embeddedci-com/benchpod-firmware/ice40/README.md

# bench-pod iCE40 gateware (v2)

See [`PROTOCOL.md`](PROTOCOL.md) for the SPI command set.

Lattice iCE40UltraPlus (**iCE40UP5K-SG48**) gateware for the EmbeddedCI BenchPod
"vbench-pod" board. It is an **SPI slave to the STM32H563** and owns the
timing-critical analog + digital datapath: the 16-bit serial DAC (DAC8551, or the quad DAC8554 on
analog v3r2), the
16-bit serial ADC (MCP33131D-10), the 14-channel logic-analyzer bank, and the
shared APS6404L **PSRAM** that captures stream into and deep DAC replay streams out of.

The STM32 sends high-level commands over SPI ("load this waveform", "capture N
samples at this rate", "arm the logic analyzer"); the gateware runs the
sample-rate clocks, buffers samples, and (for captures) streams them into
PSRAM so the STM32 can read the result back over its own memory-mapped XSPI.

> The legacy **v1** parallel-ADC gateware (for the retired RP2350 boards) was
> removed 2026-07-09. `top_v2.v` is the only top. Since v54 it is built as three images from
> the same source (`src/image_config.vh`). All three report the same gateware version;
> `FPGA_FEATURES` (0x18) says which one is running. The firmware keeps them in W25Q slots and
> swaps them by rewriting the iCE40 config flash (JSON `fpga_image`); SB_WARMBOOT cannot work on
> this board because the config flash shares the PSRAM bus.

## Images

| Image | File | Flag | FPGA_FEATURES | Carries |
|---|---|---|---|---|
| loop | `bench_pod_fpga_vbench_pod_loop.bin` | (none) | bit0 | the in-fabric DAC control loop (`dac_loop`) |
| deep | `..._deep.bin` | `-DUSE_DEEP_REPLAY` | bit1 | deep DAC replay from PSRAM (`dac_psram_reader`, `psram_bus_arbiter`) |
| emulation | `..._emu.bin` | `-DUSE_EMULATION` | bit2 | the emulated sensors: 4 I2C targets (`i2c_emu`), one SPI target (`spi_target`), the sensor FIFO (`emu_fifo`), UART2 TX and RX, the pin map |

Every image also has the ADC capture, the LA capture (change capture included) into PSRAM, the
UART proxy, SWD and its transfer queue, GPIO and the stepper, the SPI master and the shallow DAC
generate (`LOAD_WAVE`/`START_DAC`). Until v53 the I2C target and UART2 were in the loop and deep
images; v54 moved them out (about 650 LC each) and the firmware swaps to the emulation image when
a sensor starts. Image-specific commands are gated on FPGA_FEATURES, never on the version.

## Capture datapath

```
        ┌─ adc_mcp33131 ─┐
STM32 ─ SPI ─► cmd_dispatch ─ engine_block ─┤ ADC producer ───────────────────────┐ (straight to writer FIFO)
   ▲         (opcode FSM)     (shared cores) └ LA  producer ─► spram_ring16 (AW15) ─┤
   │                                                                                ▼
   └──────── XSPI read-back ◄── PSRAM ◄──────── psram_dual_writer (48 MHz DDR drain)
                                two regions (sys_config.vh: LA @ base, ADC @ 4 MB)
```

- **Two producers, one trigger.** `OP_CAPTURE` (0x31) pulses the ADC and LA arms
  on the *same* cycle (shared t0). A count of 0 leaves that producer off, so it also
  covers ADC-only and LA-only captures. Since v40 it is the only capture arm: the older
  `OP_START_CAPTURE` (0x20), `OP_START_MEASURE` (0x30) and `OP_LA_CAPTURE` (0x69) are
  ignored.
- **Sample alignment** (v52). Sample i of both streams is taken on the same clk edge,
  `t0 + (i+1) * divider - 3` (the LA through its 2-flop pad synchroniser). The ADC engine
  free-runs between captures (the loop image reads it), so a capture that includes the ADC
  restarts it at t0: the conversion in flight is dropped and the first one starts on the LA's
  sample-0 edge. Until v51 the ADC's sample 0 was whatever conversion was in flight at t0,
  up to a period early or up to the previous capture's period late (`tb_top_adc_t0`).
- **Capture trigger** (v35). `OP_SET_TRIGGER` (0x33) sets a persistent
  channel/mode (rising/falling/high/low) on the synchronised LA levels. An arm
  then *loads* the producers but holds them until the condition is seen; that
  cycle is t0, so the DAC co-trigger and `SET_DAC_STOP_AFTER` count from the
  trigger, not the arm. `OP_TRIGGER_STATUS` (0x34) reports waiting/fired. The
  captured window is entirely *post*-trigger (no pre-trigger buffer: see the v35
  note in `top_v2.v`). Mode 0 is the pre-v35 untriggered capture, cycle for cycle.
  `OP_GPIO_GET` (0x43) reads the same synchronized 14 levels without arming
  anything.
- **Asymmetric buffering.** The LA producer (12 MS/s burst) packs its samples into
  a deep 16-bit-packed SPRAM ring (`spram_ring16`, AW=15) so the writer can drain
  it independently. The ADC producer (at most 400 kS/s, ~0.8 MB/s) has **no** deep
  ring: it writes straight into `psram_dual_writer`'s 32-byte ADC staging FIFO, and
  the starvation-free bus arbiter keeps that FIFO from overflowing (this dropped a
  whole `spram_ring16`, about 120 LC + an SPRAM block, in the v19 LC-reduction pass).
- **One writer.** `psram_dual_writer` arbitrates the LA ring and the ADC staging
  FIFO and streams both into two contiguous PSRAM regions over a single 48 MHz
  DDR-clocked QPI link, raising `CAP_DONE` when both drain. The default regions
  are single-sourced in `sys_config.vh` (LA at 0, ADC at 4 MB); `OP_SET_CAPTURE_BASES`
  (0x32) moves the ADC base at run time so a capture fits below a resident replay
  waveform.
- **Shared bus.** In the deep image `dac_psram_reader` streams a replay waveform out
  of the top of PSRAM while a capture streams in at the bottom; `psram_bus_arbiter`
  hands the bus to one master per burst and `psram_pads` muxes the pads. The STM32
  takes the whole bus with `bus_own` (every iCE40 pad tristates) to read captures and
  stage waveforms over XSPI.
- **Depths.** Both capture counts are 24-bit: up to 2,097,152 ADC samples in the
  4 MB ADC region, and LA up to the full 8 MB PSRAM when the ADC is off. The firmware
  enforces the region caps; nothing in the gateware bounds a stream to its region.
- **Clocks.** An external 48 MHz `clk48` feeds the PSRAM serializers and the DAC
  engine; the control plane and capture datapath run on `clk` = clk48 / 2 (24 MHz).
  The clk to clk48 hop is a synchronous 1:2 gearbox (`cell_gearbox48`). Both clocks close
  with margin on the pinned seeds; `ice40/release/MANIFEST` records the figures of the
  promoted images. See "Clock-domain crossings" below for what nextpnr does not time.
- **Integrity.** Before every capture the STM32 stamps a no-write sentinel at the
  ADC region base; if it survives the read-back the iCE40 never wrote (a
  datapath/timing fault, not the analog ADC). `STATUS` carries CAP_DONE / CAP_BUSY
  / CAP_OVF (bit 5) and the control-loop trip (bit 6); bit 7 is hardwired 0 so firmware
  can tell an unconfigured FPGA (floated `0xFF`) from a real status byte.

[`../docs/tri-capture-unified-psram.md`](../docs/tri-capture-unified-psram.md) describes a
single-master alternative to the writer + reader + arbiter split; it was shelved in v40 because
it came out bigger.

## DAC

`dac8551_engine` shifts 24-bit frames to the DAC8551 on `clk48` (SCLK 24 MHz). One
sample takes max(divider, 3) + 51 clk48. The gateware floor of 3 meets the DAC8551's frame gap
(t9 >= 100 ns); the DAC8554 on analog v3r2 and later needs 130 ns, so the firmware sends a
divider of at least 4 (146 ns) and the fastest update is 48 MHz / 55, about 873 kS/s. It plays from one of three sources: the 4 KB `LOAD_WAVE` BRAM (up to 2048
samples, `START_DAC`), PSRAM through `dac_psram_reader` (deep image, up to 4,194,304
samples, `START_DAC_PSRAM`), or `dac_loop` (loop image, an in-fabric transfer function
that indexes a curve with the ADC or a fixed/sweep input, `START_DAC_LOOP`; see
[`../docs/dac-control-loop.md`](../docs/dac-control-loop.md)).

The analog v3r2 board has a quad DAC8554 instead (one channel per output) on the same pins and
frame format. `DAC_CTRL` (0x38, v49) sets the frame's top byte: the stream control byte, which
every later start takes (it picks the DAC8554 channel; 0, the power-up value, is the DAC8551's
frame), and one-off static frames to any channel, which take the next sample slot of a running
stream or go out at once when the DAC is idle. `tb_dac8554` and `tb_top_capture` cover both.

## Clock-domain crossings

`clocks.py` constrains `clk48` (48 MHz) and `clk` (24 MHz), but `clk` is clk48 divided by a
fabric flop and an SB_GB, and nextpnr-ice40 does not analyse paths between two clock nets. So
every clk <-> clk48 path is untimed. They fall in two groups:

- **Synchronised crossings**, correct for any delay: `cdc_pulse_payload` (DAC start/stop and
  their arguments, the static DAC frame, the loop parameters, the live ADC sample into the loop,
  the loop telemetry back), the 2-flop level synchronisers (`psram_run_s`, `loop_mode_s`,
  `dac_run_sync`, the reader's `roomok_s` and `run48_s`, the writer's `rst48`), and the async
  inputs (`bus_own`, SPI SCK/CSn/MOSI, the LA pads).
- **Phase-locked transfers**, which rely on clk being clk48 / 2 with a short skew: the PSRAM
  cell gearbox (`cell_gearbox48`, the writer's and the reader's clk-domain cells into clk48),
  the 48 MS/s LA pairs (`la48_sampler`, clk48 into clk) and the clk48 registers the cells and
  pairs feed. These are what the Makefile's `MAX_X48_NS` / `MAX_X24_NS` gates watch: nextpnr
  still reports their max delay, and a placement over 15 ns fails the build with `PNR_STRICT=1`
  (hardware-verified placements sit at 4 to 14 ns).

There is no cheap way to have them timed: an SB_PLL40 output is still a separate clock net to
nextpnr. The structural fix is one 48 MHz domain for everything. That was built and sim-proven
(2026-07, re-measured on v51): it fits (about 88% LC) but closes only 27 to 30 MHz on every
seed. Its long paths span the die at 5 to 9 LUT levels and are mostly routing, so pipelining
just moves the critical path. The gates stay the mitigation.

## STM32 SPI link

`spi_slave` oversamples SCK, CSn and MOSI on `clk`; SCK is not on a global-clock pin and all
eight global buffers are in use, so it cannot clock the slave. Since v52 MOSI passes the same
two flops as SCK, MISO moves right after each detected rise, and between bytes MISO is the reply
register's MSB directly. The link is clean down to a 95 ns SCK half period with no inter-byte
gap (`tb_top_spilink`, an STM32 model with pad delays): the firmware runs SPI1 at /64 (3.9 MHz)
on gateware 52 and later and at /128 (1.95 MHz) before. /32 (7.8 MHz) would need a one-flop SCK
synchroniser or an SCK-clocked slave, which needs a global buffer.

## Logic-analyzer bank, SWD and SPI

The 14 bidirectional LA channels (`LA1`..`LA14`) are a shared resource: the
SWD/SPI engine, the stepper pulse generator, the emulated sensors' pin map (emulation image),
the UART proxy and static GPIO all drive them through a priority mux
(`swd > stepper > emu > uart > static`). `swd_engine.v` takes SWCLK/SWDIO as LA
channel indices (nRESET is the pod's own pin since v37), decodes OpenOCD
`remote_bitbang` batches, and since v45 also runs whole SWD transfers from a queue
(`SWD_QFEED`). Since v44 the same engine is an SPI master on four LA channels.

## Sensor emulation (emulation image)

The gateware is sensor-agnostic: the firmware interprets the sensor definitions and fills
register images, FIFOs and timing tables over SPI ([`PROTOCOL.md`](PROTOCOL.md): `I2C_*`,
`EMU_*`, `SPIT_CONFIG`, `UART2_*`).

- **I2C targets** (`i2c_emu.v`). Four targets, each with its own address, SDA/SCL LA wires (a
  shared bus or separate ones), a 256-byte image and its configuration. One copy of the logic
  serves them in turn: a 5-clk round (4 targets + a slot for the SPI side), so each target samples
  its bus at 4.8 MHz (400 kHz I2C is safe; 1 MHz only with SCL high >= 0.42 us). Each target's
  112-bit context (configuration + bus state) is a word in seven block RAMs; the images are one
  1024x16 memory whose high byte holds per-register attributes: TRIG, CMD (a pointer write starts
  a conversion), BUSY (OR the target's mask while converting), FIFO, CLR (a read drops a data-ready
  level), RO, and a 2-bit index into the target's four conversion times. 8- or 16-bit register
  addressing (a 256-byte window at `page`), while_busy flag / nack / stretch (bounded by the
  conversion time, at most 65.5 ms), mute and bus_stuck faults, data ready (pulse or level, on
  conversion end or by command), and the SCL-silence watchdog (7..8 ms).
- **Write log.** Every DUT data byte stored by a target (I2C or SPI) is logged as {address,
  value} in a 32-entry ring per target, indexed by the target's write counter, so the firmware
  sees every write between two polls (`I2C_READ_LOG`).
- **SPI target** (`spi_target.v`). Modes 0..3, an address byte with configurable read and
  increment bits and address mask, 0..3 dummy bytes, its own image (target 4 of the `I2C_*`
  commands; FIFO and RO attributes), mute. SCK up to about 2 MHz.
- **FIFO** (`emu_fifo.v`). 2047 bytes in the one free SPRAM, pushed by the firmware, popped by
  FIFO registers of any target.
- **UART2**: TX (v48) and, since v54, RX with its own 256-byte FIFO.
- **Pin map** (`EMU_PINMAP`). One 3-bit driver code per LA wire: an I2C line (open drain: pulled
  low while any target wants it), a target's data ready, the SPI target's MISO or UART2 TX. It is
  one la_bank column, under SWD/SPI master and the stepper, over the UART proxy and GPIO.

The emulation image uses all 30 block RAMs and all 4 SPRAMs.

## Modules

| File | Purpose |
|---|---|
| `src/top_v2.v` | Top-level: clocks/reset/pads, the ADC/LA→PSRAM capture datapath, the DAC sources, the trigger |
| `src/spi_slave.v` | Bit-bang SPI slave with CDC for SCK/CSn |
| `src/cmd_dispatch.v` | FSM that decodes SPI opcodes and drives the engines |
| `src/engine_block.v` | Shared instrument cores wired to the version-specific top |
| `src/adc_mcp33131.v` | 16-bit serial SAR ADC (MCP33131D-10) sampler |
| `src/dac8551_engine.v` | 16-bit serial DAC (DAC8551 / DAC8554) waveform sequencer |
| `src/la_psram_capture.v` | Packs the 14-ch LA word (2 bytes per sample) into the LA ring |
| `src/spram_ring16.v` | 16-bit-packed single-port SPRAM burst ring (one per stream) |
| `src/psram_dual_writer.v` | 48 MHz DDR QPI writer → two PSRAM regions |
| `src/dac_psram_reader.v` | QPI streaming reader that feeds the DAC from PSRAM (deep image) |
| `src/psram_bus_arbiter.v` | Burst-granular arbiter between the writer and the reader |
| `src/psram_pads.v` | Shared PSRAM pad mux, `bus_own` tristate, one-clk48 output retime |
| `src/cell_gearbox48.v` | clk → clk48 cell gearbox (receive half) shared by the PSRAM writer and reader |
| `src/cdc_pulse_payload.v` | Pulse + value crossing from clk to clk48 (DAC start/stop and their arguments) |
| `src/dac_loop.v` | In-fabric DAC control loop: input source, affine map, curve lookup, damping, trip (loop image) |
| `src/sample_buf.v` | Dual-clock BRAM (inferred → `SB_RAM40_4K`) for DAC waveforms and the loop curve |
| `src/la_bank.v` | 14 bidirectional LA channels + driver priority mux |
| `src/stepper_engine.v` | Microsecond-precise step-pulse generator |
| `src/swd_engine.v` | OpenOCD `remote_bitbang` SWD decoder, SWD transfer queue, SPI master, reply buffer |
| `src/i2c_emu.v` | Emulation image: 4 I²C targets in one time-multiplexed engine (context and register images in block RAM), write log |
| `src/spi_target.v` | Emulation image: the emulated SPI sensor |
| `src/emu_fifo.v` | Emulation image: the shared 2 KB sensor FIFO in the free SPRAM |
| `src/uart_engine.v` | Soft UART proxy (and UART2 in the emulation image) |
| `src/image_config.vh` | Which of the three images a build is |
| `src/dsp_counter.v` / `src/dsp_counter2.v` | Counters packed into SB_MAC16 DSP blocks to save logic cells |
| `src/lc_counter.v` | Loadable counter in one logic cell per bit |
| `src/cmd_opcodes.vh` | SPI opcode table (generated by `tools/gen_protocol.py`) |
| `src/sys_config.vh` | Logic clock and default PSRAM regions (generated by `tools/gen_protocol.py`) |

## Build

Open-source IceStorm toolchain (`brew install icestorm yosys nextpnr-ice40`):

```
make images          # build the three runtime images: ..._loop.bin, ..._deep.bin, ..._emu.bin (pinned seeds)
make                 # build bench_pod_fpga_vbench_pod.bin (one image, for flash/flash-ram)
make flash           # build + program the config flash via an FTDI programmer (iceprog)
make flash-ram       # build + load straight into FPGA SRAM (volatile)
make sim             # iverilog syntax check
make test            # all self-checking sims + the protocol and release-tool checks
make test PNR_STRICT=1   # what CI runs (also fails on a thin clk48 margin)
```

Pin constraints live in `vbench_pod.pcf`. Use yosys 0.65 (0.66 places worse with
`-abc9`); the toolchain is recorded in `release/MANIFEST`.

### Releases embed promoted images

The images are not embedded in the firmware binary. A firmware build packs
`ice40/bench_pod_fpga_vbench_pod_{loop,deep,emu}.bin` into the blobs that go with it
(`build/blobs/blob-gw0.bin` = loop, `blob-gw1.bin` = deep, `blob-gw2.bin` = emulation, kept in
the pod's W25Q) and
records their gateware version. A release build uses `ice40/release/` instead: images that passed a hardware test, promoted
with `make promote HW_VERIFIED="<which test>"` (which records the source hash, seeds,
toolchain and clk48 margins in `release/MANIFEST`) and installed with
`make release-images`. `make check-release` fails once any file in `src/`,
`vbench_pod.pcf` or `clocks.py` changes, comments included, so every gateware change
needs a hardware test and a new promote before the next firmware release. On a PR or
main the CI only warns; the release workflow fails.

At boot (and after a gateware blob install) the firmware compares the running gateware
version with the one it was built for and, when they differ, rewrites the iCE40 config
flash from the matching W25Q slot, keeping the image kind that was running. A blank or
broken iCE40 gets image 0 (loop). The USB console command `flash-ice40` does the same by
hand.

At the same version it also checks which image is in the config flash: each time the
firmware writes it from a slot, it records that slot's sha256 and length (from the slot
header) in the W25Q sector at `0x0FF000`, and erases that record before any write. When the
running kind's slot holds the blob the firmware expects but the record names another image
(a dev rebuild, or a later build of the emulation image at the same gateware version), the
image is rewritten from the slot. A pod with no record yet (the first boot of a firmware with
this check, or a write that was cut) does one read-compare of the config flash with the slot:
equal, it only records it; different, it rewrites it and records it. So a blank record costs
at most one rewrite, never one per boot.

## Simulation

`sim/` holds self-checking iverilog testbenches for the individual cores
(`make dactest adctest psramwrtest dualwrtest lapsramtest measuretest argtest
steppertest …`) and whole-top benches that drive real SPI transactions through
the SB_IO pads (`make topsmoketest topcapturetest spitest swdqtest` on the loop
image, `make topdeeptest` on the deep image: replay across bus_own, a capture
read back mid-replay, overflow cleared by the next arm; `make i2cemutest topemutest uart2test`
on the emulation image's sensors).
`make check-protocol` verifies the generated files (opcode table, `sys_config.vh`,
the firmware headers and [`PROTOCOL.md`](PROTOCOL.md)) are in sync with
`tools/gen_protocol.py`.
