embeddedci-com/benchpod-firmware/docs/API.md

# bench-pod-firmware TCP/JSON API

The firmware exposes a plain-text JSON API over a TCP socket. Commands are sent as single-line JSON objects and responses are returned as one or more single-line JSON objects. The same commands run over the embeddedci.com cloud link (the command channel and the byte tunnels, see [While a cloud job holds the pod](#while-a-cloud-job-holds-the-pod)), and the same socket also speaks [SCPI](#scpi-reference). The USB console has its own text commands: see [usb-serial-interface.md](usb-serial-interface.md).

---

## Transport

| Property | Value |
|---|---|
| Protocol | TCP |
| Default port | `8080` (plaintext) |
| TLS port | `8443` (TLS 1.2, firmware 3.9.3+), same protocol; see [LAN TLS](#lan_tls--the-lan-api-over-tls) |
| Framing | Newline-delimited (`\n`) — one JSON object per line |
| Encoding | UTF-8 |
| Concurrency | Up to 5 LAN connections at once; the commands that use the capture hardware take turns (a second one gets `"busy"`) |

Connect with any TCP client:

```bash
nc <device-ip> 8080
```

**Over USB.** From firmware 3.9.0 the pod's USB port is also a network adapter (CDC-NCM): a computer on the cable reaches port `8080` at the pod's fixed `10.237.x.y` address with no Ethernet or Wi-Fi, and everything below works the same way. See [USB network adapter](usb-serial-interface.md#usb-network-adapter). The `status` field `usb` gives both ends of that link.

The IP address is printed on the USB console (and the USART2 debug pins) at boot, and is also returned by the `status` command and the console `status` command. The pod also advertises itself over mDNS (on Ethernet and Wi-Fi unless the [LAN policy](#lan_policy--what-the-external-lan-may-do) is `off`; on the USB link always).

**Over TLS.** From firmware 3.9.3 the same API also listens on port `8443` with TLS 1.2. Everything below works the same way on it (JSON, SCPI, the raw modes). The pod's certificate is its own (generated on first boot, or one you install), so clients pin its SHA-256 on first use; `benchpod`, the `embeddedci` SDK and the MCP server do this for you and use `8443` by default when the pod has it. With [HTTPS-only](#lan_tls--the-lan-api-over-tls) on, `8080` answers only on the USB network adapter. Test it by hand with:

```bash
openssl s_client -connect <device-ip>:8443 -quiet
```

**Latency.** Small replies (a JSON ack) go out as soon as they are ready. While a connection is a CMSIS-DAP probe (`dap_start`) the pod turns Nagle's algorithm off (`TCP_NODELAY`) on it, because flashing is a stream of small request and response packets. No client action is required.

**Line length.** A JSON command line is at most 1279 bytes; a longer one gets `"command too long"` and is dropped. (A SCPI line is at most 255 bytes.) Bulk data goes through the commands that switch a connection to raw bytes (`load_bin`, `dap_start`, `uart_proxy_start`) or through base64url chunks (`load`, `ota_data`).

---

## Security model

**Read this before putting a pod on a network you do not control.**

The pod has two command channels, and they have deliberately different trust models.

### The LAN API is unauthenticated

The JSON-over-TCP and SCPI interfaces on port `8080` have **no authentication, no
authorization, and no transport encryption**. Port `8443` (firmware 3.9.3+) is the same API over
TLS: it adds **encryption and integrity** against the network path (a Wi-Fi bridge, a shared
switch), not authentication. Any client that can open a TCP connection to either port has the
full command set, which includes:

- driving the DAC and the analog outputs,
- switching target power on and off (`target_power`),
- driving the SWD probe — i.e. halting, reading, and reflashing an attached target,
- uploading firmware to the pod itself over OTA.

There is no login, no API key, and no allow-list. The USB network adapter (firmware 3.9.0+)
is the same tier as the LAN: port `8080` on it is this API. The LAN policy, though, is for the
external LAN only: the USB adapter stays on and open under every policy (physical presence). The
USB-CDC console is a separate, higher channel and assumes physical access.

**The LAN policy limits this on the external LAN** (Ethernet and Wi-Fi). `lan_policy` (below) is
`open` by default, which is everything above. `locked` keeps the external LAN to reads and
instrument control (tiers T0 and T1 of `src/cmd_tier.c`): persisted settings (Wi-Fi, cloud, DAC
limits, calibration, the policies) and firmware updates then need the cloud or USB. `off` refuses
TCP connections over Ethernet and Wi-Fi and stops the mDNS advertisement there. Only the cloud and the USB console can change it, from the web app's device
settings or `benchpod lan-policy set`.

**HTTPS-only** (`lan_tls` with `https_only`, default off) turns plaintext `8080` off on the
external LAN, so only TLS crosses Ethernet and Wi-Fi; the USB network adapter keeps `8080`. A
plaintext LAN connection may turn it on but never off, and may not replace or regenerate the TLS
certificate: an active man-in-the-middle on `8080` could otherwise swap the certificate before a
client pins it. See [`lan_tls`](#lan_tls--the-lan-api-over-tls).

**Treat the LAN interface as a trusted-network-only interface.** Put the pod on a lab
VLAN or behind a firewall rule that admits only the hosts that need it. This is the
same posture as most bench instruments (a SCPI-over-LAN scope or DMM is also
unauthenticated), but it is a conscious choice, not an oversight — say so in your own
threat model rather than assuming the pod defends itself.

### The cloud channel *is* authenticated and encrypted

Nothing above applies to the EmbeddedCI cloud path. That channel is protected in both
directions:

| Property | How |
|---|---|
| Confidentiality + integrity | TLS (WSS). The pod dials **out**; it never accepts an inbound cloud connection, so it needs no port forwarded. |
| Server authentication | The server certificate chain is verified against **two Let's Encrypt roots embedded in the firmware** (ISRG Root X1 and X2), plus an SNI/CN-SAN hostname check. Verification is enforced, not advisory — a failed verify drops the link. The old unauthenticated bring-up mode was removed, and any stored `verify=0` from older firmware is upgraded on load so it cannot downgrade a link. |
| Device authentication | Ed25519 challenge–response. The pod fetches a server nonce, signs it with its device private key, and presents `device_id` + nonce + signature on the WebSocket upgrade; the server verifies against the public key registered for that device. |
| Key custody | The private key is generated on-device from the hardware TRNG at first boot, stored in its own flash sector, and **never leaves the unit** — the pod only ever signs. |

One caveat worth knowing: the pod has no RTC, so certificate **validity dates are not
checked** (`MBEDTLS_HAVE_TIME_DATE` is off). An otherwise-valid certificate from a
trusted root is accepted after expiry.

### Domain separation between the two channels

`identity_pop` (below) is reachable over the *unauthenticated* LAN API, so anyone on
the LAN can obtain a signature over a nonce of their choosing. That deliberately
cannot be replayed as a cloud login: LAN proofs are signed under the context
`benchpod-pop:v1`, cloud WebSocket authentication under `benchpod-ws-auth:v1`, and the
signed message is `context || 0x00 || nonce`. A signature collected from the LAN is
therefore not a valid cloud-auth signature, and vice versa.

---

## Request Format

Every request is a flat JSON object on a single line, terminated with `\n`.

```
{"cmd":"<command>", ...parameters...}\n
```

The `cmd` field is required. All other fields are command-specific and documented below. Unknown fields are silently ignored.

---

## Response Format

### Success

```json
{"status":"ok","data":<value>}\n
```

`data` is command-specific. It may be `null`, a JSON object, or a JSON array.

### Error

```json
{"status":"error","message":"<description>"}\n
```

### Chunked data (multi-packet responses)

Commands that return sample arrays (`capture`, `stream`, `measure`, `test`, `capture_dual`, `capture_read`, `la_capture`, `sensor_la`) send the data in several packets. The first packet uses `"status":"ok"` and the ones after it `"status":"chunk"`. Every packet has a `"more"` boolean that says whether more packets follow. The packet size follows the connection's send buffer (at most 256 samples), so do not count on a fixed size.

```json
{"status":"ok",    "bits":16, "data":[32768,33012,33270,...], "more":true}\n
{"status":"chunk", "data":[33501,33790,34012,...], "more":true}\n
{"status":"chunk", "data":[34190,34322,34410,...], "more":false}\n
```

ADC samples are 16-bit counts (`"bits":16`); see [ADC sample values](#adc-sample-values). A client must read until it receives a packet with `"more":false` to know the transfer is complete. If the client stops reading for a few seconds the pod ends the transfer and closes the connection.

#### Base64 samples (`"enc":"b64"`)

Add `"enc":"b64"` to `capture`, `stream`, `measure`, `test`, `capture_dual` or `capture_read` and the 16-bit samples come as `"b64"` instead of `"data"`: unpadded base64url (RFC 4648 §5) of the little-endian `uint16` values. That is 8/3 bytes per sample instead of up to 6, and it reads back about 6.7x faster (2M ADC samples: 4.2 s instead of 28 s over the LAN). Everything else in the packet stays the same, and `capture_dual`'s LA region still comes as `la_edges`. `status.caps` contains `"capture_b64"` when the firmware supports it. Without the key the reply is the decimal `"data"` array, so older clients keep working.

```json
{"status":"ok",    "bits":16, "adc_rate_hz":400000, "b64":"AAABAP__...", "more":true}\n
{"status":"chunk", "b64":"NBL_f...", "more":false}\n
```

---

## Commands

Every command the firmware accepts is in this table. **Tier** decides who may run it (see
`src/cmd_tier.c` and `docs/design/policy-commands.md`): T0 reads, T1 instrument control, T2
persisted settings, T3 firmware. A locked LAN keeps T2 and T3 for the cloud and the USB console,
and a cloud tunnel never goes above the tier the server allowed its user (T2 and T3 need an
organization owner or admin). "T0/T2" commands read at T0 and change a setting at T2.
Commands that send several packets or switch the connection to raw bytes need a stream connection
(a LAN socket or a cloud byte tunnel). The single-reply cloud command channel refuses `capture`,
`stream`, `capture_dual`, `capture_read`, `measure`, `test`, `load`, `load_bin`, `replay`,
`sensor_la`, `la_capture`, `dap_start`, `uart_proxy_start` and `speedtest` with
`command not supported over cloud channel`. The USB console does not run JSON commands at all.

| `cmd` | Tier | Purpose | `data` returned | Multi-packet |
|---|---|---|---|---|
| `ping` | T0 | Connectivity check | `"pong"` (string) | no |
| `status` | T0 | Firmware, network, board and capability info | object | no |
| `generate` | T1 | Start a DAC waveform | `null` or object | no |
| `capture` | T0 | ADC snapshot, up to 32768 samples | array of uint16 | yes |
| `stream` | T0 | Same as `capture`, without a trigger | array of uint16 | yes |
| `measure` | T1 | DAC waveform + ADC capture in one command | array of uint16 | yes |
| `capture_dual` | T0 | Deep ADC + LA capture off one trigger | array of uint16, LA as edges | yes |
| `capture_read` | T0 | Resume the read-back of the last `capture_dual` | array of uint16 | yes |
| `la_capture` | T0 | Deep raw capture of all 14 LA channels | LA words as edges | yes |
| `test` | T0 | Synthetic sample pattern (no FPGA) | array of uint16 | yes |
| `load` | T1 | Upload a waveform for replay (base64url chunks) | object | no |
| `load_bin` | T1 | Upload a waveform as raw bytes (RAM or PSRAM) | object | no |
| `replay` | T1 | Play the recorded or uploaded trace out the DAC | object | no |
| `dac_stop` | T1 | Stop any running DAC output (parks it when DAC limits are set) | `null` or object | no |
| `dac_set` | T1 | Hold the DAC at a raw 8-bit level | `null` | no |
| `dac_limits` | T0/T2 | Read, set or clear the DAC output limits for an external output stage | object | no |
| `analog_path` | T1 | Apply a named analog path (flips mux + relays) | object | no |
| `dac_out` | T1 | Route a DAC output path + set a calibrated voltage | object | no |
| `current_out` | T1 | Hold a current on the 4-20 mA output (J9), in µA | object | no |
| `adc_read` | T1 | Route an ADC source + return a calibrated reading (mV) | object | no |
| `adc_range` | T1 | Read or switch the ADC input range (normal ±32.8 V / low ±5.46 V, analog module v3r4+), or run its self-test | object | no |
| `calibrate` | T0/T2 | Run, read or clear this pod's own calibration: the ADC offset (measured on the `current_in` input, J8; applies to every ADC source from 3.9.3) and, from 3.9.3, the DMM-guided DAC lines and ADC gains | object | no |
| `dac_mux` | T1 | Low-level DAC output mux (U55); prefer `dac_out` | object | no |
| `cal_switch` | T1 | Low-level calibration relays (U58); prefer `analog_path` | object | no |
| `dac_control_loop` | T1 | Arm (or disarm) the in-fabric closed-loop DAC | object | no |
| `dac_loop_input` | T1 | Retarget a running control loop's input | object | no |
| `dac_loop_probe` | T0 | One live operating point of the control loop | object | no |
| `fpga_image` | T1 | Switch the running iCE40 image (0 = loop, 1 = deep replay, 2 = sensor emulation) | object | no |
| `psram_ping` | T0 | iCE40 to PSRAM write-path check | object | no |
| `psram_recover` | T1 | Reboot the pod to recover an inoperable PSRAM datapath | object | no |
| `la` | T1 | LA pin control: step pulse trains + pull-ups (LA1-8) | object | no |
| `la_pins` | T0 | Report all 14 LA pins: function, gpio mode/level, pull, live levels | object | no |
| `gpio` | T1 | Configure / release / drive / read LA pins as GPIO | object | no |
| `la_dir` | T1 | Tell the pod which LA pins are DUT outputs, inputs or bidirectional | object | no |
| `la_voltage` | T1 | Select the LA I/O-bank voltage (1.8/3.3 V); required before any LA op | object | no |
| `nrst` | T1 | Drive the dedicated target-reset line (v3 pods) | object | no |
| `usb_cc` | T0 | Read the USB-C CC lines: orientation + source current advertisement (v3 pods) | object | no |
| `target_power` | T1 | Enable/disable a target-power eFuse | object | no |
| `target_status` | T0 | Read target-power eFuse state (enabled/fault/valid) | object | no |
| `power_status` | T0 | One-shot INA238 reading of both supply rails | object | no |
| `power_profile` | T1 | Record a current/voltage profile of one eFuse rail | object | on `stop` |
| `module` | T0/T2 | Digital v3r3: the analog module's state, and its ID and calibration EEPROM | object | no |
| `module_power` | T1 | Digital v3r3: switch the analog module's 5 V and the USB-A bridge port | object | no |
| `dap_start` | T1 | Turn the connection into a CMSIS-DAP probe | `"dap ready"` (string) | no |
| `uart_proxy_start` | T1 | Enter transparent UART bridge mode | `"uart ready"` (string) | no |
| `spi_start` | T1 | Claim four LA pins as an SPI master | object | no |
| `spi_stop` | T1 | End the SPI session | `"spi stopped"` | no |
| `spi_status` | T0 | The SPI session's pins, rate and mode | object | no |
| `spi_xfer` | T1 | Raw full-duplex SPI transfer | object | no |
| `spi_stream` | T1 | Send a staged PSRAM upload in one CS frame | object | no |
| `i2c_start` | T1 | Claim two LA pins as an I2C master | object | no |
| `i2c_stop` | T1 | End the I2C session | `"i2c stopped"` | no |
| `i2c_status` | T0 | The I2C session's pins, rate and pull-ups | object | no |
| `i2c_xfer` | T1 | Write, read, or write then read an I2C device | object | no |
| `i2c_scan` | T1 | List the addresses that answer on the bus | object | no |
| `spi_flash` | T1 | SPI NOR flash operations (id, read, erase, program) | object | no |
| `sensor_define` | T1 | Upload and compile a sensor definition (chunked) | object | no |
| `sensor_start` | T1 | Start an emulated sensor instance (I2C, SPI, UART or analog) | object | no |
| `sensor_set` | T1 | Set an instance's readings | object | no |
| `sensor_stimulus` | T1 | Upload a stimulus (chunked) | object | no |
| `sensor_stimulus_start` | T1 | Play the stimulus | object | no |
| `sensor_stimulus_stop` | T1 | Stop the stimulus | object | no |
| `sensor_fault` | T1 | Inject a fault into an instance | object | no |
| `sensor_fault_clear` | T1 | Clear an instance's faults | object | no |
| `sensor_stop` | T1 | Stop an instance (or all) and forget its definition | object | no |
| `sensor_status` | T0 | Instances, their values, faults and bus counters (paged) | object | no |
| `sensor_regs` | T0 | Read an I2C/SPI instance's register image (base64) | object | no |
| `sensor_la` | T0 | Raw I2C-bus logic capture of an I2C instance | array of uint8 | yes |
| `can_config` | T1 | Bring up classic CAN or CAN FD (FDCAN1 / TCAN1044) | object | no |
| `can_write` | T1 | Send one CAN frame | object | no |
| `can_read` | T0 | Drain up to 8 received CAN frames | object | no |
| `can_status` | T0 | CAN state and error counters | object | no |
| `can_term` | T1 | Switch the 120 Ω CAN termination | object | no |
| `can_respond` | T1 | Add or clear an automatic CAN reply rule | object | no |
| `can_disable` | T1 | Turn CAN off | object | no |
| `identity_public` | T0 | Get the device Ed25519 public key | object | no |
| `identity_pop` | T0 | Sign a nonce (proof of possession) | object | no |
| `identity_wipe` | T0 | Always refused here: only on the USB console | error | no |
| `cloud_status` | T0 | The cloud link's state and stored settings | object | no |
| `cloud_set` | T2 | Store the cloud server and device id, then connect | object | no |
| `cloud_clear` | T2 | Forget the cloud settings and disconnect | `"cleared"` | no |
| `cloud_ca` | T0/T2 | Read or clear the company CA for the cloud link | object | no |
| `cloud_proxy` | T0/T2 | Read, set or clear the HTTP proxy for the cloud link | object | no |
| `wifi_status` | T0 | Wi-Fi state and transport counters | object | no |
| `wifi_scan` | T0 | Start a Wi-Fi scan, or read its networks | object | no |
| `wifi_set` | T2 | Store Wi-Fi credentials and connect | object | no |
| `wifi_clear` | T2 | Forget the Wi-Fi credentials (pod and ESP32-C3) | `"cleared"` | no |
| `eth` | T0/T2 | Wired link control and diagnostics | string or object | no |
| `speedtest` | T1 | Cloud throughput probe over a tunnel | none (raw bytes) | no |
| `sig_policy` | T0/T2 | Read or set which signed updates the pod accepts | object | no |
| `lan_policy` | T0/T2 | Read or set what the LAN API may do | object | no |
| `usb_network` | T0/T2 | Read, or over the USB link set, the USB network adapter setting | object | no |
| `lan_tls` | T0/T2 | The LAN API's TLS certificate (port 8443) and the HTTPS-only setting | object | no |
| `ota_begin` | T3 | Start a firmware or blob update | object | no |
| `ota_data` | T3 | Send one base64url chunk of the image | object | no |
| `ota_end` | T3 | Verify the staged image's SHA-256 (and signature) | object | no |
| `ota_status` | T0 | The update session's state | object | no |
| `ota_abort` | T3 | Drop the staged image | object | no |
| `ota_selftest` | T3 | Test the flash writer on a scratch sector | object | no |
| `ota_commit` | T3 | Write the verified image and reset (or write a blob) | object | no |
| `blob_status` | T0 | What each W25Q blob slot holds | object | no |
| `emi_log` | T0 | EMI test build only: read the run log out of the W25Q | object | no |

Commands not in this table answer `"unknown cmd"`.

### Gates that apply to every command

Before a command runs, the firmware checks these, in this order (`src/cmd_gate.c`). The first one
that applies answers with its message and the command does not run.

| Gate | Applies to | Message |
|---|---|---|
| LAN policy `locked` | a T2 or T3 command on a LAN connection | `locked: <cmd> needs the cloud or USB` (firmware before 3.9.0: `... or the USB console`) |
| A cloud job holds the pod (lease) | anything but a light read on a LAN connection | `busy: a cloud job holds this pod (<holder>, <N> s left)` |
| Cloud tunnel tier | a command above the tier the server allowed the tunnel's user | `forbidden: <cmd> needs an organization owner or admin` |
| Safe mode | everything except network, status, identity, target power, `dac_limits` and CAN, while the iCE40/PSRAM are off | `safe mode: iCE40/PSRAM are off. Unplug and replug the pod` |
| Digital-only board | the analog commands (`generate`, `capture`, `stream`, `measure`, `load`, `load_bin`, `replay`, `dac_limits`, `dac_set`, `dac_mux`, `cal_switch`, `analog_path`, `dac_out`, `current_out`, `adc_read`, `calibrate`, `dac_control_loop`, `dac_loop_probe`, `dac_loop_input`) and a `capture_dual` with ADC samples | `this BenchPod has no analog front end (digital board): no DAC, ADC or analog outputs. Restart the pod after fitting an analog add-on` |
| DAC output limits | commands that would move the DAC outside the limits | see [`dac_limits`](#dac_limits--dac-output-limits-for-an-external-output-stage) |

Light reads are the T0 commands that do not use the capture hardware: everything at T0 except
`capture`, `capture_dual`, `capture_read`, `stream`, `la_capture`, `sensor_regs`, `sensor_la`,
`can_read`, `psram_ping` and `test`. Commands that use the capture hardware (PSRAM, ADC, LA) also
take turns with each other: a second one gets `"busy"` until the first is done.

---

### `ping` — connectivity check

Verify the TCP connection and command path are working. No parameters. No side effects.

#### Request

```json
{"cmd":"ping"}
```

#### Response

```json
{"status":"ok","data":"pong"}
```

Use this as a lightweight keepalive or to confirm the firmware is reachable before issuing signal commands.

---

### `generate` — DAC waveform output

Start continuous waveform generation on the DAC (16-bit DAC8551, clocked by the iCE40). There are two forms:

- **Calibrated, 16-bit** (firmware 3.9.1+, caps `generate16`, `generate_bits` 16): give the waveform in volts on a DAC output (`path`, `amplitude_v`, `offset_v`), or in microamps on the 4-20 mA output (`amplitude_ua`, `offset_ua`). The pod routes the output, turns the values into DAC codes with the same per-path calibration as [`dac_out`](#dac_out--route-an-output-path-and-set-a-calibrated-voltage) and [`current_out`](#current_out--hold-a-current-on-the-4-20-ma-output-j9), and builds the waveform at the DAC's full 16 bits.
- **Levels, 8-bit** (every firmware): `amplitude` and `offset` are 8-bit levels, the waveform is built from them and played in the DAC's high byte: 256 steps over the output's range, and no calibration.

#### Calibrated request (16-bit)

```json
{"cmd":"generate","waveform":"sine","freq":1000,"path":"3v3","amplitude_v":1.48,"offset_v":1.65}
{"cmd":"generate","waveform":"square","freq":10,"amplitude_ua":4000,"offset_ua":12000}
```

| Field | Type | Required | Description |
|---|---|---|---|
| `path` | string | with `amplitude_v` | The DAC output: `"3v3"`, `"5v"` or `"12v"`. The pod switches to it before the waveform starts. |
| `amplitude_v`, `offset_v` | number (V) | together | Peak and centre in volts. A peak up to 5% of the output's range past what it can reach is clamped to that end (so 0 to 3.3 V works on 3v3, whose calibrated range starts a few mV above 0); further out is refused. |
| `amplitude_ua`, `offset_ua` | number (µA) | together | Peak and centre on the 4-20 mA output (J9), which is routed instead. The trough may go down to 4000 µA (played as the live zero, like `current_out`); the top is the output's maximum. |

| `route` | boolean | no | `false` keeps the current analog switching (for example `cal1`, a DAC to ADC loopback, which routing the output would undo); the volts still use `path`'s calibration. Default: route the output. |

`waveform`, `freq`, `duration_ms`, `sample_rate_mhz` and `on_capture` work as in the 8-bit form below. The reply is `{"bits":16}`, with `"cotrig"` added for `on_capture`. One step is about 50 µV on the 3v3 output (the 8-bit form: about 13 mV).

| Condition | Message |
|---|---|
| A peak more than 5% of the range past the output's range | `the peaks <lo> to <hi> mV are outside the 3v3 output's <min> to <max> mV` (µA on the 4-20 mA output) |
| `amplitude_v` without a 3v3/5v/12v `path` | `path must be 3v3\|5v\|12v with amplitude_v` |
| `amplitude_v` without `offset_v` (or `_ua`) | `offset_v is required with amplitude_v` |
| `amplitude` not above 0 | `amplitude_v must be above 0 V` |

#### Level request (8-bit)

```json
{"cmd":"generate","waveform":"<type>","freq":<Hz>,"amplitude":<0-127>,"offset":<0-255>,"duration_ms":<ms>}
```

| Field | Type | Required | Default | Description |
|---|---|---|---|---|
| `waveform` | string | yes | — | Waveform shape: `"sine"`, `"square"`, or `"sawtooth"` |
| `freq` | number (Hz) | no | `1000` | Output frequency in Hz |
| `amplitude` | integer 0–127 | no | `127` | Half-scale amplitude. Peak-to-peak swing = `2 × amplitude` counts out of 255 |
| `offset` | integer 0–255 | no | `128` | DC offset (vertical centre). `128` = mid-scale |
| `duration_ms` | integer (ms) | no | `0` | How long to generate. `0` = run indefinitely until the next command |
| `sample_rate_mhz` | number (MHz) | no | auto | FPGA DAC sample-clock rate. Omit to auto-pick the highest rate that fits one period in the waveform buffer. A **lower** rate reduces high-frequency clock feedthrough on the analog output (cleaner scope trace) at the cost of fewer samples per period. One DAC sample takes divider + 51 cycles of the 48 MHz engine clock (divider ≥ 4), so the maximum is 48 MHz ÷ 55 ≈ 873 kS/s; the firmware snaps to the nearest achievable rate, clamps faster requests to the maximum and logs the actual rate. |
| `on_capture` | boolean | no | `false` | Gateware v27+: wait and start the waveform at the next capture's t0 (the DAC co-trigger). The reply is then `{"cotrig":true}`, or `{"cotrig":false}` when the gateware cannot co-trigger and the waveform started right away. |

**Amplitude and offset arithmetic**

The 8-bit level at each sample point is clamped to `[0, 255]` and then scaled to the 16-bit DAC:

```
sine:     value = offset + amplitude × sin(2π × t/T)
square:   value = offset ± amplitude  (high for first half-period, low for second)
sawtooth: value = offset - amplitude … offset + amplitude  (linear ramp per period)
```

With `amplitude=100, offset=128` the output swings between 28 and 228 (out of 255), centred at mid-scale.

**Frequency resolution**

The firmware precomputes one full period in a sample buffer and the iCE40 loops it. Period length in samples is:

```
period_samples = floor(sample_rate / freq)
```

where `sample_rate = 48 MHz / (divider + 51)`: the DAC8551 engine runs on the 48 MHz `clk48` domain and spends 51 clocks per sample on top of the divider (3 to fetch the sample, 48 to shift the 24-bit SPI frame). The divider is at least 4 (the DAC's minimum gap between frames), so the maximum is about 873 kS/s. Earlier firmware used a divider of 3 (about 889 kS/s), which left the gap 5 ns short of what the quad DAC on analog v3r2 and later boards needs.

The waveform buffer holds 2048 16-bit samples. Lower frequencies need a lower sample rate: leave `sample_rate_mhz` out and the firmware picks one that fits the period.

#### Response

```json
{"status":"ok","data":null}
```

With `on_capture` the reply is `{"status":"ok","data":{"cotrig":true}}`.

#### Examples

```json
{"cmd":"generate","waveform":"sine","freq":100000,"amplitude":100,"offset":128}
```
→ 100 kHz sine, ±100 counts around mid-scale, runs until next command.

```json
{"cmd":"generate","waveform":"square","freq":50000,"amplitude":64,"offset":128,"duration_ms":2000}
```
→ 50 kHz square wave for 2 seconds, then DAC stops.

```json
{"cmd":"generate","waveform":"sawtooth","freq":500000,"amplitude":127,"offset":127}
```
→ 500 kHz sawtooth, full-scale ramp 0 → 254.

```json
{"cmd":"generate","waveform":"sine","freq":100000,"sample_rate_mhz":1}
```
→ 100 kHz sine clocked at 1 MHz (10 samples/period). Coarser waveform but much lower clock feedthrough, useful for a cleaner scope trace on breadboard wiring.

#### Error cases

| Condition | Message |
|---|---|
| Unknown or missing `waveform` | `"unknown waveform"` |
| `freq` ≤ 0 or `amplitude` = 0 | `"generate failed"` |
| DAC limits are set | the [`dac_limits`](#dac_limits--dac-output-limits-for-an-external-output-stage) refusal |

---

### `capture` — ADC snapshot

Capture a fixed number of ADC samples (16-bit MCP33131, through the iCE40 into PSRAM) and return them. The reply arrives once the capture is done; meanwhile other connections keep working, but a second capture waits its turn (`"busy"`). A capture also fills the RAM replay buffer, so `replay` can play it straight back.

#### Request

```json
{"cmd":"capture","samples":<count>,"sample_rate_mhz":<MHz>}
```

| Field | Type | Required | Default | Max |
|---|---|---|---|---|
| `samples` | integer | no | `256` | `32768` |
| `sample_rate_mhz` | number (MHz) | no | max (~0.4) | — |
| `trigger`, `trigger_timeout_ms` | object, integer | no | none | see [Capture triggers](#capture-triggers) |
| `enc` | string | no | decimal | `"b64"`, see [Base64 samples](#base64-samples-encb64) |

For more than 32768 samples use `capture_dual` with `la_samples` 0 (millions of samples, read back from PSRAM).

`sample_rate_mhz` sets the ADC sample clock. Omit it for the maximum ~400 kSPS rate; a **lower** rate stretches the capture window so a slow waveform fits in the 32768-sample buffer. For example, 32768 samples at ~400 kSPS spans ~82 ms, and `0.08` (80 kS/s) spans ~410 ms — enough to see a motor current waveform or other low-frequency signal. The v2 MCP33131 ADC runs in the 24 MHz domain and its divider is floored at 60, so the maximum rate is 24 MHz ÷ 60 ≈ 400 kSPS; the firmware snaps to the nearest achievable divider and logs the actual rate.

#### Response

Chunked JSON array (see [Chunked data](#chunked-data-multi-packet-responses)):

```json
{"status":"ok",    "bits":16, "data":[32768,33012,...], "more":true}\n
{"status":"chunk", "data":[33270,33501,...], "more":false}\n
```

Each sample is an unsigned 16-bit ADC count (see [ADC sample values](#adc-sample-values)).

#### Examples

```json
{"cmd":"capture","samples":1024}
```

```json
{"cmd":"capture"}
```
→ 256 samples (default).

#### Error cases

| Condition | Message |
|---|---|
| `samples` = 0 or > 32768 | `"samples out of range (use capture_dual for deep captures)"` |
| Another capture or upload is running | `"busy"` |
| The capture did not arm | `"capture failed"` |
| The PSRAM read-back failed | `"capture read-back failed"` |

#### Loopback test

To verify the signal path, start a waveform then capture:

```json
{"cmd":"generate","waveform":"sine","freq":1000,"amplitude":100,"offset":128}
{"cmd":"capture","samples":4096}
```

The captured array should show a sinusoidal pattern at the expected period.

---

### `stream` — ADC capture (alias of `capture`)

On this firmware `stream` is the same one-shot PSRAM capture as `capture`, without the trigger option: the capture runs in the gateware and the samples are read back once it is done. It is kept for older clients.

#### Request

```json
{"cmd":"stream","samples":<count>,"sample_rate_mhz":<MHz>}
```

| Field | Type | Required | Default | Max |
|---|---|---|---|---|
| `samples` | integer | no | `256` | `32768` |
| `sample_rate_mhz` | number (MHz) | no | max (~0.4) | — |
| `enc` | string | no | decimal | `"b64"` |

`sample_rate_mhz` has the same meaning as in `capture`.

#### Response

Same chunked format as `capture`:

```json
{"status":"ok",    "bits":16, "data":[...], "more":true}\n
{"status":"chunk", "data":[...], "more":false}\n
```

#### Example

```json
{"cmd":"stream","samples":4096}
```

#### Error cases

| Condition | Message |
|---|---|
| `samples` = 0 or > 32768 | `"samples out of range (use capture_dual for deep captures)"` |
| Another capture or upload is running | `"busy"` |
| The capture did not arm | `"capture failed"` |

---

### `measure` — simultaneous DAC generate + ADC capture (loopback)

Generates a waveform on the DAC and captures ADC samples in one command. The iCE40 starts both together and plays exactly one waveform period across the capture window (the period is `samples` long), so the capture is phase-locked to the stimulus. Designed for loopback / round-trip measurements where the DAC output is wired (directly or through a DUT) to the ADC input.

When the capture finishes the firmware stops the DAC before it returns the data.

#### Request

```json
{"cmd":"measure","waveform":"<type>","freq":<Hz>,"amplitude":<0-127>,"offset":<0-255>,"samples":<count>,"sample_rate_mhz":<MHz>}
```

| Field | Type | Required | Default | Description |
|---|---|---|---|---|
| `waveform` | string | yes | — | `"sine"`, `"square"`, or `"sawtooth"` |
| `freq` | number (Hz) | no | `1000` | DAC output frequency |
| `amplitude` | integer 0–127 | no | `127` | DAC half-scale amplitude |
| `offset` | integer 0–255 | no | `128` | DAC DC offset |
| `samples` | integer | no | `256` | Number of ADC samples to capture, and the waveform period (max `2048`) |
| `sample_rate_mhz` | number (MHz) | no | auto | Sample-clock rate. Omit it and the rate is `freq × samples`, so one period spans the capture. |
| `enc` | string | no | decimal | `"b64"` |

#### Response

Same chunked format as `capture`. The first packet uses `"status":"ok"` and any subsequent packets use `"status":"chunk"`; the last packet has `"more":false`.

```json
{"status":"ok",    "bits":16, "data":[33012,37950,42800,...], "more":true}\n
{"status":"chunk", "data":[50511,52633,53518,...], "more":false}\n
```

#### Examples

```json
{"cmd":"measure","waveform":"sine","freq":100000,"amplitude":100,"offset":128,"samples":512}
```
→ Output a 100 kHz sine and return 512 ADC samples taken during the same window.

```json
{"cmd":"measure","waveform":"square","freq":50000,"samples":1024}
```
→ Output a 50 kHz square wave (defaults: amplitude 127, offset 128) and capture 1024 samples.

```json
{"cmd":"measure","waveform":"sine"}
```
→ Minimal form: 1 kHz sine, 256 samples (all defaults).

#### Error cases

| Condition | Message |
|---|---|
| `waveform` field missing | `"missing waveform"` |
| Unknown waveform | `"unknown waveform (use sine, square or sawtooth)"` |
| `samples` = 0 or > 2048 | `"samples out of range"` |
| Invalid params (for example `freq` ≤ 0) | `"measure start failed"` |
| Another capture or upload is running | `"busy"` |
| The capture did not complete | `"capture failed"` |
| DAC limits are set | the [`dac_limits`](#dac_limits--dac-output-limits-for-an-external-output-stage) refusal |

#### `measure` vs `generate` + `capture`

| | `generate` + `capture` (separate) | `measure` (combined) |
|---|---|---|
| DAC start time | First | Synchronised with ADC |
| ADC start time | Second (after `generate` response round-trip) | Synchronised with DAC |
| Skew between DAC and ADC start | Tens of ms (TCP round-trip), or none with `generate` `on_capture` | None (one gateware command) |
| DAC keeps running after | Yes (until next `generate` or duration expires) | No (stopped automatically after capture) |
| Use case | Independent generation and capture, long-running signals | Loopback / round-trip measurements, paired waveform/capture |

---

### `capture_dual` — simultaneous ADC + LA capture (one trigger)

Arm the ADC and the raw 14-channel logic analyzer off a **single** trigger and stream both regions back. The ADC samples come first, then the LA region. Either count may be `0` to capture just the other, so this one verb also serves deep ADC-only and LA-only captures. Both regions live in the 8 MB PSRAM and are read back in chunks, so each is bounded by the PSRAM, not by a RAM buffer. This is the unified capture (gateware opcode `OP_CAPTURE` = `0x31`).

The capture stays in PSRAM after the reply: if the read-back stalls, resume it with [`capture_read`](#capture_read--resume-a-capture-read-back) instead of capturing again.

#### Request

```json
{"cmd":"capture_dual","adc_samples":<N>,"adc_rate_mhz":<R>,"la_samples":<M>,"la_rate_mhz":<S>}
```

| Field | Type | Required | Default | Notes |
|---|---|---|---|---|
| `adc_samples` | integer | no | `0` | ADC 16-bit samples. |
| `adc_rate_mhz` | number (MHz) | no | max | ADC sample clock (24 MHz domain, divider ≥ 60 → max ~0.4 MHz). |
| `la_samples` | integer | no | `0` | Raw LA words, 2 bytes each (bit `n-1` = LA`n`). |
| `la_rate_mhz` | number (MHz) | no | max | LA sample clock. |
| `stop_dac_after_us` | integer | no | `0` | Gateware v21+: stop a running DAC output this many µs after t0, so the window shows it switch off. `0` leaves it running. |
| `trigger`, `trigger_timeout_ms` | object, integer | no | none | see [Capture triggers](#capture-triggers) |
| `enc` | string | no | decimal | `"b64"` for the ADC region |

`adc_samples` and `la_samples` must not both be `0`. On gateware v22 and newer the firmware packs
the LA region, the ADC region and any resident deep-replay waveform into the 8 MB and refuses up
front when they do not fit or when the combined sample rate would overrun the PSRAM bus (see
[tri-capture-unified-psram.md](tri-capture-unified-psram.md)).

The raw LA (12 MS/s and below) follows the same rules as [`la_capture`](#la_capture--deep-raw-logic-analyzer-capture):
without `la_rate_mhz` it runs at the fastest rate that fits (3 MS/s at 1 000 000 samples), and an
explicit rate that does not fit is refused with both ways out. On gateware before v53, with ADC
samples in the same capture the raw LA runs at most 8 MS/s (the PSRAM writer starved the ADC at
12 MS/s, at any depth and ADC rate): a higher raw rate is refused there. Gateware v53 and later run
the full 12 MS/s with the ADC. Above 12 MS/s the LA records changes instead. `la_rate_hz`
in the reply is the rate it ran at. Each stream takes at most 2 097 152 samples (4 MB); `la_capture` takes up to 4 194 304 LA
samples. (Before firmware 3.10.0 a deep `capture_dual` ran at the requested or the full 12 MS/s
and overflowed.)

#### Response

Chunked reply: the ADC region as unsigned 16-bit counts in `data`, then the LA region as **edges**. The **first** packet also carries the **achieved** rates so the client can build an aligned time-base (the gateware floors the ADC to a divider ≥ 60, so the actual rate can differ from the request):

```json
{"status":"ok","bits":16,"adc_rate_hz":399361,"la_rate_hz":6000000,"data":[...],"more":true}
{"status":"chunk","data":[...],"more":true}
{"status":"chunk","la":true,"la_edges":[[0,5],[812,7],[1630,5]],"la_upto":2048,"more":true}
{"status":"chunk","la":true,"la_edges":[[4100,1]],"la_upto":4096,"more":false}
```

Digital lines are mostly static, so the LA region is sent run-length coded: each `[index, word]`
pair in `la_edges` is an LA sample index and the 16-bit word that starts there, and the word holds
until the next pair. `la_upto` is the LA index the packets so far cover. An LA-only capture's first
packet carries `"la":true,"la_edges"` directly.

| Field | Meaning |
|---|---|
| `adc_rate_hz` | Achieved ADC sample rate in Hz (`24 MHz ÷ divider`); omitted when `adc_samples` = 0. |
| `la_rate_hz` | Achieved LA sample rate in Hz; omitted when `la_samples` = 0. |

#### Error cases

| Condition | Message |
|---|---|
| `adc_samples` and `la_samples` both 0 | `"adc_samples and la_samples are both 0"` |
| An explicit LA rate that does not fit (above 8 MS/s with the ADC on gateware before v53, or too deep for the rate) | `"LA at <r> MS/s does not fit ..."`, naming the most samples at that rate and the fastest rate for that depth |
| More than 2 097 152 samples in a stream | `"capture_dual takes at most 2097152 LA and 2097152 ADC samples (la_capture: up to <n> LA)"` |
| LA + ADC + a resident deep-replay waveform exceed the PSRAM (gateware v22+) | `"capture too deep: LA+ADC+DAC exceed 8 MB PSRAM"` |
| The combined rate overruns the PSRAM bus (gateware v22+) | `"combined sample rate exceeds PSRAM bus bandwidth"` |
| The PSRAM could not keep up during the capture (STATUS overflow bit) | `"capture overflowed: the PSRAM could not keep up with LA <n> kS/s + ADC <n> kS/s. Lower la_rate_mhz or adc_rate_mhz, or capture fewer samples"` |
| A count exceeds its fixed region (gateware before v22) | `"samples out of range (per-stream PSRAM region limit)"` |
| Another capture or upload is running | `"busy"` |
| ADC samples on the digital-only board | the [digital-board refusal](#gates-that-apply-to-every-command) |
| Capture did not arm | `"capture failed"` |

---

### `capture_read` — resume a capture read-back

The samples of the last `capture_dual` (or `la_capture`) stay in PSRAM after the reply. If the
read-back stalls (a slow cloud link), `capture_read` streams the rest from a sample index instead
of capturing again. The reply has the same chunked format as `capture_dual`, starting at `offset`
(ADC indices first, then LA indices continuing after them).

```json
{"cmd":"capture_read","offset":131072}
```

| Field | Type | Required | Default | Description |
|---|---|---|---|---|
| `offset` | integer | no | `0` | Global sample index to resume from (`0` .. `adc_samples + la_samples`). |
| `enc` | string | no | decimal | `"b64"` |

An `offset` equal to the total sends one empty final packet (`{"status":"ok","data":[],"more":false}`).

| Condition | Message |
|---|---|
| No `capture_dual` / `la_capture` since boot, or a newer capture started | `"no capture to resume (run capture_dual first)"` |
| Something wrote over the capture's PSRAM regions since (an OTA staging, a `load_bin` with `"psram"`, a gateware reload, a SCPI or console capture) | `"capture data was overwritten by <what>; run the capture again"` |
| `offset` past the end | `"offset out of range"` |
| Another capture or upload is running | `"busy"` |

---

### Capture triggers

**Gateware v35 or newer.** A capture can be armed and then *wait in the fabric* for a
condition on one LA pin. The producers are loaded on the arm but do not sample until the
condition is seen; that cycle becomes **t0**, so the DAC co-trigger (`generate` with
`on_capture`) and `stop_dac_after_us` count from the trigger, not from the arm.

Accepted by `capture`, `capture_dual` and `la_capture`:

```json
{"cmd":"la_capture","samples":65536,"trigger":{"la":9,"edge":"rising"},"trigger_timeout_ms":5000}
```

| Field | Type | Required | Default | Description |
|---|---|---|---|---|
| `trigger.la` | integer | yes | — | LA channel 1..14 to watch. **Any** pin, whatever its function — triggers observe, they do not claim. |
| `trigger.edge` | string | no | `"rising"` | `rising`, `falling`, `high` or `low`. |
| `trigger.pre_samples` | integer | no | `0` | `la_capture` only, gateware v50+: also return up to this many samples from before the trigger (see [`la_capture`](#la_capture--deep-raw-logic-analyzer-capture)). |
| `trigger_timeout_ms` | integer | no | `10000` | 1..600000. How long to wait before giving up. |

Omitting `trigger` (or passing `null`) captures immediately, exactly as before.

#### Reply

The final chunk of the capture reply carries the outcome:

```json
{"status":"chunk","data":[…],"trigger":{"la":9,"edge":"rising","fired":true},"more":false}
```

The firmware turns the trigger **off** in the fabric after every capture, so a following
untriggered capture is unaffected.

#### Timeout

If the condition never arrives the capture is aborted and the command errors with a
machine-parseable prefix (the edge word matches the request):

```
trigger timeout: no rising edge on LA9 within 10000 ms
```

A co-triggered DAC start staged for that capture is cancelled with it — the abort is an
untriggered t0 and would otherwise fire the waveform.

#### Error cases

| Condition | Message |
|---|---|
| the running gateware is older than v35 | `"capture triggers need gateware v35 or newer (this pod runs vNN)"` |
| `trigger` is not an object | `"trigger must be an object like {\"la\":1,\"edge\":\"rising\"}"` |
| `trigger.la` outside 1..14 | `"trigger la must be 1..14"` |
| `trigger.edge` not recognised | `"trigger edge must be rising, falling, high or low"` |
| `trigger_timeout_ms` outside 1..600000 | `"trigger_timeout_ms must be 1..600000"` |
| the condition never arrived | `"trigger timeout: no <edge> edge on LA<n> within <N> ms"` |

`status.caps` contains `"capture_trigger"` (and `"gpio_read"`) when the running gateware
supports this; the cloud capabilities frame carries the same two flags as booleans.

---

### Capabilities frame — ADC calibration fields

When the pod connects to the cloud it advertises a `capabilities` frame. Alongside `adc_bits` / `adc_fullscale_mv` / `adc_channels` it ships the affine ADC front-end calibration as **integers** (newlib-nano's `printf` has no `%f`), which the server uses to scale raw capture counts to the true probe voltage instead of the naive count ÷ full-scale:

| Field | Meaning |
|---|---|
| `adc_cal_a_uv` | Affine intercept *a* in microvolts (`V = a + b·count`). From firmware 3.9.3 it includes this pod's own offset when the pod is calibrated, and from 3.9.4 the `ext` gain when one was measured with a DMM (see [`calibrate`](#calibrate--calibrate-the-adc-offset-on-the-current_in-input-j8)), and the frame is sent again after a `calibrate`, so the server picks the new fit up without a reconnect. |
| `adc_cal_b_nv` | Affine slope *b* in nanovolts per count. |
| `adc_cal_unwrap` | `true`: the front end is bipolar, so a 16-bit count `< 32768` is unwrapped (`count += 65536`) before scaling. |
| `adc_low_range` | `true` when the board has the ADC [low range](#adc_range--the-adc-input-range-analog-module-v3r4) (analog module v3r4 and later, firmware 3.9.5+). Analog boards only. |
| `adc_range` | `"normal"` or `"low"`: the range the pod is in, the one `adc_cal_a_uv` / `adc_cal_b_nv` are for (firmware 3.9.5+). The frame is sent again on every range change, so the server scales a capture with the range it was taken in. |
| `adc_range_fs_mv` | That range's input full scale in mV (±): about 32800 normal, 5460 low (firmware 3.9.5+). |

From firmware 3.9.3 the same three fields are also in the [`status`](#status) reply on an analog
board (from 3.9.5 with `adc_range` and `adc_range_fs_mv`) (on the LAN and through cloud tunnels, not on the cloud command channel), so a LAN client
scales captures like the server does.

The frame also says which interface carries the cloud link, read from the local address of its
TCP connection (so it is the interface in use, not only the preferred one):

| Field | Meaning |
|---|---|
| `uplink` | `"eth"`, `"wifi"`, `"usb"` (through `benchpod usb-bridge`, firmware 3.9.0+), `"wifi-bridge"` (the Ethernet port goes into a connected [Wi-Fi bridge](#wifi_set--wifi_clear) box), or `"unknown"`. Older firmware leaves the field out. The server stores it with each connection-history entry. |
| `uplink_rssi_dbm` | With `"wifi-bridge"` only: the bridge's Wi-Fi signal (dBm) when the link came up. |

---

### `la_capture` — deep raw logic-analyzer capture

Capture all 14 LA channels into PSRAM and stream them back. The reply uses the LA edge format of
[`capture_dual`](#capture_dual--simultaneous-adc--la-capture-one-trigger) (`"la":true`,
`la_edges`, `la_upto`); each word holds LA1 in bit 0 up to LA14 in bit 13. Needs `la_voltage`.

```json
{"cmd":"la_capture","samples":65536,"sample_rate_mhz":2}
```

| Field | Type | Required | Default | Description |
|---|---|---|---|---|
| `samples` | integer | no | `256` | LA samples. The limit is the PSRAM left above a resident deep-replay waveform (up to the whole 8 MB, 2 bytes per sample). |
| `sample_rate_mhz` | number (MHz) | no | max (12) | LA sample clock, up to 48 on gateware v50 and later. The pod runs the closest rate at or below it that it can reach (see below); above 12 MS/s, the nearest of 48, 24 and 16. |
| `stop_dac_after_us` | integer | no | `0` | Gateware v21+: stop a running DAC output this many µs after t0. |
| `trigger`, `trigger_timeout_ms` | object, integer | no | none | see [Capture triggers](#capture-triggers) |

The first reply packet carries `la_rate_hz`, the **achieved** sample rate in Hz. Use it, not the
requested rate, as the time base:

```json
{"status":"ok","bits":16,"la_rate_hz":2181818,"la":true,"la_edges":[[0,256],[11,0]],"la_upto":256,"more":true}
```

The achieved rate can be lower than the request for two reasons:

- The sample period is a whole number of 24 MHz clocks, so the rate is 24 MHz ÷ *n* (*n* ≥ 2,
  so at most 12 MS/s), rounded down from the request: 2.304 MHz runs at 24/11 = 2.18 MHz.
  Request a rate of that form (12, 8, 6, 4.8, 4, 3, 2.4, 2, … MHz) to get it exactly.
- Without `sample_rate_mhz` a capture larger than the 96 KB burst buffer (about 49 000 samples)
  runs at the fastest rate that fits it, so no sample is dropped: 4.8 MS/s at 100 000 samples,
  3.4 MS/s at 300 000 and 3 MS/s from about 1 000 000. An explicit rate that does not fit the
  depth is refused (firmware 3.10.0 and later; it used to be slowed down), and the message names
  both ways out: `"LA at 12.0 MS/s does not fit 1000000 samples: at most 65536 samples at 12.0
  MS/s, or at most 3.0 MS/s for 1000000 samples (or leave the rate out for the fastest that
  fits)"`.

Older firmware omitted `la_rate_hz` from this reply, so hosts labeled the trace with the
requested rate.

#### Above 12 MS/s (gateware v50 and later)

A request above 12 MS/s runs at 48, 24 or 16 MS/s, the one nearest the request (`la_rate_hz`
says which). The pod records only the moments a channel changes, at 48 MS/s, and sends them as
the same `la_edges` reply, so nothing changes for the host. The capabilities report the top rate
as `la_max_rate_hz` (48000000; 12000000 on older gateware, which runs such a request at 12 MS/s).

Its limit is how often the signals change, not the number of samples: about 6 million changes per
second, all channels together, plus a buffer of about 32 000 changes for bursts. UART, I2C, CAN
and SPI with gaps between transfers stay well below it. A signal that changes faster for longer
than the buffer lasts, such as continuous SPI at 10 MHz or more for over about 1.5 ms, ends the
capture early: the reply then holds the samples up to that point, and its first packet carries
`"truncated":"busy"` (or `"memory"` when the changes filled the free capture memory). Capture at
12 MS/s or lower for such signals. `capture_dual` takes the same rates for its LA part
(`la_rate_mhz` above 12); there, a capture that stops early fails with `"capture failed"`.

#### Pre-trigger (gateware v50 and later)

With `trigger.pre_samples`, the reply also holds up to that many samples from before the trigger,
at any rate up to 48 MS/s (the pod records the changes from the arm, so this always uses the same
method as above):

```json
{"cmd":"la_capture","samples":10000,"sample_rate_mhz":24,"trigger":{"la":3,"edge":"falling","pre_samples":2000}}
```

The first reply packet carries `"pre_samples":N`, the samples actually returned before the
trigger: fewer than asked when the capture was armed only shortly before the trigger, or when the
signals changed often before it (the pod keeps about the last 16 000 changes before the trigger).
The trigger is at sample index N; `samples` more follow it.

#### Send and capture

`send` runs one transaction right after the capture is armed, in the same command, so a trigger on
the bus line catches it (this also works over the cloud, which runs one command at a time):

```json
{"cmd":"la_capture","samples":4096,"sample_rate_mhz":12,"trigger":{"la":1,"edge":"falling"},
 "send":{"bus":"i2c","addr":72,"write":"Dw","read":2}}
```

| `send` | Needs | Result in the last reply packet |
|---|---|---|
| `{"bus":"i2c","addr":A,"write":"<b64url>","read":N}` | an [`i2c_start`](#i2c_start--claim-two-pins-as-an-i2c-master) session; write and read up to 32 bytes | `"send":{"bus":"i2c","ack":true,"rx":"ARc"}` as `i2c_xfer` reports it (`nack_at` on a NACK) |
| `{"bus":"spi","tx":"<b64url>"}` | an [`spi_start`](#spi_start--claim-four-pins-for-spi) session, CS not held; 1..32 bytes in one CS frame | `"send":{"bus":"spi","rx":"..."}` |
| `{"bus":"gpio","la":N,"level":0\|1}` | LA N already a gpio `output` or `open_drain` | `"send":{"bus":"gpio","la":5,"level":0}` |

Trigger on the line the transaction starts with: SDA falling (I2C START), CS falling (SPI), or the
gpio pin's edge. A transfer that fails reports `"send":{"bus":"i2c","error":"SCL held low"}`, and the
capture still returns. A `send` that does not validate (no session, bad fields) is refused before
anything is armed.

| Condition | Message |
|---|---|
| LA voltage not set | `"la voltage not set; set it with la_voltage (mv 1800 or 3300) first"` |
| `samples` = 0 or too deep | `"samples out of range: 1 to <max>"`, with `" (a DAC waveform in the PSRAM holds the rest; dac_stop frees it)"` when a resident deep-DAC waveform is what limits it |
| Another capture or upload is running | `"busy"` |
| The capture did not arm | `"la capture failed"` |
| A pre-trigger capture changed faster than the pod can store | `"la capture failed: the signals changed faster than the pod can store at 48.0 MS/s (about 6 million changes per second, all channels together); capture at 12 MS/s or lower"` |
| `trigger.pre_samples` on gateware older than v50 | `"trigger pre_samples needs gateware v50 or newer (this pod runs v49)"` |

---

### `load` — upload a waveform for replay

Upload a host-supplied sample buffer into the device's shared waveform buffer so it can later be played out the DAC with `replay`. This is how you replay a **previously saved** trace: capture a run, save the returned array on the host, and when you want to play it back, upload it with `load` then `replay`.

Samples are 16-bit little-endian (2 bytes each). A RAM trace plays at most 2048 samples (4096 bytes, the DAC's BRAM); for longer traces use [`load_bin`](#load_bin--raw-binary-waveform-upload) with `"psram":true`. The trace is uploaded in chunks: each chunk's `data` is the raw sample bytes encoded as **base64url** (RFC 4648 §5, no padding), at most 239 characters (about 179 bytes) per chunk. Send the first chunk with `offset:0` (this claims the shared buffer), then successive chunks at increasing byte offsets; 150 bytes per chunk is a safe size.

The buffer is held (gated, like `capture`) from the first `offset:0` chunk until a `replay` ships it to the FPGA, the connection closes, or two minutes pass without a chunk or `replay`.

#### Request

```json
{"cmd":"load","offset":<byte offset>,"data":"<base64url>"}
```

| Field | Type | Required | Default | Description |
|---|---|---|---|---|
| `offset` | integer | no | `0` | Byte offset into the buffer. `0` starts a fresh upload and claims the buffer. |
| `data` | string (base64url) | yes | — | Raw sample bytes for this chunk. |

#### Response

```json
{"status":"ok","data":{"offset":0,"len":150,"total":150}}
```

`len` is the number of bytes decoded from this chunk; `total` is the trace length so far in 16-bit samples (the value to pass as `replay`'s `samples`, or just omit it to replay everything).

#### Error cases

| Condition | Message |
|---|---|
| `data` field missing | `"missing data"` |
| Chunk at `offset > 0` sent without a preceding `offset:0` on this connection | `"load not started"` |
| Another connection holds the buffer | `"busy"` |
| `offset` past 4096 bytes | `"offset out of range"` |
| The chunk would take the trace past 4096 bytes (2048 samples, what a RAM `replay` plays) | `"load: the trace would be longer than 4096 bytes (2048 samples, the DAC's RAM replay limit); use load_bin with \"psram\":true for longer traces"` |
| Malformed base64url | `"invalid data"` |

---

### `load_bin` — raw binary waveform upload

Arms a raw upload: after the reply the connection's next `total` bytes are the waveform (16-bit
little-endian samples), with no JSON or base64 around them. Then the connection returns to JSON and
`replay` plays the upload. Needs a stream connection (LAN socket or cloud byte tunnel).

```json
{"cmd":"load_bin","total":8192}
{"cmd":"load_bin","total":4000000,"psram":true}
```

| Field | Type | Required | Default | Description |
|---|---|---|---|---|
| `total` | integer | yes | — | Bytes that follow. RAM: at most 4096 (2048 samples). PSRAM: at most 8 MB. |
| `psram` | boolean | no | `false` | Stage into PSRAM for a deep replay (needs the deep-replay gateware image, `status.caps` `"dac_deep_replay"`). |

Replies: `{"status":"ok","data":{"ready":8192}}` right away, then `{"status":"ok","data":{"total":4096}}`
(in samples) once the bytes are in. An upload that gets no bytes for 30 s is dropped.

| Condition | Message |
|---|---|
| Sent on the cloud command channel | `"load_bin needs a stream connection"` |
| `total` missing | `"missing total"` |
| `total` 0 or too large | `"total out of range"` |
| Another capture or upload is running | `"busy"` |

---

### `replay` — play a recorded trace out the DAC

Play the trace back out the DAC. The trace is whichever was most recently put there: the last `capture`, `stream` or `measure` (so you can capture a signal and immediately play it back), a host-uploaded trace from `load` or `load_bin` (so you can replay a previously saved run), or a deep PSRAM upload from `load_bin` with `"psram":true`. The waveform loops continuously until `dac_stop` (or the next `generate`/`measure`/`replay`).

#### Request

```json
{"cmd":"replay","samples":<count>,"sample_rate_mhz":<MHz>}
```

| Field | Type | Required | Default | Description |
|---|---|---|---|---|
| `samples` | integer | no | full recorded length | Number of samples to play, ≤ the recorded length. |
| `sample_rate_mhz` | number (MHz) | no | max | DAC sample rate. Set this to the **same** rate the trace was captured at so the playback time base matches the recording. The firmware plays the nearest achievable rate (one sample takes divider + 51 cycles of the 48 MHz DAC clock from RAM, divider + 52 from PSRAM, divider ≥ 4). The maximum, also the default, is about 873 kS/s from RAM and 857 kS/s for a deep (PSRAM) replay; a faster request is clamped to it. The reply's `sample_rate_hz` is the rate it plays at. |
| `on_capture` | boolean | no | `false` | Gateware v27+: start at the next capture's t0 (the DAC co-trigger). |

#### Response

```json
{"status":"ok","data":{"samples":2048,"cotrig":false,"sample_rate_hz":80000}}
```

`cotrig` is `true` when the start waits for the next capture. `sample_rate_hz` is the sample rate the DAC plays at (S/s, rounded): the request snapped to the nearest achievable rate, or clamped to the maximum. Older firmware leaves it out and played a replay slower than requested (it left the 51-cycle frame overhead out of the rate: 80 kS/s played at 73.7 kS/s, 400 kS/s at 281 kS/s).

#### Error cases

| Condition | Message |
|---|---|
| Nothing has been captured or uploaded yet | `"nothing to replay"` |
| `samples` = 0 or greater than the recorded length | `"samples out of range"` |
| Another connection holds the buffer | `"busy"` |
| FPGA load/start error, or a RAM trace longer than 2048 samples | `"replay failed"` |
| DAC limits are set | the [`dac_limits`](#dac_limits--dac-output-limits-for-an-external-output-stage) refusal |

#### Record → save → replay workflow

```json
{"cmd":"capture","samples":4096,"sample_rate_mhz":0.08}   // record a run; host saves the returned array
{"cmd":"replay","sample_rate_mhz":0.08}                   // play that same run straight back out the DAC
```

To replay a run saved earlier (e.g. a "normal" trace after a "fault" trace overwrote the live buffer), upload it first:

```json
{"cmd":"load","offset":0,"data":"<base64url chunk 0>"}
{"cmd":"load","offset":150,"data":"<base64url chunk 1>"}
...
{"cmd":"replay","sample_rate_mhz":0.08}
```

Note that the DAC outputs the recorded samples as a **voltage** waveform — replaying a current trace reproduces its shape (e.g. for a scope or downstream stage), not the original current.

---

### `dac_stop` — stop DAC output

Halt any running DAC output: a looped `replay`, a continuous `generate` (`duration_ms` 0), or a held constant. No parameters.

#### Request

```json
{"cmd":"dac_stop"}
```

#### Response

```json
{"status":"ok","data":null}
```

With DAC limits set (below), `dac_stop` also holds the DAC at the low-output end of the limits
with the path routed, and replies `{"parked_mv":3600}`.

---

### `dac_set` — hold a raw DAC level

Holds the DAC at a fixed 8-bit level (scaled to the 16-bit DAC), with no routing and no
calibration. For a calibrated voltage use [`dac_out`](#analog-paths--analog_path--dac_out--adc_read).

```json
{"cmd":"dac_set","value":128,"divider":240}
```

| Field | Type | Required | Default | Description |
|---|---|---|---|---|
| `value` | integer 0..255 | yes | — | The level. |
| `divider` | integer | no | `2` | DAC engine clock = 48 MHz ÷ divider. |

Reply `null`. Errors: `"missing value"`, `"value out of range"`, `"dac set failed"`, and the
`dac_limits` refusal when limits are set.

---

### `dac_limits` — DAC output limits for an external output stage

For a bench with a power module between a DAC output and the DUT, such as a solar simulator.
Some of those modules are **inverted**: 0 V on the DAC is their FULL output. The limits are
stored in flash, survive reboots, and are checked on every command that can move the DAC,
whichever way it arrives (LAN, cloud, USB console). The embeddedci.com server sets them from the
device wiring (output stage) when the pod connects and when the wiring changes.

#### Request

```json
{"cmd":"dac_limits"}
{"cmd":"dac_limits","path":"5v","inverted":true,"min_mv":1850,"max_mv":3600}
{"cmd":"dac_limits","enabled":false}
```

| Field | Type | Description |
|---|---|---|
| `path` | string | DAC output the module is on: `3v3`, `5v` or `12v`. Without it the request only reads. |
| `inverted` | bool | `true` = 0 V on the DAC is the module's full output. |
| `min_mv`, `max_mv` | integer | The DAC voltages the module may be given, in mV. |
| `enabled` | bool | `false` clears the limits. |

Setting does not move the DAC; the next `dac_stop`, and every boot, parks it at the
low-output end (`max_mv` when inverted, `min_mv` otherwise).

#### Response

```json
{"status":"ok","data":{"enabled":true,"path":"5v","inverted":true,"min_mv":1850,"max_mv":3600,"park_mv":3600}}
```

#### What is refused while limits are set

| Command | Refused when |
|---|---|
| `dac_out` | `volts` on the limited path is outside `min_mv`..`max_mv` |
| `dac_control_loop` | `vmin`/`vmax` (16-bit codes) fall outside the limits; `in_trip` on an inverted stage (it trips to `vmin`, the highest output there) |
| `analog_path`, `dac_out`, `adc_read` | inverted stage only: the route disconnects the limited path (`off`, another DAC path, `cal2`, `cal1` unless the path is `5v`), which leaves the module input near 0 V |
| `generate`, `dac_set`, `load`, `load_bin`, `replay`, `measure`, `dac_mux`, `cal_switch` | always: they write raw DAC codes the limits can't be checked against |
| `current_out` | always, when it has `ua`: the 4-20 mA output shares the DAC, so setting a current moves the limited path. Without `ua` it only reads the range and is allowed |

Firmware before 3.9.0 applied the same rules to the USB console's analog commands and had
`dac-limits` there; from 3.9.0 the console has no analog commands.

Between reset and the moment boot parks the DAC (after the iCE40 is up), the DAC reads 0 V.
Hold the module off with its own enable pin for that window.

---

### Analog paths — `analog_path` / `dac_out` / `adc_read`

The v2 analog front end has a DAC that can drive one of several output SMAs and an
ADC that can read one of several sources, selected by an I²C mux (U55) and four
relays (U58). Rather than flipping those by hand, address the front end by
**named path**. Each name maps to one fully-specified switch state, defined once
in firmware (`analog_path_set`), so the host never has to know the mux/relay
encoding and can't wire a path two different ways.

| Path | Meaning | ADC sees |
|---|---|---|
| `off` | Everything parked | — |
| `dac_3v3` (`3v3`) | DAC → 3.3 V output SMA | — |
| `dac_5v` (`5v`) | DAC → 5 V output SMA | — |
| `dac_12v` (`12v`) | DAC → ±12 V **bipolar** differential output SMA | — |
| `adc_ext` (`ext`, `sma`) | ADC ← front-panel input SMA | ~1 MΩ high-Z, ÷12 (low range: 1.82 MΩ, ÷2) |
| `cal1` | Internal 5 V DAC → ADC loopback | 5 V path |
| `cal2` | Internal ±12 V differential DAC → ADC loopback | ±12 V path |
| `current_in` | ADC ← 4-20 mA measurement terminal (249 Ω to ground) | J8 |
| `current_out` | DAC → 4-20 mA output terminal (J9) only: the DAC voltage outputs are switched off, the ADC relays stay as they are | unchanged |

The DAC output paths also open all ADC relays (the ADC returns to the external
SMA), so driving `dac_12v` and reading the ADC is a self-contained loopback of
the front end.

#### `analog_path` — apply a path (routing only)

```json
{"cmd":"analog_path","path":"cal1"}
→ {"status":"ok","data":{"path":"cal1","u55":3,"u58":9,"range":"normal"}}

{"cmd":"analog_path","path":"ext","range":"low"}      // analog module v3r4+
→ {"status":"ok","data":{"path":"adc_ext","u55":0,"u58":32,"range":"low"}}
```

`range` (firmware 3.9.5+, optional) also sets the [ADC input range](#adc_range--the-adc-input-range-analog-module-v3r4)
after routing; without it the range stays as it is. `off` and `cal2` put the range back to
`normal`. The reply's `range` is the range in use.

#### `dac_out` — route an output path **and** set a calibrated voltage

`volts` is optional (omit to only route). The firmware converts volts to the DAC8551's full
16-bit code using the baked-in per-path calibration, so one step is about 50 µV on `3v3`,
76 µV on `5v` and 0.37 mV on `12v`.

```json
{"cmd":"dac_out","path":"5v","volts":2.5}
→ {"status":"ok","data":{"path":"dac_5v","mv":2500,"uv":2499985,"code":128,"code16":32723}}
```

| Field | Meaning |
|---|---|
| `mv`, `uv` | The voltage the chosen code gives, in millivolts and in microvolts |
| `code16` | The 16-bit DAC code now held |
| `code` | The nearest 8-bit code (`code16` / 256, rounded), what older firmware reported; `-1` when only routing |

When only routing, the reply is `{"path":…,"mv":0,"code":-1}` with no `uv` or `code16`.
Waveforms (`generate`, `load`, `replay`) still use 8-bit codes.

#### `current_out` — hold a current on the 4-20 mA output (J9)

J9 is an XTR116 two-wire transmitter. It is **loop powered**: an external floating supply drives the
loop and the pod only sets how much current flows. The request and the reply are in microamps.

```json
{"cmd":"current_out","ua":12000}
→ {"status":"ok","data":{"ua":12000,"code":32576,"min_ua":4016,"max_ua":20078}}

{"cmd":"current_out"}                 // the range only, nothing moves
→ {"status":"ok","data":{"min_ua":4016,"max_ua":20078}}
```

| Field | Meaning |
|---|---|
| `ua` | Request: the current to hold. Reply: the current the nearest DAC code gives |
| `code` | The 16-bit DAC code now held (0.245 µA per code) |
| `min_ua`, `max_ua` | What the output can do: the current at code 0 and at code 65535 |

The output has a fixed 4 mA live zero, so it cannot go below `min_ua` or above `max_ua`. There is no 0 mA and no 21 mA level. A request from 4000 µA up to `min_ua`
gives `min_ua`, so "4 mA" works. Anything else outside the range is refused, not clamped:

```json
{"cmd":"current_out","ua":2000}
→ {"status":"error","message":"current_out: 2000 uA is out of range. The output can do 4016 to
   20078 uA: it cannot go below the 4 mA live zero or above the top of the DAC"}
```

Nominally the current is `100 × (4.096 V / 102 kΩ + Vdac / 25.5 kΩ)` with
`Vdac = code / 65536 × 4.096 V`: 4016 to 20078 µA, the numbers in the examples here. A real
board is off by tens of µA, so the pod converts with a fit for its board revision, like the DAC
and ADC fits:

| Revision | `min_ua` | `max_ua` | From |
|---|---|---|---|
| v2 | 4016 | 20078 | the nominal values (not measured) |
| rev3 | 4055 | 20094 | one rev3 pod against a 6½-digit DMM: a line through 25 currents from 4.1 to 20 mA (within 1 µA), and 4.055 mA at the bottom, where the DAC cannot go lower |

Always take the range from the reply (or the capabilities frame), never from this table. The
fit is per revision, not per pod: the output has no per-pod calibration.

**The DAC is shared.** The transmitter follows the DAC on every analog path, and the 3.3 V, 5 V
and ±12 V outputs use the same DAC:

- `current_out` with `ua` switches the DAC voltage outputs off first (path `current_out`), so
  they do not follow the current. The ADC relays are not touched: a `current_in` or `ext`
  reading keeps working.
- A voltage output (`dac_out`, `generate`, `replay`, the control loop) also moves the loop
  current: about `4.02 mA + 0.0627 mA × code` for the 8-bit `code` that `dac_out` returns.
  Path `off` does not park the loop: DAC code 0 is `min_ua`.
- `dac_stop` stops a waveform but leaves the DAC where it was. Send `{"cmd":"current_out","ua":4000}`
  to go back to 4 mA.
- To play a waveform as a current, set a current first (that switches the voltage outputs off),
  then use `generate` or `load_bin` + `replay` with codes computed from `min_ua` / `max_ua`:
  `ua = min_ua + code16 × (max_ua − min_ua) / 65535`. `generate` takes 8-bit levels; a level is
  the high byte of the 16-bit code.
- While [DAC limits](#dac_limits--dac-output-limits-for-an-external-output-stage) are set,
  `current_out` with `ua` is refused.

**Wiring.** The transmitter does not source current. An external supply powers the loop:

```
supply +  →  J9 pin 1 (plus)
J9 pin 2 (minus)  →  receiver  →  supply −
```

The supply needs at least 8 V plus 20 mA times the receiver resistance (13 V for 249 Ω), and
at most 30 V. Pin 1 has a series diode, so a reversed supply gives no current and no damage.

**The loop supply must float.** J9 pin 2 is not ground: it sits up to 0.5 V below pod ground,
across the transmitter's internal sense resistor. That resistor is how the current is
regulated, so nothing else in the loop may connect to pod ground.

- Use a supply whose output is isolated from pod ground and from earth. The pod's own 5 V and
  0-20 V outputs cannot power the loop.
- Do not connect supply minus, or the low side of the receiver, to pod ground.
- J9 cannot be wired to the pod's own measurement terminal J8, because J8 is 249 Ω to pod ground.
- A target whose loop input is referenced to a ground it shares with the pod (through SWD or
  UART wiring) cannot be driven either. Use an isolated loop input on the target.
- If the loop does touch pod ground, the current bypasses the sense resistor, is no longer
  regulated, and sits near the transmitter's 32 mA limit regardless of the DAC.

To measure the loop current with the pod, put a resistor between J9 pin 2 and supply minus and
connect the ADC input SMA center to supply minus, with the SMA shell left open. `adc_read ext`
then reads a negative voltage, `-(R + 25 Ω) × I`. `hwe2e/benchpod_current_loop_hw_test.go` in
embeddedci-server does this.

The pod cannot see the loop: with no supply or an open loop, `current_out` still replies ok.

`status.caps` contains `"current_out"` when the firmware supports it. The cloud capabilities
frame has `"current_out":true` and the range as `current_out_min_ua` / `current_out_max_ua`.

#### `adc_read` — route a source **and** return a calibrated reading

`source` is `ext` (default) / `cal1` / `cal2` / `current_in`. The firmware routes the
source, waits ~20 ms for the relays to settle, averages a short 16-sample burst,
applies that source's ADC calibration, and returns millivolts plus the raw 16-bit
count and the burst's peak-to-peak spread in counts (`span`). The front-SMA input
is high-impedance (~1 MΩ); its ÷12 divider is in the shared analog front end and
already baked into the calibration, so `mv` is the true voltage at the input SMA
with no further scaling.

The shared front end is **inverting**, which puts 0 V at count ≈ 65538 — just past
the 16-bit top. A near-zero or negative input therefore wraps to a small count and
is **unwrapped** (`count += 65536`) before the fit is applied. That unwrap belongs
to the front end, so it happens for **every** source, and the burst is averaged on
the 16-bit circle *before* the unwrap — every source's quiet operating point sits
within a few counts of the wrap, so averaging raw counts first turns a burst that
straddles it into a plausible-looking reading wrong by tens of volts.

If the burst is wider than ~1024 counts the input is still **moving** (a DAC left
driving the node by a preceding `measure`/`generate`, say) and has no single
voltage, so `adc_read` returns an **error** naming the span rather than averaging
it. Stop the DAC (`dac_stop`) or let the node settle and read again.

`range` (firmware 3.9.5+, optional): `normal` or `low` switches the
[ADC input range](#adc_range--the-adc-input-range-analog-module-v3r4) before the reading
(`low` needs analog module v3r4+ and is refused for `cal2`). Without it the reading is taken in the
range the pod is in. From 3.9.5 the reply also says which:

| Field | Meaning |
|---|---|
| `range` | `normal` or `low`: the range the reading was taken in, and scaled with |
| `fullscale_mv` | That range's input full scale (±), from this pod's fit: about 32800 normal, 5460 low |
| `overrange` | `true` when a sample of the burst sat on one of the ADC's rails (code 0x7FFF or 0x8000): the input is past `fullscale_mv` and `mv` is only a bound. Use the normal range |

```json
{"cmd":"adc_read","source":"ext"}
→ {"status":"ok","data":{"source":"adc_ext","mv":11980,"count":63037,"span":4,"range":"normal",
   "fullscale_mv":32856,"overrange":false}}

{"cmd":"adc_read","source":"ext","range":"low"}       // ~167 uV per count instead of ~1 mV
→ {"status":"ok","data":{"source":"adc_ext","mv":1203,"count":58322,"span":9,"range":"low",
   "fullscale_mv":5462,"overrange":false}}

{"cmd":"adc_read","source":"cal1"}   // DAC still playing a waveform into the loopback
→ {"status":"error","message":"adc_read: input not settled on cal1 (51811 counts pk-pk
   over the 16-sample burst, limit 1024). Stop the DAC (dac_stop) or let the node settle"}
```

`current_in` is the 4-20 mA measurement terminal (J8). Its reply has two more fields:

- `ua`: the loop current in µA. The pod reads the voltage across a 249 Ω resistor, so
  `ua = mv × 1000 / 249`. 4 mA is 996 mV and 20 mA is 4980 mV.
- `offset_mv`: this pod's calibration offset, which is already taken out of `mv` and `ua`
  (see [`calibrate`](#calibrate--calibrate-the-adc-offset-on-the-current_in-input-j8)). It is 0 on a pod that was
  never calibrated.

`count` is always raw.

```json
{"cmd":"adc_read","source":"current_in"}
→ {"status":"ok","data":{"source":"current_in","mv":3985,"count":61562,"span":6,"range":"normal",
   "fullscale_mv":32856,"overrange":false,"offset_mv":10,"ua":16004}}
```

Firmware up to 3.3.0 used a different name for this source. That name is no longer accepted.

#### `adc_range` — the ADC input range (analog module v3r4)

Analog module v3r4 adds a relay (K5) that swaps the bottom leg of the ADC input divider:

| Range | Divider | Full scale | Resolution | Input impedance |
|---|---|---|---|---|
| `normal` (default) | 910k / 82.5k, about ÷12 | ±32.8 V | ~1 mV per count | ~1 MΩ |
| `low` | 910k / 910k, ÷2 | ±5.46 V | ~167 µV per count | 1.82 MΩ |

The ADC has a gap of about 3 counts at its zero crossing: a signal crossing 0 V jumps by that much, and one resting at 0 V can flip across it, which looks like extra noise. Readings away from 0 V are not affected, and calibration does not remove it.

The low range gives about 6x the resolution on signals up to ±5 V. **Use 1x leads**: its
1.82 MΩ input does not match a 10x scope probe, which expects 1 MΩ.

The divider is in front of every ADC source, so the range applies to `ext`, `cal1` and
`current_in` (4-20 mA is 0.996 to 4.98 V, inside the low range). `cal2` (±12 V) has no low range.
The range stays until it is changed, `analog_path` `off` or `cal2` is routed, or the pod restarts;
each of those puts it back to `normal`. Older boards (and modules before v3r4, whose EEPROM says a
revision below 3.4) have no K5: the range is always `normal` there and `low` is refused. The pod
reads the module revision at boot, so restart it after programming a module's EEPROM.

```json
{"cmd":"adc_range"}
→ {"status":"ok","data":{"range":"normal","supported":true,"fullscale_mv":32856,
   "normal_fullscale_mv":32856,"low_fullscale_mv":5462,"adc_cal_a_uv":65708158,"adc_cal_b_nv":-1002644}}

{"cmd":"adc_range","range":"low"}
→ {"status":"ok","data":{"range":"low","supported":true,"fullscale_mv":5462,
   "normal_fullscale_mv":32856,"low_fullscale_mv":5462,"adc_cal_a_uv":10923784,"adc_cal_b_nv":-166687}}

{"cmd":"adc_range","range":"low"}          // a board without K5
→ {"status":"error","message":"range: the low range needs analog module v3r4 or later"}
```

| Field | Meaning |
|---|---|
| `range` | The range in use |
| `supported` | The board has the low range |
| `fullscale_mv` | The full scale (±) of the range in use, from this pod's `ext` fit |
| `normal_fullscale_mv`, `low_fullscale_mv` | Both ranges' full scale (`low_fullscale_mv` only when supported) |
| `adc_cal_a_uv`, `adc_cal_b_nv` | The `ext` fit of the range in use, as in the [capabilities frame](#capabilities-frame--adc-calibration-fields): scale captures with it from now on |

Switching waits 10 ms for the relay (1.4 ms operate, 1.3 ms release) and the divider to settle
before it replies, so a capture sent next sees the new range. Captures are raw counts: the
capabilities frame and `status` carry the fit of the range in use (`adc_cal_a_uv`,
`adc_cal_b_nv`, `adc_range`), and the frame is sent again on every change. A sample on an ADC rail
(code 0x7FFF or 0x8000) is past the range's full scale. Set the range before starting the control
loop: its input map uses the fit of the range in use when it starts.

**Calibration.** The low range is the normal fit times the divider ratio
(82.5k/992.5k ÷ 0.5 ≈ 0.1662), offset included: the offset arises after the divider, so the
`calibrate` zero (J8 open) serves both ranges. The resistors' tolerance (1 %) leaves the
uncalibrated low range within a few percent. `{"cmd":"calibrate","adc":"cal1","range":"low"}`
measures this pod's low-range gain through the `cal1` loopback (the 5 V output at 1 V and 4 V, inside
the ±5.46 V range) and stores it; one gain serves every source, since K5 changes the same divider
for all of them. It needs what `adc` `cal1` needs (the offset and the 5 V output's DMM line), and
refuses a gain more than 5 % off. See [`calibrate`](#calibrate--calibrate-the-adc-offset-on-the-current_in-input-j8).

**Self-test.** `{"cmd":"adc_range","test":true}` drives the 5 V output into the `cal1` loopback at
1 V and 3.5 V (under 4 V, inside the low range) and reads each point in both ranges, each with its
own fit. A point passes when both readings agree with the set point and each other within 5 % +
30 mV: an uncalibrated low range passes, a relay that does not switch (6x off) does not. Takes
about 0.5 s, leaves the outputs off and the range `normal`, and is refused while
[DAC output limits](#dac_limits--dac-output-limits-for-an-external-output-stage) are set.

```json
{"cmd":"adc_range","test":true}
→ {"status":"ok","data":{"points":[{"set_mv":1000,"normal_mv":1001,"low_mv":999,"ok":true},
   {"set_mv":3500,"normal_mv":3502,"low_mv":3497,"ok":true}],"pass":true,"range":"normal"}}
```

`status.caps` contains `"adc_low_range"` on a board with the low range, and `status` (LAN and
tunnels) has `adc_range` and `adc_range_fs_mv`. `cal_switch` reports K5 as `low_range`.

#### `calibrate` — calibrate the ADC offset on the `current_in` input (J8)

`current_in` is the 4-20 mA terminal J8: pin 1 goes through a 249 Ω resistor to pod ground and
pin 2 is ground. The pod reads the voltage across that resistor, so 4 mA is 996 mV and
20 mA is 4980 mV.

Every ADC source is scaled with a fit, `volts = a + b × count`. The fits are built into
the firmware and are the same on every pod. Each pod still has its own offset, from part
tolerances in the ADC front end: measured from +13 mV to -50 mV at the input on pods of one
batch. `calibrate` measures that offset on `current_in` and stores it on the pod.

All four ADC sources (`ext`, `current_in`, `cal1`, `cal2`) share the same front end after the
input relays, so the offset is the same for all of them. From firmware 3.9.3 the pod takes it
out of every source's fit: `adc_read`, captures (through `adc_cal_a_uv` in `status` and the
capabilities frame) and the control loop's input map. Older firmware applies it to
`current_in` only.

Disconnect J8 first. With nothing connected the terminal is at 0 V, so the pod needs no
reference.

| Request | What it does |
|---|---|
| `{"cmd":"calibrate","source":"current_in"}` | Calibrate `current_in` with J8 disconnected, store the result, return it |
| `{"cmd":"calibrate"}` | Return the stored calibration |
| `{"cmd":"calibrate","clear":true}` | Remove it and go back to the built-in fits (from 3.9.4 also the DMM parts below) |
| `{"cmd":"calibrate","clear":"offset"}` | Remove one part only: `offset`, `dac` or `adc` (firmware 3.9.4+; from 3.9.5 `adc` also clears the low-range gain) |
| `{"cmd":"calibrate","adc":"cal1","range":"low"}` | The [low range](#adc_range--the-adc-input-range-analog-module-v3r4)'s gain through the `cal1` loopback (analog module v3r4+, firmware 3.9.5+) |

```json
{"cmd":"calibrate","source":"current_in"}
→ {"status":"ok","data":{"source":"current_in","calibrated":true,"offset_mv":4,"offset_uv":4356,
   "a_uv":65828041,"b_nv":-1004471,"count":65535,"span":6,"samples":512}}

{"cmd":"calibrate"}
→ {"status":"ok","data":{"source":"current_in","calibrated":true,"offset_mv":4,"offset_uv":4356,
   "a_uv":65828041,"b_nv":-1004471}}

{"cmd":"calibrate","clear":true}
→ {"status":"ok","data":{"source":"current_in","calibrated":false,"offset_mv":0,"offset_uv":0,
   "a_uv":65832397,"b_nv":-1004471}}
```

| Field | Meaning |
|---|---|
| `calibrated` | `true` when this pod has its own calibration stored |
| `offset_mv` | The offset in mV, rounded. `adc_read` reports the same value |
| `offset_uv` | The offset in µV, as stored |
| `a_uv`, `b_nv` | The fit the pod now uses for `current_in`: `a` in µV and `b` in nV per count, the same units as `adc_cal_a_uv` / `adc_cal_b_nv` in the [capabilities frame](#capabilities-frame--adc-calibration-fields). Unwrap the count first, as for every source |
| `count`, `span` | Raw mean count and peak-to-peak spread of the measurement (calibrate only) |
| `samples` | Samples averaged (calibrate only) |
| `dac`, `adc_gain_ppm`, `dmm` | The DMM-guided parts (firmware 3.9.4+), see [below](#dmm-guided-calibration-firmware-394) |
| `adc_comp` | The recorded frequency response of the ADC input (firmware 3.9.5+), `hf_dc_e4` and `c_top_ff`, or `null`. See [below](#adc-frequency-response-record-firmware-395) |
| `stored` | Where the calibration in use is kept (firmware 3.10.1+): `"module"` (also in the analog module's EEPROM, digital v3r3, see [`module`](#module--the-analog-module-and-its-eeprom)), `"pod"` (only the pod's flash) or `"none"` |

The measurement averages 32 bursts of 16 samples, the same burst `adc_read` takes. It
takes about 0.3 s and leaves the `current_in` path routed.

A reading outside ±150 mV is refused, because it means something is driving J8 (older
firmware: ±50 mV). The old calibration stays in place.

```json
{"cmd":"calibrate","source":"current_in"}   // a 4 mA loop is still connected
→ {"status":"error","message":"calibrate: current_in reads 996 mV, it must be within +/-150 mV of zero.
   Something is driving J8. Disconnect it and try again"}
```

The calibration is stored in flash. It survives a reboot and a firmware update. Only the
offset is calibrated: the gain uses the built-in fits (within 0.3 % on measured pods), because
calibrating it needs a reference voltage (see the DMM-guided calibration below). On `cal1` and
`cal2` the DAC output stages add a few mV of their own on top. `status.caps` contains `"calibrate"`
when the firmware supports it, and the cloud capabilities frame has `"calibrate":true`.

##### DMM-guided calibration (firmware 3.9.4)

With a bench DMM the pod can also take out what is left after the offset: its own DAC offset and
gain per output path, and then the ADC gain per source. Every step is optional and saved on its
own; a path or source without one keeps the built-in fit. `status.caps` contains `"cal_dmm"` and
the capabilities frame has `"cal_dmm":true` when the firmware takes these forms.

| Request | What it does |
|---|---|
| `{"cmd":"calibrate","dac":"5v","code1":13069,"uv1":995900,"code2":52374,"uv2":3992900}` | Store this pod's line for a DAC output path (`3v3`, `5v`, `12v`) from two points: the 16-bit code the pod drove and what the DMM read on that output's SMA, in µV |
| `{"cmd":"calibrate","adc":"cal1"}` | Measure and store an ADC source's gain (`cal1`, `cal2`, `ext`) through a loopback |

**DAC lines.** Drive each set point with [`dac_out`](#dac_out--route-an-output-path-and-set-a-calibrated-voltage)
and keep the `code16` of its reply, read the DMM, then send both points. Use points well inside
the range and away from the output floor near 0 V: 0.5 and 3.0 V on `3v3`, 1.0 and 4.0 V on `5v`,
-5 and +5 V on `12v`. Disconnect the DUT from the output first. From then on every DAC user
converts with this pod's line: `dac_out`, the calibrated `generate`, the DAC output limits. The
4-20 mA output keeps its own fit, and commands that take raw codes are not converted.

The pod refuses (and keeps the old line) when the codes are less than 16384 apart, when a reading
is more than 100 mV + 2 % from what the built-in line gives at that code (the DMM is on another
output or not on DC volts), or when the two readings give a gain more than 2 % off the built-in one.

```json
{"cmd":"calibrate","dac":"5v","code1":13069,"uv1":995900,"code2":52374,"uv2":12000}
→ {"status":"error","message":"calibrate: the DMM reads 12 mV where the 5v output gives about 4000 mV
   at code 52374. Is the DMM on the 5v SMA, set to DC volts? Nothing was stored"}
```

**ADC gains.** Once an output path has its DMM line it is a known source. The pod drives two set
points through a loopback and compares what the ADC reads (offset removed) with what the output
now puts out: `cal1` through the 5 V output (1 and 4 V), `cal2` through the ±12 V output (-5 and
+5 V), and `ext`, the front SMA, through an SMA cable from the ±12 V output to the ADC input (-5
and +5 V). `current_in` is scaled like `cal1` and follows its gain. A source then reads
`volts = g × (a + b × count - offset)`: 0 V stays 0 V, and the gain does not depend on the
offset, so either can be redone alone. The measurement takes about 0.7 s and switches the outputs
off afterwards. It needs the ADC offset calibrated and the driving path's DMM line, and refuses a
gain more than 2 % off (for `ext`: is the cable connected?). The capabilities frame is sent again
after an `ext` gain, so captures scale with it.

Both forms are refused while [DAC output limits](#dac_limits--dac-output-limits-for-an-external-output-stage)
are set: clear them, calibrate, set them again. The J8 offset does not move the DAC and stays allowed.

```json
{"cmd":"calibrate","adc":"cal1"}
→ {"status":"ok","data":{"source":"current_in","calibrated":true,"offset_mv":-50,"offset_uv":-50210,
   "a_uv":65758368,"b_nv":-1002716,
   "dac":{"3v3":null,"5v":{"a_uv":-609,"b_pv":76249841,"offset_uv":-3127,"gain_ppm":-996},"12v":null},
   "adc_gain_ppm":{"cal1":1850,"cal2":null,"ext":null},"dmm":true,
   "measured":{"v1_uv":995900,"v2_uv":3992900,"r1_uv":994100,"r2_uv":3985500,"residual_uv":1200}}}
```

| Field | Meaning |
|---|---|
| `dac.<path>` | This pod's line, `volts = a + b × code16` with `a_uv` in µV and `b_pv` in pV per 16-bit code; against the built-in line its `offset_uv` (at 0 V on `12v`, at code 0 on the others) and `gain_ppm`. `null`: the built-in line |
| `adc_gain_ppm.<source>` | The gain correction in ppm. `null`: the built-in gain |
| `range` | On a board with the [low range](#adc_range--the-adc-input-range-analog-module-v3r4) (firmware 3.9.5+): the range `a_uv` / `b_nv` are for, the range in use |
| `adc_low_gain_ppm` | The [low range](#adc_range--the-adc-input-range-analog-module-v3r4)'s gain correction in ppm, against the divider's nominal ratio; `null`: not measured. Only on a board with the low range (firmware 3.9.5+) |
| `dmm` | `true` when any DMM part is stored |
| `zero_count_mc` | The raw zero the offset is derived from: the mean count `current_in` read with J8 open, unwrapped, in thousandths of a count (firmware 3.9.4+, only when calibrated) |
| `measured` | After an `adc` run: what the output put out (`v1_uv`, `v2_uv`), what the ADC read before the gain (`r1_uv`, `r2_uv`) and the mean offset left after it (`residual_uv`) |

##### ADC frequency response record (firmware 3.9.5+)

```json
{"cmd":"calibrate","comp_hf_dc_e4":9678,"comp_c_top_ff":9360}
```

Records what a frequency sweep through the `cal1` loopback measured on this pod: the high-frequency
gain of the ADC input divider against its DC gain, times 10000 (`comp_hf_dc_e4`, 5000 to 15000), and
the fitted capacitance of the divider's top leg in femtofarads (`comp_c_top_ff`, 1000 to 65000).
Both go together. It is a record only: **no reading is scaled with it**, and DC accuracy does not
depend on it. Out of range is refused. `{"cmd":"calibrate","clear":"adc"}` and `"clear":true` remove it.

**What the pod stores** (firmware 3.9.4+): raw measurements, never a fit. The mean count with J8
open (the zero), the two codes and DMM readings per DAC output, and the two counts and input
voltages per ADC source. Every fit is derived from them at boot, with the general fits built into
that firmware: the offset is the general `cal1` fit at the zero count, a DAC line goes through its
two points, and a gain is the slope of its two points over the general fit's slope. So a general
fit measured again in a later firmware never changes what a stored value means, and J8 open keeps
reading 0 V.

A pod updated from firmware 3.4.0 to 3.9.3 keeps its offset: that firmware stored it in µV on the
general fit of its day, which the pod converts to the zero count once, exactly. Every save also
writes a copy in the old format (the offset in µV) that older firmware reads, so going back to
firmware 3.4.0 to 3.9.3 keeps the offset (the DMM parts are not used there). What the older
firmware then calibrates or clears is what a later update finds.

#### Loopback / self-cal examples

```json
// Self-cal the 5 V path (no external wiring): drive 2.5 V, read it back.
{"cmd":"dac_out","path":"5v","volts":2.5}
{"cmd":"adc_read","source":"cal1"}          // → ~2500 mV

// Measure an external signal on the ADC input SMA (high-Z ÷12 front end):
{"cmd":"adc_read","source":"ext"}
```

The low-level `dac_mux` (U55 mux: `ctrl1_sel` 0=3V3/1=5V/2=12V/3=12V_ADC,
`ctrl2_sel` 0=12V_VMID/1=ADC_VMID/2=GND) and `cal_switch` (U58 relays: `cal1`,
`cal2`, `current_in`, `cal_path`; `cal1`+`cal2` are mutually exclusive) commands
remain available for diagnostics, but prefer the named paths above.

---

### `test` — synthetic diagnostic pattern

Builds a known 16-bit pattern in the STM32 (the FPGA, ADC and analog front end are not touched) and returns it in the same chunked format as `capture`. Useful for verifying TCP, JSON, chunking and base64 decoding on their own.

#### Request

```json
{"cmd":"test","pattern":"<sine|counter|ramp|const>","value":<0-65535>,"samples":<count>}
```

| Field | Type | Required | Default | Description |
|---|---|---|---|---|
| `pattern` | string | no | `sine` (or `const` if `value` is given) | `"sine"`, `"counter"`, `"ramp"`, or `"const"` |
| `value` | integer 0-65535 | no | `65535` (used only for `const`) | Constant sample value |
| `samples` | integer | no | `256` | 1 to `4096` |
| `enc` | string | no | decimal | `"b64"` |

#### Patterns

| `pattern` | Output | Visual character |
|---|---|---|
| `sine` | One full sine period across `samples`, centred at 32768, amplitude 25000 | Smooth curve, easy to spot in a plot |
| `counter` | `0,1,2,…` (the sample index) | Each sample is unique, so dropped or reordered samples are easy to spot |
| `ramp` | Linear `0 → 65535` across all samples | Monotonic linear ramp |
| `const` | Every sample = `value` | Constant: verifies chunking and value flow |

#### Response

Same chunked format as `capture`: the first packet uses `"status":"ok"` (with `"bits":16`), the ones after it `"status":"chunk"`, and the last has `"more":false`.

#### Examples

```json
{"cmd":"test"}
```
→ 256-sample sine wave (default).

```json
{"cmd":"test","pattern":"counter","samples":1024}
```
→ 1024 samples `0,1,2,…,1023`.

```json
{"cmd":"test","value":65535}
```
→ 256 samples of `65535`.

#### Error cases

| Condition | Message |
|---|---|
| `samples` = 0 or > 4096 | `"samples out of range"` |
| Unknown `pattern` | `"unknown pattern (use sine\|counter\|ramp\|const)"` |
| Another capture or upload is running | `"busy"` |

---

### `status` — firmware and connection info

Returns the firmware version, network and cloud state, board and gateware details, health
counters and the capability list. No parameters.

#### Request

```json
{"cmd":"status"}
```

#### Response (abridged)

```json
{"status":"ok","data":{"device":"benchpod","version":"3.7.0","board":"stm32h563","net":"ready",
 "ip":"192.168.1.220","rssi_dbm":null,"wifi":"connected","cloud":"connected",
 "usb":{"net":"on","setting":"on","link":true,"ip":"10.237.8.85","host_ip":"10.237.8.86","source":"default","source_ma":500},
 "adc_bits":16,"adc_fullscale_mv":4096,"adc_channels":1,"la_vccio_mv":3300,
 "adc_cal_a_uv":65758736,"adc_cal_b_nv":-1002644,"adc_cal_unwrap":true,
 "board_rev":"v3","board_rev_mv":1650,"nrst_pin":true,"flash_kb":2048,
 "ota_sig":true,"sig_policy":"audit","sig_keys":3,"lan_policy":"open",
 "lease":{"held":false,"holder":"","left_s":0},"gateware":47,"gateware_embedded":47,
 "psram":"ok","psram_ok":true,"reset":"power-on","last_crash":"","analog":true,
 "safe_mode":false,"safe_reason":"","caps":["signal","gpio","power","swd","..."]}}
```

#### Response fields

| Field | Type | Description |
|---|---|---|
| `device` | string | Always `"benchpod"`. |
| `version` | string | Firmware version. |
| `board` | string | Board name this firmware was built for. |
| `net` | string | `"ready"` when the Ethernet or Wi-Fi interface has an address, else `"disconnected"`. |
| `ip` | string | The pod's IP (Ethernet preferred over Wi-Fi), or `"0.0.0.0"`. |
| `rssi_dbm` | number or `null` | The Wi-Fi bridge's signal (dBm) while `wifi` is `"bridge connected"`, else `null`; the built-in Wi-Fi's signal is in the console's `wifi-show`. |
| `wifi` | string | Wi-Fi (ESP32-C3) state: `disabled`, `starting`, `waiting-slave`, `flashing-c3`, `connecting`, `connected` or `backoff`; `absent` on digital v3r3, which has no ESP32-C3 (firmware 3.9.5+). With a [Wi-Fi bridge](#wifi_set--wifi_clear) on the Ethernet port and no built-in Wi-Fi configured (`disabled` or `absent`), it reports the bridge instead: `"bridge "` and its state (`bridge connected`, `bridge joining`, `bridge unconfigured`, `bridge wait-pod`, `bridge auth-failed`, `bridge no-ap`). |
| `cloud` | string | Cloud link state: `disabled`, `waiting-wifi`, `connecting`, `connected` or `backoff`. |
| `c3_restarts` | number | Boards with the built-in Wi-Fi (ESP32-C3) only: how many times the pod restarted the C3 since power-on (firmware 3.10.1+). The count survives software and watchdog resets and OTA updates; a power-on or the reset pin sets it to 0. The causes are in [`wifi_status`](#wifi_status). |
| `usb` | object | The [USB network adapter](usb-serial-interface.md#usb-network-adapter) (firmware 3.9.0+): `net` is `"on"`, or `"off"` with `off_reason` `"setting"` (the [`usb_network`](#usb_network--the-usb-network-adapter-on-or-off) setting is off; the pod then enumerates as its console only) or `"wifi"` (Wi-Fi credentials are stored); `setting` is the stored `usb_network` setting; `link` is `true` when a computer has the adapter up; `ip` is the pod's address on it and `host_ip` the one its DHCP server gives the computer. Not counted in `net` or `ip`. `source` and `source_ma` are what the USB-C port powering the pod advertises (as [`usb_cc`](#usb_cc--usb-c-cc-line-state) `advertised`, `null` on a v2 pod): `"default"` (500 mA, a typical computer port) can be too little for the pod plus a DUT on the internal 5 V rail, so clients warn about it. |
| `rx_dropped`, `tx_dropped` | integer | Console bytes dropped because a ring was full. |
| `adc_bits`, `adc_fullscale_mv`, `adc_channels` | integer | ADC format. |
| `la_vccio_mv` | integer | LA bank voltage, `0` while unset. |
| `adc_cal_a_uv`, `adc_cal_b_nv`, `adc_cal_unwrap` | integer, integer, bool | The front-SMA ADC fit captures are scaled with, this pod's calibrated offset included (analog board, firmware 3.9.3+). Same fields as the [capabilities frame](#capabilities-frame--adc-calibration-fields). Left out of a `status` sent through the cloud command channel, which caps a reply's size; cloud clients read the fit from the capabilities. |
| `board_rev` | string | PCB revision, detected at boot from the `PA3` strap: `"v2"`, `"v3"`, or `"unknown"`. Gates the LA-bank 1.8 V setting, the dedicated NRST pin, and USB-C CC monitoring. Digital v3r3 carries the v3 strap and reports `"v3"`; the `module` field tells it apart. |
| `board_rev_mv` | integer | Raw revision-strap voltage in millivolts (`-1` if not measured). Diagnostic only. |
| `nrst_pin` | boolean | `true` when the pod has the dedicated target-reset pin (v3+). When `false`, `nrst` and CMSIS-DAP `SWJ_PINS` reset requests are no-ops. |
| `flash_kb` | integer | The MCU's internal flash: `2048` or `1024`. Updaters check it before sending an image. |
| `ota_sig`, `sig_policy_cmd`, `lan_policy_cmd`, `tunnel_max_tier`, `lease_state`, `cloud_ca`, `cloud_proxy` | boolean | Always `true`: this firmware has signed updates, the policy commands, per-tunnel tiers, the lease state, and the company CA and proxy commands. Clients use them to tell older firmware apart. |
| `sig_policy`, `sig_keys` | string, integer | The [signature policy](#sig_policy--which-firmware-and-blob-updates-the-pod-accepts) and how many release keys the firmware trusts. |
| `lan_policy` | string | The [LAN policy](#lan_policy--what-the-external-lan-may-do), for the external LAN (Ethernet and Wi-Fi); the USB network adapter stays on under every value. |
| `lan_tls` | object | The [LAN API over TLS](#lan_tls--the-lan-api-over-tls) (firmware 3.9.3+): `port` (8443), `https_only`, and `sha256` of the certificate in use (`""` when there is none). |
| `lease` | object | Whether a cloud job holds the pod: `held`, `holder`, `left_s`. |
| `lwip_mem_max`, `lwip_mem_size`, `pbuf_pool_max`, `pbuf_pool_size`, `malloc_failures` | integer | Network-stack and heap health counters. |
| `gateware`, `gateware_embedded` | integer | The gateware running in the iCE40 and the one this firmware embeds (`0` = unknown). They differ after a firmware update until the boot-time gateware update has run. `gateware` `0` with `psram_ok` `false` on a new board means a blank iCE40 config flash: from firmware 3.9.2 the pod loads image 0 from its `gw0` blob at boot or as soon as that blob is installed. |
| `loop_tripped` | boolean | The control loop's over-range trip is latched. |
| `uart_rx_overflow` | boolean | The UART proxy's receive FIFO overflowed. |
| `psram`, `psram_ok` | string, boolean | The boot PSRAM self-test: `"ok"`, `"inoperable (...)"` or `"not run"`. When `psram_ok` is `false`, run [`psram_recover`](#psram_recover--reboot-to-recover-the-psram). |
| `heap_free`, `heap_min`, `stack_min`, `stacks` | integer, object | Heap and per-task stack headroom in bytes. |
| `reset`, `last_crash` | string | Why the pod last reset, and the last crash report (`""` when none). |
| `analog` | boolean | `false` on the digital-only board (no DAC or ADC). `true` on digital v3r3 when the analog module was found at boot. |
| `module` | object | Digital v3r3 only (firmware 3.9.5+; left out on every other board): the [analog module](#analog-module-digital-v3r3) in short form, `present`, `analog`, `power`, `bridge_power` and `eeprom`. Not on the cloud command channel, which caps a reply's size; send [`module`](#module--the-analog-module-and-its-eeprom) there. |
| `safe_mode`, `safe_reason` | boolean, string | Safe mode after repeated crashes at boot, and what it turned off. See [Gates](#gates-that-apply-to-every-command). |
| `caps` | array of string | The capability list, below. |

#### `caps` values

| Value | Meaning |
|---|---|
| `usb_net` | The pod has the [USB network adapter](usb-serial-interface.md#usb-network-adapter) (firmware 3.9.0+); `status.usb` says whether it is on. |
| `usb_net_setting` | The pod has the [`usb_network`](#usb_network--the-usb-network-adapter-on-or-off) setting: the adapter can be turned off on the device. |
| `lan_tls` | The API also listens on TCP `8443` with TLS, and the pod has the [`lan_tls`](#lan_tls--the-lan-api-over-tls) command (firmware 3.9.3+). |
| `wifi_scan` | The pod has the [`wifi_scan`](#wifi_scan--the-networks-the-pods-wi-fi-sees) command and the console `wifi-scan` with its built-in Wi-Fi (firmware 3.9.4+). The capabilities frame carries `"wifi_scan":true` too. Not listed on digital v3r3, which has no ESP32-C3 (firmware 3.9.5+); its frame carries `"wifi_scan":false`. |
| `signal` | The scope's old name, kept for older clients on the analog board only (firmware 3.9.2+; earlier firmware listed it on every board). Read `analog` or `scope` instead. |
| `gpio`, `power`, `swd`, `uart`, `la`, `analyzer`, `command`, `tunnel`, `ota`, `la_pins`, `power_profile`, `capture_b64`, `can`, `sensors`, `sensor_la_trigger` | Always present on this firmware: GPIO, target power, the CMSIS-DAP probe (`dap_start`), the UART bridge, the logic analyzer, the command channel and tunnels, OTA, per-pin functions (`la_pins`, `gpio`), [`power_profile`](#power_profile--record-a-rail-current-profile), [base64 samples](#base64-samples-encb64), CAN, [emulated sensors](#emulated-sensors) from definitions (format 1; `i2c_sensor`, `sensor_types` and `gps` are gone from firmware 3.10.3, see [Removed in firmware 3.10.3](#removed-in-firmware-3103)) and a [`sensor_la`](#sensor_la--raw-i2c-bus-capture) that waits for the bus's START (`trigger`, `timeout_ms`). |
| `pod_current` | The pod's own current monitor (INA at 0x41) is fitted. |
| `adc_low_range` | The ADC has the [low range](#adc_range--the-adc-input-range-analog-module-v3r4) (analog module v3r4 and later, firmware 3.9.5+). |
| `analog`, `scope`, `dac_limits`, `calibrate`, `current_out` | The analog front end is fitted. |
| `cal_dmm` | `calibrate` takes the DMM-guided forms (`dac`, `adc`, a partial `clear`): firmware 3.9.4+, analog board only. |
| `dac`, `dac_dc`, `dac_replay` | The board's DAC features (analog board only). |
| `generate16` | [`generate`](#generate--dac-waveform-output) takes volts or microamps and plays them at 16 bits (firmware 3.9.1+, analog board only). The frame's `generate_bits` is then 16, else 8. |
| `dac_deep_replay`, `dac_control_loop`, `dac_cotrig`, `dac_loop_sources`, `dac_loop_input_map` | Features of the **running** gateware image (analog board only): deep PSRAM replay, the closed-loop DAC, the co-trigger, loop input sources and the loop input map. |
| `gpio_read`, `capture_trigger` | The running gateware reads pin levels back and supports [capture triggers](#capture-triggers) (v35+). |
| `spi_master`, `spi_stream` | The running gateware has the SPI master (see [SPI master](#spi-master-flash-an-spi-device)). |
| `nrst_pin`, `usb_cc` | v3 board features. |

The gateware-dependent values can appear and disappear across an [`fpga_image`](#fpga_image--switch-the-running-gateware-image) swap.

---

### Logic Analyzer (LA) GPIO channels

Every LA command (`la`, `gpio`, `la_capture`, `dap_start`, `uart_proxy_start`, `sensor_start`, `spi_start`, capture triggers) addresses the FPGA's **Logic Analyzer bank** by a **1-based LA channel index** (`LA1`..`LA14`). LA channel `N` is J1 pin `N` (see below).

These pins live on the **iCE40 FPGA**. The stepper pulse generator, the SWD engine, the UART, the I2C target and the SPI master run inside the gateware; the STM32 only sends high-level commands over SPI.

| LA channel | iCE40 SG48 pin | | LA channel | iCE40 SG48 pin |
|---|---|---|---|---|
| `1` | 42 | | `8`  | 32 |
| `2` | 43 | | `9`  | 31 |
| `3` | 37 | | `10` | 28 |
| `4` | 38 | | `11` | 26 |
| `5` | 36 | | `12` | 27 |
| `6` | 35 | | `13` | 25 |
| `7` | 34 | | `14` | 23 |

(See `ice40/vbench_pod.pcf`. The channel→pin map is fixed per gateware build.)

---

### DUT pin header — J1 pinout

Everything the pod exposes to the device under test lands on the 2×11 header
**J1**. LA channel `N` is simply **J1 pin N**, so the channel numbers used by
`la`, `la_capture` and `dap_start` are the header's own numbering.

| Pin | Signal | Pin | Signal |
|---|---|---|---|
| 1 | `LA1` | 12 | `LA12` |
| 2 | `LA2` | 13 | `LA13` |
| 3 | `LA3` | 14 | `LA14` |
| 4 | `LA4` | 15 | `GND` |
| 5 | `LA5` | 16 | `GND` |
| 6 | `LA6` | 17 | `+3V3` |
| 7 | `LA7` | 18 | `+1V8` |
| 8 | `LA8` | 19 | `CAN+` |
| 9 | `LA9` | 20 | `CAN−` |
| 10 | `LA10` | 21 | `LA_VCCIO` **(v3)** — the LA bank rail, at whatever `la_voltage` selected |
| 11 | `LA11` | 22 | `NRST` **(v3)** — target reset, open-drain, pulled up to `LA_VCCIO` |

Every LA line has a 330 Ω series resistor and an ESD clamp between the header and
the FPGA. Pins **21 and 22 are new in v3**: earlier boards had no reset pin (the
reset line had to borrow an LA channel) and did not bring the bank rail out.

- **Reset (pin 22):** see [`nrst`](#nrst--drive-the-targets-reset-line). Used
  automatically by `dap_start` for connect-under-reset — nothing to configure.
- **`LA_VCCIO` (pin 21):** the same rail that feeds the LA bank buffers, so a DUT
  can be referenced to it. Select it with
  [`la_voltage`](#la_voltage--select-the-la-io-bank-voltage) *before* connecting a
  DUT — on a v3 pod it comes up at 3.3 V.

---

### `la` — logic-analyzer pin control

A single command for the LA bank. The action is inferred from the fields present:
**step** (when `steps` is given), **pull-up set** (when `pullup` is given), **pull-up
query** (a bare `la`), or **pull-up bitmask** (no `la`). It replaces the former
`gpio_set` / `gpio_step` / `pullup` / `pullup_status` commands. There is no active-drive
action — a pull-up, or its absence (which leaves the board's pull-down), sets a line's
idle level instead.

#### Step a pulse train

Starts a **non-blocking** train of `steps` pulses on an LA channel: each pulse is high for `delay_us` microseconds then low for `delay_us` (one full step period is `2 × delay_us`). The FPGA runs the train autonomously; the command returns immediately. Poll completion via SCPI `DIGital:STEP:BUSY?`.

```json
{"cmd":"la","la":<1-14>,"steps":<n>,"delay_us":<us>,"dir_la":<1-14>,"direction":<0|1>}
```

| Field | Type | Required | Default | Description |
|---|---|---|---|---|
| `la` | integer | yes | — | LA channel to pulse (1..14). |
| `steps` | integer | yes | — | Number of pulses. Range 1..65535. **Its presence selects the step action.** |
| `delay_us` | integer | yes | — | Microseconds per half-phase. Range 4..65535. |
| `dir_la` | integer | no | — | Optional direction channel driven (high/low) **before** stepping. |
| `direction` | integer | no | 0 | Level for `dir_la`: `1` = high, `0` = low. |

Response:

```json
{"status":"ok","data":{"la":1,"steps":200,"delay_us":500,"status":"started"}}
```

#### Switch (or query) an LA pin pull-up

Connects/disconnects a pull-up resistor on an LA pin. Each pin's pull-up is gated by an
SN74LVC2G66 analog switch driven from a PCA9555 IO-expander line: **on** drives the ctrl
line high (switch closed, resistor in circuit); **off** sets it high-Z (a PCB pull-down
holds the switch open). Only **LA1–8** carry a bias network; the resistor and its
direction are fixed per pin:

| LA pin | Network | | LA pin | Network |
|---|---|---|---|---|
| 1 | 4.7k pull-**up** | | 5 | 10k pull-**up** |
| 2 | 4.7k pull-**up** | | 6 | 10k pull-**up** |
| 3 | 2.2k pull-**up** | | 7 | 10k pull-**down** |
| 4 | 2.2k pull-**up** | | 8 | 10k pull-**down** |

**LA7 and LA8 pull DOWN, not up.** They are driven by the same `pullup` field and the
same analog switch as LA1-LA6 — only the resistor's other end differs — so a client
that assumes every biased channel pulls up will drive an open-drain bus the wrong way.
The `pull` field in the response says which way each one goes. LA9-LA14 have no
network at all.

All of them default to **off (high-Z)** at boot.

> **Only usable at a 3.3 V LA bank.** The resistors are referenced to **+3V3**, not to
> the LA bank rail, so the firmware refuses to engage one while the bank is at 1.8 V
> (see [`la_voltage`](#la_voltage--select-the-la-io-bank-voltage)). Switching the bank
> down to 1.8 V also releases any pull-up that is currently on. Turning one *off* is
> always allowed.

```json
{"cmd": "la", "la": 3, "pullup": "on"}
```

- `la` (required for a per-pin op): LA pin `1`–`8`.
- `pullup` (optional): `"on"`/`"off"` (or `1`/`0`). **Omit `pullup`** — a bare
  `{"cmd":"la","la":N}` — to **query** the current state without changing it.

Response:

```json
{"status": "ok", "data": {"la": 3, "pullup": 1, "ohms": "2.2k", "pull": "up", "pullups_available": 1}}
```

`pullup` is `1` when the resistor is connected, `0` when high-Z. `pull` is `"up"` for
LA1-LA6 and `"down"` for LA7/LA8, and does not change with state. `pullups_available`
is `1` only while the LA bank is at 3.3 V — when it is `0`, every enable request on
this pod is refused until the bank is switched back.

#### Read all pull-ups as a bitmask

Send `la` with no channel:

```json
{"cmd": "la"}
```

Response:

```json
{"status": "ok", "data": {"la_pullup_mask": 5, "pullups_available": 1}}
```

`la_pullup_mask` bit `(la-1)` is set when LA`<la>`'s pull-up is on (here `0b00000101` =
LA1 and LA3 enabled). `pullups_available` reports whether a pull-up can be engaged at
the current bank voltage (`1` = bank at 3.3 V).

#### Error cases

| Condition | Message |
|---|---|
| step request without `la` / `delay_us` | `"missing la"` / `"missing delay_us"` |
| `steps` / `delay_us` not a plain non-negative integer | `"invalid steps"` / `"invalid delay_us"` |
| `steps` outside 1..65535 (the gateware step counter is 16-bit) | `"steps must be 1..65535 (the step counter is 16-bit): split a longer move into several trains"` |
| `delay_us` outside 4..65535 | `"delay_us must be 4..65535 (microseconds per half-phase: a step takes 2 x delay_us)"` |
| a step train is already running | `"busy"` |
| step `la` invalid or out of range | `"invalid args"` |
| `dir_la` invalid, or equal to `la` | `"invalid dir_la"` / `"dir_la must be a different pin than la"` |
| the step or direction pin belongs to another function | `"pin conflict: LA<n> is in use by <function>; <how to release>"` |
| pull-up `la` outside 1–8 (incl. LA9–12) | `"no pull-up on this la"` |
| pull-up enable with the LA bank at 1.8 V | `"pull-ups are 3V3-referenced; not available with the LA bank at 1.8 V"` |
| pull-**down** enable on a pin whose function needs the line high | `"pull conflict: LA7 is used by …"` (see [pin ownership](#la-pin-ownership-functions-and-conflicts)) |
| I2C write to the PCA9555 failed | `"pca9555 write failed"` |

The step train also participates in **pin ownership**: a free step / `dir_la` pin is claimed
for the duration of the train (function `step` / `step_dir`) and released when the gateware
reports the train finished. A pin already configured as a **gpio output** is pulsed in place
without changing its ownership, and its commanded level returns afterwards.

---

### LA pin ownership: functions and conflicts

Every one of LA1..LA14 has exactly **one function** at a time. Before this existed the
gateware's pin bank resolved overlaps *silently* by priority (SWD > stepper > I2C > UART >
static level), so a UART proxy and an emulated I2C sensor could be told to share a channel
and the loser simply did not work. The firmware now keeps a table and refuses the collision.

| Function | Set by | Released by |
|---|---|---|
| `none` | default — "LA mode": high-Z, observed by captures | — |
| `gpio` | [`gpio`](#gpio--use-la-pins-as-gpio) with mode `input` / `output` / `open_drain` | `gpio` mode `off` |
| `uart_rx`, `uart_tx` | [`uart_proxy_start`](#uart_proxy_start--transparent-uart-bridge) | the proxy ending (`+++`, send failure, connection close, tunnel reset) |
| `swd_clk`, `swd_dio` | `dap_start` (see [dap-over-tunnel.md](dap-over-tunnel.md)) | SWD disarm, connection close, tunnel reset |
| `i2c_sda`, `i2c_scl` | [`sensor_start`](#sensor_start--start-an-instance) of an I2C sensor (shared by the I2C sensors on the same pair) | `sensor_stop` of the last instance on it, a reconfiguration away from the emulation image |
| `sensor_tx`, `sensor_rx`, `sensor_drdy`, `sensor_sck`, `sensor_mosi`, `sensor_miso`, `sensor_cs` | `sensor_start` of a UART sensor, a data-ready pin, the SPI sensor | `sensor_stop`, a reconfiguration away from the emulation image |
| `step`, `step_dir` | the [`la` step train](#step-a-pulse-train) on a free pin | the train finishing (the firmware polls the gateware) |
| `spi_sck`, `spi_mosi`, `spi_miso`, `spi_cs` | [`spi_start`](#spi_start--claim-four-pins-for-spi) | `spi_stop`, gateware reconfiguration |
| `i2cm_sda`, `i2cm_scl` | [`i2c_start`](#i2c_start--claim-two-pins-as-an-i2c-master) | `i2c_stop`, gateware reconfiguration |

**Captures never own pins.** `la_capture`, `capture_dual`, `sensor_la` and capture triggers
observe all 14 channels whatever their function.

Claims **persist across client disconnects** for `gpio` and the emulated sensor — they are pod
state, like the LA voltage — and are cleared by a pod reboot. A gateware reconfiguration (an
image swap or `flash-ice40`) resets every engine in the fabric: the firmware re-applies the
`gpio` pins' output state and releases the UART / SWD / I2C / step functions so the table and
the wire agree again.

#### Conflict errors

Claiming a pin another function owns fails with a machine-parseable prefix:

```
pin conflict: LA<n> is in use by <function>; <how to release>
```

An emulated sensor's pin names its instance: `pin conflict: LA<n> is in use by
sensor:<instance> (<function>); stop the sensor emulation first
({"cmd":"sensor_stop","instance":"<instance>"})`. In `la_pins` such a pin carries
`"owner":"sensor:<instance>"`; on an I2C line several sensors share, the first one and how many
others: `"sensor:env+1"`.

| Owner | `<how to release>` |
|---|---|
| `gpio` | `release it with {"cmd":"gpio","la":<n>,"mode":"off"}` |
| `uart_rx` / `uart_tx` | `stop the uart proxy first` |
| `swd_clk` / `swd_dio` | `end the SWD session first` |
| `i2c_sda` / `i2c_scl` / `sensor_*` | `stop the sensor emulation first ({"cmd":"sensor_stop","instance":"<instance>"})` |
| `step` / `step_dir` | `wait for the step train to finish` |
| `spi_*` | `stop the SPI session first ({"cmd":"spi_stop"})` |
| `i2cm_*` | `stop the I2C session first ({"cmd":"i2c_stop"})` |

When a request names several pins, the **first** conflict is reported and **nothing changes**.

Setting a level on a pin that is not a gpio output:

```
LA<n> is not a gpio output (function <function>[, gpio <mode>]); configure it with {"cmd":"gpio","la":<n>,"mode":"output"}
```

#### Pull compatibility

The fixed bias resistors (LA1/LA2 4.7k up, LA3/LA4 2.2k up, LA5/LA6 10k up, **LA7/LA8 10k
down**, LA9–LA14 none) are checked in **both** directions — when claiming a function on a pin
whose pull is engaged, and when engaging a pull on a pin that already has a function.

| Function | Pull-up engaged | Pull-down engaged (LA7/LA8) |
|---|---|---|
| `none`, gpio `input`, gpio `output`, `swd_clk`, `step`, `step_dir`, `spi_*` | ok | ok |
| gpio `open_drain` | ok | **conflict** — a released line would read low |
| `uart_rx`, `uart_tx` | ok | **conflict** — the line idles high |
| `i2c_sda`, `i2c_scl` | ok | **conflict** — an open-drain bus needs pull-ups |
| `swd_dio` | ok | **conflict** — SWDIO is pulled up when released |

```
pull conflict: LA7 has its 10k pull-down engaged, which uart_rx can't work with (the line idles high); disable it with {"cmd":"la","la":7,"pullup":"off"} or use another channel
pull conflict: LA7 is used by i2c_sda, which can't work with the 10k pull-down (an open-drain bus needs pull-ups)
```

The first form comes from a claim (`uart_proxy_start`, `dap_start`, `sensor_start`, `gpio`),
the second from `{"cmd":"la","la":7,"pullup":"on"}` on a pin that is already in use.

---

### `la_pins` — report every LA pin

Reports the function, gpio mode/level and pull state of all 14 channels, plus the live pin
levels when the gateware can read them back.

```json
{"cmd":"la_pins"}
```

Response:

```json
{"status":"ok","data":{"pins":[
  {"la":1,"function":"none","gpio":null,"level":null,"pull":{"dir":"up","ohms":"4.7k","on":false}},
  {"la":2,"function":"gpio","gpio":"output","level":1,"pull":{"dir":"up","ohms":"4.7k","on":false}},
  {"la":9,"function":"uart_rx","gpio":null,"level":null,"pull":null}
],"levels":1234}}
```

| Field | Meaning |
|---|---|
| `function` | one of `none`, `gpio`, `uart_rx`, `uart_tx`, `swd_clk`, `swd_dio`, `i2c_sda`, `i2c_scl`, `step`, `step_dir`, `spi_sck`, `spi_mosi`, `spi_miso`, `spi_cs`, the `sensor_*` functions, `i2cm_sda`, `i2cm_scl` |
| `gpio` | `null`, or the gpio mode (`input` / `output` / `open_drain`) |
| `level` | the **commanded** level of a gpio `output` / `open_drain` pin, else `null` |
| `pull` | `null` on LA9–LA14; otherwise the fixed resistor and whether it is engaged |
| `dir` | only when set with [`la_dir`](#la_dir--which-way-each-pins-dut-signal-goes): `dut_input`, `dut_output` or `bidir` |
| `warn` | only when non-zero, bits: 1 = a pull is on under a push-pull output (it only costs current; use `open_drain` or switch the pull off), 2 = the pod's target power is off while the pin is driven high or pulled up (this powers an unpowered DUT through its I/O pins; ignore it when the DUT has its own supply) |
| `levels` | live pin levels, bit `la-1`, read back from the gateware; `null` when the running image is older than **v35** |

The reply always lists all 14 entries and is about 1.3 kB (at most 1.6 kB with `dir` and `warn`). It fits the cloud command channel, but
it is the largest single-reply command the pod has.

`la_pins` does **not** require the LA voltage: it reports state and reads nothing that would
drive a DUT line.

---

### `la_dir` — which way each pin's DUT signal goes

```json
{"cmd":"la_dir","la":[9,10],"dir":"dut_output"}
```

`la` is a pin, a list of pins or `"all"`; `dir` is `dut_input`, `dut_output`, `bidir` or `unknown`
(the default after a reboot). Hosts send it from the wiring profile. On a pin wired to a DUT
output the pod refuses every push-pull driver (a gpio `output`, UART TX, SPI SCK / MOSI / CS, SWD,
the step train, an emulated sensor's TX / MISO / data-ready), because two push-pull outputs would
drive against each other: `direction conflict: LA9 is wired to a DUT output and gpio output would
drive against it; use gpio open_drain, or fix the wiring if LA9 is not a DUT output`. Open drain
(`open_drain`, I2C) and inputs are allowed. A pin that is driven can't be marked `dut_output`
until it is released. `{"cmd":"la_dir"}` lists every pin. The reply is the `la_pins` entries of
the pins it changed.

### `gpio` — use LA pins as GPIO

Four shapes, distinguished by which fields are present. All of them require the LA voltage to
have been set (see [`la_voltage`](#la_voltage--select-the-la-io-bank-voltage)).

**Modes:** `input` (high-Z, level readable), `output` (push-pull, drives `level`),
`open_drain` (`level` 0 drives low, `level` 1 releases the line to high-Z), `off` (release the
pin back to `none`).

#### 1. Configure (claim) or release

```json
{"cmd":"gpio","la":5,"mode":"output","level":1}
{"cmd":"gpio","la":[5,6,7],"mode":"input"}
{"cmd":"gpio","la":5,"mode":"off"}
{"cmd":"gpio","la":"all","mode":"off"}
```

| Field | Type | Required | Default | Description |
|---|---|---|---|---|
| `la` | integer, array of integers, or `"all"` | yes | — | Channel(s) 1..14. `"all"` is allowed **only** with `"mode":"off"`. |
| `mode` | string | yes (here) | — | `input`, `output`, `open_drain` or `off`. |
| `level` | `0` or `1` | no | `0` for `output`, `1` (released) for `open_drain` | Not accepted with `input`. |

Switching between gpio modes on a pin that is already `gpio` is allowed. `"la":"all"` with
`"mode":"off"` releases **every** gpio pin and leaves other functions untouched (no error).
The whole request is validated first: on any error **nothing changes**.

#### 2. Set the level of pins that are already gpio outputs

```json
{"cmd":"gpio","la":[5,6],"level":0}
```

#### 3. Read the live levels

```json
{"cmd":"gpio"}
```

```json
{"status":"ok","data":{"levels":1234,"pins":[ …12 entries… ]}}
```

`levels` bit `la-1` is the live level of LA`<la>`, sampled in the fabric through a two-flop
synchroniser. This needs gateware **v35** or newer; older images answer:

```
reading pin levels needs gateware v35 or newer (this pod runs v34)
```

#### Response (1 and 2)

The affected pins, in the same entry shape `la_pins` uses:

```json
{"status":"ok","data":{"pins":[{"la":5,"function":"gpio","gpio":"output","level":1,"pull":{"dir":"up","ohms":"10k","on":false}}]}}
```

#### Error cases

| Condition | Message |
|---|---|
| the LA voltage has not been set | `"la voltage not set; set it with la_voltage (mv 1800 or 3300) first"` |
| neither `mode` nor `level` given, with a `la` | `"gpio needs a mode or a level"` |
| `mode` not recognised | `"mode must be input, output, open_drain or off"` |
| `level` not 0/1 | `"level must be 0 or 1"` |
| `la` not a number, list or `"all"` | `"la must be a pin number, a list of pin numbers, or \"all\""` |
| `la` out of range | `"la must be 1..14 (or \"all\" with \"mode\":\"off\")"` |
| `"la":"all"` with anything but `"mode":"off"` | `"\"la\":\"all\" is only allowed with \"mode\":\"off\""` |
| `level` with `"mode":"input"` | `"level applies to output and open_drain pins, not input"` |
| the pin belongs to another function | `"pin conflict: …"` (see [above](#la-pin-ownership)) |
| a pull-down would fight the mode | `"pull conflict: …"` (see [above](#la-pin-ownership)) |
| level set on a pin that is not a gpio output | `"LA<n> is not a gpio output (…)"` |
| `{"cmd":"gpio"}` read on gateware < v35 | `"reading pin levels needs gateware v35 or newer (this pod runs vNN)"` |

#### SCPI

`DIGital:OUTPut <la>,<0|1>` goes through the same table: the pin becomes a **gpio output** at
that level, shows up in `la_pins`, and is released with `{"cmd":"gpio","la":<n>,"mode":"off"}`.
It requires the LA voltage, and raises a settings-conflict error if another function owns the
pin. `DIGital:STEP` follows the step-train rules above.

---

### `la_voltage` — select the LA I/O-bank voltage

The LA bank I/O voltage (iCE40 `VCCIO_0` — the supply for **all** of LA1..LA14) is
switched between **3.3 V** and **1.8 V** by an on-board TPS2116 power-mux (U8),
driven by `PG3` (select) with status on `PG4`. At boot the selection is **unset**
and the firmware **refuses every LA-bank operation** (`la`, `la_capture`,
`dap_start`, `uart_proxy_start`, `sensor_start`) until the host picks a voltage —
so the DUT's logic level is always an explicit choice.

```json
{"cmd": "la_voltage", "mv": 3300}
{"status": "ok", "data": {"mv": 3300, "st": 1, "readback_mv": 3300}}
```

- `mv` (optional): `1800` or `3300`. **Omit `mv`** to query the current state
  without changing it.
- `st`: the raw TPS2116 status pin (`PG4`) level (0/1).
- `readback_mv`: `st` decoded to a rail voltage — `3300` or `1800` — i.e. what the
  mux says it is *actually* passing, independent of what was requested. `0` on a
  v2 pod, where `st` is ambiguous (see below).

A bare `{"cmd": "la_voltage"}` reports `{"mv": 0, …}` before any voltage is
set. `status` also carries the current selection as `la_vccio_mv` (0 = unset).

> **1.8 V requires a v3 pod.** On v2 boards the TPS2116's `MODE` pin is tied to
> GND, which puts the part in a mode with no manual 1.8 V selection at all: with
> the select line low it passes the *higher* of its two inputs (always 3.3 V), and
> with the select line high it **shuts down** and leaves the bank rail
> unpowered. Firmware before this release called that shutdown state "1.8 V" — it
> never was one. v3 ties `MODE` to +3V3, which enables the real manual selection,
> and the pod now reports its revision in `status.board_rev`. On a v2 pod
> `{"mv": 1800}` returns an error instead of silently cutting the DUT's I/O rail;
> `3300` works on both. The boot default is also different: on v3 the mux comes up
> at **3.3 V**, on v2 it comes up **unpowered**.

> **v2.0.0 hardware limitation — now enforced in firmware.** The LA1–8 pull-ups (and
> the board pull-downs that hold their switches open) are referenced to **3V3**, not to
> the bank rail, so at 1.8 V a closed pull-up drives the DUT line ~1.5 V above its own
> rail. The firmware therefore **refuses to enable a pull-up while the bank is at
> 1.8 V**, and `la_voltage` with `mv: 1800` **releases any pull-up that is on** before
> switching the rail. `uart_proxy_start`'s automatic RX hold is skipped for the same
> reason at 1.8 V (a floating DUT TX may decode as `0x00` until the DUT drives it).
> Switch the bank to 3.3 V if you need a pull-up. (Hardware fix pending in v2.0.1.)

#### Error cases

| Condition | Message |
|---|---|
| `mv` not 1800 or 3300 | `"la voltage must be 1800 or 3300 (mv)"` |
| `mv: 1800` on a v2 pod | `"1.8 V needs a v3 pod; this board is v2 (its TPS2116 has no 1.8 V setting)"` |
| any LA op before a voltage is set | `"la voltage not set; set it with la_voltage (mv 1800 or 3300) first"` |
| a **change** while any LA pin has a function | `"la voltage can't change while pins are in use: LA3 (uart_rx), LA4 (uart_tx); stop them first"` |

> **Not while pins are in use.** Switching the bank glitches every LA line and strands the
> 3V3-referenced pulls, so a change is refused while any pin is owned by a function other than
> `none` (see [pin ownership](#la-pin-ownership)); the message names each pin and its function.
> Re-setting the voltage that is already selected is always allowed. The console `la_voltage`
> command applies the same rule.

---

### `nrst` — drive the target's reset line

**v3 pods only.** rev3 gave the pod a dedicated reset output: `/NRST_CONTROL` on
**pin-header J1 pin 22**, driven from the MCU through a 330 Ω series resistor and
pulled up on the board by 10 kΩ to `LA_VCCIO` — i.e. to whatever the LA bank is
switched to (1.8 V or 3.3 V), so it matches the DUT's own logic level.

Before rev3 there was no such pin: nRESET had to borrow a logic-analyzer channel,
which cost a channel and had to be named on every `dap_start`. **That is gone** —
`dap_start` no longer takes an `nreset` field, and clients no longer choose a
channel. Wire the DUT's reset to J1 pin 22 and it works everywhere.

`nreset` survives one level up, in the tooling, as a **yes/no** — `benchpod flash
--nreset`, the SDK's `flash(..., nreset=True)`, the flash dialog's checkbox — where
it now means "the target's reset is wired to that pin", and turns on
connect-under-reset. The pod itself is never told: it drives the pin whenever
CMSIS-DAP asks.

The pin is driven **open-drain**: asserted it pulls the DUT's reset net low
(~105 mV), released it is genuinely high-impedance and the board's pull-up (or the
DUT's own reset circuit) sets the level. It never drives high, so a 1.8 V DUT is
never pushed above its own rail.

```json
{"cmd": "nrst", "assert": 1}      // hold the target in reset
{"cmd": "nrst", "assert": 0}      // release
{"cmd": "nrst", "pulse_ms": 50}   // assert, wait 50 ms, release
{"cmd": "nrst"}                   // query
{"status": "ok", "data": {"supported": true, "asserted": false}}
```

| Field | Type | Required | Description |
|---|---|---|---|
| `assert` | integer | no | `1` holds reset asserted (low), `0` releases it. |
| `pulse_ms` | integer | no | Assert, hold for this many milliseconds, then release. Clamped to 1–1000. Takes precedence over `assert`. |

**You do not need this to flash.** `dap_start`'s CMSIS-DAP `SWJ_PINS` command
drives the same pin, so an OpenOCD/pyOCD *connect-under-reset* works with no extra
call. `nrst` is for test steps that reset the DUT outside a debug session — e.g.
power-on-reset behaviour, or recovering a target that wedged itself.

#### Error cases

| Condition | Message |
|---|---|
| pod is a v2 board | `"nrst pin needs a v3 pod"` |
| `pulse_ms` ≤ 0 | `"pulse_ms must be > 0"` |

---

### `usb_cc` — USB-C CC-line state

**v3 pods only.** The pod is a USB-C sink with the usual 5.1 kΩ Rd on each CC
line; rev3 added an ADC tap on both. An attached source pulls one of them up
through its Rp, so the voltage is the source's **current advertisement** and the
line that is live gives the **cable orientation**.

```json
{"cmd": "usb_cc"}
{"status": "ok", "data": {
  "supported": true, "cc1_mv": 1682, "cc2_mv": 3,
  "orientation": "cc1", "advertised": "3.0A", "advertised_ma": 3000
}}
```

| Field | Description |
|---|---|
| `supported` | `false` on a v2 pod (no CC taps). |
| `cc1_mv` / `cc2_mv` | Measured CC pin voltages in millivolts. |
| `orientation` | `"cc1"`, `"cc2"`, or `"none"` — which line the source is pulling up. |
| `advertised` | `"none"`, `"default"`, `"1.5A"` or `"3.0A"`. |
| `advertised_ma` | The same as a number: `0`, `500`, `1500` or `3000`. |

Bands are the USB Type-C sink-side vRd thresholds: below 200 mV nothing is
advertised, 200–660 mV is default USB power, 660–1230 mV is 1.5 A at 5 V, and
above 1230 mV is 3.0 A at 5 V.

> A legacy USB-A-to-C cable or a plain 5 V supply presents **no Rp at all**: both
> CC lines read ~0 mV and this reports `"none"` even though VBUS is live. That is
> correct — there is no advertisement to read. Treat `"none"` as "unknown, assume
> the minimum", not as "not powered".

This is **report-only**: nothing in the firmware gates on it. It is there so a
host can decide whether the upstream supply can carry what it is about to switch
on — the internal 5 V eFuse (`target_power` eFuse 1) feeds both the screw
terminal and, on v3, the new USB-A output socket.

#### Budget accounting

USB-C VBUS is the **only** source of the pod's `+5V` rail (through input eFuse
U57), and that rail feeds both the pod's own electronics *and* eFuse 1 — the
internal DUT rail that `power_status` measures. So the advertised budget has to
cover the internal rail's draw, and

```
headroom  ≤  advertised_ma − power_status.internal.current_ua/1000
```

is an **upper bound**, not a promise: the pod's own consumption comes out of the
same budget and is not measured (there is no shunt on the pod's supply, on any
board revision). The **external** rail (eFuse 2) is fed from screw terminal J4, a
separate supply, so it does not count against the USB-C budget at all.

The web UI renders exactly this on its Power tab (`UsbBudgetPanel`).

#### Error cases

| Condition | Message |
|---|---|
| pod is a v2 board | `"usb cc monitoring needs a v3 pod"` |
| ADC conversion failed on a v3 pod | `"usb cc read failed"` |

---

### `target_power` — enable/disable a target-power eFuse

Switches one of the two target-power eFuses on or off. This is how a host powers
the DUT before flashing/debugging it (the CLI's `flash --target-power`, for
example, enables an eFuse, lets the target boot, then connects over SWD).

| eFuse | Rail |
|---|---|
| `1` | internal 5 V |
| `2` | external 5 V..20 V |

State is **not** persisted: after a reset both eFuses return to off.

#### Request

```json
{"cmd":"target_power","efuse":<1|2>,"state":<0|1>,"delay_ms":<ms>}
```

| Field | Type | Required | Default | Description |
|---|---|---|---|---|
| `efuse` | integer | yes | — | Which eFuse to switch: `1` (internal 5 V) or `2` (external). |
| `state` | integer | yes | — | `1` (non-zero) enables the eFuse; `0` disables it. |
| `delay_ms` | integer | no | `0` | Apply the change after this many milliseconds. `0` = immediately. The command **acks right away** and the eFuse switches later from the pod's poll loop — so the connection is free to do something else meanwhile (e.g. enter `uart_proxy_start` to capture the target's boot output as it powers up). A new `target_power` for the same eFuse replaces a still-pending delayed change. |

#### Response

```json
{"status":"ok","data":{"efuse":1,"enabled":1,"delay_ms":0}}
```

| Field | Type | Description |
|---|---|---|
| `efuse` | integer | The eFuse that was switched (echoes the request). |
| `enabled` | integer | The **requested** state: `1` for on, `0` for off. With `delay_ms` > 0 this is the state the eFuse will reach once the delay elapses. |
| `delay_ms` | integer | The delay applied (echoes the request; `0` when immediate). |

#### Error cases

| Condition | Message |
|---|---|
| `efuse` field missing | `"missing efuse"` |
| `state` field missing | `"missing state"` |
| `efuse` not 1 or 2 | `"invalid efuse"` |

> **Scheduled power-on + UART capture.** `uart_proxy_start` turns the connection
> into a raw byte stream, so that connection cannot send a power-on *while*
> capturing. Schedule it instead (or send it from a second connection):
> `target_power` with `delay_ms` → `uart_proxy_start` → the eFuse switches mid-
> capture and you catch the boot banner.

> Read the eFuses' fault/valid status with `target_status`. (Firmware before 3.9.0 also had
> `power` and `pstat` on the USB console; a computer on the USB cable now uses these JSON
> commands over the [USB network adapter](usb-serial-interface.md#usb-network-adapter).)

---

### `target_status` — read target-power eFuse state

Reports the live enable/fault/valid state of both eFuses. On the STM32H563 pod both
eFuses' `V` (power-good) and `FLT` (fault) lines are wired to the TCA9554 power expander
at I2C `0x22`, so `status_supported` is always `true`.

#### Request

```json
{"cmd":"target_status"}
```

No parameters.

#### Response

```json
{"status":"ok","data":{"efuse1":{"enabled":1,"fault":0,"valid":1,"flt_pin":0,"reverse_blocks":0},"efuse2":{"enabled":0,"fault":0,"valid":0,"flt_pin":0,"reverse_blocks":0},"status_supported":true}}
```

| Field | Type | Description |
|---|---|---|
| `efuseN.enabled` | integer | `1` if the eFuse EN output is currently driven on. |
| `efuseN.fault` | integer | `1` while the eFuse has a confirmed fault: `FLT` held for 30 ms and not reverse-current blocking (below). Firmware before 3.10.1: the `FLT` pin as read. |
| `efuseN.flt_pin` | integer | `1` if the `FLT` pin is asserted right now (firmware 3.10.1+). |
| `efuseN.reverse_blocks` | integer | How many times since boot a held `FLT` was reverse-current blocking, not a fault (firmware 3.10.1+). |
| `efuseN.valid` | integer | `1` once the eFuse's input supply is valid and its inrush is done (the TPS259470A's `AUXOFF` pin). It is not output power good: no output fault takes it low. |
| `status_supported` | boolean | `true` — `V`/`FLT` are wired through the power expander. |

The TPS259470A pulls `FLT` low for real faults and also while it blocks reverse current: when
its output is more than 29 mV above its input it turns off its blocking FET, and turns it back on
only once the input is 104 mV above the output. With a light load, a dip of the pod's 5 V (a Wi-Fi
bridge on the USB-A port transmitting, for example) can hold `FLT` low for tens of ms while the
output stays up. So a held `FLT` (firmware 3.10.1+) is a fault only when the output's current
monitor shows the output collapsed (below 1 V) or carrying current (over 250 mA, the limits are
about 2 A and 3 A); otherwise it counts in `reverse_blocks`.

`FLT` is also sampled every 10 ms in the background, so a trip is reported asynchronously
(and over the cloud as an `efuse.event` frame) without polling this command. The eFuses
auto-retry after ~110 ms, and `FLT` stays asserted through the retry, so the sampling
interval never misses a trip.

---

### `power_status` — one-shot rail measurement

Reads both on-board INA238 current monitors (`0x40` = internal 5 V rail, `0x44` = external
rail) and reports each rail's bus voltage and current. Boards with the pod's own current monitor
(`0x41`, capability `pod_current`) add `pod`: what the pod itself draws from its 5 V input. This is the cheap "what is the DUT
drawing right now" call; for a waveform over time use
[`power_profile`](#power_profile--record-a-rail-current-profile).

#### Request

```json
{"cmd":"power_status"}
```

No parameters. (Treated as a high-frequency poll: it is not traced on the console.)

#### Response

```json
{"status":"ok","data":{"internal":{"ok":true,"bus_mv":5008,"current_ua":142300},
                       "external":{"ok":false,"bus_mv":0,"current_ua":0},
                       "pod":{"ok":true,"bus_mv":5012,"current_ua":231000,"total_ua":373300}}}
```

| Field | Type | Description |
|---|---|---|
| `<rail>.ok` | boolean | `false` when that INA238 did not answer (an unpopulated / unpowered rail). |
| `<rail>.bus_mv` | integer | Bus (DUT-side) voltage in mV. |
| `<rail>.current_ua` | integer | Current in µA, computed from the measured shunt voltage and the known shunt resistance — signed, so a back-feeding DUT reads negative. |
| `pod` | object | Only on boards with the pod's own monitor (`0x41`): `ok`, `bus_mv` and `current_ua` of the pod's own 5 V draw (the DUT's internal rail bypasses that shunt), and `total_ua` = pod + internal rail, which is what the USB-C input delivers (compare it with `status.usb.source_ma`). `total_ua` is left out when either read failed. The console `ina` line `pod(0x41)` (development builds) shows the same reading. |

Both reads are taken under the hardware lock that serialises this I2C bus against the console
`ina` command, the eFuse expander and the profile sampler.

---

### `power_profile` — record a rail current profile

Samples one eFuse rail's INA238 continuously and returns the statistics (and optionally the
waveform) of the window. This is what turns "the board browns out sometimes" into a number:
inrush at power-on, sleep-current floors, the energy of one duty cycle.

#### Rail limits (rev3 hardware)

| | eFuse 1 — internal | eFuse 2 — external |
|---|---|---|
| Source | 5 V from USB-C | J4 terminal, 5–20 V |
| INA238 | `0x40`, 50 mΩ shunt | `0x44`, 30 mΩ shunt |
| Current LSB | 100 µA | 167 µA |
| Full scale | ±3.28 A | ±5.46 A |
| eFuse current limit (TPS259470A) | ≈ 2.0 A | ≈ 3.0 A |
| Over-voltage lockout | 5.7 V | ≈ 21.8 V |

The eFuses auto-retry after ~110 ms and blank faults for ~2.8 ms, so **a fast trip (< 1 ms)
will not appear in a ~1 kHz profile** — `stats.fault` is the reliable indicator that one
happened. `VBUS` is measured on the **DUT side** of the eFuse. (The ADC `current_in` input is a
249 Ω 4–20 mA terminal, *not* the DUT supply — do not use it for this.)

#### Start

```json
{"cmd":"power_profile","action":"start","efuse":1,"rate_hz":1000,"max_duration_ms":60000,"keep_samples":2048}
```

| Field | Type | Required | Default | Description |
|---|---|---|---|---|
| `efuse` | `1` or `2` | no | `1` | Which rail to sample. |
| `rate_hz` | integer | no | `500` | 100..500, whole numbers only. Accurate to ~200 Hz; above that the sampler (one register read per worker pass) beats against the pass interval and flattens near 365 Hz. `stats.rate_hz` reports what was delivered, `stats.adc_rate_hz` what the sensor was configured for. |
| `max_duration_ms` | integer | no | `60000` | 1..600000. The sampler stops by itself at the limit and marks the result `truncated`. |
| `keep_samples` | integer | no | `0` | 0..4096 samples to keep for the reply. `0` = statistics only. |

```json
{"status":"ok","data":{"started":true,"efuse":1,"rate_hz":907}}
```

The INA238 is put into continuous shunt+bus mode with a conversion time × averaging that makes
one conversion period ≈ the sample period (gap-free). The hw worker reads **one** register per
pass — a shunt value every period, a bus voltage every ~10 ms, the last bus value held in
between — so the worker is never blocked. `ADC_CONFIG` is restored when the profile ends.

Statistics run over **every** raw sample. The samples kept for the reply are **bin-averaged**
down to `keep_samples`: when the store fills, neighbouring entries are averaged in pairs and
the bin size doubles, so every entry averages the same number of raw samples.

A `target_power` with `delay_ms` may fire while a profile is running — that is how you capture
inrush: start the profile, then schedule the eFuse on.

#### Stop and read the result

```json
{"cmd":"power_profile","action":"stop"}
```

Stops the sampler (if running) and returns the result using the same chunked framing as
`la_capture` — `"more":true` on every packet but the last:

```json
{"status":"ok","t_us":[0,1102,2204],"current_ua":[830,142300,141900],"bus_mv":[5008,4990,4992],"more":true}
{"status":"chunk","t_us":[…],"current_ua":[…],"bus_mv":[…],
 "stats":{"efuse":1,"rate_hz":364,"adc_rate_hz":907,"n":3640,"duration_ms":10000,
          "avg_ua":141200,"min_ua":830,"peak_ua":612400,
          "avg_mv":4995,"min_mv":4870,"max_mv":5012,
          "energy_uj":7052000,"charge_uc":1412000,
          "fault":false,"truncated":false},"more":false}
```

| Field | Meaning |
|---|---|
| `t_us` | Start of each bin, µs since the profile started. |
| `current_ua` / `bus_mv` | Bin-averaged current (µA, signed) and bus voltage (mV). |
| `stats.rate_hz` | Samples per second actually **delivered** (`n` over `duration_ms`, measured). |
| `stats.adc_rate_hz` | Conversion rate the INA238 was configured for — the ceiling `rate_hz` works towards, not what arrived. |
| `stats.n` | Raw samples taken (not the number returned). |
| `stats.energy_uj` / `charge_uc` | ∫I·V·dt in µJ and ∫I·dt in µC over every raw sample. |
| `stats.fault` | An eFuse fault was seen at any point in the window. |
| `stats.truncated` | The sampler stopped itself at `max_duration_ms`. |

The result is kept until it is read or the next `start`. Errors: `"no power profile to stop"`
when none ran.

#### Status

```json
{"cmd":"power_profile","action":"status"}
{"status":"ok","data":{"running":true,"efuse":1,"elapsed_ms":4213,"n":3821}}
```

#### One-shot

Omit `action` and give `duration_ms`: the pod starts, waits (without blocking the worker) and
then sends the same reply `stop` would. Needs a streaming connection.

```json
{"cmd":"power_profile","efuse":1,"duration_ms":2000,"rate_hz":500,"keep_samples":1024}
```

#### Error cases

| Condition | Message |
|---|---|
| a profile is already running | `"power profile already running on efuse 1"` |
| `efuse` not 1 or 2 | `"efuse must be 1 or 2"` |
| `rate_hz` out of range | `"rate_hz must be 100..500"` |
| `max_duration_ms` / `duration_ms` out of range | `"max_duration_ms must be 1..600000"` / `"duration_ms must be 1..600000"` |
| `keep_samples` > 4096 | `"keep_samples must be 0..4096"` |
| the rail's INA238 does not answer | `"power profile: the INA238 for efuse 1 (I2C 0x40) is not responding"` |
| not enough heap for `keep_samples` | `"not enough memory to keep N samples (M bytes); ask for fewer keep_samples"` |
| `action` not recognised | `"action must be start, stop or status"` |
| no `action` and no `duration_ms` | `"power_profile needs an action (start, stop, status) or duration_ms for a one-shot"` |
| `stop` with nothing to return | `"no power profile to stop"` |
| kept samples requested over the cloud **command** channel | `"the power profile kept N samples; read them over a stream connection (LAN or tunnel), or start with keep_samples 0"` |
| a one-shot over the cloud command channel | `"a one-shot power_profile waits for its result, which needs a stream connection; over the cloud command channel use action start, then stop"` |

The chunked result needs a streaming connection (LAN, or a cloud **tunnel**); the single-reply
cloud command channel can still `start`, `status` and `stop` a `keep_samples: 0` profile.

`status.caps` contains `"power_profile"`.

---

### `uart_proxy_start` — transparent UART bridge

Bridges a DUT UART through two LA channels, turning the connection into a serial-over-TCP pipe (the network equivalent of the console's `uart-proxy`). The iCE40 gateware runs a soft **8N1 UART** on the chosen channels; the RP2350 forwards bytes both ways over SPI.

Like `dap_start`, this is **connection-scoped** and changes how the connection's bytes are interpreted:

1. Send `uart_proxy_start` as a normal JSON command. The pod arms the UART and replies `{"status":"ok","data":"uart ready"}` **while still in JSON mode**.
2. **Immediately after the ack the same TCP connection becomes a transparent byte stream:** everything you send is transmitted to the DUT, and everything the DUT sends is delivered back to you (asynchronously — no polling).

#### Request

```json
{"cmd":"uart_proxy_start","rx":<1-14>,"tx":<1-14>,"baud":115200}
```

| Field | Type | Required | Default | Description |
|---|---|---|---|---|
| `rx` | integer | yes | — | LA channel the FPGA samples (wire the DUT's TX here). |
| `tx` | integer | yes | — | LA channel the FPGA drives (wire the DUT's RX here); distinct from `rx`. |
| `baud` | integer | no | 115200 | Line rate; the firmware computes the FPGA bit-period divisor. 8N1, ≤115200 solid, higher best-effort. |

#### Response

```json
{"status":"ok","data":"uart ready"}
```

After this line, the byte stream is raw UART (no more JSON until the connection returns to JSON mode, below).

#### Leaving the mode

There is no single "escape key" for a network client, so the proxy ends on either:

- **Closing the socket** (primary, recommended) — the pod auto-disarms the UART and releases the TX channel to high-Z.
- A **guard-timed `+++` escape** (Hayes convention): ≥1 s idle, then `+++`, then ≥1 s idle with no other bytes → the connection returns to JSON mode on the same socket. (The `+++` is also passed through to the DUT.)

There is **no inactivity timeout** — an idle serial console stays open.

#### Error cases

| Condition | `message` |
|---|---|
| `rx`/`tx` field missing | `"missing rx"` / `"missing tx"` |
| an LA channel is outside 1..14 or the two are equal | `"invalid uart args"` |
| a UART proxy is already active (console or another connection) | `"uart busy"` |
| `rx` or `tx` belongs to another function | `"pin conflict: …"` (see [pin ownership](#la-pin-ownership)) |
| `rx`/`tx` on LA7 or LA8 with its 10k pull-**down** engaged | `"pull conflict: …"` — the UART idles high |
| the iCE40 does not answer after arming | `"uart proxy failed: FPGA not responding (check gateware)"` |

`rx` and `tx` are **claimed** for the session (functions `uart_rx` / `uart_tx`) and released
when the proxy ends, so nothing else can be armed onto them meanwhile.

> **RX pull hold.** The proxy holds the RX line high for the session so a DUT's floating TX
> pin does not decode as a flood of `0x00` before its firmware brings the UART up. This only
> happens on **LA1–LA6**, whose resistors pull **up**: LA7/LA8 pull *down* (engaging theirs
> would guarantee the very flood it prevents) and LA9–LA14 have no resistor. It is also
> skipped at a 1.8 V bank, where the 3V3-referenced pulls are unavailable. The previous state
> is restored when the proxy ends, and a failure to restore it is logged on the console.

---

## SPI master (flash an SPI device)

Gateware v45+ (`status` caps `spi_master`; `spi_stream` with it on firmware that has the command).  The iCE40 engine that runs SWD has a second job:
an SPI master on any four LA pins, used to read and program SPI NOR flash (W25Q, MX25, GD25,
IS25 and other 25-series parts) or to talk to any other SPI device.  One engine, so an SPI
session and an SWD session (`dap_start`) exclude each other.

Hold the DUT in reset while you flash its SPI flash (`{"cmd":"nrst","assert":true}`) so its own
controller does not drive the same wires, and release it afterwards.

Every command and reply fits one cloud frame, so all of this also works over the cloud
command channel.

### `spi_start` — claim four pins for SPI

```json
{"cmd":"spi_start","sck":3,"mosi":4,"miso":5,"cs":6,"hz":1000000,"mode":0}
```

| Field | Meaning |
|---|---|
| `sck`, `mosi`, `miso`, `cs` | LA pins 1..14, all different |
| `hz` | SCK rate, default 1000000.  The pod picks the nearest rate at or below it from 24 MHz / (2 * n), n = 2..63: 6 MHz down to 190 kHz |
| `mode` | 0 (default), 1, 2 or 3 (CPOL = mode / 2, CPHA = mode % 2).  Modes 1 and 2 need gateware v55 (firmware with I2C master support) |

Reply: `{"sck":3,"mosi":4,"miso":5,"cs":6,"hz":1000000,"mode":0}` with the rate actually used.
CS is driven high (released) until a transfer.  Needs the LA voltage set first.

Errors: `SPI master needs gateware v45+`, `SPI modes 1 and 2 need gateware v55+: update the pod's firmware`,
`spi busy: send spi_stop first`,
`swd or spi busy: end the SWD session first`, and the usual `pin conflict:` / `pull conflict:`.

### `spi_stop` / `spi_status`

`{"cmd":"spi_stop"}` releases the four pins (they go back to high-Z).
`{"cmd":"spi_status"}` returns `{"active":false}` or the session's pins, rate, mode and whether
CS is held.

### `spi_xfer` — raw full-duplex transfer

```json
{"cmd":"spi_xfer","tx":"nwAAAA","cs":"release"}
```

`tx` is 1..768 bytes, base64url.  The reply carries the bytes clocked in at the same positions:
`{"rx":"_-9AFw","cs":"released"}`.  CS is asserted before the first byte; `"cs":"hold"` keeps
it asserted for the next `spi_xfer`, so one transaction can span several commands.

### `spi_stream` — send a staged upload in one CS frame

For data too big for `spi_xfer`, such as an FPGA bitstream into its slave-SPI configuration port.
Stage the bytes in PSRAM first with `load_bin` and `"psram":true` (a stream connection), then:

```json
{"cmd":"spi_stream","len":262144,"head":"egAAAA","cs":"release"}
```

| Field | Meaning |
|---|---|
| `len` | bytes of the staged upload to send (0 .. its size; 0 sends only `head`) |
| `head` | optional, up to 64 bytes (base64url) sent first in the same frame, e.g. a command opcode |
| `cs` | `release` (default) or `hold` after the last byte |

CS is asserted once and stays asserted for the whole stream; between 512-byte chunks SCK pauses
(about 3 ms per chunk, so about 1.5 s for 256 KB at 6 MHz).  A held CS from an earlier
`spi_xfer` is released first, so the stream is a frame of its own.  The pod holds the PSRAM bus
and the heavy-operation gate while it runs: send it on the connection that did the upload, or
after that connection closed.  Reply: `{"sent":262144,"ms":1450,"cs":"released"}`.

Errors: `nothing staged: load_bin with "psram":true first`, `len is more than the staged upload`,
`busy` (a capture or another connection owns the gate), `spi_stream: SPI transfer failed after N
bytes`.

Example, an ECP5 (Lattice sysCONFIG slave SPI, write-only), with PROGRAMN and DONE on two more
LA pins as `gpio`: pulse PROGRAMN low, wait 50 ms, `spi_xfer` `xgAAAA` (ISC_ENABLE 0xC6 + 3 zero
bytes), `spi_stream` with `head` `egAAAA` (LSC_BITSTREAM_BURST 0x7A + 3 zero bytes) and `len` the
bitstream size, `spi_xfer` `JgAAAA` (ISC_DISABLE 0x26), then read DONE.

### `spi_flash` — SPI NOR flash operations

Standard 25-series commands with 3-byte addresses (the first 16 MB).

| Request | Reply |
|---|---|
| `{"cmd":"spi_flash","op":"id"}` | `{"id":"ef4017","present":true,"size":8388608,"status":0}` |
| `{"cmd":"spi_flash","op":"read","addr":0,"len":1024}` | `{"addr":0,"len":1024,"data":"<b64url>"}` (len 1..1024) |
| `{"cmd":"spi_flash","op":"erase","addr":0,"len":65536}` | `{"addr":0,"len":65536,"ms":152}` |
| `{"cmd":"spi_flash","op":"write","addr":0,"data":"<b64url>"}` | `{"addr":0,"len":768,"verified":true,"ms":9}` |
| `{"cmd":"spi_flash","op":"chip_erase"}` | `{"ms":21500}` |

- `present` is false when the ID reads all 00 or all FF: nothing is answering on those pins.
- `erase` erases every 4 KB sector the range touches (64 KB block erases where a whole block
  is covered), up to 1 MB per command.  The reply gives the range actually erased.
- `write` programs 1..768 bytes on an already-erased range and reads them back
  (`"verify":false` skips the read-back).  Page boundaries are handled.
- `chip_erase` can take minutes on a large part and can outlast the cloud reply timeout; over
  the cloud prefer `erase` in 1 MB steps.

Errors: `write enable did not stick: no flash answering, or it is write-protected`,
`flash stayed busy (WIP never cleared)`, `verify failed at 0x...: not erased, write-protected,
or a bad wire`, `no SPI session: send spi_start first`.  The pod does not clear block-protect
bits; a part that ships protected needs its status register written with `spi_xfer`.

A whole image: `spi_start`, `nrst` assert, `op:"id"`, `erase` the image's range in 1 MB steps,
`write` it in 768-byte chunks, `nrst` release, `spi_stop`.

## I2C master

The pod is an I2C master on any two LA pins (firmware with gateware v55 and later): read and write
registers of a chip on the DUT's board, or scan the bus. The pins are open drain, so the bus needs
pull-ups. SWD, SPI and I2C sessions exclude each other: they share one engine in the FPGA. Every
command and reply fits one cloud frame.

### `i2c_start` — claim two pins as an I2C master

```json
{"cmd":"i2c_start","sda":1,"scl":2,"hz":400000,"pullups":"pod"}
```

| Field | Meaning |
|---|---|
| `sda`, `scl` | LA pins 1..14, different |
| `hz` | 10000..1000000, default 100000. 100 kHz runs at 100 kHz, 400 kHz at about 364 kHz, 1 MHz at about 923 kHz: each speed keeps SCL low as long as its I2C mode needs. The pod counts SCL high only once SCL reads high, which lets a target stretch the clock, so the SCL rise time adds to each period: the bus never runs faster than the reply's `hz`, and somewhat slower with slow edges (with the pod's 4.7 kOhm pull-ups on a short cable, 400 kHz measured about 333 kHz and 1 MHz about 774 kHz). Stronger pull-ups bring it closer |
| `pullups` | `pod` (default): both pins must be LA1..LA6 with the pod's pull-up switched on (`{"cmd":"la","la":1,"pullup":"on"}`); they go to 3.3 V, so the LA bank must be at 3.3 V. `external`: the board has its own pull-ups |

The pod never switches a pull-up by itself; the error says which command does.
Reply: `{"sda":1,"scl":2,"hz":363636,"pullups":"pod"}` with the rate actually used.

Errors: `the I2C master needs gateware v55+: update the pod's firmware`, `I2C needs pull-ups: switch
on LA1's with {"cmd":"la","la":1,"pullup":"on"}, or pass "pullups":"external"`, `LA7 has no pod
pull-up (only LA1..LA6 do)...`, `i2c busy: send i2c_stop first`, `swd, spi or i2c busy: end that
session first`, and the usual `pin conflict:` / `pull conflict:`.

### `i2c_stop` / `i2c_status`

`{"cmd":"i2c_stop"}` releases both pins. `{"cmd":"i2c_status"}` returns `{"active":false}` or the
session's pins, rate and pull-ups.

### `i2c_xfer` — write, read, or write then read

```json
{"cmd":"i2c_xfer","addr":72,"write":"Dw","read":2}
```

| Field | Meaning |
|---|---|
| `addr` | the 7-bit address, 0..127 |
| `write` | 0..128 bytes, base64url, sent after the address |
| `read` | 0..248 bytes to read; after a write, a repeated START comes first. The last byte is NACKed |

With neither, the pod sends the address alone (a probe). Reply:
`{"addr":72,"ack":true,"rx":"ARc"}`. When a byte is not acknowledged, `ack` is false and `nack_at`
says which: 0 the address, 1..N the Nth written byte, N+1 the address of the read. `rx` is empty
when the device did not answer the read.

Errors: `no I2C session: send i2c_start first`, `SCL held low: a target stretched the clock for
over 200 ms, or the bus is stuck; the pod released the bus`, `arbitration lost: another master
drove SDA low; the pod released the bus`.

### `i2c_scan` — which addresses answer

`{"cmd":"i2c_scan"}` probes 0x08..0x77 (`from` and `to` change the range) and returns
`{"from":8,"to":119,"found":[72,118]}`.

## Emulated sensors

The pod can **play sensors** for the DUT: I2C, SPI and UART sensors on LA channels, and analog
sensors on the analog outputs. What a sensor does is not built into the firmware: the host sends a
**sensor definition** (the format is documented in the public sensor library,
`embeddedci-com/benchpod-sensors`, `docs/format.md`), the pod compiles it and plays it. The pod
never stores definitions; they are gone after `sensor_stop`, a reboot or a firmware update.

A definition is JSON (clients convert YAML). **Key order matters**: `constants`, `functions`,
`fragments` and `let` refer to earlier entries, and the pod reads them in the order they appear
in the text. A converter must keep the source order of every object.

Up to **4 I2C sensors** (on one bus or on several), **1 SPI sensor**, **1 UART sensor** and **2
analog sensors** (one on the DAC voltage output, one on the 4-20 mA output) run at the same time.
Each one is an **instance** with a name the host picks: 1 to 16 characters of `a-z`, `0-9` and
`_` (usually the definition's `name`; the limit keeps `la_pins` and `sensor_status` inside the
cloud reply cap). At most 8 instances are defined at once.

Capability in `status` `caps`: `"sensors"`. `status` and the cloud capabilities frame also carry
`"sensors_format":1` (the definition format version the pod takes) and `"sensors_digital"` (the
emulation image is installed or running, so I2C, SPI and UART sensors work); the cloud frame also
has `"sensors":true`. These commands replace the single-sensor `sensor_*`, `sensor_types` and `gps_*` commands
of firmware 3.10.1 and earlier (see [Removed in firmware 3.10.3](#removed-in-firmware-3103)).

Typical flow:

1. `sensor_define` (one or more chunks) for each instance.
2. `sensor_start` with its pins (`la_voltage` first, and pull-ups on I2C lines).
3. `sensor_set` to change readings, `sensor_stimulus` + `sensor_stimulus_start` to play values over
   time, `sensor_fault` to inject a fault.
4. `sensor_stop`.

### The emulation image

I2C, SPI and UART sensors need the **emulation** gateware image (image 2, gateware v54 and
later, W25Q slot `gw2`). The first `sensor_start` of such a sensor loads it when another image is
running (about 2 seconds; the reply says `"image_loaded":true`). Loading it is refused while a
DAC waveform plays (`generate`, `replay` or the control loop): `"loading the emulation image stops
the DAC waveform that is playing: dac_stop it first"`. Without the image installed:
`"the emulation image is not installed (W25Q slot gw2 is empty): install the gateware blobs"`.

While the emulation image runs, the closed DAC loop (`dac_control_loop`, `dac_loop_input`,
`dac_loop_probe`) and deep DAC replay (`load_bin` with `psram`, a deep `replay`) are not
available; they fail with an error that names the way back:
`"control loop is not in the emulation image, which the emulated sensors use:
{"cmd":"sensor_stop","all":true} then {"cmd":"fpga_image","image":"loop"}"`. Captures, the UART
proxy, SWD, GPIO, the SPI master, `generate` and shallow `replay` work in every image. The pod does
not swap back by itself: after `sensor_stop` the emulation image stays loaded until
[`fpga_image`](#fpga_image--switch-the-running-gateware-image) switches it, and `fpga_image` to
another image is refused while I2C, SPI or UART sensors run. Analog sensors work in every image
and never load one.

After any reconfiguration (an image reload, `flash-ice40`, the boot-time gateware update) the
running instances are armed again with their values and the register bytes the DUT wrote; when the
emulation image is no longer running, the I2C, SPI and UART instances stop and release their pins.

### `sensor_define` — upload and compile a definition

The JSON is sent base64 encoded (standard or URL alphabet, padding optional) in chunks: `offset` 0
first, then each next chunk at the offset where the previous one ended. The chunk that reaches
`total` compiles it. The cloud command channel takes a command of at most 1280 bytes, counting the
whole command text (`{"cmd":"sensor_define",...}` with every field); `data_b64` itself takes at
most 1240 characters. A chunk of 768 raw bytes (1024 base64 characters) always fits, with room for
the other fields, in a command of at most 1152 bytes, which is what the SDK sends.

```json
{"cmd":"sensor_define","instance":"env","offset":0,"total":3225,"data_b64":"eyJmb3JtYXQi..."}
```

| Field | Type | Required | Description |
|---|---|---|---|
| `instance` | string | yes | Instance name. Defining a running instance stops it first. |
| `offset` | integer | yes | Byte offset of this chunk in the JSON (before base64). |
| `total` | integer | yes | Size of the whole JSON, 1..32768. |
| `data_b64` | string | yes | This chunk, base64. |
| `dry_run` | bool | no | Compile and report, keep nothing (validation). Send it on the last chunk. |

One upload (a definition or a stimulus) is in flight at a time: a chunk at offset 0 starts a new
one and drops the old. An upload idle for 60 s is dropped.

Replies: `{"status":"ok","data":{"instance":"env","received":768}}` for a chunk, and for the last:

```json
{"instance":"env","kind":"i2c","name":"bme280","label":"Bosch BME280...","program_bytes":1648,
 "i2c":{"address":"0x76","alt_addresses":["0x77"]},
 "params":[{"key":"temperature_c","unit":"C","min":-100,"max":150,"default":25}]}
```

SPI definitions report `"spi":{"mode":3}`, UART `"uart":{"baud":9600,"format":"8N1"}`, analog
`"analog":{"output":"voltage","min":0,"max":3.3}`. `params` lists every param unless the reply
would not fit the cloud cap (16 params with long keys); it then ends early and the reply carries
`"params_cut":true` (`sensor_status` lists every value).

Errors:

| Condition | `message` |
|---|---|
| bad instance name | `"instance must be 1..16 characters of a-z, 0-9 and _"` |
| a chunk out of order | `"chunk at offset N, expected M (start again at offset 0)"` |
| `total` out of range | `"total must be 1..32768 bytes"` |
| not base64 / too long | `"data_b64 is not base64"`, `"data_b64 too long: at most 1240 characters per chunk"` |
| the definition does not compile | `"invalid definition: registers[4].s16be: unknown name 'ax' at 17"` (format.md section 10) |
| the heap is short | `"out of memory: compiling needs N bytes, M free"` |
| 8 instances defined | `"8 instances are defined already: sensor_stop one first"` |

Memory: the upload, the compiler's scratch (about 28 KB) and the program live on the heap only
while they are needed; a running instance holds its program (up to 8 KB, typically 1.5 to 3 KB),
about 4.5 KB of state, a 256-byte register image (I2C/SPI) or 2.5 KB of UART buffers.

### `sensor_start` — start an instance

```json
{"cmd":"sensor_start","instance":"env","address":"0x77","pins":{"sda":2,"scl":1,"drdy":7},
 "values":{"humidity_pct":40}}
```

| Field | Type | Required | Description |
|---|---|---|---|
| `instance` | string | yes | A defined instance. |
| `pins` | object | yes | I2C `sda`, `scl`, optional `drdy`; SPI `sclk`, `mosi`, `miso`, `cs`; UART `tx` (pod to DUT) and optional `rx` (DUT to pod); analog `output`: `"dac"` or `"current"`. Values are LA channels: `3` or `"LA3"`. The pod does not know wiring names: clients resolve them (the SDK and MCP take wiring names and send channels). |
| `address` | string | no | I2C: the definition's `address` or one of its `alt_addresses` (`"0x77"` or `119`). |
| `baud` | integer | no | UART: overrides the definition's baud rate (300..3000000). |
| `values` | object | no | Initial param values (otherwise the defaults), checked like `sensor_set`. |

Reply:

```json
{"instance":"env","slot":"i2c0","image":"emulation","image_loaded":true,"address":"0x77",
 "unavailable":["dac_control_loop","deep_replay"]}
```

`slot` is the gateware block the instance uses: `i2c0`..`i2c3`, `spi0`, `uart0`, `analog0` (the DAC
voltage output) or `analog1` (the 4-20 mA output). UART replies add `"baud"`. `unavailable` is
there while the emulation image runs.

Pins are claimed as LA functions with the instance as owner (`la_pins` shows
`"function":"i2c_sda","owner":"sensor:env"`, see
[LA pin ownership](#la-pin-ownership-functions-and-conflicts)). Several I2C instances may share
`sda`/`scl` when they use the same pair and different addresses. A pin conflict is refused as for
every LA owner.

What the gateware supports, and the limits that follow:

- **I2C**: 8- or 16-bit register addresses (`i2c.page` is the 256-aligned window), 16-bit word
  registers (`i2c.register_bytes: 2`: up to 128 registers, pointer bit 7 ignored, so `p` and
  `p + 0x80` are one register), 16-bit commands in any high byte (`register_address_bits: 16`
  without `page`: the pod lays out every answer, and the bytes a set command writes
  (`write_bytes`), plus one byte per high command byte, in the 256-byte image; a command the
  definition does not list reads whatever its high byte's layout points at), the conversion
  handshake (`trigger`, `busy`, `while_busy` flag, nack or stretch), commanded sensors, the FIFO
  register, `writable: false` bytes (the DUT's writes are counted but not stored), data ready on
  `drdy`. A target has 4 conversion times of at most 65535 us: a longer `time_us` / `busy_us` is
  cut to 65.535 ms, and a definition with more than 4 distinct times uses the longest set one for
  the rest. The pointer always auto-increments and wraps at the end of the window.
- **SPI**: modes 0..3, read and increment bits, address mask, 0..3 dummy bytes, the FIFO register
  and `writable: false`. The SPI target has no conversion handshake and no data-ready pin
  (`"drdy"` is refused: `"the emulated SPI target has no data-ready pin"`); SCK up to about 2 MHz.
- **UART**: 8N1 only (`"the emulated UART is 8N1 only (the definition asks for 7E1)"`); messages
  go out at their times, requests are matched byte by byte and answered after `delay_ms`.
- **FIFO**: one instance with a `fifo` runs at a time (the gateware has one 2047-byte FIFO); frames
  are pushed at `rate_hz` while `enabled`, up to `depth` frames. When it is full new frames are
  dropped (`overflow: drop_oldest` behaves like `drop_newest`: the gateware cannot drop the oldest
  frame). `fifo_level` in a register reads the frames waiting.
- **Data ready**: `on: conversion` asserts in the gateware at the end of each conversion;
  `on: sample` with each FIFO frame and each stimulus step; `on: rate` at `rate_hz`. While the
  definition's `enabled` condition is false the pin keeps its inactive level and never asserts (a
  held level is released). All targets share one pulse width: the last started instance's
  `pulse_us` (1..255).
- **Analog**: one instance per output. The DAC instance picks the smallest output path that covers
  its `range.max` (3v3, 5v, 12v); the current instance drives the 4-20 mA output. `excitation: adc`
  is refused for now (`"excitation: adc is not supported by the pod yet"`). An analog start is
  refused while a DAC waveform plays, and while an analog sensor plays an output, the commands that
  drive it (`generate`, `replay`, `load`, `load_bin`, `measure`, `dac_set`, `dac_out`,
  `dac_control_loop`, and `current_out`) are refused with `"the dac output is played by
  sensor:ntc; stop it first ({"cmd":"sensor_stop","instance":"ntc"})"`. On a board where the
  4-20 mA output shares the DAC (no quad DAC), both outputs count as the DAC. `dac_stop` stops the
  analog instances on the DAC too (they stay defined).

Errors include `"unknown sensor instance 'env'"`, `"env is running: sensor_stop it first"`,
`"an I2C sensor needs pins sda and scl"`, `"address 0x76 is not one of this sensor's addresses"`,
`"address 0x76 is used by sensor:env on this bus"`, `"all 4 I2C sensor slots are in use:
sensor_stop one first"`, `"the sensor FIFO is used by sensor:imu (one FIFO sensor at a time)"`,
`"la voltage not set; set it with la_voltage (mv 1800 or 3300) first"` and the pin conflicts.

### `sensor_set` — change readings

```json
{"cmd":"sensor_set","instance":"env","values":{"temperature_c":31.5,"humidity_pct":60}}
```

Every value is checked before any is applied: a value outside the param's range is refused with
its range (`"humidity_pct must be 0..100 %"`), an unknown key with `"env has no param 'x'"`.
Reply: `{"instance":"env","values":{"temperature_c":31.5,"humidity_pct":60}}` (the values as sent).
The DUT sees the new reading on its next read (I2C/SPI) or next message (UART); an analog output
moves on the next poll.

### `sensor_stimulus` — upload a stimulus

Same chunking as `sensor_define`, without `instance` (a stimulus may drive several instances; its
signals use `instance.param`, or `param` when only one instance runs). One stimulus is loaded at a
time; a new one replaces it. The last chunk's reply:
`{"program_bytes":412,"signals":["env.temperature_c"],"faults":2,"duration_s":95,"repeat":false}`.

```json
{"cmd":"sensor_stimulus","offset":0,"total":812,"data_b64":"..."}
{"cmd":"sensor_stimulus_start"}
{"cmd":"sensor_stimulus_start","at_s":30}
{"cmd":"sensor_stimulus_stop"}
```

`sensor_stimulus_start` checks that every signal and fault names a running instance and one of its
params (`"signal env.temp: env has no such param"`), then starts at t = 0 or `at_s`. Values are
applied `rate_hz` times a second (default 50, at most 100), clamped to the param ranges. It ends
after its last segment (signals hold their last value) unless it has `repeat: true`. Replies:
`{"running":true}` and `{"running":false}`; stopping switches its faults off. Stopping or
redefining an instance a running stimulus drives stops the stimulus.

### `sensor_fault` — inject a fault now

```json
{"cmd":"sensor_fault","instance":"env","type":"no_response","duration_s":2}
{"cmd":"sensor_fault","instance":"env","type":"corrupt","at":"0xFA","mask":"0x01"}
{"cmd":"sensor_fault_clear","instance":"env"}
```

Types and fields as in the format's faults section: `type`, `duration_s`, `param`, `value`, `at`,
`mask`, `rate_hz`; `at` and `mask` take integers or hex strings. Without `duration_s` a fault lasts
until `sensor_fault_clear`; `bus_stuck` needs a `duration_s` of at most 1 s. At most 4 faults are
on per instance. Reply: `{"instance":"env","fault":"no_response"}`; `sensor_fault_clear` replies
`{"instance":"env","faults":[]}` and also clears the faults a stimulus switched on.

| Type | What the pod does |
|---|---|
| `no_response` | I2C: the address is not acknowledged; SPI: MISO stays released; UART: no messages and no answers |
| `bus_stuck` | I2C: SDA held low (the gateware), released after `duration_s` |
| `stuck`, `offset`, `gain`, `corrupt`, `open`, `short` | in the engine: the next image, message or output carries it |
| `garbage` | UART: random bytes at `rate_hz` (default 100) instead of the messages |
| `drop` | UART: each message dropped with probability `value` |
| `baud_error` | UART: UART2 runs `value` percent off the baud rate |

A fault that does not apply to the kind is refused: `"fault bus_stuck does not apply to a uart
sensor"`.

### `sensor_stop`

`{"cmd":"sensor_stop","instance":"env"}` or `{"cmd":"sensor_stop","all":true}`. Releases the pins
and forgets the definition. Reply: `{"stopped":["env"]}` (every name for `all`). The emulation
image stays loaded.

### `sensor_status`

```json
{"image":"emulation","stimulus":{"loaded":true,"running":true,"t_s":12.4},
 "instances":[{"instance":"env","kind":"i2c","name":"bme280","slot":"i2c0","running":true,
   "address":"0x76","pins":{"sda":2,"scl":1},
   "values":{"temperature_c":25,"pressure_pa":101325,"humidity_pct":40},
   "faults":[{"type":"no_response","left_s":1.25}],
   "bus":{"writes":14,"transfers":null,"log_lost":0,"last_write":{"at":"0xF4","value":"0x27"}}}]}
```

`{"cmd":"sensor_status","instance":"env"}` reports one instance. Every reply fits the cloud reply
cap (1792 bytes): when the next instance would not fit, the list ends there and the reply carries
`"next":N`; ask again with `"first":N` for the rest. Six typical instances fit one reply; six with
16 long-named params each take two or three.

Per instance: `slot` as in `sensor_start` (empty when not running); `pins`; `values` (the params
as set); `faults`, a list of objects with `type`, the fields it was given (`param`, `value`, `at`,
`mask`, `rate_hz`), `"stimulus":true` when a stimulus switched it on, and `left_s` (null: until
cleared). I2C/SPI `bus`: `writes` (the DUT's data bytes), `transfers` (always `null`: the v54
gateware counts written bytes, not transfers), `log_lost` (writes that happened while more than 32
were pending, so the rules saw them only as "something was written"), `last_write`, `drdy` (asserts
the firmware sent), `fifo_frames` and `fifo_drops`. UART `bus`: `sent_bytes`, `received_bytes`,
`messages`, `answers`, `overruns` (a message or answer due while the last one was still going out:
the baud rate is too low for the rate and the messages), `dropped` (the `drop` fault), `late`
(epochs skipped because the pod was busy when they fell due, for example during a long capture:
the pod sends the newest one, as a busy receiver would). Analog instances report `output` (the value last driven, V or mA).

### `sensor_regs` — read an I2C/SPI image

`{"cmd":"sensor_regs","instance":"env","start":"0xF7","len":8}` returns the bytes the DUT reads now
(its own writes included) in **one reply** (not the chunked uint8 array of firmware 3.10 and
earlier: at most 256 bytes fit, and a single reply works over the cloud command channel):
`{"instance":"env","start":"0xF7","len":8,"data_b64":"gAAAgAAAgAA="}` (standard base64). `start`
0..255, `len` 1..256 (default the whole image).

### `sensor_la` — raw I2C bus capture

`{"cmd":"sensor_la","instance":"env","samples":1024,"sample_rate_mhz":0.5}` captures the two bus
pins of a running **I2C** instance. By default it **waits for the DUT's next transaction**: the
capture starts on the first SDA fall (on an idle bus that is a START) and keeps 1/8 of the samples
from before it, so the START itself is in the window. A DUT that reads its sensor every 200 ms is
then always caught, where a capture at once mostly missed it.

| Field | Type | Required | Default | Description |
|---|---|---|---|---|
| `instance` | string | yes | | A running I2C instance. |
| `samples` | integer | no | 256 | Packed bytes to return, 1..4096 (4 samples per byte). |
| `sample_rate_mhz` | number | no | the highest rate | Sample rate. |
| `trigger` | string | no | `"start"` | `"start"`: wait for the bus's next START, as above. `"none"`: capture at once (the behavior of firmware 3.10.3 and earlier). |
| `timeout_ms` | integer | no | 2000 | How long `"start"` waits, 1..600000. |

While it waits the emulation keeps running (the DUT's reads and writes are answered as usual) and
the pod answers other commands; the ones that need the capture engine or its buffer (other captures, `sensor_regs`, `load`) answer `busy`. When nothing happens on
the bus in time the reply is the error
`"trigger timeout: no falling edge on LA2 (SDA of env) within 2000 ms; the DUT did not use the I2C bus"`
(the `trigger timeout:` form of the other captures).

The data comes back chunked like the other sample arrays (a stream connection: not over the cloud
command channel), one byte per four samples, oldest first in the high bits: bit7 SCL(s0), bit6
SDA(s0), bit5 SCL(s1) ... bit0 SDA(s3), the format of the earlier single-sensor `sensor_la`. The
first chunk carries `"la_rate_hz"` (the rate the capture ran at) and, with `"start"`, the last chunk
carries `"trigger":{"la":2,"edge":"falling","fired":true}`. When the START came sooner after the
request than the pre-trigger part covers, the samples before the capture began repeat the level
the bus had then. `status` `caps` lists `"sensor_la_trigger"` on firmware that takes `trigger` and
`timeout_ms`; older firmware ignores both fields and captures at once.

SPI and UART instances are refused
(`"sensor_la captures I2C sensors only; use la_capture for the pins of acc"`): capture their pins
with [`la_capture`](#la_capture--deep-raw-logic-analyzer-capture).

### Removed in firmware 3.10.3

User-defined sensors replaced the built-in single-sensor commands. Firmware 3.10.1 and earlier still
have them (their documentation is `docs/API.md` at the `v3.10.1` tag).

| Removed | Replaced by |
|---|---|
| `sensor_start` with `type`, `addr`, `sda`, `scl` (one built-in model: `bmp280`, `bme280`, `sht4x`, `mpu6050`) | [`sensor_define`](#sensor_define--upload-and-compile-a-definition) with the model's definition from the sensor library, then [`sensor_start`](#sensor_start--start-an-instance) with `instance`, `address` and `pins` |
| `sensor_set` without `instance` | `sensor_set` with `instance` |
| `sensor_stop` without `instance` | `sensor_stop` with `instance` |
| `sensor_status` (the one sensor and its bus counters) | `sensor_status` (every instance) |
| `sensor_regs` without `instance` (a chunked uint8 array) | `sensor_regs` with `instance` (one reply, `data_b64`) |
| `sensor_la` without `instance` | `sensor_la` with `instance` |
| `sensor_types` | the sensor library (`embeddedci-com/benchpod-sensors`): each definition lists its values and ranges |
| `gps_start`, `gps_set`, `gps_stop`, `gps_status` | the library's `gps_nmea` definition with `sensor_define`, `sensor_start` (a UART instance), `sensor_set` (the fix), `sensor_stop` and `sensor_status` |
| capability `i2c_sensor` | `sensors` |
| capability `sensor_types` | `sensors` (and `sensors_format`) |
| capability `gps` | `sensors` with `sensors_digital` (UART sensors need the emulation image) |

## Device Identity (Ed25519)

Each unit owns a stable **Ed25519 keypair** that serves as its device identity. The private key is generated on the device the first time it boots (seeded from the STM32 hardware TRNG) and persisted to a dedicated flash sector. It survives firmware updates and `wifi_clear`/`cloud_clear`. The device only ever **signs**; the private key never leaves the unit.

The firmware never replaces the key on its own. The one way to erase it and make a new one is the USB console's `identity-wipe <short id>` (physical presence; `benchpod identity wipe --connection usb`), after which the pod must be registered again. Over the LAN and the cloud, `{"cmd":"identity_wipe"}` is always refused with `identity_wipe: only on the pod's USB console (physical presence): benchpod identity wipe --connection usb`.

Two operations are exposed: fetch the **public key** (the identifier), and produce a **proof of possession** — a signature over a caller-supplied nonce that proves the unit holds the private key matching that public key.

### Encoding of binary fields

All binary values — the public key, the nonce you send, and the signature returned — are **base64url without padding** (RFC 4648 §5; alphabet `A–Z a–z 0–9 - _`, no `=`).

| Field | Raw size | base64url length |
|---|---|---|
| Public key | 32 bytes | 43 chars |
| Signature | 64 bytes | 86 chars |
| Nonce (input) | 1–128 bytes | up to ~171 chars |

Language notes:

- **Go:** encode/decode with `base64.RawURLEncoding`. Verify a proof of possession with stock `crypto/ed25519` — no extra dependencies — but verify over the domain-separated message, not the bare nonce: `ed25519.Verify(pub, append([]byte("benchpod-pop:v1\x00"), nonce...), sig)`. See [Standard, interoperable Ed25519](#standard-interoperable-ed25519).
- **Python:** `base64.urlsafe_b64encode(...).rstrip(b"=")` to send; to decode a returned value, re-pad to a multiple of 4 with `=` before `base64.urlsafe_b64decode(...)`.

### Standard, interoperable Ed25519

The signature is **RFC 8032 Ed25519 (SHA-512)** — the same scheme Go's `crypto/ed25519` and standard JWT/JOSE `EdDSA` verifiers expect. It is **not** an encrypted blob: Ed25519 cannot encrypt. The "proof of possession" is a detached signature that you verify against the public key. No nonce state is kept on the device — every `identity_pop` is independent, so the caller is responsible for nonce freshness/uniqueness.

**The signed message is domain-separated — verify over the prefixed message, not the bare nonce.** The device signs

```
"benchpod-pop:v1" || 0x00 || <decoded nonce bytes>
```

That is, the ASCII context string, a single NUL byte, then your nonce. The NUL separator keeps the encoding unambiguous. Cloud WebSocket authentication uses the same construction with the context `benchpod-ws-auth:v1`, which is what stops a LAN-obtained proof from being replayed as a cloud login (see [Security model](#security-model)). A verifier that passes the bare nonce to `ed25519.Verify` will always fail.

### `identity_public` — fetch the device public key

No parameters.

#### Request

```json
{"cmd":"identity_public"}
```

#### Response

```json
{"status":"ok","data":{"public":"ue5UfSsOAhQYZ332ELokjOI8-uyjcbrd1ic3Nmypvzk"}}
```

| Field | Type | Description |
|---|---|---|
| `public` | string | The device Ed25519 public key, base64url (43 chars, decodes to 32 bytes) |

The same key is also printed on the UART debug console at boot (`[id] device public key (ed25519): …`).

### `identity_pop` — proof of possession

Sign a caller-supplied nonce with the device private key and return the signature.

#### Request

```json
{"cmd":"identity_pop","nonce":"<base64url-nonce>"}
```

| Field | Type | Required | Description |
|---|---|---|---|
| `nonce` | string | yes | Random challenge, base64url-encoded. Decoded length must be 1–128 bytes. |

#### Response

```json
{"status":"ok","data":{"signature":"hZ8…(86 chars)…Qq"}}
```

| Field | Type | Description |
|---|---|---|
| `signature` | string | Ed25519 signature over `"benchpod-pop:v1" \|\| 0x00 \|\| <decoded nonce>`, base64url (86 chars, decodes to 64 bytes) |

#### Verifying (Go)

```go
pub, _ := base64.RawURLEncoding.DecodeString(publicField)    // 32 bytes
sig, _ := base64.RawURLEncoding.DecodeString(signatureField) // 64 bytes

// The device signs the DOMAIN-SEPARATED message, not the bare nonce:
//     "benchpod-pop:v1" || 0x00 || nonce
msg := append([]byte("benchpod-pop:v1\x00"), nonceBytes...)  // nonceBytes = the raw nonce you sent
ok := ed25519.Verify(pub, msg, sig)
```

#### Error cases

| Condition | Message |
|---|---|
| `nonce` field missing | `"missing nonce"` |
| `nonce` not valid base64url, or decodes to 0 or > 128 bytes | `"invalid nonce"` |
| Identity not initialised (should not occur after boot) | `"identity not available"` |

### SCPI equivalents

The same socket also speaks SCPI (a connection is routed to SCPI when its first byte is not `{`). The identity operations are available as:

| SCPI | Equivalent JSON | Result |
|---|---|---|
| `SYSTem:IDENtity:PUBlic?` | `identity_public` | base64url public key (unquoted token) |
| `SYSTem:IDENtity:POP? "<base64url-nonce>"` | `identity_pop` | base64url signature (unquoted token) |

```
SYSTem:IDENtity:PUBlic?
ue5UfSsOAhQYZ332ELokjOI8-uyjcbrd1ic3Nmypvzk

SYSTem:IDENtity:POP? "Q2hhbGxlbmdlMTIz"
hZ8…(86 chars)…Qq
```

A bad or out-of-range nonce pushes SCPI error `-224 "Illegal parameter value"` (retrievable via `SYSTem:ERRor?`).

`SYSTem:IDENtity:POP?` returns the same domain-separated signature as the JSON `identity_pop` — verify it over `"benchpod-pop:v1" || 0x00 || <nonce>`.

### SCPI capture, replay & trace upload

The capture / replay / waveform-upload features have SCPI equivalents that reuse the standard `SOURce`/`SENSe`/`OUTPut`/`TRACe` subsystems. Bulk samples are returned as ASCII CSV (not a JSON array).

| SCPI | Equivalent JSON | Notes |
|---|---|---|
| `SENSe:SRATe <MHz>` / `?` | `capture` `sample_rate_mhz` | ADC capture clock; `0` = max ~400 kSPS (24 MHz ÷ divider, divider ≥ 60). Lower stretches the window (e.g. `0.08` → 80 kS/s → 32768 samples ≈ 410 ms). |
| `SENSe:SWEep:POINts <n>` / `?` | `capture` `samples` | Default acquisition length for `READ?`. |
| `READ? [<n>]` | `capture` | Capture `n` (or the `POINts` default) samples at `SENSe:SRATe` and return CSV. Also loads the replay buffer (its first 2048 samples, the DAC BRAM size). |
| `TRACe[:DATA] <offset>,"<base64url>"` | `load` | Upload one chunk of a replay waveform: 16-bit little-endian samples (2 bytes each, as the JSON `load`), at most 4096 bytes. `offset` is in bytes. Send `offset` 0 first, then successive offsets (≤150 bytes/chunk to fit the 256-byte line). |
| `TRACe:POINts?` | — | Number of 16-bit samples currently loaded for replay. |
| `SOURce:FUNCtion USER` + `OUTPut ON` | `replay` | Play the captured/uploaded buffer out the DAC (loops). Playback rate = `SOURce:SRATe`. |
| `OUTPut OFF` | `dac_stop` | Stop the DAC (a looped replay or any waveform). |

`SOURce:FUNCtion` now accepts `USER` alongside `SINusoid`/`SQUare`/`RAMP`. `OUTPut ON` with `USER` selected and an empty buffer pushes `-200 "Execution error"`.

The replay buffer is the pod's one RAM sample buffer, shared with the JSON commands. A JSON `capture`, `stream`, `test`, `load` or `load_bin` (to RAM) fills it, after which the SCPI trace is gone: `OUTPut ON` with `USER` pushes `-200` and `TRACe:POINts?` answers `0` until the next `READ?`, `MEASure?` or `TRACe:DATA`. The reverse holds too: after a SCPI capture or upload, a JSON `replay` of a RAM upload answers `nothing to replay`. `TRACe:DATA` takes the same capture lock as `READ?`, so it pushes `-200` while a capture or upload is running.

SCPI gets the same safe-mode and digital-board refusals as the JSON commands. In safe mode (the iCE40/PSRAM are off) `OUTPut`, `READ?`, `MEASure?`, `DIAGnostic:CAPture?`, `TRACe:DATA` and `DIGital:*` push `-240 "Hardware error"`; on the digital-only board `OUTPut ON`, `READ?`, `MEASure?`, `TRACe:DATA` and a `DIAGnostic:CAPture?` with ADC samples push `-241 "Hardware missing"`. `SYSTem:ERRor?` carries the same text as the JSON refusal. The `SOURce`/`SENSe` settings, `DIAGnostic:PATTern?`, identity, network and target power keep working. `OUTPut OFF` is refused in safe mode too (it maps to `dac_stop`), but works on the digital-only board.

```
# Record a slow trace, then replay it straight back out the DAC
SENSe:SRATe 0.08
SENSe:SWEep:POINts 4096
READ?                       → 142,139,141,...      (also fills the replay buffer)
SOURce:SRATe 0.08
SOURce:FUNCtion USER
OUTPut ON                   # DAC now loops the recorded trace
OUTPut OFF                  # stop

# Replay a previously saved trace (upload first, in base64url chunks)
TRACe:DATA 0,"<base64url chunk 0>"
TRACe:DATA 150,"<base64url chunk 1>"
TRACe:POINts?               → 150      (300 bytes = 150 samples)
SOURce:FUNCtion USER
OUTPut ON
```

---

## Closed-loop DAC, gateware images and PSRAM

The closed-loop DAC is described in full in [dac-control-loop.md](dac-control-loop.md); the
commands are summarized here. They need the analog front end and the loop gateware image
(`status.caps` `"dac_control_loop"`).

### `dac_control_loop` — arm the closed-loop DAC

The iCE40 reads the ADC every tick, looks the reading up in a 2048-point curve and moves the DAC
toward it. `dac_stop` disarms the loop.

```json
{"cmd":"dac_control_loop","k":32767,"vmin":0,"vmax":65535,"tick_div":64,"curve":"<b64url>","source":"adc"}
```

| Field | Type | Default | Description |
|---|---|---|---|
| `curve` | string (base64url) | the curve already loaded | 16-bit little-endian points; the firmware stretches a short curve to the 2048-entry table |
| `k` | integer | `8192` | Loop gain, Q15 (clamped to 32767) |
| `vmin`, `vmax` | integer 0..65535 | `0`, `65535` | Output clamp in DAC codes; `vmin > vmax` is refused |
| `tick_div` | integer | `64` | Loop tick divider (clamped to at least 8) |
| `source` | string | `"adc"` | Gateware v29+: `"adc"` (closed loop), `"fixed"` (hold `input`) or `"sweep"` (add `step` every tick) |
| `input`, `step` | integer | `0` | The fixed input and the sweep step for the open-loop sources |
| `in_mv_per_unit`, `in_mv_at_zero`, `in_min`, `in_max`, `in_trip` | number | none | Gateware v30+ input map in engineering units; `in_trip` parks the output at `vmin` past that level |

The reply echoes the effective values: `{"armed":true,"k":..,"vmin":..,"vmax":..,"tick_div":..,"curve_pts":..,"source":"adc","input":0,"step":0}`, plus `in_zero`, `in_gain`, `idx_max` and `trip_idx` when an input map is set.

Errors: `"control loop needs gateware v23+"`, `"loop input sources need gateware v29+"`,
`"loop input map needs gateware v30+"`, `"unknown loop input source (use adc, fixed or sweep)"`,
`"curve base64 decode failed"`, `"curve needs at least one 16-bit point"`, the parameter checks
(inverted window, zero-step sweep), `"sweep cannot be combined with an input map on this
gateware: ..."`, `"control loop not in the running gateware image (switch with
{"cmd":"fpga_image","image":0})"` and `"control loop arm failed"`.

### `dac_loop_input` — retarget a running loop

Changes the loop's input source or value without re-arming or re-uploading the curve (gateware v29+).
Fields left out keep their value.

```json
{"cmd":"dac_loop_input","input":32768}
{"cmd":"dac_loop_input","source":"sweep","step":16}
```

Reply: `{"source":"fixed","input":32768,"step":0,"v":<DAC code at the moment of the write>}`. Poll
`dac_loop_probe` for the settled value. Errors: `"loop input sources need gateware v29+"`,
`"unknown loop input source (use adc, fixed or sweep)"`, the parameter checks, the image refusal
and `"loop input update failed"`.

### `dac_loop_probe` — one live operating point

```json
{"cmd":"dac_loop_probe"}
```

Reply: `{"i":<raw ADC count>,"in":<what the loop indexed with>,"source":"adc","v":<DAC code>,"tripped":false}`.
Plot against `in`, not `i`: in a fixed or sweep run the ADC is not in the path. `tripped` is the
latched over-range trip (the output then sits at `vmin` until the loop is disarmed). On the
deep-replay image it answers `"closed-loop DAC not in the running gateware image (switch with
{"cmd":"fpga_image","image":0})"`.

### `fpga_image` — switch the running gateware image

The iCE40 has three images: `0` or `"loop"` (the closed-loop DAC), `1` or `"deep"` (deep DAC
replay from PSRAM) and, from gateware v54, `2` or `"emulation"` (the
[emulated sensors](#emulated-sensors): I2C and SPI targets, the sensor FIFO, UART2). Each lives in
its own W25Q slot (`gw0`, `gw1`, `gw2`). The switch reflashes the iCE40's configuration from the
slot and reconfigures it, which takes 2 to 3 seconds. The pod then announces its new capabilities
to the cloud, and puts an external output stage back on its park level when DAC limits are set.
`sensor_start` loads the emulation image by itself; nothing switches back by itself.

```json
{"cmd":"fpga_image","image":"emulation"}
{"cmd":"fpga_image"}
```

Reply: `{"image":2,"name":"emulation","version":54,"features":4}`; without `image` it reports the
running one. `features` are the FPGA_FEATURES bits: 1 control loop, 2 deep replay, 4 emulation.

Errors: `"image must be 0 (loop), 1 (deep) or 2 (emulation)"`, `"the emulation image needs
gateware v54 or later"`, `"image 2 is not installed on the pod (W25Q slot gw2 is empty): install the
gateware blobs"`, `"image switch refused: the emulated sensors env, imu need the emulation image;
stop them first ({"cmd":"sensor_stop","all":true})"`, `"image switch: reflash failed (CDONE never
rose)"`, `"image switch: iCE40->PSRAM write inoperable after retries (run psram_recover: the pod
restarts and reloads the iCE40)"`, `"image switch failed"` and `"busy"`.

### `psram_ping` — check the iCE40 to PSRAM write path

The iCE40 writes a known ramp through the real capture datapath into PSRAM and the STM32 reads it
back. A failure points at the iCE40 to PSRAM write path, not at the analog ADC.

```json
{"cmd":"psram_ping","count":16}
```

`count` is 4..256 (default 16). Reply: `{"pass":true,"count":16,"first_bad":-1}`.

### `psram_recover` — reboot to recover the PSRAM

When `status.psram_ok` is `false`, this acks with `{"recover":"rebooting"}` and reboots the pod
about 0.4 s later; the boot self-test reloads the iCE40 from its config flash and brings the
datapath back without a power cycle. The config flash is rewritten only when the image in it no
longer matches a gateware slot, so reboots do not wear it.

**The iCE40 recovers by itself.** When the pod is idle the firmware pings the iCE40 every 30 s.
One that answered since boot and stops answering (an ESD hit can hang or unconfigure it) is reloaded
from its config flash (no write) after 10 s, at most 6 times an hour; the DAC outputs are parked as
at boot. It never resets the STM32 for this, since that would also power-cycle the DUT. The device
log says what it did. Over the cloud the reply may not arrive before the reboot: treat "no reply, the pod
reconnects" as success and check `status.psram_ok` again.

---

## CAN

Classic CAN and CAN FD on FDCAN1 with the TCAN1044 transceiver, on J1 pins 19 (`CAN+`) and 20
(`CAN−`). Every CAN command is a single reply, so all of them work over the cloud command channel,
and they keep working in safe mode. Frame IDs and data bytes accept decimal or `0x` hex.

**CAN FD** (firmware 3.10.2 and later, capability `can_fd`): give `can_config` a `data_bitrate`.
Frames then carry up to 64 data bytes, and with a `data_bitrate` above `bitrate` their data phase
runs at the faster rate (bit-rate switching). Without `data_bitrate` the bus is classic CAN, as
before.

### `can_config` — bring CAN up

```json
{"cmd":"can_config","bitrate":500000,"mode":"normal","term":true}
```

| Field | Type | Default | Description |
|---|---|---|---|
| `bitrate` | integer | `500000` | Bit rate in bit/s (the arbitration rate on CAN FD); one that has no exact bit timing is refused |
| `data_bitrate` | integer | none | Turns CAN FD on: the data-phase bit rate in bit/s, from `bitrate` up to 8000000. Above `bitrate` frames switch to it after arbitration; equal to `bitrate` gives FD frames without switching. Rates with exact timing work, for example 1, 2, 4, 5 and 8 Mbit/s; 3 or 6 Mbit/s are refused |
| `mode` | string | `"normal"` | `normal`, `listen` (receive only), `internal` (internal loopback) or `external` (loopback through the transceiver); the loopback modes let a single pod test itself |
| `term` | boolean | `false` | Switch the 120 Ω termination on |

```json
{"cmd":"can_config","bitrate":500000,"data_bitrate":2000000,"mode":"normal","term":true}
```

Reply: `{"bitrate":500000,"data_bitrate":0,"fd":false,"mode":"normal","term":true}` (`data_bitrate`
is 0 on classic CAN). Errors: `"mode must be normal|internal|external|listen"`, `"unsupported
bitrate (no exact bit timing)"`, `"unsupported data_bitrate (no exact bit timing at 80 MHz; 1, 2,
4, 5 and 8 Mbit/s work)"`, `"data_bitrate must be from bitrate up to 8000000"`, `"can init
failed"`.

The pod sets the bit timing itself: a sample point of about 87.5 % on classic CAN; on CAN FD 80 %
in the arbitration phase and 80 % (up to 2 Mbit/s) or 75 % (above) in the data phase, with
transmitter delay compensation on, as CiA 601-3 recommends. A CAN FD peer should use the same
sample points.

### `can_write` — send one frame

```json
{"cmd":"can_write","id":291,"ext":false,"rtr":false,"data":[1,2,3]}
```

`id` is required; `ext` selects a 29-bit ID, `rtr` a remote frame, and `data` holds up to 8 bytes
on classic CAN, up to 64 on CAN FD. On a CAN FD bus a frame is an FD frame with bit-rate switching;
`"fd":false` sends a classic frame instead (to talk to a classic node on the same bus), `"brs":false`
keeps an FD frame's data phase at `bitrate`. CAN FD payloads are 0 to 8, 12, 16, 20, 24, 32, 48 or
64 bytes: another length is padded with zeros up to the next one. A remote frame (`rtr`) is always
classic, as CAN FD has none.

Reply: `{"id":291,"ext":false,"dlc":3,"fd":false,"brs":false}`, where `dlc` is the number of data
bytes sent (after padding). Errors: `"missing id"`, `"can not enabled"`, `"bus off"`, `"tx failed
(fifo full?)"`, `"data is longer than 64 bytes"`, `"more than 8 data bytes needs CAN FD (can_config
with data_bitrate)"`, `"more than 8 data bytes needs an FD frame"`, `"rtr needs a classic frame (CAN
FD has no remote frames)"`.

### `can_read` — drain received frames

```json
{"cmd":"can_read","max":8}
```

`max` is 1..8 (default 8). Reply: `{"frames":[{"id":291,"ext":false,"rtr":false,"fd":false,"brs":false,"dlc":3,"data":[1,2,3],"ts":12345}],"overflow":0,"pending":0}`.
`fd` and `brs` say whether the frame was a CAN FD frame and switched bit rate, `dlc` is the number
of data bytes. `overflow` counts frames dropped because the receive queue was full, `pending` the
frames still queued. A reply holds at most about five 64-byte FD frames (to fit a cloud reply), so
read again while `pending` is above 0. The queue holds about 50 classic frames or 13 64-byte FD
frames.

### `can_status` — state and counters

Reply: `{"enabled":true,"mode":"normal","bitrate":500000,"data_bitrate":0,"fd":false,"term":true,"tec":0,"rec":0,"bus_off":false,"error_passive":false,"rx_pending":0,"rx_overflow":0,"responder_rules":0,"responder_hits":0,"bus_off_recoveries":0}`.

### `can_term` — termination

`{"cmd":"can_term","on":true}` switches the 120 Ω termination, even while CAN is off. Reply
`{"term":true}`. Error: `"missing on"`.

### `can_respond` — automatic replies

Adds a rule so the pod answers a matching frame on its own (an ECU simulation), or clears all rules.
Up to 8 rules.

```json
{"cmd":"can_respond","match_id":2015,"ext":false,"reply_id":2024,"reply_ext":false,"reply_data":[2,80,3]}
{"cmd":"can_respond","clear":true}
```

`reply_rtr` sends a remote frame. `reply_data` holds up to 64 bytes; on a CAN FD bus the reply is an
FD frame with bit-rate switching unless `"reply_fd":false` (classic) or `"reply_brs":false`, as for
[`can_write`](#can_write--send-one-frame). An FD reply is only sent while the bus runs CAN FD.
Reply: `{"rule":0,"rules":1}`, or `{"rules":0}` after a clear. Errors: `"missing match_id"`,
`"missing reply_id"`, `"responder table full"`, `"invalid reply frame"`, and the `can_write` data
errors.

### `can_disable` — turn CAN off

Reply `{"enabled":false}`.

---

## Analog module (digital v3r3)

From digital v3r3 the BenchPod is two boards: the digital core board and an analog module that
plugs into it over a 24-pin FFC. The module carries the DAC (a DAC8554, as on analog v3r2), the
ADC, the analog switching expander (U58) and a 24C32 EEPROM for its ID and calibration. Its I2C
devices sit on their own bus (the STM32's I2C2). Firmware 3.9.5 and later:

- recognises digital v3r3 at boot by its module-link pins (the revision strap is the v3 one),
- finds the module when it is plugged in (`MOD_PRESENT#` low) and U58 answers on the module bus.
  `status.analog` is then `true` and every analog command works as on analog v3r2, with the
  v3r2 calibration set until the module's own is used. Without a module, digital v3r3 behaves as
  the digital-only board. Detection runs at boot: restart the pod after plugging the module in,
- reads the module EEPROM at boot,
- reports the module and the two rails it switches in `status.module` and `module`.

The one-piece analog boards (analog v3r1, v3r2) and the earlier digital boards are not affected.

### `module`: the analog module and its EEPROM

```json
{"cmd":"module"}
```

```json
{"status":"ok","data":{"present":true,"analog":true,"power":true,"bridge_power":true,
 "eeprom":"ok","type":"analog","rev":"1.0","serial":"AM-000123","layout":1,"cal_len":0,"cal_ok":false}}
```

| Field | Type | Meaning |
|---|---|---|
| `present` | boolean | A module is plugged in now (`MOD_PRESENT#`, read live). |
| `analog` | boolean | The module was found at boot and is the pod's analog front end. |
| `power`, `bridge_power` | boolean | The module's 5 V rail and the USB-A bridge port rail are on. See [`module_power`](#module_power--module-and-bridge-port-power). |
| `eeprom` | string | The EEPROM header: `"ok"`, `"blank"` (never written), `"bad magic"`, `"bad crc"`, `"bad length"`, or `"none"` (no EEPROM answered, or no module at boot). |
| `type`, `rev`, `serial` | string | With `eeprom` `"ok"`: the module type (`"analog"`), its hardware revision and serial number. |
| `layout` | integer | The header's layout version (1). |
| `cal_len`, `cal_ok` | integer, boolean | The stored calibration blob's length in bytes (0 = none), and whether its CRC matched when it was last read. |

`status.module` has the first five fields only.

The EEPROM forms need a module plugged in with its power on. Reads are T0, writes T2 (they persist
settings on the module):

| Request | Does |
|---|---|
| `{"cmd":"module","eeprom":"read","addr":256,"len":32}` | Raw read, 1 to 128 bytes. Reply `{"addr":256,"len":32,"data":"<hex>"}`. |
| `{"cmd":"module","eeprom":"write","addr":256,"data":"<hex>"}` | Raw write of 1 to 64 bytes into the calibration area, `0x100` to `0xfff`. Reply `{"addr":256,"len":N}`. |
| `{"cmd":"module","eeprom":"id","type":"analog","rev":"1.0","serial":"AM-000123"}` | Write the ID fields (`type` defaults to `"analog"`, `serial` up to 16 characters) and keep the calibration fields. Replies with the module object. |
| `{"cmd":"module","eeprom":"cal_commit","len":300}` | Record the first `len` bytes of the calibration area as the calibration blob: their length and CRC go into the header (0 clears it). Replies with the module object. |

Errors: `module: this BenchPod has no module link (digital v3r3 only)` on any other board, and
`module: no module plugged in, or module power is off` for the EEPROM forms.

EEPROM layout, version 1 (little endian):

| Address | Bytes | Content |
|---|---|---|
| `0x000` | 4 | Magic `"BPMD"` |
| `0x004` | 1 | Layout version (1) |
| `0x005` | 1 | Header length (32). A later layout may grow it; the header CRC is always its last two bytes. |
| `0x006` | 1 | Module type (1 = analog) |
| `0x007` | 2 | Hardware revision, major and minor |
| `0x009` | 1 | Reserved (0) |
| `0x00a` | 16 | Serial number, NUL padded |
| `0x01a` | 2 | Calibration length in bytes |
| `0x01c` | 2 | Calibration CRC-16/CCITT-FALSE |
| `0x01e` | 2 | Header CRC-16/CCITT-FALSE over bytes `0x000` to `0x01d` |
| `0x020` | 224 | Reserved |
| `0x100` | up to 3840 | Calibration blob: the module's ADC/DAC calibration (below). Its length and CRC are in the header. |

The calibration blob (firmware 3.10.1+), little endian:

| Offset | Bytes | Content |
|---|---|---|
| 0 | 4 | Magic `"ACAL"` |
| 4 | 2 | Record version (2) |
| 6 | 2 | Record length in bytes (116 for version 2) |
| 8 | 116 | The calibration record, the same bytes the pod keeps in its own flash |

The calibration belongs to the analog front end, so on digital v3r3 it lives on the module:

- every [`calibrate`](#calibrate--calibrate-the-adc-offset-on-the-current_in-input-j8) save (the J8 zero, the DMM-guided DAC
  lines and ADC gains, the frequency-response record, a clear) writes the pod's flash and then the
  module's blob. The header's calibration fields are dropped first, so a write cut short leaves no
  old blob that still checks out. When the module write fails the pod keeps the new calibration and
  `calibrate` answers `calibrate: saved on the pod, but not in the analog module's EEPROM (is the module
  plugged in and powered?)`;
- at boot the module's record is loaded when its blob is valid, so a module moved to another digital
  board brings its calibration along. A module with no blob yet (calibrated with older firmware, or
  never) gets the pod's record copied to it; an unreadable blob or one of another record version is
  left alone and the pod's record is used.

`calibrate` reports where the calibration in use is kept in `stored`.

### `module_power`: module and bridge port power

Digital v3r3 switches two 5 V rails: the analog module's (about 1.45 A limit) and the always-on
USB-A bridge port (about 1 A limit). Both are on from power-up.

```json
{"cmd":"module_power","module":false}
{"cmd":"module_power","bridge":true}
{"cmd":"module_power"}
```

Reply `{"module":true,"bridge":true}`, the state after the change. Turning the module off stops
the DAC and the +-14 V supply first. Turning it back on sets up U58 again (relays off), parks the
DAC outputs and switches the +-14 V supply on, as at boot; if U58 does not answer, the reply is
`module_power: module power is on, but U58 does not answer`. While the module is off, the analog
commands fail. Refused on other boards with `module_power: this BenchPod has no module link
(digital v3r3 only)`.

---

## Network and cloud

The cloud and Wi-Fi settings are T2: on a locked LAN they need the cloud or the USB console. They
work in safe mode, so a pod can always be put back on the network.

### `cloud_status`

Reply: `{"state":"connected","last_error":"","configured":true,"host":"www.embeddedci.com","port":443,"tls":true,"verify":true,"device_id":"<uuid>"}`.
`state` is `disabled`, `waiting-wifi`, `connecting`, `connected` or `backoff`. `waiting-wifi` waits
for an Ethernet or Wi-Fi address, or for the USB network link with a proxy set (the link has no
router, so the cloud rides `benchpod usb-bridge` on the computer).

### `cloud_set` — store the cloud settings

`benchpod register` sends this once; the pod then connects on its own at every boot.

```json
{"cmd":"cloud_set","host":"www.embeddedci.com","port":443,"tls":true,"device_id":"<uuid>","enabled":true}
```

| Field | Type | Default | Description |
|---|---|---|---|
| `host` | string | required | Server host name |
| `device_id` | string | required | The id embeddedci.com gave the pod |
| `port` | integer | `443` with TLS, else `80` | |
| `tls` | boolean | `false` | Release firmware refuses `false` |
| `enabled` | boolean | `true` | |

TLS always verifies the server certificate and host name; a `verify` field is ignored. The pod
reconnects after the reply. Reply: the stored settings. Errors: `"missing host"`, `"host too long"`,
`"missing device_id"`, `"device_id too long"`, `"cloud_set: release firmware needs "tls":true
(plain ws is for development builds)"`, `"config save failed"`.

### `cloud_clear`

Forgets the cloud settings and disconnects. Reply `"cleared"`.

### `wifi_status`

Reply: `{"state":"connected","configured":true,"connected":true,"ssid":"lab","xacts":..,"pump_calls":..,"batch":[..],"settle_hit":..,"settle_miss":..,"xact_err":..,"c3_lost_noresp":0,"c3_lost_reboot":0,"c3_restarts":{"total":0,"no_response":0,"rebooted":0,"no_boot":0,"setup":0,"assoc":0,"flash":0,"boots":1},"c3_nvs":"none"}`.
`state` is the same as `status.wifi`; the counters describe the link to the ESP32-C3 and how
often it was lost (`c3_lost_*`: since this boot).

`c3_restarts` (firmware 3.10.1+) counts every time the pod restarted the C3 from reset since
power-on, by cause. The counts survive software and watchdog resets and OTA updates; a power-on
or the reset pin sets them to 0, and `boots` counts the boots they cover (1: this boot only).

| Cause | The pod restarted the C3 because |
|---|---|
| `no_response` | it stopped answering while the link was up (3 RSSI requests in a row) |
| `rebooted` | it announced a new boot in the middle of the session (it reset by itself) |
| `no_boot` | it never announced a boot after its reset was released |
| `setup` | a setup step (init, storage, mode, config, start, connect, MAC) failed or timed out |
| `assoc` | the access point did not take the association (wrong password, out of range) |
| `flash` | its automatic flash from the `esp` slot failed or could not be queued |

After the first restart the object adds `last` (the reason, at most 39 characters),
`last_cause`, `last_uptime_s` (the uptime of the boot that did it) and `last_this_boot`. The pod
also sends `c3_restarts` and `c3_restart_last` (the last cause) in the capabilities it sends
embeddedci.com on every connect. `c3_nvs` is the outcome of the last `wifi_clear` since boot on the ESP32-C3's
side (see below): `none` (no `wifi_clear` yet), `pending`, `erased` or `failed`.

### `wifi_scan` — the networks the pod's Wi-Fi sees

For a Wi-Fi picker: the networks in range, to choose the SSID for `wifi_set`. The pod scans with
its own Wi-Fi, or with a Wi-Fi bridge when one is plugged in, and answers in
the same format either way. Pods that list `wifi_scan` in `caps` have it (firmware 3.9.4+).

A scan takes a few seconds, and the pod keeps answering other commands meanwhile, so it is two
steps: start it, then read it with the `id` the first reply gave.

```json
{"cmd":"wifi_scan"}
{"cmd":"wifi_scan","id":3}
```

The first form starts a scan (or joins the one already running) and answers at once:

```json
{"state":"scanning","id":3,"via":"built-in"}
```

The second form answers `"scanning"` again until the scan is over, then:

```json
{"state":"done","id":3,"via":"built-in",
 "networks":[{"ssid":"lab","rssi":-48,"channel":6,"auth":"wpa2/wpa3"},
             {"ssid":"guest","rssi":-71,"channel":11,"auth":"open"}],
 "truncated":false}
```

Read it every half second or so; a scan is normally done within 5 seconds. `networks` is strongest
first, one entry per network (the strongest access point of a network that has several), at most
20; a hidden network has an empty `ssid`. `rssi` is in dBm. `auth` is `open`, `wep`, `wpa`, `wpa2`,
`wpa/wpa2`, `wpa2-ent`, `wpa3`, `wpa2/wpa3`, `wapi`, `owe` or `other`. The list is cut to fit one
cloud reply; `truncated` is `true` when weaker networks were left out for that. With a Wi-Fi bridge,
the first form waits for the bridge and answers `"done"` (`"via":"wifi-bridge"`, `"id":0`) at once.

How the pod scans depends on its Wi-Fi state:

- **Joined:** the Wi-Fi radio scans alongside the connection; the pod stays joined, and traffic
  over Wi-Fi (the cloud link among it) pauses for moments while the radio visits other channels.
- **Not configured, or a failed join:** the radio is switched on for the scan alone and off again
  afterwards. USB networking is not affected.
- **Joining:** the scan waits for the join to finish (up to 30 seconds).

Errors: `"wifi_scan: <why>"`, for example `"wifi_scan: Wi-Fi is still connecting; try the scan
again in a moment"`, `"wifi_scan: the ESP32-C3 is being flashed or erased; try again when that is
done"`, or `"wifi_scan: no scan with that id; start one with {"cmd":"wifi_scan"}"` (an `id` the pod
never gave out, for example after a reboot). On digital v3r3, which has no ESP32-C3, the read form
fails at once with `"wifi_scan: no Wi-Fi module: this BenchPod has no built-in Wi-Fi"` (firmware
3.9.5+). With a bridge: `"Wi-Fi bridge: <why>"`. The same scan
is `wifi-scan` on the [USB console](usb-serial-interface.md).

### `wifi_set` / `wifi_clear`

```json
{"cmd":"wifi_set","ssid":"lab","password":"secret"}
{"cmd":"wifi_clear"}
```

Wired Ethernet stays the primary link; Wi-Fi is the fallback: with both up, `status.ip` is the
Ethernet address and outgoing traffic uses Ethernet. Wi-Fi and the [USB network
adapter](usb-serial-interface.md#usb-network-adapter) are one or the other: `wifi_set` turns USB
networking off (the reply may still go out over it), and `wifi_clear` turns it back on. An empty or
missing `password` is an open network. `wifi_set` replies `{"ssid":"lab"}` and reconnects after the reply; `wifi_clear`
replies `"cleared"` and drops Wi-Fi after the reply. Errors: `"missing ssid"`, `"ssid too long"`,
`"password too long"`, `"config save failed"`.

**Digital v3r3 has no ESP32-C3** (firmware 3.9.5+). `wifi_set` answers `"no Wi-Fi module: this
BenchPod has no built-in Wi-Fi"` and saves nothing, `wifi_clear` clears the pod's copy only
(`c3_nvs` stays `none`), USB networking stays on, `status.wifi` is `absent`, and the pod never
drives the C3's pins or tries to flash it. Credentials stored on an older board are ignored. The same operations are `wifi-set` / `wifi-clear` on
the [USB console](usb-serial-interface.md).

**Where the credentials are kept.** In one place: the STM32's config store (two flash sectors,
A/B). The ESP32-C3 is put in RAM storage mode (`esp_wifi_set_storage(WIFI_STORAGE_RAM)`) before it
is given the Wi-Fi mode or the credentials, and it is given them again on every bring-up, so it
holds them only while it is powered and out of reset. If the C3 does not confirm RAM storage, the
pod does not send it the credentials and retries.

**What `wifi_clear` does.** Pod firmware up to 3.7.0 ran the C3 in the ESP-IDF default flash
storage mode, which wrote the SSID and password to the C3's own NVS partition as well. NVS only
marks a replaced or deleted entry as erased, so nothing short of erasing the sectors removes old
values. `wifi_clear` therefore wipes both copies:

1. At once, before the reply: the STM32's copy. A tombstone record is written, then the other slot
   and the legacy sector are erased, so a power loss part-way cannot bring an old config back.
2. After the reply has gone out and Wi-Fi is down (the reply may ride the Wi-Fi link): the C3's
   NVS partition (16 KB at `0x9000`, read from the partition table of the C3 image in the W25Q) is
   erased through the C3's ROM loader and read back blank (MD5 of the region computed by the C3).
   This takes about 3 seconds, and like `flash-esp32` it stops a running DAC waveform (the W25Q
   shares the PSRAM bus). The C3's application is untouched; it recreates an empty NVS on its
   next start. The C3 then stays in reset and Wi-Fi stays off until the next `wifi_set`.

`wifi_status` reports step 2 as `c3_nvs`: `pending`, then `erased`, or `failed` if the C3 did not
answer its ROM loader, the erase did not verify, the W25Q holds no C3 image, the pod is in safe
mode, or a capture, upload or update held the shared bus for a minute. After `failed`, send
`wifi_clear` again or run `flash-esp32` on the USB console (it rewrites the C3's whole image, NVS
region included). `wifi_clear` does not touch the device identity key, the cloud configuration
(`cloud_clear`) or calibration data.

**With a Wi-Fi bridge.** BenchPod v4 has no radio; a bridge box on the
Ethernet port carries Wi-Fi ([wifi-bridge/docs/PROTOCOL.md](../wifi-bridge/docs/PROTOCOL.md)).
Built-in Wi-Fi wins: while it is configured, the pod takes no address through a bridge, the
commands here and `wifi_scan` go to the built-in Wi-Fi, and `wifi_status` adds
`"bridge_ignored":true`. This holds even when the built-in Wi-Fi cannot join. Send `wifi_clear`
to use the bridge. Pairing and bridge updates carry on either way. Without built-in Wi-Fi configured, while a bridge says HELLO
on the Ethernet port, `wifi_set` stores the credentials on the bridge (reply
`{"ssid":"lab","via":"wifi-bridge"}`, the pod's own flash, USB networking and the ESP32-C3 are left
alone), `wifi_clear` clears them there (reply `"cleared"`), and `wifi_status` describes the bridge:

```json
{"state":"connected","configured":true,"connected":true,"ssid":"lab","via":"wifi-bridge",
 "bridge":{"mac":"24:0a:c4:00:00:03","fw":"0.1.0","hw":"A","paired":true,"problem":null,"update":"idle",
           "rssi_dbm":-58,"channel":6,"reason":0,"uptime_s":125,"status_age_ms":3200,
           "counters":{"eth_rx":812,"wifi_tx":790,"wifi_tx_err":0,"wifi_rx":1204,"eth_tx":1150,
                       "eth_tx_err":0,"dropped":76}}}
```

`state` is then the bridge's: `unconfigured`, `wait-pod`, `joining`, `connected`, `auth-failed` or
`no-ap`. The pod pairs with the bridge on first contact; `paired:false` with a `problem` such as
"the bridge is paired with another pod: press PAIR on the bridge" means the user has to press PAIR
on the bridge. Errors from the bridge come back as `"Wi-Fi bridge: <code>: <detail>"`.
`bridge.update` says what the pod's automatic bridge firmware update is doing (`"idle"`,
`"updating 0.1.0 to 0.2.0: 45%"`, `"updated to 0.2.0"`, `"update to 0.2.0 failed: ..."`); the
image comes from W25Q blob slot `bridge` (OTA target `bridge`, listed by `blob_status` in
development builds).

> **After updating from 3.7.0 or older:** the update alone does not erase what the older firmware
> stored on the C3. It stays in the C3's NVS (unused) until the first `wifi_clear` or
> `flash-esp32`. To keep Wi-Fi and still remove it: `wifi_clear`, then `wifi_set` again.

### `eth` — wired link control and diagnostics

| Request | Tier | Reply |
|---|---|---|
| `{"cmd":"eth","action":"stats"}` | T0 | `{"phy_ok":true,"link":true,"aneg_done":true,"phy_mode":"100FD","mac_mode":"100FD","rx_good":..,"rx_crc":..,"tx_good":..,...}` |
| `{"cmd":"eth","action":"refclk"}` | T0 | `{"hz":50000012,"ppm":0,"on_hsi":false}`: the PHY's 50 MHz RMII clock against the MCU crystal; drops the link for about 200 ms |
| `{"cmd":"eth","action":"stop"}`, `"start"`, `"restart"` (the default) | T2 | the action name; `start` and `restart` reset the PHY and get a new DHCP lease |
| `{"cmd":"eth","action":"speed","mbit":100,"duplex":"full"}` | T2 | `{"speed":100,"duplex":"full"}`; `mbit` `0` returns to autonegotiation, `duplex` defaults to half |
| `{"cmd":"eth","action":"loopback","mbit":100,"n":200}` | T2 | `{"mbit":100,"sent":200,"received":200,"intact":200,"corrupt":0,"crc":0,"align":0,"tx_fail":0}`: a PHY loopback test, `n` 1..1000 |

Errors: `"eth action must be stop|start|restart|stats|speed|refclk|loopback"`, `"eth speed needs
mbit (0 = autoneg, 10 or 100)"`, `"eth speed mbit must be 0 (autoneg), 10 or 100"`, `"eth loopback
mbit must be 10 or 100"`, `"eth loopback: timed out"`.

### `speedtest` — cloud throughput probe

Used by the server's speed test over a byte tunnel (`POST /api/benchpod/devices/{id}/speedtest`).

```json
{"cmd":"speedtest","dir":"up","bytes":1048576}
```

`bytes` defaults to 1 MiB and is capped at 64 MiB. `up` (the default): the pod sends `bytes`
synthetic bytes, then `{"speedtest":"done","bytes":N}`. `down`: the pod counts and discards the
next `bytes` bytes, acking every 8 KB with `{"speedtest":"ack","bytes":N}` and finishing with
`{"speedtest":"done","bytes":N}`.

---

## Firmware and blob updates (OTA)

An update is staged in PSRAM, checked (SHA-256, signature, fit) and only then written. The
firmware itself goes to the MCU flash; the blob targets go to slots in the W25Q flash: `gw0` and
`gw1` (the two iCE40 images), `esp` (the ESP32-C3 Wi-Fi image) and `ca` (a company CA, see
[`cloud_ca`](#cloud_ca--cloud_proxy-company-ca-and-http-proxy-for-the-cloud-link)). Over the
cloud the server sends the image as WS `ota.*` frames; over the LAN the image goes in base64url
`ota_data` chunks, also over the USB network adapter (the USB console's `upload-*` commands are gone
from firmware 3.9.0; see [usb-serial-interface.md](usb-serial-interface.md)). Most clients use `benchpod firmware install`
or the web app instead of these commands.

One transport holds an update session at a time. Every `ota_*` reply carries the session:

```json
{"status":"ok","data":{"state":"receiving","target":"firmware","received":65536,"size":563696,
 "frames_seen":0,"sig":"ok","sig_key":"<key id>","owner":"lan:1","error":""}}
```

`state` is `idle`, `receiving`, `verified`, `error` or `installed`. `sig` is the signature check of
the last begin: `none`, `ok`, `format`, `unknown-key`, `signature`, `target` or `image`. `owner` is
`cloud`, `usb`, `lan:N` or `""`.

| Command | Fields | What it does |
|---|---|---|
| `ota_begin` | `size`, `sha256` (64 hex), optional `target` (`gw0`, `gw1`, `esp`, `bridge`, `ca`, `tls`; none = firmware), `version`, `sig` (base64url signed manifest) | Starts a session. The signature is checked here against the [signature policy](#sig_policy--which-firmware-and-blob-updates-the-pod-accepts) (the `ca` and `tls` targets are configuration and are not signed; `bridge`, the Wi-Fi bridge's firmware, always needs a good signature because the bridge checks it again). |
| `ota_data` | `offset`, `data` (base64url) | Writes one chunk at a byte offset. |
| `ota_end` | none | Checks the SHA-256 (and, for the firmware, that the image fits this MCU's flash and can enforce the policy); `state` becomes `verified` or `error`. |
| `ota_status` | none | The session, from any transport (T0). |
| `ota_abort` | none | Drops the staged image. |
| `ota_selftest` | none | Tests the flash writer on a scratch sector (never the firmware); replies `{"selftest":"pass"}`. |
| `ota_commit` | none | Firmware: replies `{"committing":true}`, writes the image and resets. A blob: writes the slot and replies with the session. |

Refusals:

| Condition | Message |
|---|---|
| `size` or `sha256` missing | `"missing size/sha256"` |
| Unknown `target` | `"unknown target"` |
| `ca` from Ethernet or Wi-Fi (the USB network adapter may) | `"cloud_ca: change it from the cloud or over USB"` |
| Another transport holds the session | `"busy: <target> update from <holder> is in progress"` (see [Error Reference](#error-reference)) |
| A capture or upload is running | `"busy: a capture or upload is running"` |
| Safe mode turned the PSRAM off | `"safe mode: iCE40/PSRAM are off. Unplug and replug the pod"` (the gate) |
| Size, hash or chunk problems | `"bad size"`, `"bad sha256"`, `"chunk out of range"`, `"incomplete image"`, `"sha256 mismatch"`, `"invalid data"`, `"missing data"` |
| The policy refuses the signature | `"signature: <result>"` |
| The image could not enforce `required` | `"image cannot enforce signatures (policy required)"` |
| `ota_commit` before a successful `ota_end` | `"no verified image staged"` |
| `ota_selftest` while the hardware is busy | `"busy"`, or `"ota selftest failed (see console log)"` |

### `blob_status` — what the W25Q slots hold

Reads the cached slot headers (no bus access).

```json
{"status":"ok","data":{"blobs":[
  {"name":"gw0","state":"ok","present":true,"size":135100,"version":47,"sha256":"<hex>"},
  {"name":"gw1","state":"ok","present":true,"size":135100,"version":47,"sha256":"<hex>"},
  {"name":"esp","state":"outdated","present":true,"size":1048576,"version":3,"sha256":"<hex>"}]}}
```

It lists the release slots: `gw0`, `gw1`, `esp` and `bridge` (the Wi-Fi bridge's firmware, which the pod keeps ready and relays when a bridge is plugged in and runs an older version); the company CA is read with `cloud_ca`.

`state` compares the slot with what this firmware was built with: `ok` (exactly that blob),
`outdated` or `missing` (an installer should send it), or `unknown` (this build expects nothing in
particular).

### `emi_log` — the EMI test build's run log

Only in the EMI test build (`make EMI_TEST=1`, never released); other builds answer `"unknown cmd"`.
That build keeps every run (one power-on) in the W25Q's free range `0x192000`-`0x200000` (440 KB,
7,040 records of 64 bytes; no blob slot uses it, so a slot added there later would erase it): a
`START` record at boot (firmware version, reset cause, core clock, DAC mode, gateware version), an
`EVENT` on every change (the status LED's state, the Ethernet link lost or back, the activity
started or stopped, a recovery step with its result, an ESP32-C3 restart with its cause) and a `CHECK` with the counters (captures, errors, frames sent and dropped, link
losses, the longest DAC gap a log write caused, 0 normally). A `CHECK` is written when a value that
shows trouble changed (errors, dropped frames, link losses, the LED, the link, the DAC gap, lost
records), at most every 10 s, and once a minute when nothing changed. A quiet hour takes about 60
records, an hour with trouble all the time at most 360. 16 sectors (1,024 records) are kept erased
ahead of the write position, erased at boot before the loop starts, so a lab day never erases flash
while it runs (unless it has trouble for more than about 2.8 hours in all); the ring keeps about
6,000 records of history, about 100 quiet hours.

```json
{"cmd":"emi_log"}
{"cmd":"emi_log","offset":0,"count":16}
{"cmd":"emi_log","after":345,"count":16}
```

Without `count` it answers the log's state and the loop's (`emi_test`, the full object; `status`
carries a short one); with `count` (at most `max_count`: 16, or 12 over the cloud, so the reply fits
a connection's 2 KB send buffer) it returns that many raw 64-byte slots from slot `offset` on,
base64url without padding, in slot order, instead of `emi_test`. With `after` (a sequence number)
in place of `offset`, the read starts at the first record newer than it, and `count` is cut to the
records there are (0 when there are none): a viewer that keeps a copy asks for `after` its newest
`seq` until `count` is 0. An `after` older than the oldest record starts at the oldest. `offset` in
the reply says where the read started; `uptime_ms` is the pod's uptime, to turn a record's
`uptime_ms` in this run into a time of day. Without `count` the reply also carries `last_error` (the
loop's last failure, empty when none) and `fw`:

```json
{"status":"ok","data":{"base":1646592,"record":64,"slots":7040,"valid":345,"run":12,
  "next_seq":346,"write_slot":345,"oldest_slot":512,"queued":0,"lost":0,"written":18,"erases":4,
  "write_errors":0,"session_us_last":273,"session_us_max":2969,"glitch_us_last":0,"glitch_us_max":0,
  "dac_stops":0,"max_count":16,"uptime_ms":4821930,"offset":0,"count":16,
  "data":"RUwBAg..."}}
```

`run` is this boot's run number; `queued` records wait in RAM for the next write, `lost` found no
room there. A slot is empty (all `0xFF`) or a record: `u16 magic 0x4C45` ("EL"), `u8 type` (1
START, 2 EVENT, 3 CHECK, 4 SUM), `u8 led` (1 starting, 2 green, 3 red, 4 blue, 5 blue recovering), `u32 seq` (grows across
runs: sort by it), `u32 run`, `u32 uptime_ms`, 44 bytes of payload, and a CRC-32 (zlib's) of the
first 60 bytes; the payloads are in `stm32h563/src/emi_log.c`. `stm32h563/tools/emi/emi_log_dump.py`
reads the whole log and prints it with a summary per run.

The W25Q shares its bus with the PSRAM: a read with `count` while the EMI loop runs waits for no
capture to be in flight (else `"busy: an EMI capture is using the bus, retry in a moment"`; the loop
then holds its next capture back for 1.5 s, so a retry finds the bus free). Log writes and reads do
not interrupt the outputs: the sine plays from the gateware's BRAM table and the 0-5 V DC and
4-20 mA outputs are held by the quad DAC, none of which use the bus, so the DAC keeps running
through a W25Q session. Only a deep DAC replay (from PSRAM) would be stopped and started again;
the EMI loop never plays one. A session delays the loop's next capture instead: `session_us_last`
and `session_us_max` are its time (measured on an analog v3r2 pod: 0.3 to 0.4 ms for one record,
about 3 ms for a batch of 14, about 60 ms when a sector erase comes with it (the W25Q's worst case
is 400 ms), which happens only once the 1,024 records erased at boot are used up). `glitch_us_last` and `glitch_us_max` are the
time the DAC was found stopped after a session (0 normally) and `dac_stops` how many sessions did.
The whole log (7,040 slots) downloads in about 10 s over the LAN while the loop runs.

**The LED's verdict.** The color is the verdict for a test lab: green passes every test; blue
passes criterion B (blue, fast blink: a function fails now and the pod is getting itself running
again; blue, 1 s blink: it runs again after a failure or restart); red, fast blink, fails: a
function has been failing for 60 s without a break, or the recovery below ran out of steps. Red is
not latched: a pod that comes back after a long burst test turns blue, so the lab reads the LED
60 s after each test. An eFuse trip or an iCE40 that dropped out go through this too (no red at
once), and `emi_test` and the `emi` line name the state (`led`: `green`, `blue (recovering)`,
`blue`, `red`).

**Recovery.** While the loop runs, the EMI build gets itself running again when it stays stuck
(`stm32h563/src/recovery.h`): captures that keep failing for 10 s (or one that has not finished
after 10 s) reload the iCE40 from its config flash (no write), a second time 10 s later, and when
that does not help, the STM32 resets (10 s after the last reload, 30 s after the failure began);
after that reset the loop starts 2 s into the boot instead of 10 s, so the pod runs again well
inside a minute. An Ethernet link that stays down for 20 s, or stays up while frames keep failing
to go out, gets a PHY reset and a new DHCP request, at most once a minute. An eFuse that trips is
a failure (blue recovering, then blue) and its supply is turned off and on again 2 s later, at most 6 times an
hour (`eFuse 1 tripped: power retry`); past that the output stays off and counts as failing (`eFuse 1 tripped: off (retry limit)`), so the LED turns red 60 s later, until `emi stop` or a power cycle. A trip is FLT held for 30 ms (3 samples 10 ms apart), so a glitch on the FLT line does not count. The EMI build never goes to safe mode after crashed boots. Limits: 6 iCE40 reloads an hour, 2 STM32 resets until the pod ran
10 minutes without a failure or was powered off and on (the count survives the resets), 10 PHY
resets an hour; past them the LED is red while the failure lasts. Each step is an `EVENT` (kind 6, `recovery`) whose text
says what it did and how it went, e.g. `iCE40 reload ok v51` or `STM32 reset (1 of 2)`; the next
run's `START` then has the reset cause `recovery reset`.

On a board with the built-in Wi-Fi (ESP32-C3, v3 boards) a C3 restart while the activity runs is a
failure too (blue recovering for 5 s, then blue): the pod restarts the C3 when it stops answering, reboots by
itself or fails a setup step (see [`wifi_status`](#wifi_status)), so an ESD hit that resets it
shows. Each one is an `EVENT` (kind 7, `ESP32-C3 restart`) whose text has the cause, e.g.
`C3 restart: rebooted`, and `emi_test` counts them (`c3_restarts`).

Things the pod counts that the LED does not show are `EVENT`s too (kind 8, `health`), checked once
a second and logged at most once per item every 10 s (eFuse reverse blocking: every 60 s) with the
count since the last one: an I2C bus clear, a capture read-back from the PSRAM that needed a retry
or failed, a CAN bus-off recovery, eFuse reverse-current blocking (`eFuse1 rev block +31`, see
`target_status`), the iCE40 losing its configuration (CDONE low) and the LA supply switching source
(the TPS2116's status pin). They do not change the LED.

The cloud link is not under test (a lab network may have no internet), so it never changes the
LED, and a drop that reconnects is only counted. A cloud link that is set up but stays down for
2 minutes is a `health` event (`cloud down 2 min: idle timeout (no pong)`), and so is its return
(`cloud back after 7 min`): the shared lab view stops updating meanwhile.

Every 10 minutes while the loop runs, also when nothing went wrong, a `SUM` record (type 4) keeps
the totals, so after a failure the log shows which one started climbing first: cloud drops and
the seconds the cloud was down this run, ESP32-C3 restarts, I2C bus clears, CAN bus-off
recoveries, PSRAM read-back retries and failures, iCE40 configuration losses this run, eFuse
reverse blocks per eFuse, Ethernet frames received with a CRC or alignment error and frames
missed for want of a receive buffer, and the Wi-Fi bridge's failed Wi-Fi transmits (its own
count). Layout after the common header: `u16` cloud drops, C3 restarts, I2C clears, CAN bus-off,
PSRAM fails, iCE40 losses at bytes 16-27, then `u32` PSRAM retries, eFuse 1 and 2 reverse blocks,
Ethernet CRC, Ethernet missed, bridge transmit errors and cloud-down seconds at bytes 28-55,
then `u16` Wi-Fi bridge restarts and silences this run at bytes 56-59.

With a Wi-Fi bridge on the Ethernet port (the lab's configuration 2: the bridge's EMC test build
puts the pod's frames on the air), the bridge is part of the equipment under test: once the pod
has seen one this run, its failures are the pod's, as `health` events and on the LED (blue
recovering, red after 60 s): a restart (`bridge restart: brownout`, the reason from the bridge's
next STATUS), no HELLO for 10 s (`bridge silent 10 s`, then `bridge back after 14 s`), and its radio
reporting that it is not transmitting (`bridge radio not transmitting`, then `bridge radio back`).
The console's `bridge` shows the bridge's reset reason, the reboots the pod saw and the EMC radio. A restart because the access
point refused the association is left out: that is the network, not the pod. The digital v3r3
and the v4 boards have no C3. A hang of the STM32 itself is the watchdog's
(about 30 s). The console's `emi fault` makes such failures on purpose to test it.

**The lab page.** The EMI build also answers HTTP on port 80 of every interface it has an address
on: `http://<the pod's address>/` is a page for a test lab that shows the loop's state live (the
LED's meaning, the counters, the last error) and keeps a copy of the run log in the browser. It
fetches the newest 500 records the first time (all of them with "Load full history"), then only
what is new every 5 s, also after the network or the pod was down, and stamps records of the
running boot with the laptop's clock; "Download CSV" and "Download all (JSON)" save the copy, the
JSON with a status sample every 5 s. The page is built in from `stm32h563/tools/emi/lab_page.html`
and uses nothing from the internet. Besides `GET /` there are only two read-only paths, the two
calls the page makes: `GET /api/status` (`{"cmd":"emi_log"}`) and `GET /api/log?after=<seq>`
(`{"cmd":"emi_log","after":<seq>,"count":16}`); each answers that command's reply line as JSON.
Anything else is refused (404, or 405 for a method other than GET). HTTP/1.0, one request per
connection; a request takes one of the pod's 5 LAN connection slots while it runs.

---

## SCPI reference

Port `8080` also speaks SCPI (IEEE 488.2, on libscpi): a connection whose first byte is not `{`
is a SCPI connection for its whole life. Lines end with `\n`, are at most 255 bytes, and several
commands can share a line with `;`. Queries answer one line; bulk samples come as comma-separated
ASCII. Errors go to the error queue (16 deep): read them with `SYSTem:ERRor?`. The instrument
state (`SOURce`, `SENSe`, the trace) is shared by every SCPI connection. Upper-case letters are
the short form; `[...]` is optional; `#` is a number in the header (`OUTPut:POWer1`).

**VISA.** The pod is a raw socket instrument. Its VISA resource string is
`TCPIP::<address>::8080::SOCKET`: the LAN address, the pod's USB network address over USB
(`TCPIP::10.237.x.y::8080::SOCKET`, from `status.usb.ip`), or its mDNS host name
(`TCPIP::benchpod-a1b2c3.local::8080::SOCKET`). Set the termination character to `\n` for reads and
writes. From firmware 3.9.0 the pod also advertises `_scpi-raw._tcp` over mDNS on each interface,
so VISA and LXI discovery tools list it. SCPI follows the same rules as the JSON API there: the
external LAN policy applies on Ethernet and Wi-Fi, not on the USB link.

### IEEE 488.2 common commands

| Command | Description |
|---|---|
| `*IDN?` | `EmbeddedCI,BenchPod,0,<firmware version>`, for example `EmbeddedCI,BenchPod,0,3.7.0` (the same version as JSON `status`) |
| `*RST` | Stop the DAC and restore the `SOURce`/`SENSe` defaults (sine, 1 kHz, amplitude 127, offset 128, 256 points, maximum rates) and empty the trace |
| `*CLS`, `*ESE`, `*ESE?`, `*ESR?`, `*OPC`, `*OPC?`, `*SRE`, `*SRE?`, `*STB?`, `*TST?`, `*WAI` | Standard status and synchronization commands (libscpi core) |

### System

| Command | Description |
|---|---|
| `SYSTem:ERRor[:NEXT]?` | Next error: `<code>,"<text>"`, or `0,"No error"` |
| `SYSTem:ERRor:COUNt?` | Errors in the queue |
| `SYSTem:VERSion?` | SCPI version |
| `SYSTem:PING?` | `PONG` |
| `SYSTem:WIFI:STATe?` | `READY` when an interface has an address, else `DISCONNECTED` |
| `SYSTem:WIFI:RSSI?` | Always pushes `-200` on this firmware (no RSSI) |
| `SYSTem:COMMunicate:LAN:IPADdress?` | The pod's IP |
| `SYSTem:IDENtity:PUBlic?`, `SYSTem:IDENtity:POP? "<nonce>"` | Device identity, see [SCPI equivalents](#scpi-equivalents) |

### Signal generator (DAC)

| Command | Parameter | Description |
|---|---|---|
| `[SOURce]:FUNCtion[:SHAPe] <shape>` / `?` | `SINusoid`, `SQUare`, `RAMP` or `USER` | Waveform; `USER` replays the trace |
| `[SOURce]:FREQuency <Hz>` / `?` | > 0, unit suffixes allowed; `MIN` 1, `MAX` 1e6, `DEF` 1000 | Frequency |
| `[SOURce]:VOLTage[:AMPLitude] <0-255>` / `?` | 8-bit half-scale amplitude | As `generate` `amplitude` |
| `[SOURce]:VOLTage:OFFSet <0-255>` / `?` | 8-bit offset | As `generate` `offset` |
| `[SOURce]:SRATe <MHz>` / `?` | ≥ 0; `0` = auto | DAC sample clock, also the `USER` replay rate |
| `[SOURce]:DURation <ms>` / `?` | ≥ 0; `0` = until stopped | Output duration |
| `OUTPut[:STATe] <ON\|OFF>` / `?` | | `ON` starts the selected waveform (as `generate`, or `replay` for `USER`); `OFF` stops the DAC |

### Acquisition (ADC and LA)

| Command | Parameter | Description |
|---|---|---|
| `SENSe:SWEep:POINts <n>` / `?` | 1..4096 | Default `READ?` and `MEASure?` length |
| `SENSe:SRATe <MHz>` / `?` | ≥ 0; `0` = maximum (about 0.4) | ADC sample clock for `READ?` |
| `READ? [<n>]` | 1..4096 | Capture `n` ADC samples and return them as CSV; also fills the trace (first 2048 samples) |
| `MEASure?` | | Play one period of the `SOURce` waveform across a `POINts`-long capture (as `measure`) and return the ADC samples; also fills the trace |
| `DIAGnostic:CAPture? [<adc_n>][,<la_n>]` | each 0..128, not both 0; default 16,16 | One-trigger ADC + LA capture (ADC 100 kS/s, LA 1 MS/s): `adc_n` ADC counts, then `la_n` LA words, as CSV. Each LA word holds LA1..LA14 in its low 14 bits (bit 0 = LA1). |
| `DIAGnostic:PATTern? <pattern>[,<value>[,<n>]]` | `SINusoid`, `COUNter`, `RAMP` or `CONStant`; value 0..255 (for `CONStant`, default 255); n 1..4096 (default 256) | An 8-bit synthetic pattern as CSV (no hardware) |
| `TRACe[:DATA] <offset>,"<base64url>"` | byte offset 0..4096 | Upload one chunk of a replay trace (16-bit little-endian samples, at most 4096 bytes in total) |
| `TRACe:POINts?` | | Samples in the trace (bytes ÷ 2) |

### Digital (LA pins)

| Command | Parameter | Description |
|---|---|---|
| `DIGital:OUTPut <la>,<0\|1>` | LA 1..14 | Make the pin a gpio output at that level (the JSON `gpio` table applies) |
| `DIGital:STEP <la>,<steps>,<delay_us>[,<dir_la>[,<dir>]]` | as the JSON [`la` step train](#step-a-pulse-train) | Start a step pulse train (non-blocking) |
| `DIGital:STEP:BUSY?` | | `1` while a step train runs, else `0` |

### Target power

| Command | Description |
|---|---|
| `OUTPut:POWer<n>[:STATe] <ON\|OFF>` / `?` | eFuse `n` (1 = internal 5 V, 2 = external) on or off |
| `OUTPut:POWer<n>:FAULt?` | `1` when the eFuse reports a fault |
| `OUTPut:POWer<n>:VALid?` | `1` when the eFuse's input is valid |

### SCPI errors

| Code | When |
|---|---|
| `-200 Execution error` | The hardware is busy (a JSON capture or upload holds it), a capture or waveform failed, `OUTPut ON` with `USER` and an empty trace, `SYSTem:WIFI:RSSI?`, or a setter while a cloud job holds the pod (queries still answer) |
| `-221 Settings conflict` | DAC limits are set (`OUTPut ON`, `MEASure?`), or an LA pin belongs to another function (`DIGital:*`) |
| `-222 Data out of range` | A parameter outside the ranges above, or an eFuse other than 1 or 2 |
| `-224 Illegal parameter value` | Bad base64url (`TRACe:DATA`, `SYSTem:IDENtity:POP?`) or a bad `FREQuency` keyword |
| `-240 Hardware error` | Safe mode: the iCE40/PSRAM are off this boot, so `OUTPut`, `READ?`, `MEASure?`, `DIAG:CAP?`, `TRACe:DATA` and `DIGital:*` are refused (the error text is the JSON refusal) |
| `-241 Hardware missing` | The digital-only board has no analog front end: the analog commands are refused (`DIAG:CAP?` for the LA alone still works) |
| `-300 Device specific error` | `DIGital:STEP` while a step train is running |
| `-310 System error` | The device identity is not available |
| Other libscpi codes | Malformed input, for example `-113 Undefined header` |

---

## Signal Parameters Reference

### Waveform types

| `waveform` | Description |
|---|---|
| `"sine"` | Sinusoidal. Smooth output, good for frequency response testing |
| `"square"` | 50% duty-cycle square wave. Useful for rise/fall time and bandwidth tests |
| `"sawtooth"` | Linear ramp from `offset - amplitude` to `offset + amplitude` per period |

### Amplitude / offset guide

| Goal | `amplitude` | `offset` |
|---|---|---|
| Full-scale, centred | `127` | `128` |
| Half-scale, centred | `64` | `128` |
| Low-side only (0–127) | `64` | `63` |
| High-side only (128–255) | `64` | `192` |
| Minimum swing | `1` | any |

### ADC sample values

ADC samples are raw 16-bit counts (0–65535) from the MCP33131 ADC, with no calibration or
scaling applied. The front end in front of the ADC input SMA is bipolar and divides by about 12,
so the count is not a simple fraction of a reference. To convert, use the affine fit the pod
announces (`adc_cal_a_uv`, `adc_cal_b_nv`, `adc_cal_unwrap`, see
[Capabilities frame](#capabilities-frame--adc-calibration-fields)):

```
if adc_cal_unwrap and count < 32768: count += 65536
V = (adc_cal_a_uv + adc_cal_b_nv / 1000 × count) / 1e6
```

For a single calibrated reading of any source, use [`adc_read`](#adc_read--route-a-source-and-return-a-calibrated-reading).

---

## Error Reference

All errors follow the format:

```json
{"status":"error","message":"<description>"}\n
```

| Message | Cause |
|---|---|
| `"missing cmd"` | Request JSON has no `"cmd"` field |
| `"unknown cmd"` | `cmd` value not recognised |
| `"command too long"` | A JSON line longer than 1279 bytes |
| `"busy"` | A command that uses the capture hardware while another one runs |
| `"command not supported over cloud channel"` | A streaming command on the single-reply cloud command channel (see [Commands](#commands)) |
| `"locked: <cmd> needs the cloud or USB"`, `"busy: a cloud job holds this pod (...)"`, `"forbidden: <cmd> needs an organization owner or admin"`, `"safe mode: ..."`, `"this BenchPod has no analog front end (digital board): ..."` | The [gates](#gates-that-apply-to-every-command) |
| `"la voltage not set; set it with la_voltage (mv 1800 or 3300) first"` | An LA command before `la_voltage` |
| `"unknown waveform"` | `generate` `waveform` value not `sine`, `square`, or `sawtooth` |
| `"generate failed"` | Invalid `freq` (≤ 0) or `amplitude` (= 0) |
| `"samples out of range"` | `samples` outside the command's range (see each command); firmware 3.10.0 and later add the range, `"samples out of range: 1 to <max>"` |
| `"samples out of range (use capture_dual for deep captures)"` | `capture` / `stream` with more than 32768 samples |
| `"capture failed"` | The capture did not arm or did not complete |
| `"missing waveform"` | `measure` request without `waveform` field |
| `"unknown waveform (use sine, square or sawtooth)"` | `measure` with another waveform |
| `"measure start failed"` | `measure` invoked with invalid params |
| `"missing la"` | `la` step request without `la` field |
| `"missing state"` | `target_power` request without `state` field |
| `"missing efuse"` | `target_power` request without `efuse` field |
| `"invalid efuse"` | `target_power` `efuse` is not 1 or 2 |
| `"invalid swd la channel"` | `dap_start` channel outside 1..14 or both channels equal |
| `"missing rx"` / `"missing tx"` | `uart_proxy_start` request without `rx`/`tx` field |
| `"invalid uart args"` | `uart_proxy_start` channel outside 1..14 or `rx`==`tx` |
| `"uart busy"` | a UART proxy is already active (console or another connection) |
| `"unknown sensor instance '<name>'"` | a `sensor_*` command naming an instance that is not defined |
| `"invalid definition: <path>: <message>"` | `sensor_define` whose definition does not compile (see [Emulated sensors](#emulated-sensors)) |
| `"chunk at offset N, expected M (start again at offset 0)"` | `sensor_define` / `sensor_stimulus` chunk out of order |
| `"<key> must be <min>..<max> <unit>"` | `sensor_set` / `sensor_start` value out of range |
| `"start/len out of range (0..255)"` | `sensor_regs` `len` = 0 or `start`+`len` > 256 |
| `"missing nonce"` | `identity_pop` request without `nonce` field |
| `"invalid nonce"` | `identity_pop` nonce is not valid base64url, or decodes to 0 or > 128 bytes |
| `"identity not available"` | Device identity not initialised (should not occur after boot) |
| `"capture data was overwritten by <what>; run the capture again"` | `capture_read` after an OTA staging, a `load_bin` with `"psram"`, a gateware reload or another (SCPI/console) capture wrote over the capture's PSRAM regions |
| `"busy: <target> update from <holder> is in progress"` | an `ota_*` command (or `upload-*` on the USB console of firmware before 3.9.0) while another transport (`the cloud`, `the USB console`, `LAN connection N`) holds the update session. Within the LAN, a second connection is refused while the one holding the session is open; once it closes, the next LAN connection takes the session over and continues (one connection per command works). A session with no progress for 30 s may be replaced or aborted from any transport. `ota_status` and the other ota replies carry `"owner"`: `"cloud"`, `"usb"`, `"lan:N"` (the current LAN connection) or `""` |
| `"safe mode: the PSRAM is off this boot, so an update cannot be staged; ..."` | an update begin (cloud `ota.begin`, LAN or USB network `ota_begin`) in a safe mode that turned the iCE40/PSRAM off |
| `"busy: a capture, upload or update is using the PSRAM bus; try again when it ends"` | `cloud_ca` clear and `cloud_proxy` set/clear (and the console `cloud-ca-clear`, `cloud-proxy-set`, `cloud-proxy-clear` and their short names, `flash-esp32` and PSRAM diagnostics) while the shared PSRAM/W25Q bus is in use |
| `"cloud_ca: change it from the cloud or over USB"`, `"cloud_proxy: ..."`, `"sig_policy: change it from the cloud or the USB console"`, `"lan_policy: ..."` | Changing the company CA, the proxy or a policy from a LAN connection (see [Pod policies](#pod-policies)) |
| `"identity_wipe: only on the pod's USB console (physical presence): benchpod identity wipe --connection usb"` | `identity_wipe` from anywhere but the USB console |

Over SCPI the same refusals arrive in the error queue (`SYSTem:ERRor?`): safe mode as `-240 Hardware error` and the digital-only board as `-241 Hardware missing`, each with the JSON refusal text attached; a busy capture lock, or a trace that a JSON command replaced, as `-200 Execution error`; and the DAC limits as `-221 Settings conflict` with the limits' reason.

Three families carry a **machine-parseable prefix** — clients (the Python SDK among them) match
on the prefix and show the rest to the user:

| Prefix | Raised by | Details |
|---|---|---|
| `pin conflict: ` | any command claiming an LA pin (`gpio`, `uart_proxy_start`, `dap_start`, `sensor_start`, the `la` step train, SCPI `DIGital:*`) | [pin ownership](#la-pin-ownership) |
| `pull conflict: ` | the same claims, and `{"cmd":"la",…,"pullup":"on"}` | [pull compatibility](#la-pin-ownership) |
| `trigger timeout: ` | `capture`, `capture_dual`, `la_capture` with a `trigger` | [capture triggers](#capture-triggers) |

---

## Session Example

```
$ nc 192.168.1.220 8080

{"cmd":"ping"}
{"status":"ok","data":"pong"}

{"cmd":"la_voltage","mv":3300}
{"status":"ok","data":{"mv":3300,"st":1,"readback_mv":3297}}

{"cmd":"target_power","efuse":1,"state":1}
{"status":"ok","data":{"efuse":1,"enabled":1,"delay_ms":0}}

{"cmd":"generate","waveform":"sine","freq":1000,"amplitude":100,"offset":128}
{"status":"ok","data":null}

{"cmd":"capture","samples":512}
{"status":"ok","bits":16,"data":[32768,33170,33571,...],"more":true}
{"status":"chunk","data":[...],"more":false}

{"cmd":"dac_stop"}
{"status":"ok","data":null}

{"cmd":"la","la":1,"pullup":"on"}
{"status":"ok","data":{"la":1,"pullup":1,"ohms":"4.7k","pull":"up","pullups_available":1}}

{"cmd":"la","la":1,"steps":200,"delay_us":500}
{"status":"ok","data":{"la":1,"steps":200,"delay_us":500,"status":"started"}}

{"cmd":"identity_public"}
{"status":"ok","data":{"public":"ue5UfSsOAhQYZ332ELokjOI8-uyjcbrd1ic3Nmypvzk"}}

{"cmd":"cloud_set","host":"www.embeddedci.com","device_id":"<uuid>","tls":true}
{"status":"error","message":"locked: cloud_set needs the cloud or USB"}
```

The last reply is what a pod with the LAN policy `locked` answers; on an `open` LAN it stores the
settings.

---

## Pod policies

See `docs/design/policy-commands.md` for the full rules.

### `sig_policy` — which firmware and blob updates the pod accepts

```json
{"cmd":"sig_policy"}
{"cmd":"sig_policy","set":"required"}
```

```json
{"status":"ok","data":{"policy":"audit","enforces":true,"keys":3}}
```

`audit` (default) accepts every update and reports its signature check; `permissive` refuses a
bad signature; `required` refuses anything not signed by a key the firmware trusts. Over the
cloud the policy can only get stricter (`sig_policy: only the USB console can loosen the policy
(now required)`); the LAN cannot change it; the USB console (`sig-policy <value>`) can set any
value.

### `lan_policy` — what the external LAN may do

```json
{"cmd":"lan_policy"}
{"cmd":"lan_policy","set":"locked"}
```

```json
{"status":"ok","data":{"policy":"locked"}}
```

The policy covers the **external LAN**: Ethernet and Wi-Fi. `open` (default), `locked` (a T2/T3
command there gets `locked: <verb> needs the cloud or USB`) or `off` (connections to
8080 over Ethernet or Wi-Fi are refused and open ones closed, no mDNS there). The [USB network
adapter](usb-serial-interface.md#usb-network-adapter) stays on and open under every policy: it
means physical presence. It is still LAN tier, so what the LAN never may (`identity_wipe`,
loosening `sig_policy`, changing `lan_policy`) stays off it too; the one exception is the company CA
and the cloud proxy, which it may change (see `cloud_ca` / `cloud_proxy`). The wire
values and the field name are unchanged. Set from the cloud or the USB console (`lan-policy
<value>`), never from the LAN or the USB network.

### `usb_network` — the USB network adapter on or off

```json
{"cmd":"usb_network"}
{"cmd":"usb_network","set":"off"}
```

```json
{"status":"ok","data":{"setting":"off"}}
```

Whether the pod's USB port is also a [USB network
adapter](usb-serial-interface.md#usb-network-adapter) (default `on`). With `off` the pod
re-enumerates as its USB console only: the computer sees no network adapter at all. The setting is
stored, separate from `lan_policy` (which covers Ethernet and Wi-Fi), and survives a reboot and a
firmware update. Only the device changes it: the USB console (`usb-network on|off`, the way back
on) or a connection over the USB link itself (which can turn it off). Ethernet, Wi-Fi and the cloud
get `usb_network: change it on the device (the USB console, or over the USB link)`; reading works
everywhere. The reply comes first; the pod re-enumerates about 0.4 s later. Stored Wi-Fi
credentials also turn the adapter off (status `usb.off_reason`).

### `lan_tls` — the LAN API over TLS

Firmware 3.9.3+. See `docs/design/lan-tls.md`.

```json
{"cmd":"lan_tls"}
{"cmd":"lan_tls","https_only":true}
{"cmd":"lan_tls","regenerate":true}
```

```json
{"status":"ok","data":{"port":8443,"https_only":false,"sessions":1,"origin":"generated",
 "key":"EC P-256","subject":"CN=benchpod-baea06","san":["benchpod-baea06","benchpod-baea06.local"],
 "not_after":"9999-12-31","sha256":"3f1c...e9"}}
```

The pod also serves this API on TCP `8443` with TLS 1.2 (ECDHE, AES-GCM or ChaCha20-Poly1305). A
full handshake takes the pod about 0.46 s with its EC key (about 1.1 s with an RSA 2048 one); it
resumes sessions (session tickets and a 4-entry session cache, one hour), which takes about 20 ms, so
clients that open a connection per command should keep the session. On
the first boot of firmware with LAN TLS it generates an ECDSA P-256 key and a self-signed
certificate for `benchpod-xxxxxx` and `benchpod-xxxxxx.local` (its mDNS name), valid to 9999 (the
pod has no clock), and keeps both in its internal config flash. `sha256` is the SHA-256 of the
certificate (DER), the value clients pin. `origin` is `generated` or `user`. `sessions` is the
number of TLS connections open now: at most 3 at once (each needs about 22 KB of RAM), a fourth is
refused at connect, and so is one the pod has no room for; plaintext connections do not count.
Firmware 3.9.3 to 3.9.6 allowed 2, so a UART session, a capture and one more command over TLS
could not run together there. When there is no certificate the reply has
`error` instead of the certificate fields.

| Field | Effect |
|---|---|
| `https_only` | `true`: plaintext connections to `8080` over Ethernet and Wi-Fi are refused and open ones closed, so only `8443` answers there. `8080` keeps answering on the [USB network adapter](usb-serial-interface.md#usb-network-adapter). Default `false`. Stored; survives reboots and updates. |
| `regenerate` | `true`: a new key and self-signed certificate. New connections get it; open ones keep the old one. Clients that pinned the old one must trust the new one (`benchpod lan-tls trust`). |

**Your own certificate.** Upload a PEM bundle, the certificate (optionally followed by its chain)
and its unencrypted private key (EC P-256/P-384 or RSA 2048-4096), with the upload path as target
`tls`: `ota_begin` with `"target":"tls"` and the bundle's `size` and `sha256`, `ota_data` chunks,
`ota_end` (the pod checks that both parse and that the key matches the certificate) and
`ota_commit` (stored and used for new connections; the reply's `state` is `installed`). At most
7.6 KB. `benchpod lan-tls set-cert --cert pod.pem --key pod.key` does all of it.

**Who may change it.** Reading works from anywhere, and so does turning `https_only` on. Turning
it off, `regenerate` and the upload need the USB console, the USB network adapter, the cloud, or a
LAN connection over TLS. A plaintext LAN connection gets
`lan_tls: change it over TLS (port 8443), over USB or from the cloud`. Reading is T0; the changes
are T2 (so `locked` keeps them off the external LAN). mDNS: the `_benchpod._tcp` TXT record carries
`tls=8443` and `https_only=0|1`.

**Raw sockets and VISA.** `8443` speaks the same SCPI as `8080`, wrapped in TLS. VISA's raw socket
resource (`TCPIP::<host>::8080::SOCKET`) has no TLS, so with HTTPS-only on, run a local TLS
wrapper and point VISA at it, for example with the pod's certificate from
`benchpod lan-tls show --pem > pod.pem`:

```bash
socat TCP-LISTEN:5025,reuseaddr,fork OPENSSL:benchpod-baea06.local:8443,cafile=pod.pem
```

then use `TCPIP::127.0.0.1::5025::SOCKET`.

### `cloud_ca` / `cloud_proxy`: company CA and HTTP proxy for the cloud link

See `docs/design/cloud-hardening.md` section 3.

```json
{"cmd":"cloud_ca"}
{"cmd":"cloud_ca","clear":true}
{"cmd":"cloud_proxy"}
{"cmd":"cloud_proxy","set":"proxy.corp:3128","user":"u","password":"p"}
{"cmd":"cloud_proxy","clear":true}
```

`cloud_ca` replies `{"present":true,"certs":[{"subject":"...","sha256":"<hex>"}]}`. A company CA is
installed with the upload path as target `ca` (`ota_begin` with `"target":"ca"` from the cloud, WS
`ota.begin`, `ota_begin` over the USB network adapter, or the USB console's `upload-begin ca` on
firmware before 3.9.0; `benchpod cloud ca set corp.pem` picks the way); it
must parse as X.509 and is trusted in addition to the built-in roots.
`cloud_proxy` replies `{"host":"...","port":3128,"auth":true}` or `{}`; the password is never shown.
The pod sends `CONNECT <server>:443` with the server's host name and, when set, Basic proxy auth.
Setting or clearing either reconnects the cloud. Reading is T0; setting and clearing are T2.

**Never from the external LAN.** Installing or clearing the CA and setting or clearing the proxy are
refused on an Ethernet or Wi-Fi TCP connection whatever the LAN policy (even `open`), with
`cloud_ca: change it from the cloud or over USB` or
`cloud_proxy: change it from the cloud or over USB`. Reading both (`{"cmd":"cloud_ca"}`,
`{"cmd":"cloud_proxy"}`) still works on the LAN. The reason: a LAN attacker who could install their
own CA and point the pod at their own proxy could terminate the pod's TLS with a certificate for the
real server name and relay the host-bound (v2) login, which defeats it.

**Allowed over the USB network adapter** (firmware 3.9.0+). A connection on the USB link is
physical presence, like the USB console (anything on that computer can open the console anyway),
so it may install or clear the CA and set or clear the proxy. This is how `benchpod cloud ca` and
`cloud proxy` (and `usb-bridge`) change them over USB. Everything else on the USB link stays LAN
tier.

### While a cloud job holds the pod

When a cloud consumer (a CI run, the web app, the SDK) holds the pod's lease, LAN connections get
only light reads (`status`, `ping`, the `*_status` reads, policy reads); everything else gets
`busy: a cloud job holds this pod (<holder>, <N> s left)`, and SCPI setters get -200. The pod ends
the lease itself at the announced expiry or when the cloud link drops. `status` shows
`"lease":{"held":...,"holder":"...","left_s":...}`.

---

## Implementation Notes

- **JSON parser limitations:** The firmware uses a minimal flat-JSON parser. Nested objects are not supported, except the `trigger` object of the captures; arrays only where a command documents one (`data` of `can_write`, `reply_data` of `can_respond`). Fields must be at the top level of the JSON object, and unknown fields are ignored.
- **No authentication:** Any TCP client that can reach port 8080 (or 8443, its TLS form) has the full command set (target power, SWD access to an attached target, and pod OTA) unless the LAN policy is `locked` or `off`. Restrict access at the firewall/VLAN level. The cloud channel is unaffected (TLS + Ed25519 device auth). See [Security model](#security-model).
- **Concurrent commands:** Up to 5 LAN connections are served at once. Commands run one at a time on one worker task, and the commands that use the capture hardware take turns: a second one gets `"busy"` until the first one's reply is complete.
- **DAC runs until stopped:** A `generate` with `duration_ms` 0 runs the DAC until `dac_stop`, the next `generate`, `measure` or `replay`, or `OUTPut OFF` over SCPI.
- **Separate DAC and ADC sample-clock domains:** the DAC8551 engine runs on the 48 MHz `clk48` domain (SPI-limited) while the MCP33131 ADC runs in the 24 MHz domain with its divider floored at 60 (max ~400 kSPS). Each is selected per command via `sample_rate_mhz`; the firmware snaps to the nearest achievable divider and logs the actual rate.
