embeddedci-com/benchpod-firmware/stm32h563/src/main.c

/*
 * main.c — bench-pod STM32H563 firmware, Phase 1 boot skeleton.
 *
 * Brings up the clock tree (HSI -> PLL1 -> 250 MHz), the USART2 console, and
 * FreeRTOS, then runs a banner task.  Later phases add the iCE40 signal engine,
 * I2C devices, USB-CDC console, LwIP Ethernet server and XSPI PSRAM.
 *
 * Clock: 25 MHz HSE crystal (PH0/PH1) -> PLL1 -> 250 MHz SYSCLK.  USB (48 MHz
 * via HSI48+CRS) and RMII (50 MHz from the PHY) are brought up in later phases.
 */
#include "stm32h5xx_hal.h"
#include "FreeRTOS.h"
#include "task.h"
#include "board_pins.h"
#include "pico_compat.h"
#include "signal_engine.h"
#include "i2c_bus.h"
#include "ina238.h"
#include "board_variant.h"
#include "module_link.h"
#include "tca9554.h"
#include "target_power.h"
#include "mcu_adc.h"
#include "board_rev.h"
#include "cal_data.h"
#include "usb_cc.h"
#include "nrst_ctrl.h"
#include "can_bus.h"
#include "console_io.h"
#include "console.h"
#include "usb_device.h"
#include "net_server.h"
#include "device_identity.h"
#include "psram.h"
#include "dfu_boot.h"
#include "fault.h"
#include "esp_wifi_ctrl.h"
#include "efuse_flt.h"
#include "watchdog.h"
#include "boot_guard.h"
#include "cloud_client.h"
#include "hw_worker.h"
#include "ice40_flash.h"
#include "version.h"
#include "dac_limits.h"
#include "dac_quad.h"
#include "pod_policy.h"
#include "cloud_extras.h"
#include "adc_cal.h"
#include "blob_store.h"
#include "bp_log.h"

#include <stdbool.h>
#include <stdio.h>
#include <string.h>

UART_HandleTypeDef huart2;

/* Set when the crystal did not start and the clock runs from the internal HSI instead. */
static bool s_clock_on_hsi;

static void SystemClock_Config(void);
static void icache_init(void);
static void MX_USART2_UART_Init(void);
void Error_Handler(void);

/* (printf retarget _write lives in console_io.c and fans out to USART2 + USB.) */

/* --- console task: line editor + periodic module polls ------------------- */
static void console_task(void *arg)
{
    (void)arg;
    console_init();
    for (;;) {
        watchdog_heartbeat(WD_TASK_CONSOLE, "console");
        /* Line editing only — complete lines are executed on the hw worker task,
           which also runs signal_engine_poll() / target_power_poll(). */
        console_poll();
        vTaskDelay(pdMS_TO_TICKS(2));
    }
}

/* --- net task: LwIP (NO_SYS=1) bring-up + poll loop ---------------------- */
static void net_task(void *arg)
{
    (void)arg;
    const bool skip = boot_guard_skip_net();
    if (skip) {
        log_printf("[boot] safe mode: networking off\r\n");
    } else {
        /* Stage first: anything below that crashes or hangs counts as the network's. */
        boot_guard_stage(BOOT_STAGE_NET_INIT);
        boot_guard_sub_start(BOOT_SUB_NET);
        boot_guard_test_loop_point(BOOT_SUB_NET);   /* no-op unless `test-bootloop` armed it */
        net_init();
        boot_guard_sub_done(BOOT_SUB_NET);
    }
    bool healthy = false;
    for (;;) {
        watchdog_heartbeat(WD_TASK_NET, "net");
        watchdog_test_hang_point(WD_TASK_NET);   /* no-op unless `test-hang net` armed it */
        if (!skip) net_poll();
        watchdog_service();   /* refresh IWDG only if ALL tasks are alive */
        /* Fifteen seconds up with every task cycling: this boot is good, so a later reset does
           not count toward safe mode. */
        if (!healthy && boot_hw_ready() && HAL_GetTick() > 15000u) {
            boot_guard_healthy();
            healthy = true;
        }
        vTaskDelay(pdMS_TO_TICKS(1));
    }
}

int main(void)
{
    /* Must run before any clock/peripheral setup: if a prior `dfu` command armed
       the reboot flag, this jumps to the ROM USB DFU bootloader and never
       returns.  See dfu_boot.c. */
    dfu_boot_check();

    HAL_Init();
    SystemClock_Config();
    icache_init();
    /* Latch the reset cause + any surviving crash record before anything can
       overwrite the .noinit slot, and clear the RCC flags. */
    fault_boot_init();
    MX_USART2_UART_Init();
    pico_compat_init();
    console_io_init();

    log_printf("\r\n\r\n");
    log_printf("========================================\r\n");
    log_printf(" bench-pod-firmware v%s\r\n", FIRMWARE_VERSION);
    log_printf(" STM32H563ZIT6  |  console: USB-CDC + USART2 PD5/PD6 @ %lu\r\n",
           (unsigned long)CONSOLE_UART_BAUD);
    log_printf(" sysclk=%lu Hz  FreeRTOS=%s\r\n",
           (unsigned long)HAL_RCC_GetSysClockFreq(), tskKERNEL_VERSION_NUMBER);
    log_printf(" reset: %s   last crash: %s\r\n",
           fault_last_reset_str(), fault_last_crash_str());
    log_printf("========================================\r\n");
    if (s_clock_on_hsi)
        log_printf("[boot] WARNING: the 25 MHz crystal did not start; running from the internal HSI\r\n");

    /* Count this boot (safe mode after repeated failures) and arm the watchdog: from here a
       hang resets the chip instead of leaving it dark.  A power-on or the reset button starts
       the failed-boot count over. */
    {
        const char *why = fault_last_reset_str();
        const bool fresh = strcmp(why, "power-on") == 0 || strcmp(why, "pin") == 0;
        boot_guard_begin(fresh);
        esp_wifi_ctrl_restarts_boot(fresh);   /* C3 restart counts: kept through soft resets */
    }
    boot_guard_stage(BOOT_STAGE_EARLY_HW);

    /* Bring up the hardware subsystems.  Only what must happen at once runs here: the power
       bus and the target rails (a stray DUT rail is dangerous).  The iCE40, PSRAM and their
       self-test run later on the hw worker task (boot_deferred_hw_init), AFTER USB and the
       scheduler are up, so nothing they do can keep the USB console from appearing. */

    /* Identify the PCB revision FIRST: it decides the TPS2116 LA-bank mux
       polarity (inverted between v2 and v3), whether the dedicated NRST pin
       exists, and whether the USB-C CC taps exist.  Everything below that
       touches those must already know the answer.  Cheap — one GPIO test and a
       few ADC conversions on the MCU's own ADC1. */
    (void)mcu_adc_init();   /* MCU ADC1: revision strap + USB-C CC sense */
    board_rev_init();       /* latches v2/v3 from the PA3 strap             */
    cal_data_select(board_rev_get());   /* DAC/ADC fits for this revision (cal_data.h) */
    nrst_ctrl_init();       /* PF4 open-drain, released (no-op on v2)       */
    usb_cc_init();          /* CC1/CC2 analog pins   (no-op on v2)          */
    /* Bring the I2C bus + expander outputs up FIRST, before the slower SPI/XSPI
       init, so every TCA9554 output is driven to its safe (OFF) state as early as
       possible.  Both expanders power up with pins high-Z and output latch 0xFF,
       so until firmware drives them a DUT rail (eFuse EN) or a cal relay
       (U58→U53→K1..K4) can float active.  target_power_init() goes FIRST — a
       stray DUT power rail is the worst of the two — then the analog relays.
       (The complete fix for the pre-firmware window is a hardware pulldown on
       each EN / U53 IN net.) */
    i2c_bus_init();         /* I2C1 power/IO bus  */
    target_power_init();    /* eFuse EN driven OFF ASAP (glitch-sensitive) */
    efuse_flt_init();       /* FLT: a real fault, or reverse-current blocking */
    (void)ina_pod_present(); /* pod current monitor fitted? (cached for status/caps) */
    module_link_init();     /* digital v3r3: the analog module's link, I2C2 and its EEPROM */
    board_variant_init();   /* analog board, analog module or digital-only (board_variant.h) */
    /* Analog v3r2 and the analog module: a DAC8554 channel per output instead of the U55 muxes
       (dac_quad.h).  The module runs on the v3r2 calibration set until it carries its own. */
    dac_quad_set_present(dac_quad_for_board(board_rev_get(), board_has_analog(),
                                            board_analog_is_module()));
    if (board_analog_is_module()) cal_data_select(BOARD_REV_V3R2);
    if (board_has_analog())
        analog_switch_init(); /* U55 DAC mux + U58 cal switching, all off */
    dac_limits_load();      /* DAC output limits: enforced from the first command (dac_limits.h) */
    if (board_analog_is_module())
        adc_cal_hw_use_module();   /* the calibration also lives in the module's EEPROM */
    adc_cal_load();         /* per-pod ADC calibration, on top of cal_data.h (adc_cal.h) */
    pod_policy_load();      /* signature + LAN policy, before OTA or the LAN listener (pod_policy.h) */
    can_bus_init();         /* FDCAN1 term GPIO safe (core stays down until can_config) */
    boot_guard_stage(BOOT_STAGE_IDENTITY);
    device_identity_init(); /* Ed25519 identity (internal flash + RNG) */
    boot_guard_stage(BOOT_STAGE_USB);
    MX_USB_DEVICE_Init();   /* USB-CDC virtual COM port */

    /* The net task runs the lwIP poll loop AND the mbedTLS handshake for the
       outbound WSS cloud client; TLS (ASN.1/bignum) is stack-heavy, so give it
       a generous 16 KB stack.  The console task gets 4 KB: every USB-console command puts a
       1.6 KB cmd_work_t on its stack (hw_worker.c submit_u), and with 3 KB it was measured down
       to 1296 B free (status "stacks", 2026-10-04). */
    if (xTaskCreate(console_task, "console", 1024, NULL,
                    tskIDLE_PRIORITY + 1, NULL) != pdPASS ||
        xTaskCreate(net_task, "net", 4096, NULL,
                    tskIDLE_PRIORITY + 2, NULL) != pdPASS) {
        log_printf("[fatal] task create failed\r\n");
        fault_sw_panic(FAULT_SW_TASKCREATE, "main");
    }

    /* The hw worker owns all instrument hardware + command execution; the console
       and net tasks feed it work and drain its replies.  Create it after the
       subsystems it drives are initialised. */
    hw_worker_init();

    /* Arm the IWDG last, just before handing control to the scheduler: if the
       scheduler never starts (out of heap) the watchdog still resets the pod.
       The net task refreshes it once both tasks are cycling. */
    watchdog_init();
    boot_guard_stage(BOOT_STAGE_SCHEDULER);

    vTaskStartScheduler();

    /* Only reached if the scheduler could not start (out of heap). */
    Error_Handler();
    return 0;
}

/* --- deferred hardware bring-up (hw worker task, after USB is up) ------------ */
void boot_deferred_hw_init(void)
{
    if (boot_guard_skip_hw()) {
        log_printf("[boot] safe mode: iCE40/PSRAM bring-up skipped\r\n");
        cloud_extras_mark_ready();   /* no W25Q this boot: connect without a company CA or proxy */
        return;
    }
    boot_guard_stage(BOOT_STAGE_HW_INIT);
    boot_guard_sub_start(BOOT_SUB_HW);
    boot_guard_test_loop_point(BOOT_SUB_HW);   /* no-op unless `test-bootloop hw` armed it */
    signal_engine_init();   /* SPI1 to the iCE40 */
    /* signal_engine_init pinged it for a while, so a valid bitstream has loaded by now.  An iCE40
       that did not configure (blank or partial config flash) keeps hunting the flash, driving the
       lines psram_init() is about to drive: hold it in reset; the recovery below reflashes it. */
    if (!ice40_is_configured()) ice40_hold_off_bus();
    /* An output stage on the DAC (dac_limits.h) sits at full output while its input is near 0 V,
       which is where reset left it.  Park it as soon as the iCE40 can drive the DAC (SPI1 only,
       no PSRAM), not after the PSRAM self-test, which takes seconds.  On analog v3r2 every
       voltage output gets parked: the DAC8554 powers up at code 0, -12 V on the +-12 V output. */
    else {
        dac_quad_boot();
        if (dac_limits_get()->enabled) (void)dac_limits_park_now();
    }
    /* Bring up the OCTOSPI/XSPI unconditionally: the same bus hosts the PSRAM AND
       the iCE40 config flash, and the config flash must be reachable (flash-ice40)
       even when the FPGA is unconfigured. */
    (void)psram_init();
    psram_bus_handover();
    /* What the W25Q blob slots hold (blob_store.h): read once, while nothing else uses the bus. */
    (void)blob_store_init();
    cloud_extras_load();    /* company CA + proxy for the cloud link (cloud_extras.h) */
    /* Layered PSRAM datapath self-test; loads the embedded gateware when the iCE40 never
       configured (a new board) or cannot write the PSRAM. */
    psram_boot_selftest_with_recovery();
    i2c_bus_status();       /* scan + name known devices */
    /* Park again: the self-test recovery or the gateware update may have reconfigured the
       iCE40 (or it was not configured above), which resets the DAC to 0 V. */
    dac_quad_boot();
    if (dac_limits_get()->enabled) (void)dac_limits_park_now();
    boot_guard_sub_done(BOOT_SUB_HW);
    boot_guard_set_hw_ready();
    boot_guard_stage(BOOT_STAGE_RUNNING);
    cloud_client_request_caps_resend();   /* a cloud session may have announced before this */
}

/* --- clock tree: 25 MHz crystal (or HSI 64 MHz) -> PLL1 -> 250 MHz SYSCLK --- */
/* BENCHPOD_SYSCLK_MHZ (FreeRTOSConfig.h) sets PLLN for a VCO of twice the core clock from either
   PLL input (5 MHz from the crystal, 4 MHz from the HSI). */
_Static_assert((BENCHPOD_SYSCLK_MHZ * 2) % 5 == 0 && (BENCHPOD_SYSCLK_MHZ * 2) % 4 == 0,
               "BENCHPOD_SYSCLK_MHZ must give a whole PLLN from 5 and 4 MHz");
_Static_assert(BENCHPOD_SYSCLK_MHZ > 200 && BENCHPOD_SYSCLK_MHZ <= 250,
               "VOS0 and the flash latency below are set for 200-250 MHz");

bool clock_on_hsi(void) { return s_clock_on_hsi; }

/* Instruction cache, code region only.
 *
 * The H5 ICACHE caches every C-bus read of the flash, data included, not just instruction
 * fetches. Two areas must therefore never be cached:
 *  - flash this firmware erases and programs: the persistence records in the top 128 KB of
 *    the chip (flash_layout.h) and, on a 2 MB part, bank 2. A cached line would keep returning
 *    the old bytes after a write;
 *  - the system/OTP/UID area at 0x08FFF000 (see board_uid.h).
 * The MPU marks everything from the end of the code budget (0x080E0000, the linker script's
 * FLASH limit) to the end of that area as Normal non-cacheable, so the ICACHE bypasses it.
 * The in-place OTA commit rewrites the code region itself, so it turns the ICACHE off before
 * its first erase (ota_commit.c); the chip resets right after.
 * Measured on a v3r2 pod (2026-11-05): crypto and control code about 2-3x faster, a 1M-sample
 * LAN ADC read-back 5.6 s -> 3.8 s. */
static void icache_init(void)
{
    MPU_Attributes_InitTypeDef attr = {0};
    MPU_Region_InitTypeDef region = {0};

    HAL_MPU_Disable();
    attr.Number = MPU_ATTRIBUTES_NUMBER0;
    attr.Attributes = INNER_OUTER(MPU_NOT_CACHEABLE);
    HAL_MPU_ConfigMemoryAttributes(&attr);

    region.Enable = MPU_REGION_ENABLE;
    region.Number = MPU_REGION_NUMBER0;
    region.AttributesIndex = MPU_ATTRIBUTES_NUMBER0;
    region.BaseAddress = 0x080E0000UL;
    region.LimitAddress = 0x08FFFFFFUL;
    region.AccessPermission = MPU_REGION_ALL_RW;
    region.DisableExec = MPU_INSTRUCTION_ACCESS_ENABLE;
    region.IsShareable = MPU_ACCESS_NOT_SHAREABLE;
    HAL_MPU_ConfigRegion(&region);
    HAL_MPU_Enable(MPU_PRIVILEGED_DEFAULT);

    /* The reset-time invalidation runs on its own; the cache bypasses itself until it ends. Wait
       for it anyway, so the cache is in a known state before it is configured. */
    (void)HAL_ICACHE_WaitForInvalidateComplete();
    (void)HAL_ICACHE_ConfigAssociativityMode(ICACHE_2WAYS);
    (void)HAL_ICACHE_Enable();
}

static void SystemClock_Config(void)
{
    RCC_OscInitTypeDef osc = {0};
    RCC_ClkInitTypeDef clk = {0};

    /* VOS0 is required for SYSCLK > 200 MHz.  Bounded: an endless spin here would hang the
       pod before anything could report it. */
    __HAL_PWR_VOLTAGESCALING_CONFIG(PWR_REGULATOR_VOLTAGE_SCALE0);
    for (uint32_t spin = 0; !__HAL_PWR_GET_FLAG(PWR_FLAG_VOSRDY) && spin < 10000000u; spin++) { }

    osc.OscillatorType = RCC_OSCILLATORTYPE_HSE;
    osc.HSEState = RCC_HSE_ON;                   /* 25 MHz crystal on PH0/PH1 */
    osc.PLL.PLLState = RCC_PLL_ON;
    osc.PLL.PLLSource = RCC_PLL1_SOURCE_HSE;
    osc.PLL.PLLM = 5;                           /* 25/5 = 5 MHz PLL input */
    osc.PLL.PLLN = BENCHPOD_SYSCLK_MHZ * 2 / 5; /* 5 * 100 = 500 MHz VCO (EMI_SYSCLK=240: 96, 480) */
    osc.PLL.PLLP = 2;                           /* 500/2 = 250 MHz */
    osc.PLL.PLLQ = 2;
    osc.PLL.PLLR = 2;
    osc.PLL.PLLRGE = RCC_PLL1_VCIRANGE_2;       /* 4..8 MHz input */
    osc.PLL.PLLVCOSEL = RCC_PLL1_VCORANGE_WIDE; /* 192..836 MHz VCO */
    osc.PLL.PLLFRACN = 0;
    if (HAL_RCC_OscConfig(&osc) != HAL_OK) {
        /* The crystal did not start.  Nothing needs it (USB runs from HSI48, Ethernet from
           the PHY's clock), so fall back to the internal 64 MHz HSI with the SAME PLL outputs
           rather than Error_Handler(): that reset would repeat on every boot and the pod would
           never show up, not even to say what is wrong. */
        s_clock_on_hsi = true;
        RCC_OscInitTypeDef hsi = {0};
        hsi.OscillatorType = RCC_OSCILLATORTYPE_HSE | RCC_OSCILLATORTYPE_HSI;
        hsi.HSEState = RCC_HSE_OFF;
        hsi.HSIState = RCC_HSI_ON;
        hsi.HSIDiv = RCC_HSI_DIV1;                   /* 64 MHz */
        hsi.HSICalibrationValue = RCC_HSICALIBRATION_DEFAULT;
        hsi.PLL.PLLState = RCC_PLL_ON;
        hsi.PLL.PLLSource = RCC_PLL1_SOURCE_HSI;
        hsi.PLL.PLLM = 16;                           /* 64/16 = 4 MHz PLL input */
        hsi.PLL.PLLN = BENCHPOD_SYSCLK_MHZ * 2 / 4;  /* 4 * 125 = 500 MHz VCO */
        hsi.PLL.PLLP = 2;                            /* 250 MHz, as with the crystal */
        hsi.PLL.PLLQ = 2;
        hsi.PLL.PLLR = 2;
        hsi.PLL.PLLRGE = RCC_PLL1_VCIRANGE_2;        /* 4..8 MHz input */
        hsi.PLL.PLLVCOSEL = RCC_PLL1_VCORANGE_WIDE;
        hsi.PLL.PLLFRACN = 0;
        if (HAL_RCC_OscConfig(&hsi) != HAL_OK) {
            Error_Handler();
        }
    }

    clk.ClockType = RCC_CLOCKTYPE_SYSCLK | RCC_CLOCKTYPE_HCLK |
                    RCC_CLOCKTYPE_PCLK1 | RCC_CLOCKTYPE_PCLK2 | RCC_CLOCKTYPE_PCLK3;
    clk.SYSCLKSource = RCC_SYSCLKSOURCE_PLLCLK;
    clk.AHBCLKDivider = RCC_SYSCLK_DIV1;        /* HCLK = 250 MHz */
    clk.APB1CLKDivider = RCC_HCLK_DIV1;
    clk.APB2CLKDivider = RCC_HCLK_DIV1;
    clk.APB3CLKDivider = RCC_HCLK_DIV1;
    if (HAL_RCC_ClockConfig(&clk, FLASH_LATENCY_5) != HAL_OK) {
        Error_Handler();
    }
}

/* --- USART2 console ------------------------------------------------------ */
static void MX_USART2_UART_Init(void)
{
    huart2.Instance = CONSOLE_UART;
    huart2.Init.BaudRate = CONSOLE_UART_BAUD;
    huart2.Init.WordLength = UART_WORDLENGTH_8B;
    huart2.Init.StopBits = UART_STOPBITS_1;
    huart2.Init.Parity = UART_PARITY_NONE;
    huart2.Init.Mode = UART_MODE_TX_RX;
    huart2.Init.HwFlowCtl = UART_HWCONTROL_NONE;
    huart2.Init.OverSampling = UART_OVERSAMPLING_16;
    huart2.Init.OneBitSampling = UART_ONE_BIT_SAMPLE_DISABLE;
    huart2.Init.ClockPrescaler = UART_PRESCALER_DIV1;
    huart2.AdvancedInit.AdvFeatureInit = UART_ADVFEATURE_NO_INIT;
    if (HAL_UART_Init(&huart2) != HAL_OK) {
        Error_Handler();
    }
}

void HAL_UART_MspInit(UART_HandleTypeDef *huart)
{
    GPIO_InitTypeDef gpio = {0};
    if (huart->Instance == CONSOLE_UART) {
        CONSOLE_UART_GPIO_CLK_EN();
        CONSOLE_UART_CLK_ENABLE();
        gpio.Pin = CONSOLE_UART_TX_PIN | CONSOLE_UART_RX_PIN;
        gpio.Mode = GPIO_MODE_AF_PP;
        gpio.Pull = GPIO_NOPULL;
        gpio.Speed = GPIO_SPEED_FREQ_HIGH;
        gpio.Alternate = CONSOLE_UART_GPIO_AF;
        HAL_GPIO_Init(CONSOLE_UART_GPIO_PORT, &gpio);
    }
}

void Error_Handler(void)
{
    /* Record the reason and reset instead of spinning forever with IRQs off. HAL
       and SystemClock_Config call this on init failure — often before the IWDG is
       armed — so a bare while(1) here is a silent, unrecoverable hang. fault_sw_panic
       only writes the .noinit crash record and issues NVIC_SystemReset (no clock or
       peripheral dependency), so it is safe even this early; the next boot reports
       "last crash: error-handler". */
    fault_sw_panic(FAULT_SW_ERRHANDLER, "error-handler");
}

/* --- FreeRTOS hooks ------------------------------------------------------ */
/* These used to end in Error_Handler()'s while(1); now they record the reason in
   the crash log and reset, so the pod recovers and the next boot reports why. */
/* An allocation failed.  At boot that is fatal (the system cannot come up without it).  After
   boot, every caller handles NULL (a TLS handshake fails and backs off, power_profile refuses
   with "not enough memory"), so rebooting the pod for it turned a recoverable refusal into an
   outage.  Count it instead: the worker logs new failures and `status` reports malloc_failures.
   (This runs inside pvPortMalloc with the scheduler suspended: no printf here.) */
volatile uint32_t g_malloc_failures;

void vApplicationMallocFailedHook(void)
{
    if (xTaskGetSchedulerState() == taskSCHEDULER_NOT_STARTED) {
        printf("[fatal] malloc failed at boot\r\n");
        fault_sw_panic(FAULT_SW_MALLOC, "heap");
    }
    g_malloc_failures++;
}

void vApplicationStackOverflowHook(TaskHandle_t task, char *name)
{
    (void)task;
    printf("[fatal] stack overflow in task %s\r\n", name ? name : "?");
    fault_sw_panic(FAULT_SW_STACKOVF, name);
}

void vAssertCalled(const char *file, int line)
{
    printf("[assert] %s:%d\r\n", file ? file : "?", line);
    fault_sw_panic(FAULT_SW_ASSERT, file);
}

#ifdef USE_FULL_ASSERT
void assert_failed(uint8_t *file, uint32_t line)
{
    printf("[hal-assert] %s:%lu\r\n", (char *)file, (unsigned long)line);
    Error_Handler();
}
#endif
