embeddedci-com/benchpod-firmware/stm32h563/src/la_pins.h

#ifndef LA_PINS_H
#define LA_PINS_H

/*
 * la_pins — who owns each of the 14 logic-analyzer pins (LA1..LA14 on the iCE40).
 *
 * The gateware's la_bank.v resolves overlapping drivers silently, by priority
 * (swd/spi > stepper > i2c > uart > static GPIO_SET).  Nothing used to stop a UART proxy and an
 * emulated I2C sensor from sharing a channel; the loser simply did not work.  This table
 * gives every pin exactly ONE function, refuses a claim that would collide, and owns the
 * pull-resistor compatibility rules and the exact error strings (clients parse the
 * `pin conflict:` / `pull conflict:` / `trigger timeout:` prefixes — docs/API.md).
 *
 * Pure C with no hardware calls: callers pass in the engaged-pull bitmask and drive the FPGA
 * themselves (command_handler_pins.c).  Host-tested in test/test_la_pins.c.  The state is only
 * touched from the hw worker task.  Pins are 1-based everywhere; bit (la-1) in every mask.
 */
#include <stdbool.h>
#include <stddef.h>
#include <stdint.h>

#include "bp_json.h"

#define LA_PINS_COUNT 14u

typedef enum {
    LA_FN_NONE = 0,   /* LA mode: high-Z, observed by captures */
    LA_FN_GPIO,       /* `gpio` input / output / open_drain */
    LA_FN_UART_RX,    /* uart_proxy_start */
    LA_FN_UART_TX,
    LA_FN_SWD_CLK,    /* dap_start */
    LA_FN_SWD_DIO,
    LA_FN_I2C_SDA,    /* sensor_start of an I2C sensor (shared by the I2C sensors on one bus) */
    LA_FN_I2C_SCL,
    LA_FN_STEP,       /* `la` step train */
    LA_FN_STEP_DIR,
    LA_FN_SPI_SCK,    /* spi_start (the SWD engine in SPI mode) */
    LA_FN_SPI_MOSI,
    LA_FN_SPI_MISO,
    LA_FN_SPI_CS,
    LA_FN_SENSOR_TX,  /* sensor_start: a UART sensor's TX (pod to DUT, UART2) */
    LA_FN_SENSOR_RX,  /*   its RX (DUT to pod) */
    LA_FN_SENSOR_DRDY,/*   a data-ready pin */
    LA_FN_SENSOR_SCK, /*   the SPI sensor's pins (the emulated SPI target) */
    LA_FN_SENSOR_MOSI,
    LA_FN_SENSOR_MISO,
    LA_FN_SENSOR_CS,
    LA_FN_I2CM_SDA,   /* i2c_start: the I2C master (the SWD engine's third job, gateware v55) */
    LA_FN_I2CM_SCL,
    LA_FN__COUNT
} la_fn_t;

#define LA_FN_BIT(fn) ((uint32_t)(1u << (unsigned)(fn)))
_Static_assert(LA_FN__COUNT <= 32, "free_fns masks are 32-bit");

/* Pins of an emulated sensor also carry an OWNER: a bit per sensor-manager slot (several I2C
   sensors share SDA/SCL), named "sensor:<instance>" by the namer the manager registers. */
#define LA_PINS_OWNER_SLOTS 8u
typedef const char *(*la_owner_namer_t)(unsigned slot);   /* instance name, NULL = none */
void    la_pins_set_owner_namer(la_owner_namer_t namer);
void    la_pins_set_owner(unsigned la, uint8_t owner_mask);
uint8_t la_pins_owner(unsigned la);
/* Is fn one of the sensor functions (i2c_sda/scl and sensor_*)? */
bool    la_fn_is_sensor(la_fn_t fn);

typedef enum {
    LA_GPIO_NONE = 0,     /* not a gpio pin (also the parsed value of "off") */
    LA_GPIO_INPUT,        /* high-Z, level readable */
    LA_GPIO_OUTPUT,       /* push-pull, level 0/1 */
    LA_GPIO_OPEN_DRAIN,   /* level 0 drives low, level 1 releases to high-Z */
} la_gpio_mode_t;

typedef enum { LA_PULL_NONE = 0, LA_PULL_UP, LA_PULL_DOWN } la_pull_dir_t;

/* Every message this module builds fits in this many bytes (NUL included).  320, not 256: the
   voltage-change refusal listing all 14 pins by function name reaches 286 B (test_la_pins.c). */
#define LA_PINS_ERR_MAX 320u

/* Pod reboot state: every pin back to none. */
void la_pins_reset(void);

const char *la_fn_name(la_fn_t fn);
const char *la_gpio_mode_name(la_gpio_mode_t m);          /* "" for LA_GPIO_NONE */
/* "input" / "output" / "open_drain" / "off" (-> LA_GPIO_NONE).  false when unknown. */
bool        la_gpio_mode_parse(const char *s, la_gpio_mode_t *out);

la_fn_t        la_pins_fn(unsigned la);        /* LA_FN_NONE for an out-of-range pin */
la_gpio_mode_t la_pins_gpio(unsigned la);
int            la_pins_level(unsigned la);     /* commanded level of a gpio output/open_drain, else -1 */
uint16_t       la_pins_mask_fn(la_fn_t fn);    /* pins that currently have this function */
uint16_t       la_pins_owned_mask(void);       /* pins whose function is not none */

/* Fixed board resistors: LA1/LA2 4.7k up, LA3/LA4 2.2k up, LA5/LA6 10k up, LA7/LA8 10k down,
   LA9..LA14 none (ohms NULL). */
la_pull_dir_t la_pull_dir(unsigned la);
const char   *la_pull_ohms(unsigned la);

/* What GPIO_SET should hold on the pin's static latch: 0 low, 1 high, 2 high-Z.  Only a gpio
   output / open_drain-low pin drives; everything else (none, gpio input, engine functions) is
   high-Z underneath — the engines override the latch while they run. */
int la_pins_drive(unsigned la);

/* ---- checks: true = allowed; false = the client-facing message is in err ---- */

/* May `fn` (with gpio `mode` when fn is LA_FN_GPIO) claim las[0..n)?  Pins owned by a function
   in `free_fns` count as free (a replacing sensor_start, gpio mode switches).  Ownership is
   checked over all pins first, then pull compatibility against `pull_mask` (engaged pulls). */
bool la_pins_check_claim(la_fn_t fn, la_gpio_mode_t mode, const uint8_t *las, size_t n,
                         uint32_t free_fns, uint16_t pull_mask, char *err, size_t cap);
/* ---- pin direction and warnings (pin safety) ----
   The host tells the pod which way each LA pin's DUT signal goes (from the wiring profile, with
   la_dir; RAM only, unknown after a reboot).  A push-pull driver (gpio output, UART TX, SPI SCK /
   MOSI / CS, SWD, step, an emulated sensor's TX / MISO / data-ready) may not claim a pin wired to a
   DUT output, and such a pin can't be marked a DUT output while one drives it: two push-pull
   outputs would drive against each other.  Open drain (gpio open_drain, I2C) is allowed. */
typedef enum { LA_DIR_UNKNOWN = 0, LA_DIR_DUT_INPUT, LA_DIR_DUT_OUTPUT, LA_DIR_BIDIR } la_dir_t;
const char *la_dir_name(la_dir_t d);                      /* "unknown" / "dut_input" / ... */
bool        la_dir_parse(const char *s, la_dir_t *out);
la_dir_t    la_pins_dir(unsigned la);
void        la_pins_set_dir(unsigned la, la_dir_t d);
/* Does fn (gpio in `mode`) drive the pin push-pull? */
bool        la_fn_drives(la_fn_t fn, la_gpio_mode_t mode);
/* May `la` be marked `d` given its current function? */
bool        la_pins_check_dir(unsigned la, la_dir_t d, char *err, size_t cap);

/* Per-pin warnings (bits), in every pin listing as "warn": not refusals, the pod can't know them
   for sure.  PULL_VS_DRIVE: a pull is on under a push-pull output (it only costs current).
   UNPOWERED: the pod's target power is off while the pin is driven high or pulled up, which
   back-powers an unpowered DUT through its I/O pins (fine when the DUT has its own supply). */
#define LA_WARN_PULL_VS_DRIVE  0x01u
#define LA_WARN_UNPOWERED      0x02u
/* The pod's target power, for LA_WARN_UNPOWERED (set before a listing; default on). */
void        la_pins_set_target_powered(bool on);
uint8_t     la_pins_warnings(unsigned la, uint16_t pull_mask);

/* May the pull on `la` be engaged, given the pin's current function? */
bool la_pins_check_pull_enable(unsigned la, char *err, size_t cap);
/* Are all pins gpio output / open_drain (so a level can be set)? */
bool la_pins_check_level(const uint8_t *las, size_t n, char *err, size_t cap);
/* May the LA bank switch from cur_mv to new_mv?  Refused while any pin is owned, unless the
   voltage does not change.  An invalid new_mv is allowed here (the caller rejects it). */
bool la_pins_check_voltage_change(int cur_mv, int new_mv, char *err, size_t cap);

/* ---- commits (no checks) ---- */
void     la_pins_claim(la_fn_t fn, la_gpio_mode_t mode, uint8_t level,
                       const uint8_t *las, size_t n);
void     la_pins_set_level(unsigned la, uint8_t level);
void     la_pins_release(unsigned la);
uint16_t la_pins_release_fn(la_fn_t fn);   /* releases every pin with fn; returns their mask */

/* ---- the `gpio` command ---- */
typedef struct {
    uint8_t        las[LA_PINS_COUNT];   /* de-duplicated, request order */
    size_t         n;
    bool           all;                  /* "la":"all" */
    bool           has_mode;
    la_gpio_mode_t mode;                 /* LA_GPIO_NONE = "off" */
    bool           has_level;
    uint8_t        level;
} la_gpio_req_t;

/* Parse {"cmd":"gpio","la":N|[N,...]|"all","mode":...,"level":0|1}.  "la" may be absent only
   for a read (no mode, no level).  A JSON null counts as absent. */
bool la_gpio_req_parse(const char *json, la_gpio_req_t *req, char *err, size_t cap);
/* Validate the WHOLE mode/level request, then commit it (on any error nothing changes).
   *changed = pins whose GPIO_SET drive must be re-sent (see la_pins_drive); *affected = pins
   to report back.  A read request (no mode, no level) is not handled here. */
bool la_pins_gpio_apply(const la_gpio_req_t *req, uint16_t pull_mask,
                        uint16_t *changed, uint16_t *affected, char *err, size_t cap);

/* ---- `la` step trains ---- */
typedef struct {
    bool claim_step;   /* step pin was none: claim `step` for the train */
    bool claim_dir;    /* dir pin was none: claim `step_dir`, drive it, release after */
} la_step_plan_t;
/* la 1..14; dir_la 0 = no direction pin.  A gpio output pin is used without changing its
   ownership (the train pulses it / the direction sets its level); none is claimed; anything
   else is a conflict. */
bool la_pins_plan_step(unsigned la, unsigned dir_la, la_step_plan_t *plan, char *err, size_t cap);

/* Step train bounds.  steps and delay_us are 16-bit fields in the gateware (cmd_dispatch
   GPIO_STEP: [channel][steps(2)][delay_us(2)], stepper_engine.v), so both cap at 0xFFFF.
   delay_us is microseconds per HALF-phase: a full step period is 2 * delay_us. */
#define LA_STEP_MIN_DELAY_US 4u
#define LA_STEP_MAX_DELAY_US 65535u
#define LA_STEP_MAX_STEPS    65535u
/* A plain decimal string ("70000", not "7e4", "-1" or "12x") into *out; false if it is not one
   or does not fit 32 bits.  atoi() read "1e5" as 1 step. */
bool la_step_parse_u32(const char *s, uint32_t *out);
/* steps and delay_us inside the bounds above; else false with a message that names the range. */
bool la_step_args_ok(uint32_t steps, uint32_t delay_us, char *err, size_t cap);

/* ---- JSON ---- */
/* {"la":1,"function":"none","gpio":null,"level":null,"pull":{"dir":"up","ohms":"4.7k","on":false}} */
void la_pins_emit_entry(bp_emit_t *e, unsigned la, uint16_t pull_mask);
/* [entry,...] for every pin in `mask`, ascending. */
void la_pins_emit_list(bp_emit_t *e, uint16_t mask, uint16_t pull_mask);

/* ---- capture trigger ("trigger":{"la":N,"edge":...}, "trigger_timeout_ms":N) ---- */
typedef enum {
    LA_EDGE_RISING  = 1,   /* values are the gateware SET_TRIGGER mode byte */
    LA_EDGE_FALLING = 2,
    LA_EDGE_HIGH    = 3,
    LA_EDGE_LOW     = 4,
} la_edge_t;

#define LA_TRIGGER_TIMEOUT_DEFAULT_MS 10000u
#define LA_TRIGGER_TIMEOUT_MAX_MS     600000u

typedef struct {
    bool      present;
    uint8_t   la;           /* 1..14 */
    la_edge_t edge;
    uint32_t  timeout_ms;
    uint32_t  pre_samples;  /* trigger.pre_samples: samples to keep before the trigger (la_capture, gw >= v50) */
} la_trigger_t;

const char *la_edge_name(la_edge_t edge);
/* present=false when the request has no "trigger" (or it is null). */
bool la_trigger_parse(const char *json, la_trigger_t *out, char *err, size_t cap);
/* "trigger timeout: no rising edge on LA9 within 10000 ms" */
void la_trigger_timeout_msg(const la_trigger_t *t, char *buf, size_t cap);
/* "trigger":{"la":9,"edge":"rising","fired":true}  (no leading comma) */
void la_trigger_emit(bp_emit_t *e, const la_trigger_t *t, bool fired);

#endif /* LA_PINS_H */
