embeddedci-com/benchpod-firmware/motor-emulator/ecp5/src/encoder.v

// encoder.v — rotor-position encoder emulation from the motor model's angle (one clock, no CDC).
//
// Mechanical angle. The model integrates the electrical angle theta (32 bits per electrical
// revolution). The encoder counts electrical revolutions modulo the pole pairs (erev, from the
// wrap of theta between ticks) and divides once per tick:
//   mech  = floor((erev x 2^16 + theta[31:16]) / POLES)        (16 bits per mechanical revolution)
//   angle = (DIR ? -mech : mech) + OFS                          (ENC_ANGLE; SPI and ABZ use it)
// so POLES x mech tracks theta exactly, with no drift however long it runs. theta must move less
// than 1/4 electrical revolution per tick (1/4 rev per 5 us is 3M eRPM).
//
// ABZ. The generator keeps its own angle g (16 bits) and chases the angle in steps of 2 LSB:
// each tick it takes the distance angle - g (modular, so the short way round for free) and
// spreads those steps evenly over the next PWM period (Bresenham against the period, at most one
// step per clk: 72M LSB/s, 66k RPM mechanical). So the outputs lag the angle by one tick and the
// edges come at an even rate. Each step adds +-2 x CPR to r = g x CPR mod 2^16; the carry or
// borrow steps the count, so count = floor(g x CPR / 2^16) exactly (CPR <= 32764). Quadrature
// states 0-3 = A/B 00, 10, 11, 01 (A leads B counting up); Z is high for the one state at count 0
// (A = B = 0), the AS5047P and MA730 default index. CPR is used as a multiple of 4 (minimum 4).
// Writing ENC_CPR restarts the generator at g = 0, count 0: it then walks to the angle at up to
// one PWM period of steps per tick.
//
// SPI slave, oversampled at 36 MHz. The next bit goes on MISO 2-3 clk after the DUT's sampling
// edge, and the first bit is on MISO while CS is still high, so the limit is one SCK period
// >= ~110 ns (SCK <= 8 MHz). Profiles (ENC_CTRL[3:2]):
//   0 AS5047P, 1 AS5048A: mode 1, 16-bit frames, even parity, the response in the next frame;
//     error flags (parity, invalid command, framing) with EF sticky until the error register
//     (0x0001) is read; a write is a command frame then a data frame (MISO: the old content,
//     then the new content in the following frame).
//   2 MA730: mode 0 or 3; every frame returns the 16-bit angle (partial reads fine); 010aaaaa
//     xxxxxxxx reads register a, 100aaaaa vvvvvvvv writes it; the value comes back on MISO[15:8]
//     in the next frame.
// Register file (64 x 16, block RAM; BenchPod reads and writes it through ENC_RF_ADDR/RF_DATA):
// 0x00-0x1F the MA730's registers, 0x20 + a the AS504x registers at 0x0000-0x001F, 0x3C-0x3F the
// AS504x registers at 0x3FFC-0x3FFF (DIAAGC / MAG / diagnostics: what BenchPod puts there is what
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
