embeddedci-com/benchpod-firmware/(commit log)

2026-09-21 Fix release-stm32.yml: repo was renamed, workflow guard wasn't updated
    github.repository == 'embeddedci-com/bench-pod-firmware' never matched
    the actual (renamed) repo 'embeddedci-com/benchpod-firmware', so the
    release job silently skipped on every tag push and workflow_dispatch.
    Also drop the now-unneeded FIRMWARE_RELEASE_TOKEN cross-repo PAT —
    source and release target are the same repo now, so the default
    GITHUB_TOKEN with contents: write is sufficient.
2026-09-21 release-stm32.yml: fetch the ESP32-C3 esp-hosted slave blob before building
    The STM32 build .incbin's a vendored, gitignored binary
    (esp32-hosted-slave/prebuilt/esp32c3-hosted-slave-merged.bin) and fails
    loudly asking for `make fetch` when it's missing. The release workflow
    never had a step producing it, so "Build STM32 firmware" always failed
    once the repo-name guard fix let the job actually run. Add the fetch
    step (ESP-IDF Docker build via the existing Makefile target), cached
    on the build recipe so only a recipe change re-triggers it.
2026-09-21 release-stm32.yml: free runner disk space before the ESP-IDF Docker build
    The Docker pull/build for the ESP32-C3 esp-hosted slave image (submodules
    and all) ran out of disk on ubuntu-latest: "no space left on device"
    unpacking an openthread/mbedtls pack file. The stock runner image reserves
    most of its disk for Android/.NET/Haskell tooling this build never uses;
    reclaim it up front.
2026-09-21 ESP32-C3 slave: enable CONFIG_APP_REPRODUCIBLE_BUILD, fix sha256
    The Docker build (build.sh) was never actually reproducible: ESP-IDF
    embeds the compile date/time into the app image header by default, so
    identical source built at different times produced different bytes.
    The committed sha256 could only ever match the exact local binary it
    was generated from — a fresh `make fetch` (locally or in CI) always
    failed the integrity check.
    Set CONFIG_APP_REPRODUCIBLE_BUILD=y in sdkconfig.defaults.board (the
    file build.sh actually copies into the project — the top-level
    sdkconfig.defaults is unused, its values just happen to already match
    upstream defaults). Verified reproducible by building tw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
2026-09-21 ESP32-C3 slave: pin transitive component deps via committed lock
    CONFIG_APP_REPRODUCIBLE_BUILD only removes build-instruction
    nondeterminism (timestamps, absolute paths) — it doesn't pin *which*
    component versions get pulled. idf.py create-project-from-example
    resolves mqtt/iperf/ping-cmd/wifi-cmd/etc. from the Espressif
    component registry fresh on every build and writes a fresh, never-
    committed dependencies.lock, so a build run at a different time (or
    on a different machine, e.g. CI vs local) can silently resolve
    different transitive versions and produce different bytes even with
    identical top-level pins and identical source.
    Commit the lock generated by a local build and have build.sh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
2026-09-21 release-stm32.yml: temporarily upload the ESP32-C3 build for diffing
    The sha256 check still fails on CI even with the pinned
    dependencies.lock (same output size as a local build, different
    hash) — need the actual bytes to root-cause instead of guessing
    further. Debug-only; revert once resolved.
2026-09-21 stm32h563/Makefile: make the ESP32-C3 sha256 check advisory on a fresh build
    Diffed a CI build against a local build byte-for-byte: of 1,097,568
    bytes, only 65 differ, in exactly two 32-byte clusters — the
    esp_app_desc_t.app_elf_sha256 field ESP-IDF embeds in the image, and
    esptool's whole-image trailer checksum (which necessarily changes as
    a knock-on effect of the first). The actual compiled firmware content
    is byte-identical; CONFIG_APP_REPRODUCIBLE_BUILD doesn't cover that
    one self-referential hash field, and that's not something this repo
    controls.
    Hard-failing the release over a difference with no functional effect
    would block every release. Keep the sha256 check as a hard gate on
    E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
2026-09-21 fixing first time flash issues
    [boot_guard.c, boot_guard.h, cloud_client.c, console.c, hw_worker.c, ice40_flash.c, ice40_flash.h]
2026-09-21 stm32h563: read the unique ID as words only, and prove safe mode
    The first v3 pod went dark three times in a row after flashing: no USB,
    recoverable only with BOOT0. Proven on the hardware since: a byte read of
    the H5 unique-ID area is a precise bus fault (ldrb at 0x08fff800,
    cfsr=0x00008200, bfar=0x08fff800). The Ethernet MAC code read it
    byte-wise in the net task, so every boot crashed before USB enumerated.
    - board_uid.h: board_uid_words() is the only reader of the UID, as whole
    words. The USB serial number and the Ethernet MAC both use it.
    - make all runs check-uid, which fails the build if any other file
    touches UID_BASE.
    - Crash records name the task that was running (FreeRTOS cur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
    [board_uid.h, boot_guard.c, boot_guard.h, console.c, fault.c, main.c]
2026-09-21 Safe mode turns off only what failed and reports itself
    Safe mode used to turn off networking and the iCE40/PSRAM whatever broke, so a pod
    crash-looping in the iCE40 bring-up vanished from the network. boot_policy (pure,
    host-tested) now picks the culprit: the crashed task ("net"/"hw"), else a bring-up that
    started but never finished, else both. Later safe boots keep what earlier ones turned off.
    - net task records NET_INIT before anything that can crash (incl. the test hook)
    - test-bootloop [net|hw] yes; plain `test-bootloop yes` stays the net test
    - with the iCE40/PSRAM off, commands that need them are refused with a clear error
    - JSON status: safe_mode, safe_reason (reset/last_crash unch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
    [boot_guard.c, boot_guard.h, boot_policy.c, boot_policy.h, cloud_client.c, command_handler.c, console.c, fault.c]
2026-09-21 fix slow adc api
    [cloud_client.c, command_handler.c]
2026-09-22 Flash the ESP32-C3 when Wi-Fi finds it empty, and let flash-esp32 finish
    A v3 pod ships with a blank C3, so Wi-Fi sat in "waiting-slave" forever and
    the getting-started Wi-Fi steps could not work. Now, when the C3 sends no boot
    event 20 s after Wi-Fi starts, the worker writes the embedded esp-hosted image
    once (state "flashing-c3"; wifi-set re-arms it) and Wi-Fi starts again.
    flash-esp32 could never complete before:
    - The flash takes ~140 s at 115200 baud and the worker's watchdog grace is
    60 s, so the pod reset mid-flash (reset: iwdg). Heartbeat per block.
    - Wi-Fi control's backoff released the C3's reset mid-flash and knocked it
    out of its ROM loader. The console C3 commands now pause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
    [console.c, esp_rom_flash.c, esp_wifi_ctrl.c, esp_wifi_ctrl.h, hw_worker.c, hw_worker.h]
2026-09-22 Add LA13/LA14 as full GPIO/LA channels on v3
    J1 pins 13/14 were already routed on the board and driven by la_bank
    (engine_block's N=14 was already the v2 default), but the readback path
    was hardcoded to 12 bits: engine_block's la_sample/la_levels, cmd_dispatch's
    GPIO_GET packing, and la_psram_capture's N parameter. Widen all three to 14
    (gateware v36), and match on the firmware side: LA_PINS_COUNT/LA_CHANNEL_MAX
    12->14, plus the coupled cloud-reply buffer sizes for the now-larger la_pins
    listing.
    Deep-replay image's pinned PnR seed no longer closed clk48 timing after the
    width change; re-swept and re-pinned SEED_DEEP 13->14 (51.13 MHz margin).
    HW-verified: flashed to benchpod-baea06, GPIO_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
    [bp_limits.h, cmd_dispatch.v, command_handler.c, command_handler_pins.c, engine_block.v, la_bank.v, la_pins.c, la_pins.h]
2026-09-22 Fix gateware CI after LA13/LA14: 14-bit testbenches, regenerate PROTOCOL.md
    tb_top_v2 still expected VERSION 35, and PROTOCOL.md was not regenerated
    after the GPIO_GET description changed, so the Tests workflow has failed
    since v36. The LA testbenches drove 12-bit words, so they passed without ever
    touching LA13/LA14. They now drive all 14 pins, and tb_top_capture triggers on
    LA14 (reverting the trigger vector to 12 bits makes it time out).
    [tb_dispatch_args.v, tb_la_psram_capture.v, tb_top_capture.v, tb_top_v2.v]
2026-09-22 Log what the wired link is doing when DHCP fails
    A pod stuck at "still no lease" said nothing about the PHY, the MAC or
    whether frames arrived, so a bad cable, a duplex mismatch, a starved RX
    pool and a silent DHCP server all looked the same.
    - "eth link up" now prints the negotiated mode and the partner's ability.
    - Every "no lease" line is followed by an "eth diag" line: PHY link and
    autoneg state, PHY and MAC modes (a mismatch is flagged), symbol errors,
    frames received (all, broadcast, unicast), CRC and alignment errors,
    DMA-missed frames, RX pool exhaustion, frames sent and collisions.
    - "eth errors" prints when an error counter grows, at most every 10 s,
    and "eth receive stall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
    [command_handler.c, console.c, eth_diag.c, eth_diag.h, ethernetif.h, net_server.c, net_server.h]
2026-09-22 Fix the host test build: test_la_pins lost its compile line
    65fc8fe inserted the test_eth_diag rule between test_la_pins' target and
    its recipe, so test_la_pins was never built. Local runs passed on a stale
    binary; CI has failed since.
2026-09-22 Reply over the interface a request arrived on
    lwIP's ip4_route() returns the first netif whose subnet holds the
    destination, and netif_add() prepends, so with eth and Wi-Fi on one LAN
    subnet every reply left over Wi-Fi -- including replies on TCP
    connections that arrived on the wire.
    net_route.c is the choice on its own, with no lwIP types, so it can be
    tested on the host: source address wins first, then the first usable
    interface whose subnet holds the destination in priority order (eth
    first), then -1 to let lwIP fall back to the default route. net_server.c
    installs it as LWIP_HOOK_IP4_ROUTE_SRC and also puts eth back at the
    head of netif_list, so lwIP's own subnet scan (ICMP errors, anyt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
    [lwipopts.h, net_route.c, net_route.h, net_server.c]
2026-09-22 Add `eth speed` to force 10/100 Mbit, to tell a bad link from a bad network
    A pod that never got a DHCP lease showed a healthy PHY (link up, autoneg done,
    100M full, no CRC/align/missed errors) while receiving only broadcast and no
    unicast, so nothing on the pod said whether its own frames reached the switch.
    `eth speed <auto|10|100> [full]` on the console, or {"cmd":"eth","action":
    "speed","mbit":10} over JSON, writes the PHY's BCR directly. 10BASE-T swings
    about 5x the voltage at a quarter of the symbol rate and tolerates a far looser
    reference clock, so a link that works at 10M and fails at 100M accuses the
    analog path (magnetics, RJ45, the 25 MHz reference) rather than the MAC, the
    driv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
    [command_handler.c, console.c, ethernetif.h, net_server.c, net_server.h]
2026-09-22 Add `eth refclk`: measure the PHY's RMII clock against the MCU crystal
    100BASE-TX needs the transmit reference within +/-50 ppm while 10BASE-T
    tolerates far more, so a PHY whose clock is off fails at 100M, works at 10M,
    and fails on transmit only (receive recovers its clock from the wire). From the
    MAC's counters that looks exactly like damaged magnetics.
    `eth refclk` on the console, or {"cmd":"eth","action":"refclk"} over JSON,
    re-muxes PA1 from ETH_REF_CLK to TIM2_CH2, counts its edges for a ~200 ms gate
    timed by the DWT cycle counter, and puts the pin and the link back. Reported as
    Hz plus ppm against 50 MHz, with a warning when the MCU ran off the internal HSI
    because the crystal did no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
    [command_handler.c, console.c, ethernetif.h, net_server.c, net_server.h]
2026-09-22 Add `eth loopback`: PHY near-end loopback to split digital from analog faults
    A link that fails at 100M and works at 10M can be the RMII lines and the PHY's
    digital side, or its analog front end, magnetics and jack. From the MAC's
    counters the two look the same.
    `eth loopback <10|100> [n]` on the console, or {"cmd":"eth","action":
    "loopback","mbit":100,"n":200} over JSON, puts the LAN8742 in near-end
    loopback, sends n frames addressed to our own MAC with a sequence number and a
    bit-toggling payload, and compares each one byte for byte on the way back, plus
    the MAC's CRC and alignment error deltas. Loopback never reaches the analog
    side, so a failure here is on the RMII/digital side.
    HW: a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
    [command_handler.c, console.c, ethernetif.h, net_server.c, net_server.h]
2026-09-22 Drive the RMII pins at VERY_HIGH speed, not LOW: fixes 100M transmit
    Every ETH pin was configured with GPIO_SPEED_FREQ_LOW, the slowest slew the
    STM32 has, on 50 MHz RMII lines where the LAN8742 (REF_CLK-out mode) samples
    TXD0/TXD1/TX_EN with about 4 ns of setup in a 20 ns period. That left transmit
    timing marginal on every board and broke it on one: at 100M it never got a DHCP
    lease or lost 50-75% of pings, while 10M worked (each dibit is held for 10
    clocks) and receive worked (those pins are MCU inputs).
    On that pod the PHY loopback test went from 0/200 frames back at 100M to
    200/200 intact, and it now gets a lease at 100M full on every boot with its
    error counters at zero. A known-good p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
2026-09-25 iCE40 v37: reclaim 93 LC in the loop image, 99 in the deep image
    The loop image sat at 84% LC, where seeds start failing to place. This is
    the first, low-risk pass: 24 MHz logic only, no clk48 logic and no clock
    crossing touched.
    - SWD nRESET on an LA channel is gone from swd_engine and la_bank. nRESET is
    the pod's own pin on v3 and the firmware has always sent SWD_ARM's third
    byte as 0xFF, so the driver was dead. The byte is still accepted and now
    ignored; the wire format is unchanged.
    - uart_engine's bit counters reload div and expire at 1 instead of div-1 and
    0: the same clocks per bit without two 18-bit subtractors. tb_uart_engine
    now checks the exact bit period on the wire, a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
    [cmd_dispatch.v, engine_block.v, la_bank.v, swd_engine.v, tb_dispatch_args.v, tb_top_v2.v, tb_uart_engine.v, top_v2.v]
2026-09-25 iCE40 v38: closed loop crossing made safe, no more torn DAC frames
    Two problems in the loop image, both on the clk48 side of the design.
    Torn DAC frames. dac8551_engine takes a stream sample as two pops, low byte
    then high byte, and dac_loop served both from `v`. A tick landing between the
    two pops sent {new high, old low}: 0x00FF -> 0x0100 went out as 0x01FF. The
    loop drives real power, so that is a real output glitch. dac_loop now serves
    each frame from `vf`, a copy of v taken when the high byte pops. The new
    tb_dac_loop_frames (real loop + real DAC engine, frames decoded off the pins)
    found 176 of 1111 frames torn before the fix and none after.
    Untimed parameter reads. The loop read k/v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
    [cmd_dispatch.v, dac_loop.v, engine_block.v, tb_dac_loop_frames.v, tb_top_capture.v, tb_top_v2.v, top_v2.v]
2026-09-25 iCE40 v39: loop telemetry crosses into clk through cdc_pulse_payload
    DAC_PROBE, DAC_LOOP_IN_PROBE and STATUS bit 6 (tripped) read the clk48 control
    loop from the clk domain. Until now loop_v and loop_in were copied by plain clk
    flops off clk48 registers every cycle, and `tripped` went straight into the
    STATUS reply: untimed crossings that could catch a value mid-change. Telemetry
    only, the DAC output was never affected.
    dac_loop now publishes {v, in, tripped} as one snapshot on its tick commit (or
    an arm/disarm), raises tlm_stb, and holds the snapshot >= 12 clk48 even at the
    shortest tick. top_v2 carries it with cdc_pulse_payload like every other
    crossing. `in_used` is now the input of the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
    [dac_loop.v, tb_dac_loop_frames.v, tb_top_capture.v, tb_top_v2.v, top_v2.v]
2026-09-25 iCE40 v40: protocol-level LC pass (tier 2); shelve the tri-master
    Loop image 4405 -> 4197 LC (83% -> 79%), deep 3872 (77% -> 73%). This pass
    changes the SPI protocol between the STM32 and the iCE40, so the firmware
    changes with it; it keeps the old encodings for gateware < 40.
    Gateware:
    - START_CAPTURE 0x20, START_MEASURE 0x30 and LA_CAPTURE 0x69 are retired
    (ignored). Every capture is OP_CAPTURE with the absent producer's count 0;
    measure is DAC_ARM_ON_CAPTURE + START_DAC + OP_CAPTURE, whose co-trigger
    starts the DAC on the capture's t0, the cycle MEASURE used. A producer with
    count 0 keeps its divider: the ADC one also paces the free-running ADC that
    ADC_PROBE and the control lo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
2026-09-25 iCE40 v41: counters in DSP blocks (tier 3), deep image's clk48 fixed
    Loop image 4197 -> 3909 LC (79% -> 74%), deep 3872 -> 3615 (73% -> 68%). The
    deep image's clk48 margin is fixed structurally instead of seed-hunted: all 24
    swept seeds close and 22 reach MIN_CLK48_MHZ (v40: 5 of 32).
    DSP counters (tier 3). dsp_counter wraps one SB_MAC16 as a loadable 32-bit
    up/down counter whose carry-out is a free != 0 / all-ones test. It replaces
    the stop-after countdown, the ADC and LA sample countdowns and the PSRAM
    writer's two address counters; cycle-identical (tb_dsp_counter checks it
    against the fabric counter). Stop-after keeps its one-shot clear with a 1-bit
    armed flag.
    yosys pitfall. yosys 0.65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
    [check_dsp.py, dac_psram_reader.v, dsp_counter.v, la_psram_capture.v, psram_dual_writer.v, psram_pads.v, sb_mac16_keep.v, tb_dac_psram_reader.v]
2026-09-25 iCE40: seed sweep script, and a workflow that runs it in CI's toolchain
    Seed sweeps were ad hoc shell loops, and they only ever ran in the local
    Homebrew toolchain. CI's OSS CAD Suite places the same sources
    differently (v41: CI loop fell back off the pinned seed, deep closed at
    48.90 MHz), so a locally pinned seed says nothing about CI, and
    ICE40_PNR_STRICT could not be turned on.
    synth/seed_sweep.sh runs the Makefile's exact nextpnr flags on a range
    of seeds in parallel and prints a table sorted by clk48 margin
    (make seed-sweep IMAGE=loop|deep). The ice40-seed-sweep workflow runs
    the same script on CI's pinned toolchain and uploads its netlists, so
    seeds can be pinned that are good in bot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
2026-09-25 iCE40 v42: stepper counters in the last DSP, DAC engine clock enables
    The loop image had one SB_MAC16 left. The stepper's us_left and
    steps_left now share it as two independent 16-bit counters
    (src/dsp_counter2.v; the top half's carry-out is the free != 0 test).
    Measured against the alternatives with flat synthesis + packing: the LA
    divider (-48 LC), the ring pointers (-32) and the I2C watchdog (-14) all
    saved less. Loop 3909 -> 3846 LC, deep 3615 -> 3568. tb_stepper now
    compares the engine against the v41 one (sim/stepper_engine_ref.v)
    cycle for cycle over random trains, re-arms and resets.
    That change dropped the loop image from 12/24 seeds reaching
    MIN_CLK48_MHZ to 2/48, and the same net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
    [check_dsp.py, dac8551_engine.v, dsp_counter2.v, stepper_engine.v, stepper_engine_ref.v, tb_dsp_counter.v, tb_stepper.v, tb_top_v2.v]
2026-09-25 Firmware: abort fabric captures on timeout and disconnect
    From the stability review, each traced in the code:
    - A closed connection only forgot a v2 or LA capture, and did not
    handle capture_dual at all. The fabric kept writing PSRAM with the
    gate free, and a forgotten capture_dual streamed its result into the
    dead connection when it finished, holding the bus and the gate until
    the slot was reused. Now every capture owned by the connection is
    aborted in the fabric, and a measure's DAC is stopped.
    - Capture timeouts reported failure but left the fabric capturing; they
    abort it too. fpga_capture_abort waits (bounded) for the writer to go
    idle, since the writer does not watch bus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
    [cloud_client.c, command_handler.c, console.c]
2026-09-26 iCE40 v43: writer honours bus_own, loop telemetry snapshot; v42+v43 HW-tested
    From the stability review, two gateware fixes:
    - psram_dual_writer never read bus_own. If the STM32 took the bus mid
    capture, the writer kept bursting into tristated pads, lost the data
    silently, and could come back mid-burst with CS already low, so the
    PSRAM took data as a command. Now no burst starts and nothing is
    popped while the STM32 owns the bus, and a burst it cuts is closed
    and raises the sticky capture-overflow STATUS bit, so the firmware
    fails that capture. tb_psram_dual_writer cuts a burst and checks CS,
    one bus_lost pulse, and that the stream resumes at its address.
    - dac_loop's telemetr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
    [dac_loop.v, psram_dual_writer.v, tb_dac_loop_frames.v, tb_psram_dual_writer.v, tb_top_v2.v, top_v2.v]
2026-09-26 Firmware: stability fixes from the review, and STATUS bit 6
    - STATUS bit 6 is LOOP_TRIPPED (gw >= 30), but fpga_status_read and
    cap_overflowed still treated bits 7:6 as reserved. On a tripped loop
    every STATUS read failed, so the trip could never be reported and
    every capture failed as "iCE40 not responding". Only bit 7 is
    reserved now.
    - The trip, a UART RX overflow and the SWD engine state are surfaced:
    dac_loop_probe "tripped", status "loop_tripped" / "uart_rx_overflow";
    a feed to a disarmed SWD engine ends the session instead of handing
    stale reply bits to OpenOCD (swd_ll reads missing samples as no ACK).
    - UART proxy TX: writes of more than the FPGA's 256-byte FIFO were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
    [command_handler.c, ice40_flash.c, ice40_flash.h, main.c]
2026-09-26 Firmware: stability pass over the STM32 side (survey items 1-16)
    Each item was traced in the code first; the HIGH ones were confirmed by
    reading them myself.
    - `eth refclk` reprogrammed TIM2, which is the microsecond time base
    (pico_compat), so every deadline, ping and timeout stopped until
    reboot. It measures with TIM5 (PA1 AF2) now.
    - Close, tunnel-reset and OTA end/abort/commit work items were dropped
    when the worker queue was full, which is exactly when a FIN follows a
    bulk upload; the next client on the slot inherited upload mode, SWD
    or the busy gate. A teardown that does not fit is parked and applied
    once the queue drains (bytes for that id are refused meanwhile), the
    s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
    [bp_json.c, bp_json.h, can_bus.c, can_bus.h, cloud_client.c, cloud_client.h, cloud_config.c, cloud_config.h]
2026-09-26 Firmware: OTA size limit, identity key read, SPI floor, reply escaping
    - OTA_MAX_SIZE was the whole 2 MB, but ota_commit erases up to the
    image size and above 0x081F0000 sit the config slots and the device
    identity key: an oversized image would wipe the key the pod is
    registered with. The limit is now 0x1F0000, where the linker's
    firmware region ends (host test: exactly that accepted, +1 refused).
    - The identity key is read through the ECC-checked path, and an
    unreadable key sector no longer falls through to "no key": that
    generated a new key over the registered one. The pod runs without an
    identity instead and says why.
    - SPI to the iCE40 is floored at /128 (1.95 MHz, the boot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
    [command_handler.c, console.c, device_identity.c]
2026-09-26 Firmware 3.2.0
    Gateware v43 (hardware-tested, promoted), the review's gateware and
    firmware stability fixes, and the STM32 stability pass.
2026-09-28 Firmware: DAC output limits for an external output stage
    For a solar simulator whose input is inverted (0 V on the DAC = full
    output, ~45 V). New dac_limits command stores {path, inverted, min_mv,
    max_mv} in its own power-loss-safe A/B store (s118/s119, carved from
    the top of FLASH_BLOBS: region 1344K -> 1328K, OTA_MAX_SIZE lowered to
    match). While set, one check at command dispatch covers LAN, cloud
    tunnel and cloud commands, and the USB console words get the same:
    - dac_out on the limited path must stay inside the window
    - dac_control_loop vmin/vmax must sit inside it; no in_trip when
    inverted (it trips to vmin = highest output)
    - inverted: routes that disconnect the path are refused
    -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
    [cloud_client.c, command_handler.c, config_store.h, console.c, dac_limits.c, dac_limits.h, dac_limits_hw.c, flash_compat.c]
2026-09-28 Console: print DAC limits refusals in full
    op() formats into 160 bytes and cut the refusal off mid-sentence; write
    them straight through out() instead.
2026-09-29 iCE40 v44: SPI master as the SWD engine's second job
    SPI_ARM (0x55) puts swd_engine in SPI mode on four LA channels: SCK and
    MOSI on the SWD clk/dio slots, a new CS column in la_bank, MISO read back
    through la_in. SWD_FEED queues up to 512 bytes in a second BRAM that the
    engine shifts out MSB first at 24 MHz / (2 * half), half 2..63; SWD_READ
    returns the bytes clocked in. SPI_CS (0x56) drives CS, SPI_STATUS (0x57)
    reports armed/busy. Modes 0 and 3. SWD_DISARM ends either job.
    tb_top_spi drives a W25Q-style flash model through the whole top (JEDEC
    ID, page program, sector erase, read) in mode 0 at half 2 and mode 3 at
    half 40 on other channels, checks setup/hold and SCK phase widths on the
    p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
2026-09-29 Firmware: SPI master on the LA pins, SPI flash programming
    New JSON commands for gateware v44's SPI master:
    spi_start / spi_stop / spi_status claim four LA pins (spi_sck,
    spi_mosi, spi_miso, spi_cs) and arm the SWD engine in SPI mode
    spi_xfer raw full-duplex transfer, up to 768 bytes, CS held across
    commands on request
    spi_flash id / read / erase / write (+verify) / chip_erase for
    25-series NOR flash, 3-byte addressing
    spi_flash.c is transport-independent and host-tested against a flash
    model (paging, 64K/4K erase choice, write protect, stuck WIP, 8-byte
    transport chunks). Commands and replies fit one cloud frame, so this
    works over the cloud channe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
    [cloud_client.c, command_handler.c, command_handler_internal.h, command_handler_spi.c, la_pins.c, la_pins.h]
2026-09-29 Firmware: spi_xfer cs default, clearer dap_start refusal
    bp_json_get clears its output when the key is missing, so spi_xfer
    without "cs" failed with "cs must be release or hold". dap_start while
    an SPI session holds the engine now says so instead of "swd busy".
    HW-checked on benchpod-baea06 (rev3, gw v44): the pod's own LA capture
    of its SPI pins shows the sent bytes on MOSI at 1 MHz mode 0 and 6 MHz
    mode 3, CS low for the transfer, SCK idling at CPOL; SWD and SPI refuse
    each other and hand over after spi_stop / the DAP connection closing;
    spi_flash id/write/erase on an empty bus report "present":false and
    refuse to write.
    [command_handler.c, command_handler_spi.c]
2026-09-29 iCE40 v44: pin seeds good in both toolchains
    CI's sweep (OSS CAD Suite) on the v44 netlist: loop 45/64, deep 64/64.
    The best local loop seed (51) misses 48 MHz in CI, so SEED_LOOP 58
    (clk48 52.96 local / 52.59 CI) and SEED_DEEP 6 (53.73 / 51.93); both
    keep clk -> clk48 under 13 ns. Fallback lists are the seeds good in
    both, ordered by the lower clk48.
    HW: benchpod-baea06 (rev3) on these placements: e2e 101 passed; the 23
    failures are all the pod's inverted DAC limits refusing raw DAC writes
    (solar output stage configured) plus the USB-C CC check. DUT tier
    (SWD flash under reset, reset pulse/hold, boot captures) all pass.
    [top_v2.v]
2026-09-29 Firmware: dap_start waits for a just-powered target (wait_ms)
    The first flash after switching the DUT's rail on always failed with
    "cannot read IDR": the tools waited 250 ms and an STM32 NUCLEO answers
    SWD ~2.1 s after power-on (its ST-LINK boots first), held in reset or
    not. With "wait_ms" the pod repeats a line reset + DP IDR read until
    the target answers (or the time runs out, capped at 10 s) before it
    acks. The reply is unchanged ("dap ready"), so clients that do not send
    the field behave as before.
    HW: cold DUT (rail off 5 s) flashes on the first attempt with the CLI
    and the SDK; the pod logs "[dap] target answered after 1807 ms".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
    [command_handler.c]
2026-09-29 WIP iCE40 v45 + firmware: SWD transfers run in the fabric
    Gateware: SWD_QFEED/QCONFIG/QSTATUS (0x58-0x5A) queue whole SWD
    transfers (request byte, + 4 data bytes for a write) and swd_engine runs
    them back to back at SWCLK = 24 MHz / (2 * half), CMSIS-DAP's sequence,
    sampling SWDIO at the end of the low half. A non-OK ACK or a read parity
    error stops the queue; SWD_QSTATUS reports transfers done + flags. A
    data byte that has not arrived yet stretches SWCLK. tb_top_swdq drives a
    SW-DP model through the whole top (mixed reads/writes, a queue larger
    than the link delivers, WAIT stop + re-queue, parity, no target).
    Firmware: swd_ll_batch() over the queue (WAIT re-queued); dap.c records
    DAP_Trans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
    [cmd_dispatch.v, dap.c, engine_block.v, swd_engine.v, tb_top_spi.v, tb_top_swdq.v, tb_top_v2.v]
2026-09-29 iCE40 v45: SWD_QSTATUS reports the queue pointer, not a count
    The 8-bit transfer counter goes; SWD_QSTATUS returns qptr (low byte +
    flags bit 6), and swd_ll_batch maps it back to ops (a stopped transfer
    has consumed its request byte only). Firmware: flags bit 6 is no longer
    read as "MISO stuck high" (bit 7 still is).
    HW (rev3 pod, STM32F446 DUT, SWCLK 2 MHz): cold-DUT flash 6.1 s (was
    15.5 s with the bit-banged path), pod SWD time 0.5 s of a 3.9 s DAP
    session; the rest is network round trips (ping to the pod is 6-11 ms
    here). Target RAM block write/read of 50 and 250 words match. DUT + GPIO
    e2e tiers: 28 passed. SPI flash (XTX 16 MB, 6 MHz): 64 KB write+verify,
    read back matches.
    Loop imag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
    [cmd_dispatch.v, swd_engine.v, tb_top_swdq.v]
2026-09-29 iCE40 v45: SPI bytes run on the SWD transfer sequencer (-141 LUT)
    The SPI master had its own shifter FSM beside the SWD queue sequencer;
    now one sequencer runs both: an SPI unit is 8 cycles that drive MOSI and
    take MISO at the end of the high half (as before, so 6 MHz still holds),
    an SWD unit is a transfer. The shifter only shifts right, so SPI bytes go
    out bit 0 first and the first bit in lands in bit 0; fpga_spi_xfer
    bit-reverses both ways (SPI_MASTER_MIN_GW 45). swd_engine 411 -> 270
    LUTs (hierarchical synth), design 3320 -> 3176.
    tb_top_spi (bit-reversing like the firmware), tb_top_swdq and
    tb_top_v2 pass.
    [command_handler_spi.c, swd_engine.v, tb_top_spi.v]
2026-09-29 iCE40 v45: 8-bit self-test ramp, no ADC hold register
    The +0x0101 capture self-test ramp always has equal bytes: one 8-bit
    counter shown twice, stepped once per captured sample (on the second
    byte write). The ADC producer writes both bytes straight from
    adc_sample_sel: the ADC engine holds `sample` until its next conversion
    (>= 58 clk), and the ramp only steps after both writes, so the 16-bit
    adc_hold register goes. tb_top_capture checks the ramp step sample by
    sample; tb_adc_mcp33131 passes.
2026-09-29 iCE40 v45: one counter for the ADC conversion wait and bit count
    adc_mcp33131 counted the conversion wait (to 24) in an 8-bit counter
    and the 16 read bits in a 5-bit one; the states never overlap, so one
    5-bit counter does both, cycle for cycle. tb_adc_mcp33131,
    tb_adc_timing and tb_top_capture pass.
2026-09-29 iCE40: uart_fifo no_rw_check drops read-first emulation (-44 LUT)
    yosys emulated read-first on both 256-byte UART FIFOs with a delayed write
    and a bypass. No consumer samples the head in the one cycle a same-slot
    collision can corrupt it (see comment). uart_fifo 65 -> 43 LUTs, x2.
    [uart_engine.v]
2026-09-29 iCE40: i2c_target shares one shift register for RX and TX bytes
    The address/write byte shifts in on SCL rises, the read byte shifts out on
    falls; no transaction does both, and the byte in is only read after eight
    shifts, so its clears were dead. -6 FF; loop packs 4010 -> 4000 LC.
    Checked cycle-for-cycle against the previous module (random traffic,
    config/disable/reset at random edges, watchdog).
    [i2c_target.v]
2026-09-29 iCE40: uart_fifo pointer/count as single carry chains (-20 LUT)
    The next read pointer is rptr + re_e, which is both rptr's next value and the
    head's read address, so the increment and the 8-bit address mux become one
    chain. cnt +1/-1/0 is one add (all-ones or carry-in). cnt never exceeds 256,
    so full is cnt[8]. uart_fifo 43 -> 33 LUTs, x2. Checked cycle-for-cycle
    against the previous uart_engine (random traffic, overflow, reconfig).
2026-09-29 iCE40: i2c_target one ACK state, self-wrapping bit counter
    S_ADDR_ACK and S_WRITE_ACK did the same thing (rw is 0 in a write
    transfer), so a received data byte now goes to the one S_ACK. bit_cnt
    wraps 7 -> 0 by itself, so the explicit zeroing at each byte/ACK and the
    ack_step/rd_first clears on START (every path into an ACK or READ sets
    them) are gone. i2c_target 259 -> 255 LUTs (abc9, per module).
    Cycle-for-cycle identical to the previous module (lockstep bench).
2026-09-29 iCE40: lc_counter, a loadable counter in one LC per bit; i2c conv timer
    yosys maps a loadable counter to two LUTs per bit: abc9 treats the carry
    cell's sum LUT as a fixed box, so the load mux cannot merge into it.
    lc_counter hand-places SB_LUT4 + SB_CARRY per bit (load select folded into
    the carry's second operand) and exposes the chain's carry out as a free
    full-width compare.
    i2c_target's 16-bit conversion timer uses it; its carry out replaces the
    conv_left != 0 test. i2c_target 255 -> 197 LUTs + 19 in lc_counter.
    simtest/uarttest now compile the iCE40 cell models. Cycle-for-cycle
    identical to the previous module, RTL and synthesized netlist (lockstep
    bench against the baseline RTL).
    Co-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
    [i2c_target.v, lc_counter.v]
2026-09-29 iCE40: uart_engine TX/RX bit timers in lc_counter (-45 LUT)
    Both 18-bit bit timers reload div, so each is one LC per bit. RX times the
    half bit to the start bit's middle by counting the same div load down in
    steps of 2: it first reaches 2 or 3 after floor(div/2) clocks, exactly
    when the old half_div count reached 1 (for every div >= 2, the firmware's
    range). uart_engine 157 -> 70 LUTs + 2 x 21 in lc_counter.
    Cycle-for-cycle identical to the previous module, RTL and synthesized
    netlist (lockstep bench: random frames, glitches, overflow, reconfig).
    [uart_engine.v]
2026-09-29 iCE40: tb_uart_engine checks the RX start-bit sample point exactly
    A low pulse of floor(div/2) clocks must be rejected as a glitch and one
    clock more must start a frame, at an odd and an even divider. Passes on
    the previous uart_engine too, so it pins the behaviour the step-2 half-bit
    timer has to keep.
    [tb_uart_engine.v]
2026-09-29 iCE40: uart_engine RX FIFO writes rx_sr directly (-8 FF)
    rx_sr only changes in RX_DATA, so in the clock after RX_STOP raises
    rx_push it still holds the byte; the rx_pushdata copy was redundant.
    Lockstep-identical to the previous module.
2026-09-29 iCE40 cmd_dispatch: streamed write data is rx_byte, not a copy
    wave_wdata, swd_feed_byte, i2c_reg_wdata and uart_tx_wdata were registered
    copies of rx_byte. Every sink samples them only under its write strobe, the
    cycle after rx_valid, and spi_slave holds rx_byte until the next byte. -32 FF.
2026-09-29 iCE40 cmd_dispatch: address outputs are wires off arg_count
    wave_waddr, swd_rd_addr and i2c_reg_waddr/raddr were registers loaded from
    arg_count (+ reg_base, + 1). arg_count now IS the address: S_REG_ADDR loads it
    with the register start address (reg_base is gone), read streams keep stepping
    it on each rx_valid but the last, and write streams step it in their write
    strobe cycle so the strobe sees the address of its own byte. COLLECT, SWD_FEED
    and UART never read it, so they no longer advance it.
    Checked cycle-for-cycle against the previous module (random SPI transactions,
    all outputs compared; write address/data under their strobes, read addresses
    through modelled registered BRAMs). cmd_di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
    [cmd_dispatch.v]
2026-09-29 iCE40 cmd_dispatch: masked opcode decode in S_COLLECT / S_READ_LEN1
    current_cmd only changes in S_IDLE, so in S_COLLECT it is one of the 20
    opcodes S_IDLE sends there and in S_READ_LEN1 one of the 8 stream opcodes.
    Each case item now compares only the 2-5 bits that separate its opcode from
    the rest of its set (parallel_case casez); swd_feed_q is current_cmd[3]
    (swd_engine samples it only with swd_feed_begin, SWD_FEED 0x51 / QFEED 0x58).
    S_IDLE still decodes all 8 bits, so unknown opcodes are still ignored.
    Sim-only guards (ifndef SYNTHESIS) fail every bench if a pattern stops being
    unique in its set, or an opcode reaches either state without a table entry.
    Checked against the previous modul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
    [cmd_dispatch.v]
2026-09-29 iCE40 cmd_dispatch: status blocks index by arg_rem, not arg_count + 1
    I2C_STATUS / UART_STATUS picked the next byte with arg_count + 1. arg_rem
    already says where the stream is (next index = LEN + 1 - arg_rem), so the
    status functions are keyed on it and byte 0 is written directly in S_IDLE.
    arg_count no longer advances in these states. Same bytes, same cycles.
    Placed LC (pack): loop 4245 -> 4239, deep 3935 -> 3881.
    [cmd_dispatch.v]
2026-09-29 iCE40 v45: pin seeds good in both toolchains after the LC pass
    Loop 3864 LC (73%, below v43's 3914), deep 3549 (67%). Swept 1..64:
    loop 61/64 local, 46/64 CI (22/64 before the pass); deep 63/64 local,
    57/64 CI. SEED_LOOP 26 (clk48 56.70 local / 55.48 CI), SEED_DEEP 25
    (54.59 / 55.27); fallbacks are the seeds good in both.
2026-09-29 docs: the SPI master needs gateware v45+
    Since v45 the fabric shifts SPI bytes bit 0 first and fpga_spi_xfer
    bit-reverses them, so the firmware requires v45 (SPI_MASTER_MIN_GW).
2026-09-29 Cloud capabilities: announce nrst_pin
    The server needs to know whether it can hold the DUT in reset (SPI flash
    jobs, SWD connect-under-reset). nrst_pin was only in the LAN status
    reply; the capabilities frame now carries it too (nrst_ctrl_supported).
    [cloud_client.c]
2026-09-29 sensor_regs: drop the repeated lead byte of I2C_READ_REGS
    I2C_READ_REGS (0x63) sends r[start] twice, like SWD_READ: the first
    S_REG_READ step reloads tx_byte from the registered regfile port before
    the incremented address reaches it. fpga_spi_xfer and fpga_swdq_read
    already read n+1 bytes and drop the first; fpga_i2c_read_regs did not,
    so every sensor_regs reply longer than one byte was shifted by one
    (0xD0 len 4 read 58 58 00 00; the 0x88 trim read 70 70 6B 43 ...).
    Fix it in firmware: ask for len+1 and clock the first byte into a
    scratch byte in the same CS transaction (no 257-byte buffer). The extra
    byte never reads past r[start+len-1], so the 256-byte bound holds.
    tb_dispatch_args now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
    [tb_dispatch_args.v]
2026-09-29 Firmware 3.3.0: promote the hardware-verified gateware v45 images
    v45 = SPI master on the LA pins (folded into the SWD sequencer) + SWD
    transfers queued in the gateware + the LC pass (loop 3864 LC). Firmware
    adds the spi_* commands, batched DAP, dap_start packet options and target
    wait, the nrst_pin cloud capability and the I2C_READ_REGS lead-byte fix.
    Verified on benchpod-baea06 (rev3) with this exact build: e2e 129 passed
    (usb_cc fails on the cable), SPI tier 6, MCP 9, OpenHTF 2, cloud 6.
2026-10-01 motor-emulator: iCE40UP5K gateware (platform, safety, PMSM model, FPV pass)
    New gateware for the motor & battery emulator board (benchpod-private
    pcb/motor-emulator, rev 0.4 pinout; REV03=1 for the rev 0.3 pins).
    - One 36 MHz clock, SPI register link to BenchPod (board-addressed,
    broadcast writes), 3-leg bridge PWM with dead time and min-on, 5 x sinc3
    OSR 64, EEPROM board-id probe, stack SYNC and watchdog, safety gating.
    - PMSM model on a small microcoded engine (tools/masm.py, src/model.masm):
    back-EMF, torque, mechanics, common-mode PI, dead-time compensation,
    min-max injection, halls.
    - FPV pass: common-mode shaping within CM_MARGIN, back-EMF angle advance
    (ADV), phase-resistan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
2026-10-01 motor-emulator: encoder emulation (ENC=1) and an area pass
    Encoder (src/encoder.v, sim/tb_encoder.v): the model's rotor angle as
    ABZ and as an AS5047P / AS5048A / MA730 SPI slave.
    - exact mechanical angle: electrical revolutions mod the pole pairs and
    one 22-step division per PWM period, then DIR and offset
    - ABZ: an edge generator chasing the angle in 2-LSB steps, evenly spread
    over each period; exact counts for any CPR (multiple of 4); Z at 0
    - SPI, single clock, SCK up to 8 MHz: AS504x mode 1 with parity, next-
    frame answers, error flags and writes; MA730 modes 0 / 3 with register
    read / write; a 64-entry register file BenchPod can load
    - protocols checked against the datasheets;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
    [encoder.v, motor_model.v, pwm3.v, sinc5.v, sync_wd.v, tb_encoder.v, tb_motor_model.v, tb_sync_wd.v]
2026-10-01 motor-emulator: move the gateware to the ECP5 LFE5U-25F (board rev 0.5)
    The iCE40UP5K ran out of logic with the encoder emulation (5,302 of
    5,280 LCs). The board moves to an LFE5U-25F-6BG256C (design doc,
    "FPGA: ECP5 LFE5U-25F, rev 0.5"); iCE40 support is dropped (ice40/ ->
    ecp5/).
    - top.v: EHXPLLL 12 -> 36 MHz, pads as plain Verilog (yosys maps the I/O
    cells), ARM drives an N-FET gate (no RGB current sink), LED / EE_WC_N /
    SYNC open drain, the encoder always built, REV03 gone
    - emu.lpf: the ball map from the design doc; power-stage outputs on the
    top banks (the left / right banks have no hot-socket protection), the
    link on the bank-8 slave-SPI pins plus SCK on T6 (CCLK is dedicated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
2026-10-01 motor-emulator: complete the design doc's gateware list
    - protect.v: per-phase overcurrent trip from the sinc samples (stops the
    bridge, clears PWM_EN / HSWAP_EN, holds SYNC low so the stack stops),
    per-DUT bus overvoltage brake with hysteresis, brake energy budget
    (leaky bucket in uJ), brake test pulse with bus captures (resistor
    detection), hot-swap interlock (needs HS_LIMIT, trips above it)
    - i2c_ctl.v (replaces i2c_probe.v): board-id probe, PCAL6408A trip
    recorder (input latch, read on FAULT and on request), EEPROM byte read
    and write with WC low only during the write and ACK polling
    - battery.v: battery model (OCV table over the charge drawn, R0 sag, RC
    branch), setpoint r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
    [battery.v, encoder.v, i2c_ctl.v, i2c_dev_model.v, logbuf.v, motor_model.v, protect.v, pwm3.v]
2026-10-01 motor-emulator: gate-level benches for the new blocks; tb_top_gl skips the long steps
    The whole-chip gate-level bench with every step ran for hours (all memories
    are LUT RAM at gate level). tb_top_gl now runs steps 1-11 and 17 (-DGL)
    and the new blocks get their own gate-level benches, minutes each:
    tb_protect_gl, tb_battery_gl, tb_i2c_ctl_gl, tb_encoder_gl. All pass.
    [tb_i2c_ctl.v, tb_top.v]
2026-10-01 stm32h563: spi_stream, a PSRAM upload through the SPI master in one CS frame
    For loads too big for spi_xfer, such as an FPGA bitstream into its slave-SPI
    configuration port (the motor emulator's ECP5): load_bin with "psram"
    stages the bytes, then {"cmd":"spi_stream","len":N,"head":...} sends an
    optional header (<= 64 bytes) and the staged bytes with CS held, SCK
    pausing between 512-byte chunks (about 1.5 s for 256 KB at 6 MHz). No
    gateware change: it runs on the existing SPI master (v45).
    - spi_stream.[ch]: transport-independent, host-tested (test_spi_stream:
    framing, exact bytes, chunking, transport and source failures release CS,
    argument checks, a second run with other sizes)
    - comma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
    [cloud_client.c, command_handler.c, command_handler_internal.h, command_handler_spi.c]
2026-10-01 motor-emulator: port registers take a whole burst (gateware 0x0007)
    The link address no longer advances on BAT_TBL_DATA, SHAPE_DATA and the
    LOG_FIFO window, so the OCV table, the 1024-entry back-EMF shape and a
    log drain each go in one transaction instead of one per word. tb_top
    checks a table burst leaves PV_OFS/PV_GAIN alone and reads a 96-word
    log burst in order.
    [spi_link.v, tb_top.v, top.v]
2026-10-01 motor-emulator: link bench (RTL and gate level), CI jobs; more spi_stream cases
    tb_link runs spi_link with the log FIFO behind it, wired as in top.v:
    two boards on one bus, bursts, broadcast, the port registers, a burst
    longer than the FIFO window, a cut burst, a full FIFO and back-to-back
    transactions; tb_link_gl runs it on the gate-level netlists.
    CI now runs the emulator gateware: every RTL bench plus synthesis and
    place and route at 36 MHz in one job, the gate-level benches in
    another (test-rtl / test-gl in the Makefile).
    test_spi_stream: data without a header, the remaining bad arguments,
    a header-only stream without a read callback, the error strings.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
    [tb_link.v]
2026-10-01 Firmware: adc_zero store for the amp input, two sectors carved from FLASH_BLOBS
    Per-pod zero offset for the amp ADC source (J8), in its own A/B store at
    s116/s117. FLASH_BLOBS shrinks 1328K -> 1312K (blobs now 97.2% full, 37.7 KB
    free) and OTA_MAX_SIZE drops to 0x1E8000 to match. Pure module plus host
    tests; not wired into any command yet.
2026-10-01 Firmware: adc_zero command, zero applied to adc_read amp
    adc_zero measures the amp input with J8 open (1024 samples over 100 ms),
    stores it per pod, reads it back or clears it. adc_read on amp subtracts it
    from mv and reports zero_mv; count stays raw. ext, cal1 and cal2 are not
    touched. Console: adc-zero [run|clear], and adc now uses adc_scale_burst
    like the JSON command. New status cap adc_zero.
2026-10-01 Firmware: adc_zero measures with adc_read's own burst
    Hardware showed the amp reading depends on the sample rate: J8 open reads
    count 65535.4 at 400 kS/s and 65530.6 at 10 kS/s, about 5 mV apart. A zero
    from one slow 100 ms capture left adc_read at -5 mV. Take 32 of the same
    16-sample bursts instead. Verified on pod .220: zero 4 mV, amp reads 0.
2026-10-01 Firmware: adc_zero becomes calibrate, a per-pod layer on the cal_data.h fits
    The command is now calibrate (console: calibrate [amp|clear]) and the module
    adc_cal: the pod's own ADC calibration on top of the compiled-in fits. The
    stored amp offset is applied as a fit override (ADC_CAL_CAL1 with the offset
    taken out of a), so adc_read and the console scale amp through the same
    a + b*count model as every other source. The reply reports that fit as
    a_uv / b_nv, the units of adc_cal_a_uv / adc_cal_b_nv in the capabilities
    frame. adc_read amp reports offset_mv. Status cap is calibrate. The record
    magic changed, so a pod zeroed with the earlier build must calibrate again.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
2026-10-01 Firmware: the amp source is now current_in, and adc_read reports its current
    amp read as amplifier and the value is volts, not amps. The 4-20 mA
    measurement input (J8) is current_in in analog_path, adc_read, calibrate,
    the console and the docs; amp is no longer accepted. adc_read on it also
    returns ua, the loop current through the 249 ohm sense resistor. The
    low-level cal_switch field amp_measure keeps the schematic net name.
    [adc_cal.c, adc_cal.h, adc_cal_hw.c, adc_scale.h, command_handler.c, console.c, dac_limits.c, i2c_bus.c]
2026-10-01 Firmware: cal_switch field amp_measure is now current_in
    The last use of the old name: the low-level relay field in cal_switch and
    its console and docs mentions. The schematic net keeps its name and is
    noted once in i2c_bus.h.
2026-10-01 API doc: the 4-20 mA output (J9) and its floating loop supply
2026-10-01 Firmware: rev3 pods use their own DAC and ADC fits
    cal_data.h was one set of fits, measured on a v2 board, for every pod. On a
    rev3 pod the +-12 V output was about 40 mV off and the ADC read up to 13 mV
    high at 5 V. The fits are now a table per board revision, picked at boot
    from the revision strap.
    The rev3 set was measured on pod .220 against a 34401A (code: volts):
    3v3 0: 0.007660 38: 0.49181 93: 1.2014 147: 1.8984 201: 2.5950 255: 3.2917
    5v 0: 0.011669 51: 0.99886 128: 2.5035 205: 4.0083 251: 4.9066
    12v 6: -11.5197 53: -7.0847 102: -2.4596 153: 2.3577 202: 6.9830 250: 11.5136
    The ADC fits are 13-point sweeps of those outputs. The full data is in
    calibration/rev3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
2026-10-01 Firmware: current_out transfer function for the 4-20 mA output, with host tests
    Pure file: uA <-> 16-bit DAC code for the XTR116 on J9, and the range.
2026-10-01 Firmware: current_out command, hold a current on the 4-20 mA output (J9)
    uA in, achieved uA + 16-bit code + range out. Switches the DAC voltage
    outputs off first (new analog path current_out). Refused while DAC limits
    are set. Capability current_out in status caps and the cloud frame, with
    the range. Console: current-out [mA].
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2026-10-01 Firmware, docs: the 4-20 mA loop supply must float, said wherever it is mentioned
2026-10-01 Firmware: the 4-20 mA output's fit is per board revision
    current_out converted with the nominal part values on every pod. A rev3
    pod measured 4.056 mA at 8-bit code 0 and 20.032 mA at code 255, 40 uA
    above nominal at the bottom. The fit moves into cal_data.c next to the DAC
    and ADC fits: nominal on v2, the line through the two measured points on
    rev3. The reported range follows it (rev3: 4056 to 20094 uA).
2026-10-01 Firmware 3.4.0: the 4-20 mA terminals in mA, per-pod and per-revision calibration
    Since 3.3.0:
    - current_out: hold a current on the 4-20 mA output (J9), in microamps,
    with a 16-bit DAC hold, the analog path current_out, a fit per board
    revision and the capability current_out with its range. Refused while
    DAC limits are set. Console: current-out [mA].
    - calibrate: a pod measures the offset of its 4-20 mA input (J8 open) and
    keeps it in flash; adc_read current_in reports the loop current in uA.
    The source is now named current_in everywhere.
    - rev3 pods use their own DAC and ADC fits (cal_data.c per revision).
    - spi_stream: a PSRAM upload through the SPI master in one CS frame.
    Gatewa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
2026-10-01 Firmware: a control loop arm without an input map clears the previous one
    The fabric keeps its map registers until a reconfiguration, and the arm
    only wrote them when it carried a map. An unmapped arm after a mapped one
    then indexed the curve through the old map: fixed input 0 landed on curve
    entry 62 instead of 0, and inputs above the old window on entry 0. Also in
    3.3.0. An arm without a map now switches the map and its trip off.
    Found by TestCloud_V2LoopOpenLoopSourceThroughServer running after a mapped
    arm; TestHW_V2LoopArmWithoutMapClearsThePreviousMap in embeddedci-server
    pins it.
    This is the 3.4.0 build to tag. Verified on a rev3 pod (benchpod-baea06,
    192.168.1.220) with this exact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
    [command_handler.c]
2026-10-04 Firmware: storage at the top of flash, for 1 MB and 2 MB parts
    The H563 comes with 2 MB (ZIT6) or 1 MB (ZGT6). The persistence records
    (ADC calibration, DAC limits, cloud and Wi-Fi config, device identity, the
    OTA self-test scratch) are written for the 2 MB part's top 96 KB.
    flash_compat now maps each of them to the same distance from the end of
    the flash the chip actually has, read once from the flash-size register
    (as a 32-bit word: narrower reads of that OTP area fault on the H5).
    On a 2 MB pod the mapping is the identity, so no record moves; a host
    test asserts every offset. On a 1 MB pod the records land in
    0x0E8000..0x0FFFFF. The bank size used for erases (flash_compat and the
    RAM-res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
2026-10-04 Firmware: images say how much flash they need; OTA refuses misfits
    Every image now carries a 16-byte fw_info block at offset 0x400, right
    after the vector table: a magic, a layout version and the smallest
    internal flash it fits. This build still embeds the ESP32-C3 and iCE40
    blobs, so it needs 2048 KB; it drops to 1024 once they move to the W25Q.
    OTA reads the block from the staged image at verify time and refuses an
    image that needs more flash than the pod has. An image without the block
    is from before the 1 MB part and counts as needing 2 MB, so 2 MB pods
    still accept older firmware and a 1 MB pod can never be given one.
    The OTA size limit is now the start of the persistence sectors on t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
2026-10-04 Firmware: W25Q driver split out of ice40_flash
    w25q.c holds the single-SPI access to the iCE40 config flash that lived
    inside ice40_flash.c (command framing, write-enable, WIP polling), plus
    read, 64 KB block erase, page-splitting program and a JEDEC capacity
    check that accepts the W25Q64 and the pin-compatible W25Q128.
    w25q_open/close reach the flash with the iCE40 left running.
    ice40_flash_program now reads its source through a callback, page by
    page, so a bitstream can come from a blob slot in the same flash. The
    pointer-based call is a thin wrapper and behaves as before.
2026-10-04 Firmware: blob slots in the W25Q
    blob_store keeps the ESP32-C3 image and the two iCE40 gateware images in
    slots of the iCE40 config flash, above the gateware the iCE40 boots from:
    gw0 at 0x100000, gw1 at 0x140000 (256 KB each), esp at 0x200000 (4 MB,
    the C3's own flash size). Fits the W25Q64; a W25Q128 adds free space.
    Each slot starts with a 4 KB header sector (length, gateware version,
    SHA-256) and a commit word. A write erases the slot, programs the data,
    hashes it back against the expected digest, then writes the header and,
    last, the commit word, so a power cut at any point leaves the slot empty
    or complete. Headers are cached at boot so status never needs the bus.
    Not wired in yet. H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
2026-10-04 Firmware: OTA writes either the firmware or a W25Q blob slot
    ota_begin gets an optional target: "firmware" (the default, unchanged),
    or "gw0", "gw1", "esp" for a blob slot, plus a gateware version to store
    with it. A blob is staged and SHA-checked in PSRAM like the firmware;
    ota_commit then writes it to its slot (blob_store_write hashes the
    written data back) and leaves the pod running in state "installed"
    instead of resetting. The fw_info fit check applies to firmware only;
    a blob's size limit is its slot.
    The target travels on every transport: the cloud ota.begin frame and
    the LAN ota_begin command take "target" and "version", the OTA status
    reply names the target, and the worker queue ca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
    [blob_hooks.c, blob_store.h, cloud_client.c, command_handler.c, command_handler_internal.h, command_handler_ota.c, hw_worker.c, hw_worker.h]
2026-10-04 Firmware: 24 KB of RAM back from buffers that sat idle
    - The control-loop curve upload buffers (16 KB) come from the FreeRTOS
    heap for the duration of one control_loop command instead of living
    in .bss for good.
    - The OTA self-test built its 8 KB test pattern in a second buffer; the
    pattern is a formula, so it is now built in the commit's own sector
    buffer and recomputed for the verify.
    - lwipopts.h said the lwIP heap backs mbedTLS; it has not since mbedTLS
    moved to the FreeRTOS heap. Comment corrected; MEM_SIZE stays until
    there are numbers to size it from.
    .bss 652,216 -> 627,640 bytes.
    [command_handler.c, lwipopts.h]
2026-10-04 Firmware: the build records which blobs go with it
    tools/blob_manifest.py runs at build time and writes build/blobs/:
    gw0.bin, gw1.bin and esp.bin under their slot names plus manifest.json
    (size, SHA-256, gateware version of each), for installers. The same
    facts are compiled into the firmware (blob_manifest.c), so the pod knows
    which blobs it was built and tested with.
    blob_status now gives each slot a state: ok (exactly the expected blob),
    outdated, missing, or unknown when the build had no such blob. That is
    what an installer reads to decide what to send.
    [blob_manifest.c, blob_store.c, blob_store.h, command_handler_ota.c]
2026-10-04 Firmware: gateware comes from the W25Q slots, no longer embedded
    The two iCE40 images are no longer compiled into the firmware. The image
    swap (fpga_image), flash-ice40 and the boot-time recovery of a blank
    config flash copy the image from its W25Q slot to offset 0, page by
    page, after checking the slot against its SHA-256 so a damaged slot is
    never copied over the image the iCE40 boots from.
    The boot-time gateware update moves into signal_engine_gateware_update:
    it reprograms only from a slot that holds exactly the gateware this
    firmware was built with (blob state "ok"), and it also runs right after
    a gateware blob is installed, so firmware-then-blobs updates take effect
    without a reboot.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
    [blob_hooks.c, console.c]
2026-10-04 Firmware: the ESP32-C3 image comes from its W25Q slot, no longer embedded
    The esp-hosted image (1.07 MB) is no longer .incbin'd into the firmware.
    esp_rom_flash_from_slot checks the esp slot against its SHA-256, then
    streams it to the C3 ROM loader in 1 KB blocks read straight from the
    W25Q (the bus is taken per block, so the gateware is not locked out for
    the two minutes), with the MD5 the C3 verifies against computed as the
    blocks go. The Wi-Fi auto-flash of a blank C3, flash-esp32 and the hw
    worker all use it; installing a new esp blob gives a C3 that never
    booted another automatic try.
    The firmware image drops to about 0.5 MB.
    [blob_hooks.c, console.c, esp_rom_flash.c, esp_rom_flash.h, esp_wifi_ctrl.c, esp_wifi_ctrl.h, hw_worker.c]
2026-10-04 Firmware: one 928 KB image for both the 1 MB and the 2 MB H563
    With the gateware and the ESP32-C3 image in the W25Q, the internal flash
    holds only the firmware. The linker now has a single FLASH region of
    928 KB, which ends where the 1 MB part's persistence sectors begin, so
    the same binary fits both parts and a build that would grow into them
    fails to link. The image carries min_flash_kb 1024 (fw_info layout 2).
    Makefile: the split code/blobs images and flash-dfu-blobs are gone;
    flash-dfu writes the ~0.5 MB image (flash-dfu-code stays as an alias).
    build/blobs/ holds blob-gw0.bin, blob-gw1.bin, blob-esp.bin and
    blobs-manifest.json, named as the release assets.
    Release CI checks all three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
    [fw_info.h]
2026-10-04 Firmware: upload the firmware or a blob over the USB console
    A pod without a network (blank C3, no Ethernet) could not get its blobs.
    The USB console now takes uploads through the same staging and SHA-256
    check as an OTA, to the firmware or any W25Q blob slot:
    upload-begin <firmware|gw0|gw1|esp> <size> <sha256> [version]
    upload-data <offset> <len> <crc32> then <len> raw bytes (<= 512)
    upload-end, upload-commit, upload-status, upload-abort
    upload-data bytes never reach the line editor: the console task reads
    the raw chunk itself (upload_rx.c), checks its CRC-32 and queues it to
    the worker as OTA data, replying ok / retry crc / retry timeout / busy.
    512-byte chunks always fit the 1 K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
2026-10-04 Firmware: the cloud capabilities name the flash size and the blob slots
    capabilities gets "flash_kb" (1024 or 2048) and "blob_slots":true, so
    the server can refuse firmware that does not fit the pod and knows the
    pod takes blob installs: blobs before the firmware when it has slots,
    after the firmware for a pod whose current firmware has none.
    [cloud_client.c]
2026-10-04 Firmware: make flash-dfu refuses an image the pod cannot hold
    tools/dfu_fit_check.py compares the image's fw_info min_flash_kb with
    the flash the ST bootloader lists (alt 0, "/0x08000000/256*08Kg" on a
    v3 pod = 2048 KB, read on hardware) and stops the write when it does
    not fit, as flash-self and the server already do.
2026-10-04 Firmware 3.5.0: one image for 1 MB and 2 MB parts, blobs in the W25Q
    Version bump and the docs that described the embedded gateware and
    ESP32-C3 image: README build steps, AGENTS flashing notes, the USB
    console command table (blobs, upload-*) and the esp32-hosted-slave
    on-device flash section.
2026-10-04 Firmware: support the INA226 as a drop-in for the INA238
    The INA238 (U29, U33) is out of stock everywhere; the INA226 is
    pin-compatible (VSSOP-10, same pins), plentiful and close in precision
    (±10 µV max offset vs ±5 µV, 2.5 µV shunt and 1.25 mV bus steps). Its
    registers differ, so the driver now detects which chip answers at each
    address (INA238 DEVICE_ID 0x238x at 0x3F, INA226 DIE_ID 0x226x at 0xFF)
    and reads either in the same units. One firmware runs old and new
    boards. A sensor that does not answer (external rail without supply) is
    not cached and is detected once it powers up.
    The power profiler picks conversion times from the fitted chip's table
    (the INA226's are slower: 530 Hz f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
2026-10-04 Firmware: hold the bus for the whole C3 flash from the W25Q slot
    Reading the ESP32-C3 image block by block with a bus grab per block
    cost lost C3 replies: 29 FLASH_DATA resends per flash, against 12 on
    v3.4.0 with the image in internal flash (measured on the same v3 pod).
    Holding the bus once for the whole flash brings it back to 13, all
    recovered, MD5 verified. The gateware's PSRAM masters are quiesced and
    the hw worker is busy for the duration, so nothing else needs the bus.
2026-10-04 Firmware: reset FDCAN on every can_config so TEC/REC start at 0
    HAL_FDCAN_DeInit/Init leave the error counters alone; only a peripheral reset
    or bus-off recovery clears them. A session that ended error passive (e.g. a
    bitrate mismatch) made every later session start error passive, which broke
    the next test's "pod TEC stays 0" check.
    HW: pod .220 (rev3): no-ACK session TEC 128 -> reconfigure TEC 0. examples
    can-stm32 HIL suite (Nucleo + MCP2515 as second node) 20/20 twice in a row,
    SDK CAN loopback HIL 5/5.
    [can_bus.c]
2026-10-04 Firmware: use the 30/20 mOhm shunts on INA226 boards
    Boards fitted with the INA226 carry smaller shunts (internal 30 mOhm,
    external 20 mOhm) so its +/-81.92 mV range covers the eFuse limits.
    The shunt value now follows the detected chip; INA238 boards keep 50/30.
2026-10-04 Firmware: stack headroom for every task, per task in status
    sys_health only knew the three tasks main.c and hw_worker.c registered, and
    status gave one stack_min with no name, so the 1296 B seen on .220 said nothing
    about which task. It now lists every task from uxTaskGetSystemState (incl. IDLE
    and the timer task, never measured before) in creation order; status gains
    "stacks":{name: bytes} and the console status prints them all. No
    registration left. The snapshot array is static and read with the scheduler
    suspended, so a tight caller (console, 3 KB) spends ~64 B, not ~300.
    status resp 1408 -> 1536: stacks{} adds ~100 B on top of fields added since
    the last bump; the reply fails whole when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
    [command_handler.c, console.c, hw_worker.c, main.c]
2026-10-04 Firmware: comments no longer blame a PSRAM hardware latch
    fpga_warmboot and psram_recover still described the July swap wedge as a latch
    that compounds until a power cycle. It was a stale firmware mirror of the ADC
    capture base after CRESET, fixed by the reconfig mirror re-sync. Say so, so the
    next debug session looks for a mirror before suspecting silicon.
    [command_handler.c]
2026-10-04 Firmware: dap_start wait_ms waits for a stable target
    The first flash after a pod boot failed with OpenOCD "cannot read IDR" (its
    DPIDR read failed twice) and the SDK's retry passed. dap_wait_for_target
    returned on the first OK DPIDR, but a NUCLEO answers ~100 ms before its
    ST-LINK lets go of the F446 (it runs ~2.2 s after power-on, measured
    2026-10-04), so OpenOCD connected into that window. Now 5 OK reads in a row,
    50 ms apart; any failure restarts the count. ~200 ms more per powered flash.
    Not verified on hardware yet (no pod connected).
    [command_handler.c]
2026-10-04 Firmware: adc_read "not settled" error keeps its advice
    msg[112] cut "stop the DAC (dac_stop) or let the node settle" off the end
    (the build's only -Wformat-truncation warning). 176 bytes, and a period
    instead of the em-dash. Clients match "not settled" only.
    [command_handler.c]
2026-10-04 Firmware: a verified OTA image that is never committed is dropped after 10 min
    VERIFIED counts as busy (captures refuse), and only RECEIVING had a
    watchdog. A cloud dry run (?commit=false) or a lost ota.commit left the pod
    busy until a reboot: seen on .220, la_capture "busy" after a dry run until
    ota_abort. ota_watchdog now drops a verified image after 10 min; each staged
    image gets its own window. Host test added.
2026-10-04 Firmware: DAP_SWD_Sequence can no longer write past the response
    Each input sequence costs one request byte and returns up to 8, so 255 of
    them wrote ~2 KB into the 1026-byte dap_resp: static memory corruption from
    any host that can open a DAP session (LAN API, cloud tunnel). Block read and
    DAP_Transfer were already bounded; this one was missed. Refuse the rest with
    DAP_ERROR. The overrun test now covers it (fails without the fix).
    [dap.c]
2026-10-04 Firmware: SCPI respects dac_limits (OUTPut ON and MEASure?)
    With output limits set, the JSON API refuses raw waveforms (generate, replay,
    measure, ...), but SCPI OUTPut ON and MEASure? called the DAC generators
    directly, so a SCPI client could drive a protected output stage past its
    limits. Both now refuse with -221 Settings conflict and the same reason
    text. Host test: refused with limits (DAC never started), allowed without.
2026-10-04 Firmware: console task stack 3 KB -> 4 KB
    Each USB-console command puts a 1.6 KB cmd_work_t on the console task's stack
    (hw_worker.c submit_u). The new per-task telemetry showed it at 1296 B free
    after an SDK e2e run that used the console, too thin for a release: an
    overflow resets the pod. 1 KB more from the FreeRTOS heap (min free 144 KB).
    [main.c]
2026-10-04 Firmware: every OTA start waits for the PSRAM bus to be free
    The cloud ota.begin went straight to ota_begin_target with no busy check
    (the LAN and console paths had one), and none of them counted a PSRAM
    waveform upload in progress or a connection holding the gate. OTA staging
    takes the PSRAM bus, so it could cut into a running capture or upload.
    heavy_or_claimed() covers both; the cloud path refuses with an ota.status
    error "busy: ...", which the server retries (not a permanent error).
    [command_handler.c, command_handler_internal.h, command_handler_ota.c, console.c, hw_worker.c]
2026-10-04 Firmware: one DAP packet can no longer hold the pod on an endless WAIT
    The host sets WAIT and match retries up to 65535 per transfer, 255
    transfers per packet. A target answering WAIT forever kept the hw task in
    one dap_process for minutes (~0.65 ms per queued transfer): every other
    session stalled and the 60 s worker watchdog reset the pod. Each packet now
    gets 2048 retries in total, and the batched engine's per-transfer WAIT
    retry is capped at 64. The host sees WAIT and retries on its own terms.
    Host test: endless WAIT with 65535 retries returns within the budget.
    [dap.c]
2026-10-04 Firmware: zero compiler warnings on a clean build
    The SCPI command table uses designated initializers, so the unused tag field
    is zero-filled without -Wmissing-field-initializers. The table contents are
    unchanged. LINE_MAX in console.c is now CONSOLE_LINE_MAX (newlib defines
    LINE_MAX), and the flash shim's FLASH_SECTOR_SIZE is now FLASH_SHIM_SECTOR_SIZE
    (CMSIS defines FLASH_SECTOR_SIZE, to the same 8 KB). The base64url alphabet
    array has room for the literal's NUL. Fixed a misleading-indentation clamp
    and three comments that contained '/*'.
    The linker no longer warns about the RWX RAM segment: .data holds .RamFunc
    (ota_commit.c's RAM-resident copy code), so it is executable on purpose.
    The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
    [b64url.c, config_store.c, console.c, device_identity.c]
2026-10-04 Firmware: a full TLS send buffer no longer drops the cloud link
    During a large tunnel read-back the send buffer is full for a moment, and
    altcp_write answers ERR_MEM. A ping or a command.response that hit that
    counted as a broken link: backoff, reconnect, every open tunnel reset in
    the middle of a capture. Now a ping retries 250 ms later (a dead link
    still trips the idle timeout), and a command.response is kept and resent
    from the poll loop. Any other send error still reconnects.
    [cloud_client.c]
2026-10-04 Firmware: correct stale comments that mislead debugging
    fpga_warmboot reflashes the iCE40 config flash from a W25Q slot rather than
    doing an SB_WARMBOOT, and its return codes now list -3 and -5 as they are.
    The gateware and ESP32-C3 images live in W25Q blob slots, not in the firmware
    image. C3 auto-flash is hardware-verified. Random numbers come from the STM32
    RNG (rng.c), not an RP2350 TRNG. The signal_engine.c file header and the
    Makefile header described the RP2350 build; they now describe the STM32H563.
    [boot_policy.h, device_identity.h, esp_rom_flash.h, ice40_flash.h]
2026-10-04 Firmware: an upload that is never replayed gives the busy gate back
    load and load_bin keep the heavy gate after the upload so a capture can't
    overwrite the samples before replay. A client that never sent replay (but
    kept its connection or cloud tunnel open) held it forever, and every other
    capture got "busy". After 2 min without replay the gate is released; a RAM
    upload is dropped with it (replay then says nothing to replay rather than
    playing capture data), a PSRAM upload stays replayable.
2026-10-04 Firmware: a power-profile reply nobody reads ends after 30 s
    A client that stopped reading the power_profile result but kept its
    connection left the reply "being sent" forever, and every later
    power_profile was refused. With no room to send for 30 s (the rule the
    capture bulk send already has) the reply ends and the connection is
    dropped; the result is kept, so a new stop can still read it.
2026-10-04 Firmware: remove dead SB_WARMBOOT helpers and the unused PSRAM skip state
    ice40_prepare_reconfig and ice40_wait_cdone served the SB_WARMBOOT image
    switch, which cannot work on this board and was replaced by a reflash from
    the W25Q slots. Neither had a caller. Nothing sets PSRAM_ST_SKIP any more, so
    the "n/a (v1)" selftest state is gone. scpi_server.c no longer includes the
    empty gpio_control.h; command_handler.c still does, so the header stays.
    CMD_WARMBOOT is left in place: it is generated from tools/gen_protocol.py
    together with ice40/src/cmd_opcodes.vh, and changing that file would change
    the gateware source hash that the release images are checked against.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
    [ice40_flash.c, ice40_flash.h]
2026-10-04 Firmware: a cloud frame too big for the receive copy is refused, not cut
    Inbound text frames were copied into a 2 KB buffer and silently cut off.
    The JSON helpers still found their keys in the cut copy, and a shortened
    base64 field decodes fine, so upload or OTA bytes could go missing
    without an error (a corrupt trace or a stalled transfer). Such a frame is
    now dropped and logged; a command.request gets "command too large".
    [cloud_client.c]
2026-10-04 Docs: design notes for LAN access control and an OTA fallback
    access-control.md: threat model, every command sorted into tiers, options
    (lock, per-pod LAN key, LAN off / ethernet-only, signed firmware and blobs,
    LAN TLS) with costs, and a phased recommendation. Not implemented.
    ota-fallback.md: hardening the in-place commit, a small bootloader with a
    W25Q firmware slot, why dual-bank does not fit the 1 MB part, rollback,
    and what the iCE40 and ESP32-C3 already recover by themselves.
2026-10-04 Firmware: CI builds the firmware and runs host tests with Cube
    A new workflow runs on pull requests and pushes to main. It builds the
    STM32H563 firmware with the same ARM GCC and STM32CubeH5 as the release job and
    fails on any compiler or linker warning except newlib's nosys stub notices. It
    then runs the host tests with Cube, so test_ota and test_blob_store run, and
    fails if they are skipped. The release workflow is unchanged.
2026-10-04 Firmware: note in AGENTS.md why release builds use -Og
    ota_commit.c's RAM-resident copy code must not call the flash-resident memset,
    and -O2 can turn its fill loop into one. The note says what a switch needs.
2026-10-04 Firmware: last stale comments, and the empty gpio_control.h is gone
    load_bin no longer has a v1 adc_cmd_buf mode (adc_buf16 or PSRAM only),
    ota_commit.c no longer carries a 1.6 MB image with embedded blobs, and
    command_handler.c was the last includer of the empty RP2350 header.
    [command_handler.c]
2026-10-04 Firmware: an open UART session survives an FPGA image swap
    The soft UART lives in the iCE40. A gateware reconfiguration (fpga_image,
    flash-ice40, boot update) ended the session and put the connection back in
    JSON mode without telling the client, so its terminal went silent for good:
    the release soak lost the DUT console at its first image swap. The session
    is now kept and its soft UART re-armed on the next worker pass (the hook
    runs before the new fabric answers SPI, and the firmware still marked the
    old session armed). If re-arming fails the connection is closed, so the
    client sees the session end. HW (.220): 4 swaps in a row with the console
    answering after each.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
    [command_handler.c]
2026-10-05 Firmware: every OTA install leaves a copy of the firmware in the W25Q
    Groundwork for the bootloader planned next (docs/design/ota-fallback.md):
    the W25Q survives a power cut, the PSRAM staging does not.
    - New internal slot FW at 0x600000 (1 MB, only on a W25Q of >= 7 MB). It
    sits after BLOB_COUNT, so blob_status, the console blob lines, the
    manifest and blob_from_name (OTA targets) do not see it; the console
    blobs command adds a separate fw-copy line.
    - ota_commit writes the verified image there before the install grabs the
    PSRAM bus. Only at install time: a dry run never writes it. It uses
    blob_store_write (header erased first, data hashed back against the
    verified digest, comm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
2026-10-05 Firmware 3.5.1
    Version bump for the release: the stability fixes and the OTA hardening
    since 3.5.0 (checked in-place install, W25Q firmware copy, UART across
    image swaps, CAN error-counter reset, can capability, DAP/SCPI/cloud
    fixes). The console doc mentions the new fw-copy line of blobs.
2026-10-05 Firmware: report the pod's own current (INA226 at 0x41)
    Boards with the pod current monitor (U35, 30 mOhm after the input eFuse;
    the DUT's internal rail bypasses it) add a "pod" object to power_status
    with bus_mv, current_ua and total_ua (pod + internal rail = USB input).
    The chip is probed once at boot; boards without it leave "pod" out and
    never touch 0x41 again. Announced as the pod_current capability in status
    caps[] and the cloud capabilities frame; the console ina command and the
    I2C scan show it too.
2026-10-06 Firmware: detect the digital-only board and hide the analog features
    The digital board has the v3 revision strap, so it announced DAC, ADC,
    the control loop and the 4-20 mA terminals that it does not have, and an
    ADC capture read a floating line. The analog section is now detected by
    its two I2C expanders (U55 0x24, U58 0x26): on the +3V3 rail, present
    from power-up, only on analog boards, and an ACK is definitive (the DAC
    has no output and the ADC no ID register, so neither can be probed).
    Three tries, so one missed ACK cannot hide the analog front end.
    Without them: status carries "analog":false and no analog caps, the
    cloud capabilities frame says the same, analog_switch_init is skipped,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
    [board_variant.c, board_variant.h, cloud_client.c, command_handler.c, main.c]
2026-10-06 Firmware: command tier table, logged with each command
    cmd_tier.c classifies every JSON verb as T0 (read) to T3 (firmware), per
    docs/design/access-control.md section 3, with the read/write split of
    dac_limits, calibrate and eth. dispatch_line only logs the tier; nothing
    is gated on it yet. test_cmd_tier fails when dispatch_line gains a verb
    without a tier.
    [cmd_tier.c, cmd_tier.h, command_handler.c]
2026-10-06 Firmware: persisted pod policy record (signatures + LAN), below the old records
    pod_policy.c keeps the signature policy (audit/permissive/required) and
    the LAN policy (open/locked/off) in a new A/B record at 0x1E4000/0x1E6000
    (0x0E4000/0x0E6000 on a 1 MB part). No record = audit + open. It decides
    who may change what: USB anything, the cloud the LAN policy and a
    stricter signature policy, the LAN nothing. The older records did not
    move; the code region shrinks from 928 KB to 912 KB (the image is
    533 KB) and OTA's size limit follows. Not wired to any command yet.
2026-10-06 Firmware: sig_policy and lan_policy commands, LAN lock, tunnel tier limit
    - sig_policy / lan_policy JSON commands and sig-policy / lan-policy on
    the USB console (docs/design/policy-commands.md). The cloud may only
    tighten the signature policy, the USB console may set anything, the
    LAN may change neither.
    - LAN policy locked: T2/T3 commands on LAN connections are refused;
    off: the :8080 listener and mDNS stop, and start again on open/locked.
    - tunnel.open may carry max_tier; a tunnel refuses commands above it.
    Without it (older servers) a tunnel allows everything, as before.
    - Capabilities and status: sig_policy_cmd, lan_policy, lan_policy_cmd,
    tunnel_max_tier. fw_info sets FW_INF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
    [cloud_client.c, cmd_tier.c, cmd_tier.h, command_handler.c, command_handler.h, command_handler_internal.h, command_handler_policy.c, console.c]
2026-10-07 Firmware: cloud login bound to the server name (F2); release builds TLS only
    The pod signs host || 0x00 || nonce under benchpod-ws-auth:v2, where host
    is the cloud host it connected to and checked the certificate of, and adds
    auth=v2 to the login. A challenge relayed through another server no longer
    yields a signature the real server accepts. A server without v2 answers
    401; the pod then signs v1 on the next attempt, which is safe because a v2
    server refuses v1 from a pod that has used v2 once. Capability ws_auth_v2.
    Release builds (RELEASE=1) refuse cloud_set without tls and do not use a
    stored plain config. Also adds docs/design/cloud-hardening.md, the spec for
    this branch.
    Co-Authored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
    [cloud_client.c, command_handler.c, device_identity.h]
2026-10-07 Firmware: the LAN yields while a cloud job holds the pod (F3), always on
    The server's lease.state frames (held + holder + seconds left, or not
    held) feed lease_gate.c. While a lease is held, LAN JSON connections may
    only run light reads (T0 that does not take the capture hardware); the
    rest gets "busy: a cloud job holds this pod (<holder>, N s left)". LAN
    SCPI setters are refused with -200, queries still answer. The pod keeps
    its own deadline (capped at 600 s) and a dropped cloud link ends the
    lease, so the LAN is never locked out for longer than the last lease.
    Capability lease_state; status shows the lease. No setting: always on.
2026-10-07 Firmware: company CA and HTTP proxy for the cloud link
    - Company CA: W25Q slot "ca" (0x180000, PEM up to 16 KB), installed with
    the upload path as OTA target "ca" (no signature: configuration, not
    code) and checked to parse as X.509 before it is accepted. TLS trusts it
    in addition to the embedded ISRG roots. cloud_ca shows/clears it;
    console ca / ca-clear.
    - HTTP proxy: W25Q slot "proxy" (host, port, optional user/password).
    altcp_bp_proxy.c (adapted from lwIP's proxyconnect) sends CONNECT with
    the server's host name and optional Basic auth and requires a 200; TLS
    runs on top. Only the proxy is resolved. cloud_proxy show/set/clear
    (never shows the password); console proxy / p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
    [altcp_bp_proxy.c, altcp_bp_proxy.h, blob_hooks.c, blob_store.c, blob_store.h, cloud_client.c, cloud_extras.c, cloud_extras.h]
2026-10-07 Firmware: proxy refusal no longer leaves TLS pointing at freed memory
    When the proxy answered anything but 200 (a 407 here), the CONNECT layer
    aborted only itself; the TLS layer above kept its pointer and the next
    receive crashed (HardFault in altcp_mbedtls_lower_recv, task net), so the
    pod crash-looped while the proxy refused it. Seen on the bench. It now
    tears down like an error from below: abort the TCP pcb with our callbacks
    removed, report ERR_ABRT to the layer above, then free itself. Re-tested:
    the pod reports "the proxy refused the connection (HTTP 407: ...)" and
    keeps running.
    [altcp_bp_proxy.c]
2026-10-07 Firmware: refuse company CA and proxy changes from the LAN (SEC-3)
    Installing the company CA (ota_begin target ca), cloud_ca clear and
    cloud_proxy set/clear are now refused on LAN TCP whatever the LAN
    policy, like sig_policy. USB console and the cloud keep them; reads
    stay allowed on the LAN. A LAN attacker with both could terminate the
    pod's TLS for the real host name and relay the host-bound login.
2026-10-07 Firmware: proxy FIN before its reply tears the whole stack down (CRASH-2)
    In the setup phase a FIN from the proxy closed only the proxy layer,
    which left TLS above with a freed inner_conn (the same HardFault class
    as the fixed 407 path). Both setup failures now share one sequence:
    abort the TCP pcb with our callbacks removed, tell TLS through its
    lower_err (it frees itself and calls the app's err), free this layer,
    return ERR_ABRT to tcp_input. last_status = 0 and closed_early = 1, so
    the cloud client reports "the proxy closed the connection before it
    replied".
    Host test test_altcp_bp_proxy: the CONNECT request, a split 200 reply,
    407/403/502 and FIN teardown against a fake TCP layer and a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
    [altcp_bp_proxy.c, altcp_bp_proxy.h, cloud_client.c, lwipopts.h]
2026-10-07 Gateware: clear the LA ring overflow on every capture arm (CORR-2)
    spram_ring16's overflow flag was only cleared by the FPGA reset, so after
    one LA ring overflow every later capture reported CAP_OVF until the iCE40
    was reconfigured. A new clr_ovf input, driven by the capture arm, clears
    it, like the other overflow sources. tb_spram_ring16 now floods the ring,
    clears the flag and checks clean traffic leaves it clear.
    [spram_ring16.v, tb_spram_ring16.v, top_v2.v]
2026-10-07 Firmware: conn_tx_write is all or nothing (CORR-3)
    A write the TX ring cannot take whole now queues nothing and fails,
    instead of queueing the first part. Callers already treated a short
    write as failure, but the bytes that did go out left torn JSON lines
    and DAP frames behind. Pacing senders (bulk_pump, send_paced, power
    profile, speed test) already write at most at_send_avail() bytes.
    test_conn_tx: refused writes leave the ring untouched, exact fits are
    taken whole, nothing is mixed.
    [at_driver.h, conn_tx.c, conn_tx.h, net_server.c]
2026-10-07 Firmware: DAP waits for room for its response before running a packet (CORR-3)
    A DAP response that did not fit the TX ring used to be cut short or
    dropped, which desynchronizes the host for good, and the packet had
    already run on the target. The pod now waits (1 ms sleeps with the
    worker heartbeat, at most 5 s) for room for the largest response
    before running a packet. On timeout it does not run it: it closes the
    LAN connection or requests a tunnel reset, and drops that connection's
    bytes until the teardown has disarmed SWD.
    [command_handler.c]
2026-10-07 Firmware: UART proxy and speed test send only what fits (CORR-3)
    The UART proxy reads at most at_send_avail() bytes from the iCE40 RX
    FIFO, so what the ring cannot take stays in the FIFO for the next pass
    instead of failing the send (which ended the proxy). The speed test
    waits for room for its done line, so the server always sees it whole.
    [command_handler.c]
2026-10-07 Firmware: cloud_ca builds its own reply (send_ok_str's 256 bytes cannot hold a cert list)
    A long subject or a chain of several CAs made {"cmd":"cloud_ca"} answer
    "reply too large". It now emits into its own buffer like blob_status.
    [command_handler_policy.c]
2026-10-07 Firmware: a proxy that resets before replying also reads "the proxy closed the connection"
    A proxy that closes without reading sends a TCP reset, which arrives as an
    error from below instead of a FIN and was reported as "tls handshake
    failed". Any failure through a proxy that has not replied yet now gets the
    proxy message. Bench: reset and clean-close proxies, 5 cycles each, no
    crash, message as expected.
    [cloud_client.c]
2026-10-07 Gateware: deep replay reader pauses on bus_own instead of resetting (CORR-1)
    The deep image held dac_psram_reader in reset while the STM32 owned the
    bus. A capture read-back during a replay then flushed the prefetch FIFO
    and restarted the stream at its base while the DAC engine kept running;
    a flush between the engine's low- and high-byte pops byte-swapped every
    later sample until the next arm.
    The reader now honours bus_own like psram_dual_writer (v43):
    - no burst starts while bus_own;
    - a burst bus_own touches is cut at the next cell, and its bytes are
    discarded: they sit past the committed write pointer until the burst's
    commit cell (new S_CMT, one cell after S_CSH, so the decision c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
    [dac_psram_reader.v, tb_dac_psram_reader.v, tb_dac_psram_replay.v, tb_dac_psram_skew.v, tb_psram_arbiter.v, top_v2.v]
2026-10-07 Gateware: whole-top bench for the deep image (tb_top_deep)
    First top-level bench built with -DUSE_DEEP_REPLAY (make topdeeptest,
    part of make test). An APS6404L model serves the reader and the writer,
    an STM32 model takes the bus and runs its own QPI reads, and a DAC8551
    decoder checks every frame is the next waveform sample:
    - bus_own swept every 2 clk48 over a whole reader burst (incl. the commit
    boundary), right after the engine's low-byte pop, and at random times,
    short and long holds; it checks bus_own reached every reader state and
    cut bursts;
    - an LA capture alongside the replay, read back by the STM32 mid-replay;
    - an LA capture that overflows the SPRAM ring reports CAP_OVF and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
    [tb_top_deep.v]
2026-10-07 Gateware: reader not-empty clear off the pointer subtract
    With the room test counting the speculative pointer, the wptr - rptr
    carry chain into ne_r's enable no longer shared logic with it and bound
    the deep image's clk48 on 26 of 64 seeds (cap 52.91 MHz). occ == 1 is
    now rptr1 == wptr, with rptr1 a register that always holds rptr + 1.
    Deep image sweep 1..64: all 64 reach MIN_CLK48_MHZ, best 59.26 MHz.
    [dac_psram_reader.v]
2026-10-07 Gateware: v46 (CORR-1 + CORR-2), pin SEED_DEEP 50
    GATEWARE_VERSION 45 -> 46 so pods pick up the new images, with the
    version log entry. Benches expect 46.
    Local seed sweeps 1..64 on the final netlists: loop 57/64 reach
    MIN_CLK48_MHZ, seed 26 kept (clk48 54.69 MHz, clk -> clk48 10.19 ns);
    deep 64/64, pinned 25 -> 50 (clk48 59.26 MHz, clk 32.34, clk -> clk48
    12.72 ns). Both images pass PNR_STRICT=1. CI sweep not run, and
    ice40/release/ is unchanged: the images need a hardware run before
    promote.
2026-10-07 Stop the DAC before re-arming a deep replay or the control loop
    START_DAC_PSRAM sent while a deep replay runs never drops the gateware's
    dac_psram_mode level, so the PSRAM reader keeps its old address, count
    and prefetch FIFO while the DAC engine restarts at its low-byte pop. The
    new replay plays the tail of the old one and can come out byte-swapped.
    The closed loop has the same class: dac_loop realigns its byte pops only
    on disarm, and a re-arm without a new curve never went through
    fpga_load_wave's stop.
    New dac_rearm_quiesce() (host-tested) sends STOP_DAC, polls STATUS until
    DAC_RUN clears (bounded), and stages a pending co-trigger again, since
    STOP_DAC cancels it. dac_replay_psram() alw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
    [dac_rearm.c, dac_rearm.h]
2026-10-07 Cloud: notice a dead downlink during an OTA in 12 s, not 30 s
    While an image is staging the server pushes a frame every ~16 ms and our
    pings get a pong every 6 s, so a healthy link is never silent for more than
    a second or so. Silence during a transfer means the server->pod direction has
    died: measured on baea06 over Cloudflare (2026-10-07), [cloud/diag] at each
    wedge read ms_since_rx=30000 rx_acc=0 sndbuf=11659 with every received frame
    already staged. The uplink was fine; nothing arrived.
    The OTA idle budget was 30 s, longer than the normal 20 s, from when the
    server could go quiet between acknowledgements. It is now two ping intervals
    (12 s): on baea06 the pod reconnected 16-17 s after a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
2026-10-07 SCPI: USER replays the capture; move 9.5 KB of locals off the worker stack (FW-9)
    READ? and MEASure? capture into scpi_adc16 and set the replay length, but
    SOURce:FUNCtion USER replayed scpi_adc_buf, the 8-bit DIAGnostic:PATTern?
    scratch, so OUTPut ON played stale pattern or upload bytes. USER now replays
    scpi_adc16 as 16-bit byte pairs, exactly like the JSON replay, capped at the
    2048-sample DAC BRAM. TRACe:DATA uploads into the same buffer and
    TRACe:POINts? reports 16-bit samples, as documented.
    TRACe:DATA's base64 buffer was sized for a whole 4 KB trace (5.5 KB on the
    12 KB hw worker stack) although a parameter can never be longer than the
    256-byte SCPI line; it now uses the line size. s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
2026-10-07 Boot: park a limited DAC right after the iCE40 comes up (FW-8)
    With dac_limits set (an inverted output stage on the DAC), boot parked the
    DAC only after the PSRAM self-test, blob scan and gateware update, so the
    stage sat at full output for seconds. Park it right after
    signal_engine_init() when the iCE40 is configured (the park needs only
    SPI1 and I2C), and park again at the end because the self-test recovery or
    the gateware update may reconfigure the iCE40, which resets the DAC.
    [main.c]
2026-10-07 Step trains: name the 1..65535 range when steps or delay_us is out of it (FW-11)
    The firmware already refused steps above 65535 (the gateware counter is
    16-bit), but with "invalid args", and the JSON path used atoi(), which
    read "steps":1e5 as one step. Steps and delay_us now parse strictly and
    an out-of-range value gets a message naming the range and that delay_us is
    the half-phase. The LA_STEP_* bounds move to la_pins.h so the check is
    host-tested.
    Extending the counter in gateware was not done: steps_left is the bottom
    half of a 16-bit SB_MAC16 counter, so more bits mean a second counter in
    fabric plus a wider GPIO_STEP wire format and a gateware bump.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
2026-10-07 Cloud: a bad company CA falls back to the built-in roots (FW-1)
    The company CA slot was read without checking its hash, and a CA that did
    not parse made altcp_tls_create_config_client fail on every connect, so the
    cloud link stayed down until the CA was cleared over USB. Out of memory
    while building the combined trust list silently built a roots-only config
    and cached it until the next reboot.
    - cloud_extras_load checks the slot data against the header hash and parses
    the CA; a corrupt or unparsable CA is dropped with a log line, and the
    reason shows in the cloud_ca reply ("error") and the console "ca" command.
    - cloud_extras_ca_pem tells "no company CA" from "out of memory"; cl_open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
    [cloud_client.c, cloud_extras.c, cloud_extras.h, command_handler_policy.c, console.c]
2026-10-07 Log: log_printf, one locked console write per message (FW-7)
    printf is not safe across the console, net and hw worker tasks: newlib
    runs without per-task reentrancy and _write handed each printf to the
    console in pieces (one per line break), each under its own lock, so lines
    from two tasks interleaved and raced _write's line-ending state.
    log_printf formats with vsnprintf into a 192-byte stack buffer (a longer
    message is formatted again on the heap; if that fails it is cut with a
    visible mark) and writes it with the new console_io_write_text, which does
    the CR-before-LF translation for the whole message under one console lock.
    printf's _write uses the same function, so the remaining printf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
    [bp_log.c, bp_log.h, console_io.c, console_io.h]
2026-10-07 Cloud: one capabilities emitter that always fits a frame (FW-6)
    The capabilities frame was built with one long snprintf into a 1536-byte
    buffer, then the free-form boot health (safe-mode reason, last crash line)
    was appended. A frame that did not fit was not sent, and a failed
    capabilities send failed the connect, so the pod reconnected in a loop.
    cloud_caps.c now builds the frame from a plain struct into a buffer sized
    to the WS scratch (CLOUD_CAPS_MAX = 1736). When the whole frame does not
    fit, the boot-health texts are cut to 96 characters (control characters as
    '?') and "boot_health_cut":true says so; the feature fields are never
    dropped. If it still could not fit, the link stays up wit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
    [cloud_caps.c, cloud_caps.h, cloud_client.c]
2026-10-07 Log: switch 138 printf call sites to log_printf (FW-7)
    Mechanical printf -> log_printf in the files no other P1 track is
    changing (main, net_server, esp_*, i2c_bus, can_bus, power and board
    files, scpi_server, command_handler_pins/power and a few more). The fault,
    stack-overflow and assert hooks in main.c keep printf: they can run in a
    fault or switch context, where log_printf's heap fallback and mutex are
    not allowed.
    Left on printf for a follow-up, to keep merges with the cloud and bus/OTA
    tracks easy: signal_engine.c (98), command_handler.c (36), psram.c (30),
    cloud_client.c (19), console.c (13), config_store.c (13), ota_commit.c (9),
    ota.c (9), device_identity.c (9), blob_store.c (8), i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
2026-10-07 Cloud: a reply too large for the cloud channel is an error, not torn JSON (FW-10)
    A cloud command's reply was captured into a 1536-byte buffer and silently
    cut at 1535 bytes, then sent on as if whole, so the server got JSON with no
    end. The capture moves into cloud_reply_cap.c, which remembers an overflow
    and returns {"status":"error","message":"reply too large for the cloud
    channel (N bytes, limit 1535)"} instead. A command.response envelope that
    does not fit now sends an error to the caller instead of reconnecting.
    Host test test_cloud_reply_cap.
    [cloud_client.c, cloud_reply_cap.c, cloud_reply_cap.h, command_handler.c]
2026-10-07 Identity: generate a key only on a blank sector (FW-10)
    Any identity record whose magic or version this firmware did not know was
    taken as "no identity", and a new Ed25519 key was generated over it. That
    silently orphans the pod's cloud registration (an older or newer record
    layout, or a damaged record, may hold the very key it is registered with).
    A key is now generated only when the record is erased (all 0xFF). Anything
    else is left alone: the pod runs without an identity, logs the magic and
    version, and says why in the identity_public error and the cloud status
    error (device_identity_problem). Host test test_device_identity.
    [cloud_client.c, command_handler.c, device_identity.c, device_identity.h]
2026-10-07 FW-3: owner token and depth for the shared PSRAM/W25Q bus, CS high on DMA completion
    psram_bus_acquire/release now carry an owner token (the calling task) and a
    depth (bus_owner.c, host-tested): a nested acquire by the holder only counts,
    so an inner w25q_open/close no longer hands the bus to the iCE40 under an
    outer holder. A take or give by another task is counted and logged with the
    caller's address (console status: psbus).
    The places that must give the bus to the iCE40 (capture arms, deep replay
    start, boot, the iCE40 config read) call psram_bus_handover(), which drops
    every hold and reports one left open, so a leaked hold cannot keep PG0 high.
    The init and reset paths that used acquire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
    [bus_owner.c, bus_owner.h, console.c, dma_wait.c, dma_wait.h, ice40_flash.c, main.c]
2026-10-07 Lease gate: the check no longer clears state from the worker (FW-10)
    lease_gate_active() runs on the hw worker (the LAN gate and status) but
    cleared an expired lease itself, while the net task writes the same state
    from lease.state frames: a renew that arrived at the deadline could be
    wiped. The check is now read-only. The net task, the only writer, forgets
    an expired lease in cloud_client_poll (lease_gate_expire), which also keeps
    a stale deadline from reading as live again once the millisecond clock has
    moved on by 2^31 ms. test_lease_gate covers both.
    [cloud_client.c, lease_gate.c, lease_gate.h]
2026-10-07 Config store: clear erases one sector per interrupts-off window (FW-10)
    ab_store_clear (wifi-clear, cloud config clear, ADC cal and DAC limits
    reset) erased up to three 8 KB sectors inside one interrupts-off window,
    tens of milliseconds with no interrupts (Ethernet, USB, the tick). Each
    sector now gets its own window, as a save already does. The flash model
    counts the most erases in one window, and test_config_store checks a clear
    stays at one.
    [config_store.c]
2026-10-07 FW-2: one quiescing W25Q session for runtime writers; defer them while the bus is busy
    w25q_session_open/close quiesce the gateware PSRAM masters and open the W25Q.
    OTA blob installs, the firmware copy, the company CA (clear and reload), the
    proxy and the ESP32-C3 reflash all use it, so none can grab the shared bus in
    the middle of a DAC replay burst (the CA and proxy writes did not quiesce).
    The ~140 s ESP32-C3 reflash the Wi-Fi control asks for now waits in the
    worker while heavy_or_claimed() and runs once the bus is free. The cloud_ca
    clear and cloud_proxy set/clear commands (JSON and console) and the console
    flash-esp32 answer "busy: ..." while a capture, upload or update owns the bus
    i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
2026-10-07 Gateware: every capture arm flushes what an aborted capture left (GW-1)
    An aborted capture (the STM32 took the bus, or the zero-count abort)
    could leave bytes in the writer's 32-byte staging FIFOs and the LA SPRAM
    ring. The next arm reloaded the region addresses but kept those bytes, so
    they were written at the start of the new capture's regions and every new
    sample landed late (byte-swapped when an odd count was left).
    - psram_dual_writer: start empties both FIFOs (a byte offered on the start
    edge is the old capture's), no burst commits on the start edge, and
    start now wins over a pop on the same edge in the address counters
    (until v46 the pop won, so an arm mid-burst kept the old ad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
    [psram_dual_writer.v, tb_psram_dual_writer.v, tb_top_capture.v, top_v2.v]
2026-10-07 Cloud: refuse fragmented WS frames, reset a tunnel that lost data (FW-12)
    ws_parse_frame ignored FIN: the first frame of a fragmented message was
    acted on as a whole message and its continuation frames were dropped. It
    now refuses fragments (FIN clear or a continuation opcode) and reserved
    bits with WS_PARSE_FRAGMENTED / -1, and the client reconnects with
    "fragmented websocket message (not supported)" as its last error.
    A tunnel.data frame over 2047 characters was dropped with a log line; in
    the middle of a load_bin upload every later byte then landed at the wrong
    offset. Its tunnel is now ended instead (cl_tunnel_fail): an error line on
    the stream, a tunnel.close with the reason to the ser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
    [bp_json.c, bp_json.h, cloud_client.c]
2026-10-07 FW-4: capture_read refuses a capture that was written over
    capture_read resumes a read-back from PSRAM, but an OTA staging (PSRAM 0 is
    the LA region), a load_bin psram upload, a gateware reload or a SCPI/console
    capture since the capture could have replaced the samples, and the resume
    streamed them as if they were the capture.
    psram_regions.c (host-tested) tracks the byte ranges the last capture_dual or
    la_capture result occupies. Every STM32 write reports its range (psram_write,
    with ota_data and load_bin naming themselves first), the capture arms report
    the iCE40's, and a gateware reload marks everything. capture_read now answers
    "capture data was overwritten by <what>; run the capture ag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
    [command_handler.c]
2026-10-07 Console: ca-damage (development builds) to try the CA fallback on a pod
    The upload path refuses a company CA that does not parse, so there was no
    way to put a damaged CA on a pod to see FW-1's fallback. "ca-damage" clears
    one bit in the middle of the installed CA's slot data (the slot hash then
    fails) and reloads it. Not in release builds.
    [cloud_extras.c, cloud_extras.h, console.c]
2026-10-07 FW-5: an OTA session belongs to the transport that began it
    LAN, cloud and USB shared one staging session with no owner: the cloud's
    refused begin called ota_refuse(), which put a LAN client's live session in
    ERROR, a stray ota.abort or data frame from one transport landed on another's
    session, and a second begin from anywhere restarted the first.
    ota.c now records the owner (the cloud, the USB console, or one LAN
    connection). A begin from another owner is refused with the holder in the
    message ("busy: firmware update from LAN connection 2 is in progress"); its
    data, end, commit and abort are refused without touching the session, and
    ota_refuse_for() only puts the session in ERROR when it i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
    [cloud_client.c, command_handler.c, command_handler_internal.h, command_handler_ota.c, console.c, hw_worker.c, hw_worker.h]
2026-10-07 Gateware: v47 (GW-1), pin SEED_DEEP 57
    GATEWARE_VERSION 46 -> 47 so pods pick up the new images, with the
    version log entry. Benches expect 47.
    Loop 3886 LC (v46 3895): seed 26 still closes (clk48 56.32 MHz, clk ->
    clk48 11.05 ns), kept. Deep 3590 LC (v46 3579): seed 50 fell to clk48
    49.61 MHz; local sweep 1..64: 60/64 reach MIN_CLK48_MHZ, pinned 50 -> 57
    (clk48 56.95, clk 34.51, clk -> clk48 12.82 ns). make -C ice40
    PNR_STRICT=1 test passes. CI sweep not run, and ice40/release/ is
    unchanged: the images need a hardware run before promote.
2026-10-07 FW-13: refuse OTA in safe mode on every transport; console diagnostics take the heavy gate
    In a safe mode that turned the iCE40/PSRAM bring-up off, the cloud's ota.*
    frames and the console's upload-begin still staged into the uninitialised
    OCTOSPI (the JSON path was already refused). The shared OTA begin gate now
    refuses with "safe mode: the PSRAM is off this boot, so an update cannot be
    staged; unplug and replug the pod, or flash it over USB DFU".
    The console's adc, measure, capture-psram, psram-test and dualcap (and the
    other diagnostics that capture into or drive the shared bus: lastress, psram,
    psram-addrtest, psram-bench, psram-clk, psram-selftest, cap-selftest,
    flash-ice40) now claim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
2026-10-07 Identity: identity-wipe on the USB console, the way back for a stuck pod
    A pod whose identity sector holds a record the firmware will not replace
    (FW-10) stays offline on purpose. This adds the deliberate way back, on
    the USB console only (physical presence, like the other way-back
    commands):
    identity -> identity <short id> <public key>
    | identity unknown <why>
    identity-wipe <id|unknown> -> identity-wipe ok <new short id>
    | identity-wipe error <why>
    The token must be the current short id (the hex of benchpod-a1b2c3), or
    "unknown" when the pod has no identity, so a stray command cannot wipe a
    k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
    [cmd_tier.c, command_handler.c, console.c, device_identity.c, device_identity.h]
2026-10-07 Cloud TLS: fix the receive-window deadlock that stalled big transfers
    lwIP's altcp_tls_mbedtls gives received bytes back to the TCP window only
    after a whole TLS record is decrypted and the app has taken the plaintext. Our
    TCP_WND (8 * TCP_MSS = 11680) is smaller than a full TLS record (16 KB + overhead),
    so a record that size can never complete: mbedTLS holds 11680 bytes of it, the
    window stays 0, nothing more arrives, and the pod reconnects at its idle
    timeout. Go/Caddy switch to full-size records after ~128 KB on a connection
    and Cloudflare does the same, which is why OTA and other server->pod bulk
    transfers wedged after a while and more often the faster they went.
    Measured on baea06 at t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
    [cloud_client.c]
2026-10-07 FW-5: report every refused cloud OTA begin to the server
    A cloud ota.begin refused because another transport holds the session puts
    the cloud's view of the state in "error" with the reason, and
    cl_ota_status_poll only reported on a change of that view. The view stays
    "error" until a cloud begin succeeds, and an identical refusal was
    deduplicated, so the next job's refused begin sent nothing: the server kept
    streaming and waiting for acknowledgements (pod repro: job stuck at 3%,
    device_received 0, no error). A status frame that failed to send was also
    counted as sent and never repeated.
    Every explicit refusal (begin, abort, commit, in the cloud's own state or
    shown only to the cloud) now bum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
    [cloud_client.c]
2026-10-07 Report watchdog hangs and send a per-boot crash key to the cloud
    - The IWDG early-warning interrupt (~1 s before the reset) records which
    watchdog task stalled and for how long, plus the interrupted PC/LR and
    the running task. The reset still happens (cause stays "iwdg"); the next
    boot's last_crash reads e.g. "watchdog: hw stalled 61.2 s; running net
    pc=... lr=...". A watchdog reset with no record says so, and a record
    whose reset never came is dropped.
    - boot_guard's culprit for a watchdog reset is the stalled task.
    - capabilities carry boot_id (random per boot) so the server can key a
    crash on the boot, and unclean_resets (crashes + watchdog resets since
    the last frame went o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
    [cloud_caps.c, cloud_caps.h, cloud_client.c, console.c, fault.c, fault.h, hw_worker.c, main.c]
2026-10-07 Watchdog report: time the stall from the last refresh; test-crash; symbols
    - The early-warning interrupt no longer reads HAL_GetTick: it counts CPU
    cycles and lost ~17 s when a hung net task stopped calling it (a net hang
    read "stalled 12.1 s"). The warning fires a fixed ~29 s after the last
    IWDG refresh, so the stall is measured from that. HW: net 28.9 s, hw
    89.3 s (60 s grace + 29 s), pc inside watchdog_test_hang_point.
    - status shows the boot id and the unclean resets not yet reported.
    - test-crash yes (USB console): a real fault, for the crash report.
    - make builds build/bench_pod_stm32.syms (function address, size, name)
    and the release publishes it and the .elf, so a crash's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
    [console.c]
2026-10-08 Move the dispatch_line gates into a pure cmd_gate.c with a host test
    The tier, lease, tunnel max tier, safe mode and digital-board checks run on a
    snapshot of the pod's state that command_handler.c fills, so test_cmd_gate pins
    their order and refusal texts. No behavior change.
2026-10-08 test_cloud_rx links the real accumulator code (cloud_rx.c)
    cl_rx_append, cl_rx_consume and cl_recv_cb's refuse decision call into
    cloud_rx.c, which the host test links instead of keeping a copy. Adds a case
    for the backpressure rule. No behavior change.
2026-10-08 Proxy layer: fix a double free on abort, test more reply shapes
    altcp_bp_proxy_abort aborted the TCP pcb below, whose err callback
    (altcp_bp_proxy_lower_err) frees the proxy pcb, then freed it again. Reached
    when cloud_client aborts the proxy pcb because the TLS config cannot be built
    (company CA unusable, out of memory) and on any abort of the TLS pcb during
    the proxy handshake. The abort now takes the setup-failure path, which frees
    every layer once.
    New host cases: the reply in a pbuf chain, a doubled CR before the end, a
    header line that is not the end, non-HTTP and non-200 replies, the
    application aborting before and after the 200, and an abort of the bare proxy
    pcb.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
    [altcp_bp_proxy.c]
2026-10-08 Host test for boot_guard: failed-boot count and safe mode
    Counts across software resets, safe mode at BOOT_GUARD_SAFE_AFTER, what a
    safe boot turns off and reports, healthy clearing the count (not in safe
    mode), a power-on starting over, culprits adding up, and the test-bootloop
    disarming.
2026-10-08 ESP32-C3 slave image: pin the ESP-IDF image by digest, enforce the hash
    The Docker build runs espressif/idf:release-v5.5 pinned by digest
    (esp32-hosted-slave/idf-image), build.sh takes esp_hosted 2.12.9 exactly (no
    looser fallbacks), and make fetch fails unless the image matches the
    committed sha256 for a Docker build too, not only for a download. A rebuild
    with the pinned image reproduces the committed hash byte for byte. The
    release job's cache key covers the lock, the image pin and the hash, and the
    job checks the hash on a cache hit as well.
2026-10-08 RELEASE=1 builds define BENCHPOD_RELEASE again; flag changes rebuild
    -DBENCHPOD_RELEASE=1 was appended to DEFS after CFLAGS had expanded it (:=),
    so it never reached the compiler: release images accepted a plain ws:// cloud
    config and kept the ca-damage console command. It is now set before CFLAGS.
    The compile flags go into build/flags.stamp, rewritten only when they change,
    and every object depends on it, so switching RELEASE (or CUBE) rebuilds
    everything instead of relinking stale objects.
2026-10-08 CI: release waits for the tests, checks the tag; RELEASE=1 build on PRs
    release-stm32.yml publishes only after a preflight job (tag equals
    FIRMWARE_VERSION, make -C ice40 check-release, both fatal) and the reusable
    test.yml (release: true: stale ice40/release/ fails, motor-emulator jobs
    skipped) and stm32-build.yml runs. Job-level contents: write for the publish
    job only. A prerelease-then-promote flow is described as an option, not on.
    stm32-build.yml gains a release-build job: RELEASE=1 build, warning check,
    BENCHPOD_RELEASE reached the compiler, and the release signing commands run
    with a throwaway key made in the job (never the real secret).
    test.yml runs on push to main only (plus pul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
2026-10-08 REL-4: tools/release_notes.py drafts release notes from merged PRs
    Lists the pull requests merged into main since the previous stm32-v* tag
    (merge commits and squash merges), with the firmware and embedded gateware
    versions at the release commit, as a Markdown draft for gh release edit.
    The release job can call it later; release-stm32.yml is not changed here.
    Tests: python3 -m unittest tools/test_release_notes.py
2026-10-08 REL-5: Dependabot, CODEOWNERS, SECURITY.md, CONTRIBUTING.md, SHA pins
    Pins the actions in stm32-build.yml and ice40-seed-sweep.yml by commit SHA.
    release-stm32.yml and test.yml are left to the firmware tests branch.
2026-10-08 Gateware bench: la_bank driver priority through the top
    tb_top_la_mux arms static GPIO, UART, I2C, the stepper and the SPI engine
    over the SPI link onto one pad and checks the pad, the bank's output enable
    and GPIO_GET as each driver takes over and hands back (including a step
    train under the SPI engine that must not reach the pad), on two pads, plus
    the channel >= N guard. make topmuxtest, part of make test.
2026-10-08 Gateware bench: re-arm and abort mid-capture while the iCE40 writes
    tb_top_capture logs every PSRAM byte with its region, offset and time. With
    the bus released and a long ADC + LA capture writing, a re-arm (other counts,
    dividers and pins) must only write the new capture's bytes once the burst in
    flight has finished, an abort must stop the writes, and a capture armed right
    after the abort must come out whole. A ring that is not emptied on arm (the
    v46 bug class) fails it.
    [tb_top_capture.v]
2026-10-08 Host test for the hw worker queue: teardown parking, cloud slot
    A close or tunnel reset that finds the queue full is parked, keeps the slot
    busy, refuses later bytes for it and runs only after everything queued before
    it (a reset parks behind a parked close). Also the single cloud reply slot
    and hw_worker_can_accept.
2026-10-08 ci: Trigger HIL skips with a notice without HIL_DISPATCH_TOKEN, asks for the released SDK
    A release with HIL_DISPATCH on but no token used to fail the Trigger
    HIL run. It now ends with a notice (and a step summary line), so a
    release never goes red over a bench that is not wired up yet. The
    dispatch now carries client_payload.sdk=released, so embeddedci-server's
    hil.yml checks the release against the SDK users install from PyPI.
2026-10-08 gitmodules: drop the retired rp2350 submodules
    rp2350/ was removed with the v1 board, but .gitmodules still listed
    rp2350/lib/scpi-parser and rp2350/lib/monocypher with no gitlink behind them.
    Dependabot's gitsubmodule job aborts on that ("rp2350/lib/scpi-parser not
    found", runs 37782134708 and 37782140580 at e5780e6). The stm32h563 submodules
    are unchanged.
2026-10-08 stm32: net_reload latch: reload a link only after the reply has left
    A settings command reloads the cloud link (or restarts Wi-Fi) inside its
    handler, which drops a cloud caller's link before the reply goes out.
    net_reload holds the request until the worker has queued the reply
    (commit), the settle time has passed and the link has nothing left to
    send, with a 1 s bound so a stuck link still reloads. Host test covers the
    ordering on a model of the worker and net task.
    [net_reload.c, net_reload.h]
2026-10-08 stm32: reload the cloud link after the settings reply, not before
    cloud_proxy set/clear, cloud_ca clear, a company-CA install (OTA target
    "ca"), cloud_set, cloud_clear, wifi_set and wifi_clear now persist the
    change, reply, and let the net task reload the link once the reply is
    acknowledged (cloud_client_tx_busy: command in flight, response unacked,
    tunnel output, unreported OTA state). Over the cloud the caller used to get
    HTTP 503 "offline" although the change was applied. USB and LAN callers
    see the reload a few milliseconds later.
2026-10-08 ESP32-C3 slave: commit the hash CI builds (= the 3.6.0 blob); build on amd64
    The committed hash came from a local arm64 build. The release job builds on
    amd64, and its image is byte-identical to blob-esp.bin published with 3.6.0
    (53d41ab9...), which is already on the pods. Since P2 a mismatch is fatal,
    so the 3.7.0 release stopped there. The Docker build now runs as
    linux/amd64 everywhere, so a Mac build produces the same bytes.
2026-10-08 ice40: run the whole-top benches on both gateware images
    topsmoketest, topcapturetest, topmuxtest, spitest and swdqtest built only the
    loop image, and topdeeptest only the deep one, so a top-level change could break
    the image a bench did not build without any bench noticing. A topbench macro
    now compiles and runs each whole-top bench once per image; tb_top_capture skips
    its control-loop checks in the deep image, which has no loop.
    [tb_top_capture.v]
2026-10-08 fw: one handler signature for every JSON command
    Every handle_* now takes (int conn_id, const char *json) and the ones in
    command_handler.c lose static, with prototypes in command_handler_internal.h,
    so a command table can point at them. identity_wipe's inline refusal becomes
    handle_identity_wipe. No behavior change.
2026-10-08 ice40: one cell_gearbox48 module for the PSRAM writer's and reader's clk -> clk48 hop
    psram_dual_writer and dac_psram_reader each carried their own copy of the clk48
    receive half of the cell gearbox: capture the clk-domain toggle, flag a new cell,
    latch the cell. Both now instantiate cell_gearbox48 (sync clear and latch enable
    as ports, so the reader keeps clearing its latched cell in reset).
    No logic change: yosys equiv_make/equiv_induct proves each module equivalent to
    its previous version, and the flip-flop counts are unchanged. abc9 maps the
    flattened netlist slightly differently (loop 3886 -> 3893 LC, deep 3590 -> 3610
    LC, including 3 carries in the untouched swd_engine), so the bits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
    [cell_gearbox48.v, dac_psram_reader.v, psram_dual_writer.v]
2026-10-08 fw: one command table for dispatch, tiers and gates (ARCH-FW-1)
    cmd_tier.c's k_tiers becomes the command table: each row is
    { { verb, tier }, flags, handler }. dispatch_line looks the verb up once and
    calls the row's handler, replacing the 83-arm strcmp chain; the tier gate,
    the lease gate (CMD_F_HEAVY), safe mode (CMD_F_NO_HW), the digital board
    (CMD_F_ANALOG), the cloud command channel (CMD_F_STREAM) and the console
    trace (CMD_F_NOISY) read the same row instead of five string lists.
    The {verb, tier} pair keeps its own braces so embeddedci-server's
    shared_vectors_test.go still parses the table unchanged.
    test_cmd_tier now runs every line of the shared tier vectors (a
    byte-identical copy i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
2026-10-08 ice40_release: record the nextpnr revision and flags, refuse stale images
    promote now writes nextpnr_revision (the version nextpnr reports, or the Homebrew
    package version when it reports an empty one, plus the binary's sha256),
    synth_flags, pnr_flags and each image's defines to the MANIFEST; the Makefile
    passes its SYNTH_FLAGS, NEXTPNR_FLAGS, DEFINES and DEEP_DEFINES. check and
    install print a note when those flags moved since the promote (informational:
    the promoted images stay the hardware-tested ones), and accept a MANIFEST from
    before these fields.
    promote also refuses an image that is older than any gateware source or synthesis
    helper, i.e. a build from before the last edit.
    image_p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
2026-10-08 fw: one capabilities source for status and the cloud announcement (ARCH-FW-4)
    cloud_caps_collect (cloud_caps_hw.c) gathers the capabilities once from the
    drivers; the cloud capabilities frame and the status reply both use it, and
    the status caps[] list moves into cloud_caps.c next to the frame builder
    (cloud_caps_emit_list), host-tested against the exact list status sent
    before. status also takes flash_kb, the policies, analog, nrst_pin and the
    safe-mode fields from the same struct. Both wire formats are unchanged.
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2026-10-08 fw: console cloud-ca / cloud-proxy names (ARCH-FW-4)
    The console's company-CA and proxy commands get the JSON verbs' names:
    cloud-ca, cloud-ca-clear, cloud-proxy, cloud-proxy-set, cloud-proxy-clear.
    The short names (ca, proxy, ...) stay as aliases and the replies keep their
    current form, so scripts that use them keep working.
    [console.c]
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2026-10-08 fw: SCPI gets the safe-mode and digital-board refusals (ARCH-FW-3)
    Behavior change. SCPI hardware commands now run through the same device
    gate as JSON (command_handler_device_gate), asked with the JSON verb each
    stands for: OUTPut ON/OFF = generate/dac_stop, READ? = capture, MEASure? =
    measure, DIAGnostic:CAPture? = capture_dual (LA-only stays allowed on the
    digital board), TRACe:DATA = load, DIGital:* = la. Before, SCPI skipped
    both gates: in safe mode it drove the uninitialised iCE40/PSRAM bus, and on
    the digital-only board READ? returned noise from an ADC that is not there.
    A refusal queues -240 (Hardware error) in safe mode and -241 (Hardware
    missing) on the digital board, with the JSO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
2026-10-08 fw: SCPI buffers move into the shared pool (ARCH-FW-3)
    SCPI's 8 KB trace, the 1 KB DIAGnostic:CAPture? CSV buffer and its 512 B of
    capture scratch go: READ?/MEASure?/TRACe:DATA fill the pool's trace region
    under a pool generation, PATTern? and CAPture? use its scratch region, and
    CAPture? emits its two arrays back to back (the same CSV). RAM -9.5 KB.
    Behavior change, the cost of one buffer: a SCPI trace and a JSON RAM trace
    can no longer both be kept. Once JSON fills the pool (capture, stream,
    test, load, load_bin), SOURce:FUNCtion USER refuses with -200 and
    TRACe:POINts? answers 0; once SCPI fills it, a JSON replay of a RAM upload
    answers "nothing to replay". TRACe:DATA now takes the heavy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
2026-10-08 fw: a failed SCPI capture drops the trace it overwrote (ARCH-FW-3)
    READ? and MEASure? take the pool before capturing; when the capture fails
    the pool holds part of it, so USER refuses (-200) instead of replaying a
    half-overwritten trace.
2026-10-08 docs(API): document every JSON command and fix stale v1 text
    Every verb in the command table (cmd_tier.c k_tiers) now has a row in the
    Commands index (with its tier) and a section: the 27 that had none (CAN,
    ota_* but ota_begin, cloud/Wi-Fi, eth, speedtest, fpga_image, psram_*,
    dac_loop_*, blob_status, identity_wipe) and the ones only mentioned in
    passing (capture_read, la_capture, load_bin, dac_set, dac_control_loop).
    Fixed text left over from the RP2350/ESP-AT/AD9280 boards: 8-bit samples
    are 16-bit, 12 LA channels are 14 (with the v3 iCE40 pin map), one client
    at a time is five, the line limit is 1279 bytes, stream is an alias of
    capture, measure is limited to 2048 samples, the status fi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
2026-10-08 docs(usb-serial): list the console commands that exist
    The console reference listed ten commands that are gone (target-power,
    target-status, la-step, pullup, esp32-reconnect, esp32-monitor, spi-ping,
    spi-status, dap-start, uart-proxy and its whole section) and missed about
    70 that exist: identity and identity-wipe, the policy, CA and proxy
    commands, the upload protocol, CAN, eth, the analog and PSRAM
    diagnostics, the test-* safe-mode proofs and more. Rewritten from
    console.c, with the reply formats installers parse, the busy refusal of
    the shared-bus commands, and the right VID for port discovery (0x0483,
    not the RP2350's 0x2E8A). upload-sig is no longer report-only: the
    signature policy dec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
2026-10-08 test: fail the host tests when a command is missing from the docs
    check_docs_coverage.py reads the three command surfaces from the code
    (the JSON verbs in cmd_tier.c's k_tiers, the SCPI patterns in
    scpi_server.c, the console verbs in console.c) and fails when one is not
    in docs/API.md's Commands index, its SCPI reference, or
    docs/usb-serial-interface.md. Deliberately internal commands go in an
    explicit allowlist with a reason (empty today). It runs at the end of
    'make -C stm32h563/test' (the stm32-host CI job, name unchanged) and on
    its own as 'make -C stm32h563/test docs-check'.
    The verb regex also matches the { { verb, tier }, flags, fn } rows of the
    command-table refactor in PR #27.
    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
2026-10-08 docs: SCPI hardware refusals, console cloud-* names, no USB JSON bridge
    The SCPI behavior changes of this PR in the Error Reference (-240 safe
    mode, -241 digital board, -200 busy or replaced trace, -221 limits), the
    OUTPut OFF safe-mode case, the console's new cloud-ca/cloud-proxy names
    in the busy-bus error row, and access-control.md no longer pointing at
    the removed command_handler_dispatch_console.
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2026-10-08 command_handler: move the DAC, uploads and replay to command_handler_dac.c
    generate, load, load_bin, replay, dac_stop, dac_limits, dac_set,
    dac_control_loop, dac_loop_input and dac_loop_probe move verbatim with the state
    they own (the replay trace, the load_bin upload, the upload's gate hold and the
    loop input mirrors). The PROTO_LOAD receive branch becomes load_bin_receive(),
    the gate-hold and stall checks in command_handler_poll become dac_poll(), and
    the teardown is dac_conn_closed(). The heavy gate helpers and
    parse_sample_rate_hz get external linkage; heavy_owner_conn() and
    dac_trace_note_capture() are the two accessors the split needs. No behavior
    change.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
    [command_handler.c, command_handler_dac.c, command_handler_internal.h]
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2026-10-08 command_handler: move the device commands to command_handler_device.c
    status, power_status, target_power, target_status, identity_*, usb_cc, nrst,
    fpga_image, psram_recover and psram_ping move verbatim, with the deferred
    psram_recover reboot (device_poll). No behavior change.
    [command_handler.c, command_handler_device.c, command_handler_internal.h]
2026-10-08 command_handler: trim the glue's includes and refresh stale comments
    command_handler.c keeps only the includes its glue needs and says what it is;
    command_handler_internal.h lists the modules. Two comments described code that
    no longer exists (a v1 streaming DMA, heavy ops finishing within one dispatch).
    No code change.
    [command_handler.c, command_handler_capture.c, command_handler_internal.h]
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2026-10-08 test: host tests for the split command_handler modules
    Each module builds on its own with its neighbours faked in the test:
    - test_ch_transport: line assembly across segments, CRLF, JSON/SCPI detection,
    the over-long line, raw-mode handoff and back (the bytes after a raw mode are
    the next protocol's), the SCPI lease refusal, the pseudo-conn one-shot path,
    teardown. This is the line/DAP/LOAD state machine P2 flagged as untested.
    - test_ch_dap: DAP frame reassembly, response framing, leaving on a zero-length
    or over-long frame, the send-room stall, teardown.
    - test_ch_uart: forwarding both ways within the ring's room, the guarded +++
    escape and what does not count as one, the load_bi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
2026-10-08 test: host tests for captures and the bulk read-back
    test_ch_capture parses the replies back into samples: decimal and b64 chunk
    framing, frames that fit the send ring's room, the deep capture_dual read-back
    (dense ADC region with its rates, then run-length LA edges), the capture_read
    resume, the stall that drops a reader who stopped, the trigger timeout, and the
    teardown of a capture whose connection closed (aborted in the fabric, its DAC
    stopped).
2026-10-08 load: refuse a trace longer than a RAM replay can play
    load accepted up to 8192 bytes (the size of its staging buffer), but a RAM
    replay sends the trace to the DAC BRAM, which takes 4096 bytes (2048 samples),
    so a longer upload only failed later at replay with "replay failed". The
    staging buffer cannot be played past the BRAM, so the cap moves to load:
    a chunk that would take the trace past 4096 bytes is refused with a message
    that points at load_bin with "psram":true, and an offset past 4096 is out of
    range. load_bin already had this cap. A malformed chunk is still
    "invalid data". docs/API.md updated.
    Behavior change: a load past 4096 bytes is now refused at the chunk instead of
    at replay.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
    [command_handler_dac.c]
2026-10-08 Fix two stale texts: console help for status, the SCPI SRATe comment
    The console help said status reads the iCE40 STATUS byte; it prints the pod
    report (network, PSRAM, gateware, safe mode, health). The SENSe:SRATe comment
    said the maximum ADC rate is 12 MSPS; the ADC engine floors the divider at 60,
    so the maximum is about 400 kSPS (docs/API.md already says about 0.4 MHz).
    [console.c]
2026-10-08 PROTOCOL.md: drop WARMBOOT, check every opcode against the gateware
    WARMBOOT (0x17) has not been decoded since v24 and the firmware never sends it,
    so it leaves OPCODES (and CMD_WARMBOOT/OP_WARMBOOT, both unused) and joins a new
    RETIRED table with the other removed opcodes, which gen_protocol.py renders as a
    section of PROTOCOL.md and refuses to reuse.
    Fixes found against cmd_dispatch.v and signal_engine.c: SET_CAPTURE_BASES only
    uses the ADC base (the LA base is ignored), SET_TRIGGER takes LA wire index
    0..13 and only CAPTURE arms exist since v40, the retired capture opcodes are
    still sent to gateware <= v39, FPGA_FEATURES images are swapped by reflashing,
    not warmboot, and the I2C/UART st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
2026-10-08 ice40/README: 14 channels, 24-bit counts, all modules, both images, release flow
    The README still described 12 LA channels, a 16-bit ADC count, the retired
    capture opcodes as live, an i2c_la_capture module that no longer exists, and
    bits 7:6 of STATUS as hardwired. It now lists every source module (dac_loop,
    dac_psram_reader, psram_bus_arbiter, psram_pads, cdc_pulse_payload, the DSP and
    LC counters, cell_gearbox48), explains the loop and deep images and how the
    firmware swaps them, adds a DAC section with the real 889 kS/s ceiling, the SPI
    master and SWD queue, and documents how releases embed promoted images and why
    any src change (comments too) needs a new promote.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
2026-10-08 Comments: the real DAC ceiling (~889 kS/s) and when boot parks a limited DAC
    signal_engine.h and the replay handler said the DAC max is 12 MSPS. The DAC8551
    sequencer takes max(divider, 3) + 51 clk48 per sample, so the fastest replay is
    48 MHz / 54, ~889 kS/s (DAC_MAX_RATE_HZ); 12 MS/s is the LA ceiling, which is
    what divider_from_rate_hz serves. The comments now state what the code does,
    including that dac_divider_from_rate_hz leaves out the 51-clock frame overhead.
    dac_limits.h said boot parks once the analog front end and iCE40 are up; it
    parks right after the iCE40 answers on SPI1, again after the PSRAM self-test,
    and after an fpga_image swap.
    Comments only.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
    [command_handler_dac.c, dac_limits.h]
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2026-10-08 ice40/src: refresh stale module headers (comments only)
    Headers still described the retired v1 board and RP2350 (spi_slave, uart_engine,
    swd_engine, stepper_engine, i2c_target, i2c_regfile, engine_block, sample_buf,
    dac8551_engine), 12 LA channels (top_v2, psram_dual_writer, la_bank,
    cmd_dispatch), and la_psram_capture described a psram_writer/clk48 path that no
    longer exists. cmd_dispatch's hand-kept command list (START_CORRELATED,
    READ_CAPTURE, rp2350) is replaced with a pointer to PROTOCOL.md, links to design
    docs removed in 5f538ce are dropped, and the stray SB_WARMBOOT note goes.
    Comments only: make images rebuilds both images bit-identical to
    ice40/release/MANIFEST (loop 41309776...,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
    [adc_mcp33131.v, cmd_dispatch.v, dac8551_engine.v, engine_block.v, i2c_regfile.v, i2c_target.v, la_bank.v, la_psram_capture.v]
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2026-10-08 stm32: replay at the requested rate (include the DAC frame overhead)
    dac_divider_from_rate_hz computed the replay divider as 48 MHz / rate and
    left out the DAC8551 engine's per-sample frame overhead (51 clk48 from the
    BRAM, 52 from PSRAM), so a replay played slow: 80 kS/s at 73.7 kS/s,
    400 kS/s at 281 kS/s, 800 kS/s at 432 kS/s (measured on the pod), and the
    [sig] log printed the wrong rate. generate was right because
    compute_divider_and_period already modeled the overhead.
    dac_replay_plan (la_rate.c, host-tested) now picks the nearest divider for
    the real rate on both replay paths (RAM and deep/PSRAM, co-trigger
    included). Requests above the ceiling (48 MHz / 54 = 888.9 kS/s from RAM,
    48 M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
    [command_handler_dac.c, la_rate.c, la_rate.h]
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2026-10-09 CI: path-gate the gateware sims, split the gate-level benches (#33)
    * CI: run the motor-emulator jobs only when motor-emulator/ changes, nightly always
    A changes job lists the files a PR or a push to main touches. The
    motor-emulator sim and gate-level jobs (about 20 minutes) now run only
    when motor-emulator/ or test.yml changed. A nightly schedule and
    workflow_dispatch run them always. Any other event, or a base commit
    that cannot be fetched, runs everything; a failed changes job runs
    them too.
    * CI: run ice40-sim only when the gateware or its protocol inputs change
    ice40-sim (3 minutes, a required check) now needs the changes job a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
2026-10-09 CI: authenticate the OSS CAD Suite release lookup (#34)
    The gate-level matrix runs setup-oss-cad-suite once per bench, and on the
    first main run one bench (tb_encoder_gl) failed in setup with "API rate
    limit exceeded" for the runner IP. Pass the workflow token so the lookup
    uses the authenticated limit.
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2026-10-09 Gateware v48: re-pin seeds after the UART2 sweep; benches expect VERSION 48
    Swept 1..64 in both toolchains (local Homebrew yosys 0.65, CI OSS CAD
    Suite via ice40-seed-sweep.yml). Deep seed 57 failed clk48 at v48
    (45.5 MHz); deep now closes on 60/64 local and 64/64 CI seeds, loop on
    48/64 and 55/64. Pinned SEED_LOOP 26 -> 17 (clk48 54.84 / 55.98 MHz)
    and SEED_DEEP 57 -> 13 (59.54 / 59.26 MHz), fallback lists rebuilt from
    seeds good in both.
    [tb_top_spi.v, tb_top_swdq.v, tb_top_v2.v]
2026-10-09 Firmware: BME280, SHT4x, MPU-6050 sensor models and an emulated GPS receiver
    Emulated I2C sensors:
    - sensor_sim: each model carries a parameter table (key, unit, range,
    default) and a data window. sensor_set takes any of the active model's
    keys, checks all of them before applying any, and reloads only the data
    window, built from the live image: registers the DUT wrote (ctrl_meas,
    a range, a power mode) used to be wiped by every sensor_set.
    - watch_writes models are rebuilt a few ms after a DUT register write
    (sensor_sim_poll); a model can ask for a full reload (soft reset).
    - an emulated sensor survives a gateware reconfiguration: re-armed with
    its pins and values on the next pol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
    [cloud_caps.c, cloud_caps.h, cloud_caps_hw.c, cmd_tier.c, command_handler.c, command_handler_gps.c, command_handler_internal.h, command_handler_pins.c]
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2026-10-09 la_capture: report the achieved sample rate (la_rate_hz) (#38)
    la_capture streamed its trace without la_rate_hz, so the SDK, the server
    and the web UI labeled it with the requested rate. The pod runs 24 MHz
    over a whole divider, rounded down (2.304 MHz runs at 2.18 MHz), and
    slows a capture deeper than the 64 KB burst ring (300K samples at 4 MHz
    runs at 3 MHz). Measured on baea06 against an FPGA step train: no samples
    are dropped, the time base was just wrong, which broke UART decoding at
    2.304 and 4 MHz.
    fpga_la_capture_psram_start() now returns the achieved rate, la_capture
    reports it in its first packet, and a capture_read resume keeps it.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
    [command_handler_capture.c, console.c]
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2026-10-09 ci: path-gate the STM32 jobs on PRs; pushes to main run everything (#41)
    stm32-host (test.yml) and build-and-test + release-build (stm32-build.yml) now run on a PR only
    when stm32h563/, esp32-hosted-slave/, .gitmodules (+ tools/fwsign.py for the build) or the
    workflow changed. A push to main no longer diffs against the previous commit: a merge runs the
    whole suite, like the nightly, manual and release runs. Skipped required checks report success.
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2026-10-12 Report the cloud uplink (eth or wifi) in the capabilities frame
    The capabilities frame now carries "uplink":"eth"|"wifi"|"unknown", taken
    from the local address of the cloud TCP connection (net_route_owner), so the
    server can record which interface each connection runs over. Old servers
    ignore the extra key.
    The boot-health shortener now also replaces '"' and '\' with '?': a cut
    text that was all quotes still escaped to two bytes per character and filled
    the frame to the last byte, so the new field pushed that case past the WS
    frame and the frame was not sent. Test added for it.
2026-10-12 Spike: TinyUSB console + CDC-NCM USB network adapter
    Replace the ST USB device stack with TinyUSB 0.21.0: a composite device
    with the CDC-ACM console and a CDC-NCM network adapter (MS OS 2.0
    WINNCM descriptor for Windows). TinyUSB runs on its own usb task; the
    console keeps a ring in front of it, and frames cross to the net task
    (which owns lwIP) through copy slots. The USB netif has a fixed /30
    from the UID (10.237.x.y) and a DHCP server bound to that netif only,
    handing the host its one address with no router or DNS.
    Spike only: pid.codes test VID/PID 1209:0001, not HW-tested yet.
2026-10-13 USB networking on by default, off while Wi-Fi is configured; usb in status; docs
    The USB network adapter and Wi-Fi are one or the other: stored Wi-Fi
    credentials turn USB networking off (the NCM function stays enumerated and
    reports its link down to the host), wifi-clear turns it back on. JSON status
    gains usb {net, link, ip, host_ip} and the usb_net capability; the console
    gains usb-reattach (macOS ignores a netif that appears under a locked screen).
    The ST USB middleware submodule and the HAL PCD driver are gone.
    TinyUSB stays on master 1a0e4020e: no released tag (0.21.0 is the latest)
    has the NCM divisor fix 16bedd901 that Windows' usbncm.sys needs since
    KB5124008. Docs: usb-serial-inter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
2026-10-13 LAN policy covers the external LAN only; the USB network stays on and open
    lan_policy (open/locked/off) now applies to Ethernet and Wi-Fi. A connection
    on the USB network adapter means physical presence, so locked does not
    restrict it and off does not refuse it: the :8080 listener always runs,
    srv_accept refuses external connections while the policy is off (and the
    switch to off closes the open ones), and mDNS keeps advertising on the USB
    link. The USB link stays LAN tier, so identity_wipe, loosening sig_policy,
    lan_policy and the cloud CA/proxy remain off it. Wire values and the
    refusal text are unchanged; docs and console help say external LAN.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
2026-10-13 docs: power_status pod (the pod's own current monitor) and total_ua
    power_status has reported the 0x41 monitor as pod {ok, bus_mv, current_ua,
    total_ua} on boards that have it; the public API docs now say so, so the
    console ina command is no longer the only documented way to read it.
2026-10-13 Console: keep physical presence and recovery; instrument commands move to JSON
    Phase 2 of USB networking. A computer on the USB cable reaches the JSON API
    over the USB network adapter, so the console keeps only what needs physical
    presence or must work without the network: status, identity, the policies,
    the cloud CA/proxy, Wi-Fi, the wired link (eth start/stop/restart/stats),
    dfu, reboot, usb-reattach, the recovery tools (psram-selftest, psram-test,
    flash-ice40, flash-esp32*), the C3 diagnostics, and blobs/upload-* (until
    the flash-self path for Wi-Fi pods is settled).
    Removed (JSON equivalents: la_voltage, target_power/target_status, nrst,
    usb_cc, dac_out/analog_path, adc_read, current_ou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
2026-10-13 Pin the console replies host tools parse (check_console_contract.py)
    The CLI, SDK, MCP and the web app's setup wizard read a few console replies
    (status, ping, identity, the policies, CA/proxy, wifi-show, blobs, the
    upload acknowledgements, usb-reattach, dfu), and older releases of them
    stay in use. usb-serial-interface.md lists them as stable replies, and a
    check run with the host tests fails when one of their format strings
    leaves console.c.
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2026-10-13 Cloud: fit firmware 3.9.0's status in a command reply (1792 B)
    Found by the release-gate e2e: over the cloud, status failed with 'reply too
    large for the cloud channel (1626 bytes, limit 1535)'. usb{} and the usb
    task's stack line pushed it past the 1536 B command reply capture (a crash
    report in it adds up to ~130 B). The capture and the reply buffers grow to
    1792 B, status's own buffer, so any status fits; the command.response frame
    to 2000 B and the WS send scratch to 2048 B to carry it. Static RAM +2.4 KB.
    Tests derive the limits instead of hard-coding them.
2026-10-13 docs: 3.9.0 release-gate e2e test report
    Hardware e2e on benchpod-baea06 for the USB network adapter release: Ethernet
    and USB suites, usb-bridge with Ethernet stopped, mode switch and policies,
    compatibility both ways, upgrade/downgrade, macOS + Windows 11 + Linux, and
    the findings fixed during the run.
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2026-10-16 Firmware 3.9.3: the LAN API over TLS on 8443, HTTPS-only setting
    A second listener on TCP 8443 speaks TLS 1.2 and carries the same protocol as 8080 (JSON,
    SCPI, raw modes), with the same slots, LAN policy and USB rules. net_server moves from raw
    tcp_* to altcp for both listeners; a TLS session holds a reference on the configuration it
    started with, so a new certificate never frees one in use.
    lan_tls.c: on the first boot without a stored certificate the pod generates an ECDSA P-256
    key and a self-signed certificate (CN and SAN benchpod-xxxxxx, SAN benchpod-xxxxxx.local,
    valid to 9999) and stores both in the new config-flash record. Users replace it through the
    upload path (OTA target "tls":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
2026-10-16 LAN TLS: give the listener a new certificate in place instead of binding :8443 again
    HW (a1f6f2): after set-cert the listener went dark ([net] could not listen on :8443). lwIP
    refuses tcp_bind while a connection still has that local port, here the TLS connection that
    installed the certificate. altcp_tls_bp_set_listen_config swaps the listening pcb's
    configuration; accepted connections keep theirs.
2026-10-16 wifi-bridge: pod-managed only (USB-C power-only), OTA trial boot confirmed by the pod
    UART0 moves to TC2030 pads: console trimmed to factory/debug, no console OTA.
    A new image confirms itself on the first valid control request from the pod and
    reboots into the previous slot if none arrives within 120 s (FLAGS 0x10 while on trial).
2026-10-16 wifi-bridge: factory partition and power-up factory reset on GPIO34
    The bootloader erases nvs and otadata and boots the never-OTA'd factory image when
    the button is held 5 s at power-up; holding it while running still only clears Wi-Fi.
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2026-10-19 pod: Wi-Fi bridge pairing by X25519, wifi_set sends the passphrase sealed
    The pod's X25519 secret per bridge is derived from its device identity; with the bridge's public
    key from HELLO it recomputes the key after a reboot, still with nothing stored.
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2026-10-19 pod: update the Wi-Fi bridge's firmware automatically from slot "bridge"
    wifi_bridge_ota.c relays a newer image (OTA_BEGIN with the manifest, 1 KB OTA_DATA, OTA_END,
    REBOOT, then HELLO with the new version), one step per hw-worker loop, holding the bus gate like
    the ESP32-C3 flasher. Failed or rolled-back versions wait for a pod restart or `bridge update`.
    The client sends large bodies borrowed and in parts, so no big static buffers. Tested against
    the simulated bridge: lost chunk, up to date, rollback, refused manifest, forced, no bridge.
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2026-10-19 ADC calibration: the J8 offset corrects every ADC source; limit +/-150 mV
    All four ADC sources share the front end after the input relays (910k/82.5k
    divider, OPA810 buffer, THS4551 driver, ADC), so the offset calibrate measures
    on current_in with J8 open is the offset of every source. Pods of one batch
    measured +13 mV (bca439) and -50 mV (445e46): 1% gain resistors around the
    driver turn part of its 2.05 V common mode into a differential offset, about
    8x larger referred to the input.
    - adc_cal_fit(): any source's compiled fit with the pod's offset taken out;
    used by adc_read for every source, by the capabilities (adc_cal_a_uv) the
    server scales captures with, and by the control loop's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
2026-10-19 Wi-Fi scan with the built-in Wi-Fi: wifi_scan JSON command, console wifi-scan in every build
    wifi_scan and the console wifi-scan now scan with whichever Wi-Fi the pod uses: a Wi-Fi bridge
    when one is plugged in (development builds, as before), else the built-in ESP32-C3, with one
    list format either way (wifi_scan.c: strongest first, one entry per SSID, at most 20, cut to the
    cloud reply cap).
    The C3 scan runs on the net task in the Wi-Fi control's state machine (blocking ScanStart on
    the C3, GetApNum, then GetApRecord one record per frame, since this SPI host does not reassemble
    fragments). Joined: it scans alongside the link, which stays up. Not configured or after a
    failed join: the C3 is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
2026-10-20 calibrate: the record stores raw measurements; a version-1 copy for downgrades
    The per-pod record (version 2, 116 B) holds the J8-open zero count, the
    (code16, DMM uV) points per DAC output and the (count, input uV) points
    per ADC source. Every fit is derived at boot from them and the compiled
    general fits: offset = general cal1 fit at the zero (the 3.9.3 model),
    DAC line through its points, gain = points' slope over the general
    slope. A re-measured general fit no longer changes what a stored value
    means, and gains are not frozen at calibration day.
    Version-1 records convert once through the fit they were measured with
    (adc_cal1_v1, kept per revision in cal_data.c), so pods read exactly as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
2026-10-20 calibrate: send its own reply frame (send_ok_str stops at 256 B)
    Found on hardware: with the zero_count_mc field a plain read already
    answered "reply too large", and the DMM parts are up to ~530 B. The
    reply is now built as a whole frame and sent with at_send_data, like
    power_status. New host test test_ch_calibrate runs the real handler with
    every part stored and checks the frame.
2026-10-20 dmm_read.py: a clear message when the DMM does not answer on GPIB
    A GPIB timeout (DMM off, cable loose, other address) printed a traceback.
2026-10-20 Analog v3r2: DAC8554 quad DAC support (gateware v49 + firmware)
    The analog v3r2 board replaces the DAC8551 and its two TMUX1104 output muxes
    with a DAC8554, one channel per output, on the same three iCE40 pins.
    Gateware v49: OP_DAC_CTRL (0x38) sets the top byte of the DAC frame. flags
    bit0 makes it the stream control byte every later start takes (BRAM, PSRAM,
    loop); bit1 sends one static {ctrl, code} frame, which takes the next sample
    slot of a running stream or goes out at once when the DAC is idle. The byte
    is 0 at power-up, so DAC8551 boards keep their {0x00, data} frames.
    Loop 4066 -> 4133 LC, deep 3780 -> 3842 LC; seeds re-pinned (loop 57, deep
    48). New tb_dac8554, DAC_CTRL through the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
2026-10-21 Status LED: boot blinks, failure red, activity colours
    The RGB LED only showed target power (bit0). The STM32 now decides what it
    shows on the hw worker (status_led.c, host-tested) and sends SET_LED on a
    change, plus a 1 s refresh because a gateware load resets the mask:
    - 3 green blinks once the iCE40/PSRAM bring-up passes
    - solid red when it fails, in safe mode, or after a runtime PSRAM wedge
    - blinking red on an eFuse fault
    - magenta during an OTA, blue while a capture/upload holds the PSRAM bus
    - a short cyan flash for a command that drives the pod (not polled reads)
    - green when target power is on, otherwise off
    No gateware change: colours are SET_LED masks. A `led <colour>` console
    c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
2026-10-26 EMI test build: an activity loop from boot for emissions measurements
    make EMI_TEST=1 builds into build-emi/ (refused with RELEASE=1) and adds
    src/emi_test.c: 10 s after boot it sets the LA voltage, turns on target
    power at both eFuses, plays the DAC (1 kHz sine on 0-3.3 V by default)
    and runs back-to-back deep ADC+LA and LA captures whose read-back is
    discarded. It drives the pod through its own JSON commands on the
    reserved pseudo-connection 5 (CH_EMI_CONN), treated as the USB console.
    Console: emi [status|start|stop], emi dac, emi uart; status JSON carries
    emi_test.
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2026-10-26 EMI test build: all DAC outputs at once on the quad DAC
    emi dac all (the default on a DAC8554 board): 12 mA on channel D, the
    1 kHz sine routed to channel A, then 3.0 V written back to channel B,
    which the sine's routing parked. Leaving it parks B through analog_path
    off and returns the loop to 4 mA. Refused without the quad DAC; the
    single-DAC boards keep the sine as their default.
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2026-10-26 EMI test build: its own status LED pattern
    Solid yellow until the loop starts, yellow blinking while it runs, yellow
    and red in turn for 30 s after a failure. It wins over busy and target
    power (the loop is always busy) but not over a boot failure, a power fault,
    the boot blinks or an update. Yellow is unused by the normal states.
    Pure logic in status_led.c, host-tested; status_led_hw feeds it from
    emi_test_led_state() in the EMI build only.
2026-10-26 I2C2 module bus on PF0/PF1; the analog expanders can sit on either bus
    i2c_bus.c keeps one context per master: I2C1 (PB8/PB9) as before and I2C2
    (PF1 SCL, PF0 SDA, AF4) for digital v3r3's module link. The existing calls
    stay on I2C1; *_on(bus, ...) variants reach either bus, and a bus that was
    never brought up fails every transfer without touching its pins. write_read
    takes a two-byte memory address (24C32) as one repeated-start transfer.
    U55/U58 accesses go through analog_switch_set_bus(), I2C1 by default, so
    the one-piece analog boards are unchanged. The boot scan lists the module
    bus when it is up.
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2026-10-26 module and module_power commands, status.module
    module (T0, EEPROM writes T2): the module state as in status plus the EEPROM
    ID; raw EEPROM reads (1..128 bytes) and writes into the calibration area
    (0x100..0xfff, 1..64 bytes); eeprom:id writes type/revision/serial and keeps
    the calibration fields; eeprom:cal_commit records the blob's length and CRC.
    module_power (T1): the module's 5 V and the USB-A bridge port rails.
    Both refuse on boards without the module link.
    status gains a short module object on digital v3r3 (present, analog, power,
    bridge_power, eeprom), left out on the cloud command channel like the ADC
    fit, since that reply is near BP_CLOUD_REPLY_MAX. The status buffer grows to
    2304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
2026-10-26 No ESP32-C3 on digital v3r3: built-in Wi-Fi off, no flash attempts, clear errors
    board_has_wifi_module() is false on digital v3r3 (module_link_board), whose
    C3 nets are left unconnected. net_init then skips esp_hosted_spi_init, so
    EN, BOOT and CS stay as they are at reset, and esp_wifi_ctrl is told the
    module is absent:
    - stored credentials are ignored (never configured), so USB networking
    stays on and the C3 is never released from reset or auto-flashed: no
    20 s boot wait, no 25 s EN-pulse retry loop, no ROM sync attempts;
    - status.wifi is "absent"; a wifi_scan fails at once with
    "no Wi-Fi module: this BenchPod has no built-in Wi-Fi";
    - wifi_set (JSON and console) refuses with that me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
2026-10-26 EMI test build: EMI_SYSCLK=240 runs the core at 240 MHz
    To tell the core clock's emissions apart from other sources at 250 MHz (the
    25 MHz crystal x10, the PHY's 50 MHz x5): BENCHPOD_SYSCLK_MHZ (default 250)
    sets PLLN for both PLL inputs and configCPU_CLOCK_HZ, and the clock
    self-test expects it. Everything else follows the live clock (UART baud,
    PSRAM prescalers, delays) or has its own (I2C/ADC on HSI, CAN on HSE, USB on
    HSI48). Only in EMI_TEST=1 builds. emi and status show the core clock.
2026-10-26 EMI test build: LA captures only on a digital-only board
    No DAC or ADC there: the loop skips the DAC commands and capture_dual, so
    nothing is refused and the LED does not show errors. emi dac refuses
    anything but off on that board.
2026-10-28 ice40: promote gateware v49 (hardware-verified on an analog v3 pod)
    The v49 images from #66 (OP_DAC_CTRL for the DAC8554), loop seed 57, deep
    seed 48, built locally and run on benchpod-baea06 (analog v3, DAC8551) with
    this branch's firmware: hwe2e TestHW, 74 tests, 70 pass, 4 skip (current-
    loop wiring and the digital-board test), the same as firmware 3.9.4 with
    gw48 on that bench. check-release passes again.
2026-10-28 calibration: adc_comp_sweep.py, ADC divider compensation check
    The sine sweep through the cal1 loopback that measured the divider
    compensation on baea06 on 2026-10-20 (top leg 11.4 pF against 107 pF,
    flat needs 9.7 pF, HF gain +16 %), kept as a script: sweep, per-point
    sine fit, divider model fit, pass/fail on the HF/DC gain (5 %).
    --fit refits a saved sweep; --r-top/--r-bottom/--c-bottom cover other
    dividers (a future low range). Last line is JSON for ship-pod.
    Checked against the 2026-10-20 data: same fit (11.40 pF, 0.57 % rms,
    HF/DC 1.158). Not run on hardware in this change.
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2026-10-29 ADC low range (÷2, relay K5) on analog module v3r4
    Analog module v3r4 adds relay K5 (U58 P5 -> TPL7407 OUT5) that swaps the
    ADC input divider's bottom leg: 910k/82.5k (±32.8 V) or 910k/910k (±5.46 V,
    ~167 uV per count, 1.82 MOhm input).
    - P5 is only made an output when the module EEPROM says analog rev >= 3.4
    (module_ee_has_low_range); every other board leaves it an input.
    - adc_range command (read, switch with a 10 ms settle, self-test through the
    cal1 loopback at 1 V and 3.5 V); `range` on analog_path and adc_read.
    off, cal2, boot and analog_switch_init put the range back to normal.
    - adc_read reports range, fullscale_mv and overrange (samples on the ADC
    rails 0x7FFF/0x8000).
    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
2026-10-29 wifi-bridge: no hardware rev until boards can be told apart; Olimex ESP-PROG
    Rev 1 and rev 2 (tags wifi-bridge-rev1/-rev2) differ only in Ethernet protection parts and the
    firmware cannot tell them apart, so CONFIG_BRIDGE_HW_REV is empty: HELLO carries an empty
    HW_REV, and the bridge log, its `version` and the pod's `wifi-show` leave the rev out.
    flash.sh also finds a CH340 programmer (Olimex ESP-PROG: /dev/cu.wchusbserial*, skipping the
    duplicate /dev/cu.usbserial-* WCH's driver can leave), and the README documents its wiring
    (TX/RX crossed, IO0 to DCM, 3.3V open, bridge powered from USB-C).
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2026-10-29 Wi-Fi bridge OTA relay: no reinstall loop after a rollback, retry after an interruption
    Found on hardware (benchpod-baea06 + bridge, 2026-10-29):
    - Rollback loop: the relay took "HELLO shows the new version" as success, before the bridge
    confirmed the image. A build that rolled back after its 120 s trial was therefore reinstalled
    every ~2.5 min, forever. WAIT_BACK now waits until the new version runs without
    BWP_F_PENDING_VERIFY; a bridge seen on trial that comes back with another version is "rolled
    back to its previous firmware", failed, not retried. The trial state is read from
    hello_flags (the flags of the HELLO that carried the version): right after the rollback the
    bridge's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
2026-10-29 Ethernet DHCP: request again as soon as the Wi-Fi bridge joins
    After the bridge restarts (reboot, power loss, OTA) the pod's DISCOVERs go out while the bridge
    is still joining Wi-Fi and are dropped; lwIP's backoff then waited up to ~16 s more, so the pod
    was off the network for 17-27 s. The bridge client now flags the bridge's Wi-Fi coming up
    (wifi_bridge_take_joined), and the Ethernet DHCP sends DISCOVER right then when it has no lease.
    HW (benchpod-baea06 + bridge, 5 Hz ping): outage after `bridge reboot` 17.0 -> 10.4 s, after a
    2 s power cut 19.0 -> 11.7 s, after a 10 s cut 26.8 -> 19.9 s; the lease now comes 0.6 s after
    the bridge joins, and in the shorter cases the cloud link survives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
2026-10-30 Wi-Fi bridge: no Wi-Fi broadcasts on the Ethernet port until the pod is back
    Found on hardware: on a router, the bridge no longer forwarded the LAN to
    Wi-Fi, but still sent Wi-Fi broadcasts out of its Ethernet port. After a
    link-down nothing goes that way until the pod's next control frame.
2026-10-30 Wi-Fi bridge: Wi-Fi off when no pod is on the cable
    30 s after a link-down without a control frame from a pod, the bridge leaves
    Wi-Fi and turns the radio off: 0.06 A instead of 0.15 A, and no second device
    on the network with the pod's MAC once the pod is wired. Docs: drop the 0.5 W
    budget, add the measured power and supply margin, the brownout verdict.
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2026-10-31 Analog v3r2: switch on the +-14 V supply after a first gateware install
    A blank iCE40 boots without gateware, so boot cannot park the DAC8554 or switch the +-14 V supply on. Installing the gateware blob did not do it either, which left the +-12 V output limited until the next reboot. Tested on a v3-r2 from an erased iCE40: the enable bit was off and the pod drew 165 mA; after installing gw0, with no reboot, the bit was on and it drew 262 mA. Once the supply is on, a later install leaves the outputs alone.
2026-10-31 Record the ADC input's frequency response in the calibration
    Stores the result of adc_comp_sweep.py in two reserved bytes pairs of the calibration record, so the record keeps its size and version. calibrate takes comp_hf_dc_e4 and comp_c_top_ff and every reply reports adc_comp. It is a record only: no reading is scaled with it, and a stored value out of range reads as not measured without touching the rest of the calibration. clear:adc removes it. adc_comp_sweep.py gets --store. Tested on an analog v3-r2: recorded 0.9678 and 9.36 pF, kept over a reboot, DMM calibration intact.
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2026-11-03 firmware: la_capture above 12 MS/s uses the v50 change capture
    With gateware >= v50 a la_capture request above 12 MS/s runs at 48, 24 or 16
    MS/s (48 MHz / k, the nearest; la_change_divisor in la_rate.c, host-tested).
    The pod records the changes at 48 MS/s and the read-back decodes them into
    the same la_edges frames a raw capture sends (index = tick / k, the last
    state within a sample wins), so hosts see no difference. The stream may use
    all the free LA space: the end goes to the gateware through the ADC base for
    the arm and the map is restored right after. A full buffer reports why and
    what to do. Capabilities gain la_max_rate_hz (48 MHz on v50+, else 12).
    Replaces the "mode":"changes" test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
2026-11-03 ice40: promote gateware v50 to ice40/release/
    Hardware-verified with hwe2e TestHW on an analog v3r2 pod: 76 tests,
    71 pass, 5 skip for bench wiring/board. The LA and capture tests also
    pass with the deep-replay image held loaded (16/16).
2026-11-03 gateware v50: fix sticky change overflow, add pre-trigger and END cause
    - A change capture's overflow no longer leaks into later raw, ADC and
    capture_dual captures as CAP_OVF (la_overflow is gated by la_chg).
    tb_top_lachange reproduces it on the previous v50 (STATUS 0x24 on the
    raw capture after an overflowed change capture).
    - Any other arm resets the change encoder and a change arm resets the raw
    producer, and the ring takes strobes only from the active mode, so a
    producer left running can never write into the next capture.
    - END's state field says why the stream ended: 0 the full duration, 1 ring
    full, 2 region end.
    - Pre-trigger for the change capture: SET_TRIGGER flags bit0.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
2026-11-03 firmware: change capture keeps partial data, pre-trigger, capture_dual
    - The change capture's event stream is scanned before the read-back: no
    END, or an END short of the last tick, is an error instead of a silent
    short trace; a stream that stopped early (ring full or memory full)
    returns its samples with "truncated":"busy"/"memory" instead of failing.
    - Pre-trigger: trigger.pre_samples on la_capture (gateware >= v50) records
    the changes at any rate (48 MHz / k, k up to 65535) and returns up to that
    many samples before the trigger, reported as "pre_samples".
    - capture_dual runs its LA as a change capture above 12 MS/s on v50, with
    the ADC region moved to the top of the free space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
2026-11-03 gateware v50: re-pin seeds (loop 57 -> 31, deep 48 -> 31)
    The pre-trigger and overflow fixes re-rolled placement: loop seed 57 fell to
    clk48 47.77 MHz and deep seed 48 sat at 14.64 ns on the clk -> clk48 gate.
    Local sweeps (loop 1..48: 29 good; deep 1..32): loop 31 closes at 54.52 MHz
    (clk -> clk48 11.42 ns), deep 31 at 57.07 MHz (12.80 ns). A strict build
    (PNR_STRICT=1) places both on their pins.
2026-11-03 ice40: promote gateware v50 to ice40/release/
    Hardware-verified with hwe2e TestHW on an analog v3r2 pod: 80 tests,
    73 pass, 5 skip for bench wiring/board. Two of the new LA change tests
    fail on their expectations, not on the gateware: the pre-trigger test
    assumes the free LA line idles low, and the deep raw ring test expects
    3428571 Hz where the pod reports 3428572. The LA and capture tests give
    the same results with the deep-replay image held loaded.
2026-11-03 EMI test build: stream raw Ethernet frames so the wired link carries traffic without a laptop
    Layer 2 only (EtherType 0x88B6, locally administered destination MAC), so it needs a link but no
    IP address, DHCP or peer. Default 10 Mbit/s, `emi net <mbit>|off` on the console; sent and
    dropped counts in the monitor line and the status JSON. Runs on the net task, which owns lwIP.
2026-11-03 wifi-bridge: EMC test build (./build.sh emc)
    A development-only image for the EMC lab, in the style of the pod's EMI_TEST=1 build: from boot
    the radio sends raw 802.11 data frames (esp_wifi_80211_tx) back to back on one channel without
    joining an access point, while Ethernet runs as usual. The pod's frames (its EMI build streams
    0x88B6) go on the air instead of being bridged; a generated pattern fills in when none arrive.
    - Station mode, production country code and PHY power limits; the power cap can only go down.
    - Defaults channel 6, 1 Mbit/s DSSS, maximum power (Kconfig BRIDGE_EMC_*); console `emc`
    changes channel, rate, power, start/stop and shows counters; a report line every 5 s; TP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
2026-11-03 gateware v50: pin loop seed 40, good in both toolchains
    CI's Linux toolchain places loop seed 31 at clk48 44.99 MHz (ice40-sim
    failed with PNR_STRICT). The CI sweep (run 41686775284) and the local sweep
    agree on seed 40: 53.98 MHz in both, clk -> clk48 13.19 / 13.05 ns. Deep seed
    31 closes in both (57.07 local / 55.24 CI) and stays, so the deep image is
    unchanged.
2026-11-03 ice40: promote gateware v50 with loop seed 40
    Only the loop image changed (seed 31 -> 40); the deep image is the same
    bitstream as before. Hardware-verified with hwe2e TestHW on an analog
    v3r2 pod: 80 tests, 75 pass, 5 skip for bench wiring/board, including
    the LA change tests. The LA and capture tests also pass with the
    deep-replay image held loaded (11/11).
2026-11-03 wifi-bridge EMC build: confirm itself after an update
    An EMC image on trial confirms itself once Ethernet has started and its first frame went out,
    so a pod can push newer EMC builds or the normal firmware and the EMC build never rolls back on
    its own. HW round trip on a rev 2 bridge: EMC -> normal -> EMC (self-confirmed after 2 s,
    stays after a reboot) -> normal, all through the pod's dev build.
2026-11-03 Wi-Fi bridge: no "AUTH wrong" after a bridge reboot
    After a bridge reboot the pod's first signed request used the old boot's nonce and was refused
    ("refused request 0x02: AUTH wrong"). The bridge sent HELLO (which carries the nonce) only on its
    2 s timer and only while the link was up, so the first HELLO of a boot came up to 2 s after the
    PHY link; the pod kept the old nonce across the link drop and signed at once. The pod recovered
    by re-signing with the nonce from the refusal, except when the refusal answered its last of
    three sends: then the caller was told "the bridge is paired with another pod: press PAIR".
    - Bridge: HELLO at once when the Ethernet link comes up (bu_hello_due in bridge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
2026-11-03 ice40: dac8551_engine steps sidx/sleft off a registered frame-end flag
    The loop image's failing clk48 seeds on v50 were all bound by one cone:
    ph -> last -> 3 LUTs -> the clock enable of sidx/sleft (22-23 ns against
    20.8), because the FSM decoded rst/stop/start/run_i/st/ph/last/wfr for
    them in one cycle. The frame-end edge (S_SHIFT, ph and last up) always
    follows a cycle in S_SHIFT with !ph and last up, so 'fe' registers that
    decision a cycle early; sidx/sleft now have their own block whose enable
    is rst/stop/start/fe. Cycle-exact: a lockstep run against the old engine
    (2M cycles, random rst/stop/start/wr_req/strm_valid/period/divider/mode)
    showed no difference on any output or on sidx/sle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
2026-11-03 ice40: promote gateware v51 to ice40/release/
    Hardware-verified on benchpod-30a9f1 (analog v3r2) with a dev build of this
    branch (firmware + v51 blobs installed over USB net):
    - hwe2e TestHW, image 0: 75 pass, 5 skip (current-loop fixtures, ADC low
    range, digital board), 0 fail; includes deep replay, image swap and the
    four LAChange tests.
    - image 1 held, LA/capture/deep-replay set: 18 pass, 1 skip
    (DacCotriggerPhaseLock saw a flat cal1 loopback once; 5 of 6 reruns pass).
    - embeddedci-python main: 831 pass, 75 skip, 2 fail (test_raw_la_capture's
    12-bit assertion and the control-loop FpgaImageInfo.get(), both stale
    and failing on 3.9.5/gw49 too).
    Images are bit-identical to a clean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
2026-11-04 EMI build: the status LED blinks blue, not yellow (#99)
    The pod's RGB LED (S4-3528RGBTA-A) has its three dies side by side under a clear lens, so a
    mix shows as separate colours: the EMI build's yellow looked green with a red edge, and white
    looked light blue. Raising the red channel's current in the gateware (tried up to 6x) balanced
    the mix only in the middle of the package. One die is unambiguous: solid blue before the loop
    starts, blue blinking (1 s on, 1 s off) while it runs, blue and red in turn after a failure.
    Plain "busy" is solid blue; the 1 s blink is not.
    Checked on benchpod-30a9f1 (analog v3r2) with the EMI build on gateware v51.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
2026-11-04 EMI build: green/red/blue status LED, Ethernet failures included (#100)
    * EMI build: an Ethernet problem turns the status LED blue and red
    The EMC lab watches only the status LED. A lost Ethernet link (or no
    link 10 s after the start, to allow for autonegotiation) or a frame the
    pod could not send now shows the same blue-and-red pattern as a failed
    capture, for 30 s, so a LAN port that fails during an immunity test is
    seen. The emi line and emi_test JSON report the link state and the
    number of link losses.
    * EMI build: green/red/blue status LED a test lab can read at a glance
    Green blinking: running, no failure since power-on. Red,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
2026-11-05 stm32: deliberate resets do not count toward safe mode
    reboot, dfu, psram_recover and an OTA commit all reset the chip by software, and a boot
    counted as failed until it had run 15 s. Two quick deliberate reboots in a row therefore put
    the third boot in safe mode with networking and the iCE40 off, which only the reset button or
    a power cycle ended. boot_guard_planned_reset() gives the boot's count back right before such
    a reset; a crash before it still counts, and safe mode still keeps counting.
2026-11-05 stm32: Ethernet transmit is zero-copy and non-blocking
    low_level_output used the blocking HAL_ETH_Transmit: the net task spun for every frame's wire
    time (1.2 ms for a full frame at 10 Mbit), and after its 20 ms timeout the HAL handed the
    descriptor back while the DMA could still be reading a pbuf that lwIP then freed.
    Frames now go out with HAL_ETH_Transmit_IT holding a pbuf reference, released from
    HAL_ETH_ReleaseTxPacket on the next output or input poll. When all four descriptors are
    queued it waits up to 3 ms for one, then drops the frame (counted as txfull in eth stats).
    HAL_ETH_Start does not reset the TX ring, so every stop in the driver now goes through
    eth_stop(), which frees the f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
2026-11-05 stm32: cloud replies are errors only when they start as one
    cloud_client_send_command_response looked for "status":"error" anywhere in the reply, so an
    ok reply whose data carried that text (a DUT's own JSON line read back by uart_read or
    can_read) reached the cloud as a failure with an empty message. Every error reply starts with
    {"status":"error", so compare the start.
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2026-11-05 stm32: drop hw_lock, which nothing contends any more
    Since the hw worker rewrite every iCE40, I2C, XSPI and target-power access runs on the worker
    task, so the recursive mutex was only ever taken by its one user. Its comments still said the
    console and net tasks raced on SPI1 and I2C, which is no longer true and misled reviews.
    Removed the lock and its stubs; the comments now name the worker as the bus owner.
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2026-11-05 ice40: START_DAC_PSRAM over a running replay restarts the reader
    dac_psram_reader loads its base/length and flushes its FIFO only while
    not running, so a START_DAC_PSRAM sent while a replay was running kept
    streaming the old waveform from where it was (the firmware always stops
    first, so this never showed). The reader's run now drops on the cycle
    of every raw DAC start, which is the STOP_DAC + START_DAC_PSRAM sequence
    in one command; a co-trigger still prefills at stage time.
    tb_top_deep case 4 restarts a running 50-sample replay onto 20 samples:
    the stream must restart at sample 0 and wrap at 20 (fails on v51).
2026-11-05 ice40: PSRAM pads idle from configuration on
    iCE40 flops and SB_IO output registers configure as 0. The capture
    writer's rst48 synchroniser and CS flop had no power-up value, so it ran
    out of reset with CS = 0 for the 2-3 clk48 before the reset reached it;
    in the deep image the replay reader's CS at 0 also made the pad mux pick
    the reader. Either way PSRAM CS was driven low after configuration
    (no SCLK, so the chip ignored it, but it is not the idle bus the STM32
    expects).
    Power-up values on the writer's and reader's pad flops (CS high, OE and
    SCLK low, rst48 asserted) and on the self-test request, and psram_pads
    keeps every output enable off until the first clk48 edge has loaded the
    pads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
2026-11-05 ice40: UART RX drops frames with a low stop bit, reports it
    The receiver pushed every frame whatever its stop bit read, and a line
    held low restarted a frame at once, so a break or the wrong baud filled
    the RX FIFO with 0x00. A low stop bit now drops the byte, sets a sticky
    framing-error flag and waits for the line to rise before it looks for a
    start bit: a held-low line is one error.
    UART_STATUS flags bit7 (was 0) reports it; the status read clears it
    with rx_overflow. The firmware header gets the bit; nothing reads it
    yet. tb_uart_engine: a 30-bit break stores nothing, sets and clears the
    flag, and the next byte is received.
2026-11-05 ice40 + stm32: SPI link to the iCE40 at 3.9 MHz (twice /128)
    spi_slave oversamples SCK on the 24 MHz clk. It took MOSI 2-3 clk after
    it saw SCK rise and moved MISO 3-4 clk after it saw the fall, so the
    STM32 (sampling MISO on the rise) needed a ~170 ns half period: /128
    (1.95 MHz) was clean on hardware and /64 failed most PINGs.
    v52: MOSI passes the same two flops as SCK (sampled as it was at the
    rise), MISO moves right after the detected rise (a whole period to the
    next sample, not half), and between bytes MISO is the reply register's
    MSB directly, so a reply has until the next byte's first rise.
    tb_top_spilink (new, both images) models the STM32: pad delays, MISO
    setup, a drifting phase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
2026-11-05 gateware v52: version bump, docs for the review fixes and the untimed crossings
    GATEWARE_VERSION 52 with its version-log entry (the ADC t0 restart, the
    deep reader restart, PSRAM pads at power-up, UART framing, the faster
    SPI link). PROTOCOL: CAPTURE's sample alignment and START_DAC_PSRAM
    over a running replay. README: sample alignment, the SPI link, and a
    section on the clk <-> clk48 paths nextpnr cannot time (synchronised vs
    phase-locked, what the MAX_X48_NS / MAX_X24_NS gates cover, and why a
    PLL does not help). Seeds are re-pinned next.
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2026-11-05 stm32: Ethernet comes back after a stop under load
    Found while testing the zero-copy transmit change, and present in 3.9.6 too: an `eth restart`
    in the middle of a capture read-back left Ethernet dead until a reboot. The link came up and
    the MAC kept counting unicast frames, but the driver received none, so DHCP never got a lease.
    The DHCP self-heal and a link drop during a transfer take the same path.
    HAL_ETH_Stop + HAL_ETH_Start do not bring the DMA back cleanly: the DMA keeps its own position
    in both descriptor rings, and HAL_ETH_Start re-arms all four RX descriptors from the HAL's
    rebuild index. With unread frames in the ring at the stop, the driver's read position ends up
    behind the DM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
2026-11-05 gateware v52: promote the hardware-verified images
    hwe2e on benchpod-30a9f1 (analog v3r2) with the dev firmware (SPI1 at
    /64): TestHW 74 pass / 6 skip / 0 fail including the deep-image group;
    SDK + MCP + OpenHTF e2e 135 pass / 65 skip / 0 fail; process-node HIL
    79/80 (one LAN TLS handshake reset, 33/33 on rerun); spi-diag 3000/3000
    at /64. Seeds loop 35, deep 41.
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2026-11-05 stm32h563: build with -O2 instead of -Og
    -Og was the build level for every release. With the ICACHE on, -O2 makes
    AES-GCM 1.75x and SHA-256 1.2x faster and cuts a 1M-sample LAN ADC
    read-back from 3.8 s to 2.3 s, for about 8 KB more flash (75% of the
    896 KB code budget). The RAM-resident OTA commit code still branches
    only within RAM (checked in the disassembly). New -O2 warnings are
    bounded snprintf/strncpy truncation notes, not bugs.
2026-11-05 stm32h563: fix the truncation warnings -O2 reports
    CI fails a build on any compiler warning, and -O2 analyses more than -Og:
    - cloud_client, command_handler_net: snprintf instead of strncpy (same
    truncation, always terminated)
    - dac_limits: s_msg 240 -> 320 bytes and the command name cut to 32, so the
    longest refusal fits
    - ota: busy_msg's holder buffer 24 -> 32 bytes for "LAN connection <int>"
    Dev and RELEASE=1 builds: 0 warnings; host tests pass.
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2026-11-06 stm32h563: EMI run log record format and ring (host-tested)
    64-byte records with a CRC-32 in a ring over the W25Q's free range
    0x192000-0x200000 (7,040 records): scan for the newest record at boot,
    erase ahead, skip spoiled slots. Not wired in yet.
2026-11-06 stm32h563: EMI build keeps a run log in the W25Q and sends BPMON status frames
    EMI test build only (EMI_TEST=1):
    - the run log (emi_log.h) is scanned and its sectors erased at boot,
    before the activity; RUN_START, EVENT (LED, link, start/stop) and
    CHECKPOINT (5 min) records are queued and written between captures,
    then the DAC mode is started again; the gap is measured
    - console 'emi log [n|all]' and JSON 'emi_log' (offset/count raw slots)
    - every 5 s a broadcast 'BPMON ...' frame on EtherType 0x88B6 with the
    monitor line, run number and reset cause, from boot on
    - the log's state and the monitor buffers live on the heap: the RAM
    has no room for them
    - make EMI_LOG_SECTORS=<n> shri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
2026-11-06 stm32h563/tools/emi: emi_watch.py (BPMON/BPEMI over Ethernet) and emi_log_dump.py
    emi_watch.py reads tcpdump's pcap (live or a file), prints the BPMON
    lines and flags lost frames, a stopped stream, silence, reboots and the
    LED leaving green; it writes a log file. emi_log_dump.py downloads the
    run log with emi_log (retrying busy) and prints it with a per-run
    summary. Host tests run with make -C stm32h563/test.
2026-11-06 docs: emi_log, emi log and the BPMON status frames of the EMI test build
2026-11-06 stm32h563: EMI run log: restart the sine from its BRAM table, fit replies in the LAN ring
    - after a W25Q session only the sine needs START_DAC again: the quad
    DAC holds DC and 12 mA, the table stays in the waveform BRAM
    (dac_restart_generated, EMI build only). DAC gap 25 ms -> 435 us
    measured on benchpod-30a9f1 (W25Q session 361 us)
    - status in the EMI build was 2115 bytes, more than a connection's
    2 KB TX ring takes whole, so the pod closed LAN status connections
    (flash-self never saw the pod come back): status gets a short
    emi_test, the whole object moves to emi_log; a too-large status now
    answers an error instead of closing
    - emi_log reads at most 16 records (12 on the cloud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
2026-11-06 stm32h563: emi log fill <n> in small-ring test builds (EMI_LOG_SECTORS)
    HW-verified on benchpod-30a9f1 with EMI_LOG_SECTORS=3: 400 records,
    4 erases between captures, contiguous sequence after the wrap, the
    next boot continues after the newest record.
2026-11-06 stm32h563: EMI run log: keep the DAC playing through W25Q sessions
    The BRAM-table sine and the quad DAC's held channels never master the
    shared PSRAM bus; only a deep replay does. The run log now opens its W25Q
    session with signal_engine_quiesce_psram_keep_dac (EMI build only): it
    waits for no capture busy and the writer drained, and stops the DAC only
    for a resident deep replay. log_session_close restarts the DAC only when
    that fallback stopped it or the sine's DAC_RUN bit is found clear, so the
    glitch reads 0 in the normal path. The W25Q session time is reported
    beside it (session_us_last/max, dac_stops in emi_log).
    w25q_session_open is unchanged for OTA, the CA and the C3 flash.
    Co-Auth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
2026-11-06 stm32h563: EMI run log: erase 16 sectors at boot; docs: no DAC gap from log writes
    EMI_LOG_BOOT_RESERVE goes from 4 to 16 sectors (1,024 records, about 80 h
    of checkpoints), erased by log_boot before the 10 s start delay ends, so a
    lab run never erases mid-run in practice. A run that uses the reserve up
    still erases the next sector between captures, now without touching the
    DAC. History: about 6,000 records.
    API.md emi_log, usb-serial-interface.md emi row and emi_log.h: the outputs
    are not interrupted by log writes (only a deep replay would be), the
    session_us/dac_stops fields, the new capacity. emi_log_dump.py prints the
    session and gap figures.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
2026-11-07 stm32h563: EMI run log: checkpoint every 10 s instead of 5 minutes
    A lab day fits: 360 records an hour, about 16 hours of history.
2026-11-07 stm32h563: EMI run log: change-driven checkpoints, emi_log "after" a sequence number
    A checkpoint when a value that shows trouble changed (at most every 10 s), else a heartbeat
    every minute, so a lab day writes into the flash erased at boot. emi_log {after: N} reads from the
    first record newer than N, for a viewer that keeps a copy; the reply carries the pod's uptime.
2026-11-07 stm32h563: EMI build serves a lab page on port 80
    GET / is a page (tools/emi/lab_page.html, built in) that shows the activity live and keeps a copy
    of the run log in the browser, fetching only the records it does not have (emi_log after), also
    after the network or the pod was down; CSV and JSON download, times from the laptop's clock.
    GET /api/status and /api/log?after=N are the only API paths, both read-only. HTTP/1.0, one request
    per connection on a LAN slot; the API runs as that slot's emi_log command.
2026-11-07 stm32h563: EMI run log: RUN_START names the DAC mode the run plays
    The boot start picks the default (all on a quad-DAC board) after RUN_START was written, so the
    record said sine. HW-checked on benchpod-30a9f1: START ... dac all.
2026-11-07 stm32h563: recover from a stuck iCE40 or bus by itself, never by rewriting its flash
    - ice40_reload: reset the iCE40 and let it read its config flash again, no erase, no write.
    - Boot self-test: after a soft reset mid-capture the first test fails; it now reloads the iCE40
    first and rewrites its flash only when the image there no longer matches a gateware slot (it
    used to rewrite it on every such boot).
    - recovery.h: the ladder's decisions, host-tested: captures failing 10 s -> iCE40 reload, again
    30 s later, then an STM32 reset; Ethernet link down 20 s -> PHY reset. Limits: 6 reloads an
    hour, 2 resets until 10 min healthy or a power-off (count in .noinit), 10 PHY resets an hour.
    - EM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
2026-11-07 stm32h563: fixes from the recovery HW test
    - Uptime after a soft reset: the DWT cycle counter behind HAL_GetTick survives a system reset,
    so the uptime started up to about a minute off (what looked like a slow EMI loop start after a
    reset); zero it once at the first HAL_InitTick, and pico_compat_init no longer zeroes it again.
    - An iCE40 not configured at boot is reloaded from its flash before anything writes it (the
    gateware update wrote image 0 straight away; after an ESD hit or a recovery reset the image is
    usually fine).
    - status: 'ice40boot' says what the boot self-test did (passed, reloaded, rewrote).
    - The recovery reset's text counts right ('1 of 2').
    - test-ice40-hold yes (d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
2026-11-07 gateware v52: pin SEED_DEEP 41 -> 5, good in both toolchains
    CI's toolchain placed seed 41 with clk -> clk48 at 18.40 ns, over MAX_X48_NS, so the
    ice40-sim job failed. Seed 5 passes the strict gate in both (CI sweep run 42391635281).
2026-11-07 stm32h563: STM32Cube parts as submodules, mbedTLS 3.6.6
    The HAL, CMSIS device + core, LAN8742 driver and mbedTLS came from a separate
    STM32CubeH5 v1.6.0 checkout (CUBE=), which Dependabot never saw. They are now
    submodules under stm32h563/lib/stm32cube/, pinned at the commits Cube v1.6.0
    uses (CMSIS core Include/ byte-identical), except mbedTLS: 3.6.4 -> 3.6.6
    (ST's v3.6.6_20260511, the one Cube v1.7.0 pins), for the security fixes in
    3.6.5 and 3.6.6.
    CI no longer clones Cube. docs/DEPENDENCIES.md lists every dependency, where
    it is pinned and which ones Dependabot cannot see; dependabot.yml also checks
    the calibration scripts' Python requirements.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
2026-11-07 LAN TLS: three sessions, refused only when the new one would eat the cloud's room
    The SDK opens a connection per command and keeps one for a UART session or a
    capture, so a UART console, a capture and one command need three TLS sessions.
    The pod allowed two: the third got a reset during its handshake (process-node
    test_alarm_follows_its_reading failed every time over LAN TLS, on 3.9.6 too).
    Measured on benchpod-30a9f1: a session holds 22,000 B of heap (155 KB free
    idle, 89 KB with three). The heap check now asks for the floor plus 24 KB for
    the new session, so a session can never take the cloud link's room.
2026-11-07 Boot: reload the iCE40 after any reset but a power-on, before the PSRAM self-test
    Only a power-on resets the iCE40 with the STM32. After a reboot, an OTA, a
    watchdog or the reset pin it keeps the registers of the last session (a
    capture_dual's packed capture base, the deep-DAC reservation, the control
    loop) while the firmware starts from power-on copies of them, so the first
    capture wrote where the firmware did not look: the boot self-test failed
    (2/2 after a capture_dual, 2/2 mid-capture on benchpod-30a9f1) and #107's
    recovery reloaded the iCE40. Reload it first instead: both sides start from
    power-on values, 8/8 soft resets now pass the self-test the first time. A DAC
    left playing also sto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
2026-11-07 EMI build: recover within the lab's 60 s, show hung captures and eFuse trips, no safe mode
    From a review of the EMC test plan against the EMI build:
    - The ladder reset came at t0+70 s plus a 10 s start delay, so criterion B (running
    again within 60 s) could not be met when a reset was needed. Reloads now at
    t0+10 and +20 s, the reset at +30 s, and the loop starts 2 s into the boot that
    follows a recovery reset. A host test pins the reset to 30 s.
    - A capture that never ended started the ladder after 30 s but left the LED green.
    It now counts as failing after 10 s (red, then blue), like any failed capture.
    - Ethernet up while frames keep failing to go out had no recovery step: it now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
2026-11-07 Workaround cleanups: right recovery advice, count PSRAM read-back retries
    - An iCE40 that does not answer (STATUS bit 7) told the user a reboot would not
    fix it. Every boot reloads the iCE40 now, so the message says to reboot, then
    flash-ice40. The image-switch error no longer says psram_recover reflashes.
    - psram_read_settled settles 1 ms and retries every capture read-back for a
    hand-off race that was never measured. It now counts reads that needed a retry
    or failed, logs the first few, and the console status shows them (psram rd), so
    the settle can be dropped once the counts stay at zero.
2026-11-07 Dependencies for 3.10.0: STM32CubeH5 v1.7.0 HAL + CMSIS device, TinyUSB, calibration requirements
    Brings the open Dependabot updates into one change (#111 #112 #113 #114 #115):
    - HAL 2e49bfe -> 56e28db and CMSIS device 4a9d636 -> 884b8dc: the commits
    STM32CubeH5 v1.7.0 pins (with mbedTLS 3.6.6, already in). CMSIS core and the
    LAN8742 driver are the same in v1.7.0. For the H563 the HAL adds flash lock
    functions and RCC/UART/RNG additions; the Ethernet init/start/transmit paths
    are unchanged (fixes are for PTP and L3 filters, unused).
    - TinyUSB e477e9f -> 91cdc7b.
    - calibration scripts: flask >= 3.1.3, pyusb >= 1.3.1.
2026-11-07 capture_dual: never overflow by default; a clear reply when a capture does overflow
    - The raw LA gets the same rate plan as la_capture (la_psram_plan): no rate means
    the fastest, and a capture deeper than the 96 KB burst buffer is slowed until it
    fits (3 MS/s at 1M samples). Before, an omitted rate ran at 12 MS/s while the
    bandwidth check saw 0, and a deep capture overflowed ('capture failed').
    - With ADC samples in the same capture the raw LA runs at most 8 MS/s: 12 MS/s
    overflowed at every depth and ADC rate on benchpod-30a9f1, 8 MS/s never did.
    - The bandwidth check counts the LA at its sustained rate (at most the burst
    buffer's drain), so short full-rate bursts are not refused.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
2026-11-07 Ethernet: reset the PHY for a missing DHCP lease only when nothing arrives
    After 3 re-kicks (about a minute) without a lease the firmware reset the PHY, and
    again every minute after that, on the theory that the MAC/PHY was stuck. The
    common reason for no lease is no DHCP server (a laptop on the cable, as the EMC
    lab uses for BPMON): the link then dropped every minute for nothing. The stuck
    case it was written for was most likely the RX descriptor desync #101 fixed.
    Now frames still arriving (rx_frames moved since the last re-kick) mean the link
    works and reset the count; only a link that receives nothing is reset, and at most
    once every 5 minutes.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
2026-11-07 Capture rates: refuse an explicit rate that does not fit instead of slowing it down
    An explicit raw-LA rate (la_capture sample_rate_mhz, capture_dual la_rate_mhz)
    that the capture cannot run at is refused before anything is armed, with both
    ways out in the message: 'LA at 12.0 MS/s does not fit 1000000 samples: at most
    65536 samples at 12.0 MS/s, or at most 3.0 MS/s for 1000000 samples (or leave the
    rate out for the fastest that fits)'. With ADC samples in a capture_dual the raw
    LA runs at most 8 MS/s and a higher raw rate is refused, naming the rate that
    fits the depth. No rate still runs at the fastest that fits, and is reported.
    Before, la_capture slowed an explicit rate down silently (la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
2026-11-07 Capture rates: the 8 MS/s LA ceiling with the ADC applies to gateware before v53 only
    Gateware v53 fixes the PSRAM writer starving the ADC FIFO (the cause of the
    12 MS/s + ADC overflow), so la_raw_ceiling() is 12 MS/s there, with or without
    the ADC; older gateware keeps 8 MS/s. The refusal names the ceiling of the
    gateware it runs on. Host tests for both.
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2026-11-08 ESP32-C3 restart counters by cause, kept through soft resets
    The pod restarts its ESP32-C3 from reset whenever the Wi-Fi link to it fails, but
    only two of the causes were counted, per boot, in wifi_status. To see how often
    this happens in the field (and after ESD hits), every restart is now counted by
    cause in c3_restarts.c: no_response, rebooted, no_boot, setup, assoc, flash, with
    the last reason and when. The record lives in .noinit with a check, so software
    and watchdog resets and OTA keep it; a power-on or the reset pin clears it.
    - wifi_status: c3_restarts object (every cause, last reason, boots covered).
    - status: c3_restarts total (boards with the C3 only).
    - Console: wifi-show lists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
2026-11-08 EMI LED: red only for a fail, blue (fast) while the pod is recovering
    The LED went red for 5 s on any failure, also one the pod recovered from, so a lab
    watching the camera could write down a fail for what is a pass under criterion B.
    Now the color is the verdict:
    - green: no failure since power-on (passes every test)
    - blue, fast blink: a function fails now, the pod is getting itself running again
    - blue, 1 s blink: runs again after a failure or restart (passes B, fails A)
    - red, fast blink: failing 60 s without a break, or the recovery is out of steps
    Red is not latched: a pod that comes back after a long burst test turns blue (the lab
    reads the LED 60 s after each test). In the EMI buil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
2026-11-08 eFuse FLT: count a trip only when FLT holds 30 ms; EMI: output off at the retry limit
    Measured on benchpod-bf3d6a (digital v3r2, Wi-Fi bridge on its Ethernet port): in the
    EMI build FLT on eFuse 1 read asserted for single 10 ms samples while its output stayed
    at 5.1 V with no load. Every glitch counted as a trip: power retries, then at the retry
    limit the line "retry limit" hundreds of times a minute (one per glitch) with the output
    left on. With the 20 Mbit/s Ethernet stream off: 0 trips in 120 s; on: 5 in 100 s even
    with the debounce, so the stream through the bridge (which takes its power from the pod)
    couples onto the FLT line. Hardware follow-up: scope FLT and the 5 V rail.
    - target_po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
2026-11-08 eFuse FLT: reverse-current blocking is no fault (TPS259470A, checked with the output monitor)
    Root cause of the false eFuse 1 trips on benchpod-bf3d6a: the TPS259470A pulls FLT low
    while it blocks reverse current (datasheet SLVSFC9C, 7.3.7 and Table 7-3): it turns its
    blocking FET off when VOUT - VIN > 29 mV and only back on when VIN - VOUT > 104 mV. eFuse 1
    takes its input from +5V_IN, which also feeds the Wi-Fi bridge through R138, +5V and the
    SY6280 on USB-A; the bridge's transmit bursts (the EMI build's 20 Mbit/s stream) dip
    +5V_IN by 50-70 mV, the unloaded output stays up, and FLT stays low until it has leaked
    down 104 mV: long enough to pass the 30 ms debounce. Not a fault, but the nor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
2026-11-08 EMI run log: health events for what the pod counts but the LED does not show
    A 10 min console audit on benchpod-bf3d6a (EMI build, Wi-Fi bridge uplink) found events
    the run log never had: 8 cloud drops ("idle timeout (no pong)", "challenge connect
    timeout", "link dropped": the 20 Mbit/s stream saturates the bridge's Wi-Fi, 500k of
    1.3M bridge transmits failed), and eFuse reverse blocking. Captures, Ethernet (crc 0,
    missed 0), USB and the run log itself were clean.
    New EMI_EV_HEALTH (kind 8), checked once a second, one event per item at most every 10 s
    (reverse blocking every 60 s) with the count since the last: cloud drop with its reason
    (new cloud_client_drops), I2C bus clear, PSRAM read r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
2026-11-08 EMI run log: a cloud drop that reconnects is no event; SUMMARY record every 10 min
    - The cloud link is not under test and never changes the LED. A drop that reconnects is only
    counted. Set up but down for 2 min: one health event ("cloud down 2 min: <why>"), and one when
    it returns ("cloud back after N min"), since the shared lab view stops meanwhile.
    - New record type 4 (SUM), every 10 min while the loop runs, also on a clean run: cloud drops and
    seconds down this run, C3 restarts, I2C clears, CAN bus-off, PSRAM retries and fails, iCE40
    configuration losses, eFuse reverse blocks, Ethernet CRC/alignment errors and missed frames,
    the Wi-Fi bridge's failed transmits. So after a failur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
2026-11-08 EMI stream to an IEEE link-local address; the Wi-Fi bridge never forwards that range
    The EMI build's 20 Mbit/s stream went to 02:42:50:45:4D:49, an address nobody owns, so every switch
    flooded it out of every port: on a lab's network, every device would get it. Now it goes to
    01-80-C2-00-00-0F (IEEE 802.1 link-local, unassigned), which a switch never forwards: it still loads
    the pod's cable, as CISPR 32 asks, and stops at the first switch. BPMON stays broadcast (5 s, small).
    emi_watch.py and the console docs say a laptop behind a switch only sees BPMON.
    The Wi-Fi bridge forwarded everything from the pod, including that range (on benchpod-bf3d6a: 413k
    stream frames in 4 min, all sent to Wi-F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
2026-11-08 eFuse FLT: a held FLT counts as a trip only when the output shows a fault (TPS259470A reverse blocking)
    The TPS259470A pulls FLT low for real faults and also while it blocks reverse current
    (datasheet SLVSFC9C, 7.3.7 and Table 7-3): it turns its blocking FET off when VOUT - VIN > 29 mV
    and back on only when VIN - VOUT > 104 mV. eFuse 1 takes its input from +5V_IN, which dips by tens
    of mV when the pod draws a burst (a Wi-Fi bridge on USB-A transmitting, heavy captures, a weak USB
    source); with a light load the output stays up, so FLT goes low for ms to tens of ms. The firmware
    sampled FLT every 10 ms with no filter and reported every such pulse as a trip: an efuse.event that
    leaves the web a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
2026-11-08 Wi-Fi bridge in the EMC lab: reset reason and radio state in STATUS, radio recovery, pod watches it
    The lab tests configuration 2 with the Wi-Fi bridge's EMC test build (no board with the ESP32-C3),
    so the bridge is part of the equipment under test and its failures must show like the pod's own.
    Bridge (wifi-bridge):
    - STATUS carries BWP_T_RESET (why it last booted: power-on, pin, software, panic, watchdog,
    brownout) and, in the EMC build, BWP_T_EMC (transmitting pod frames / pattern, stopped, not
    transmitting). Optional TLVs: older pods ignore them.
    - EMC build recovers by itself: a radio that sent nothing for 10 s is restarted; after 3 restarts
    in a row without a frame out, the bridg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
2026-11-08 Firmware 3.10.1, Wi-Fi bridge 0.1.2
    Patch release: #130 (eFuse FLT reverse blocking is no trip), #131 (ICACHE invalidated after
    flash erase/program: settings saves no longer fail their read-back), #129 (C3 restart counters,
    EMI build LED verdict and health log, bridge reset reason / EMC radio state, bridge never forwards
    IEEE link-local frames). The bridge moves to 0.1.2 so pods update their bridges to the
    link-local drop.
2026-11-09 stm32h563: keep the ADC/DAC calibration in the analog module's EEPROM (#133)
    The calibration (J8 zero, DMM DAC lines, ADC gains, frequency response)
    belongs to the analog front end, but on digital v3r3 it lived only in the
    digital board's flash, so a module moved to another board lost it.
    - module_eeprom: the calibration blob format ("ACAL", record version and
    length, then the adc_cal record), host-tested.
    - module_link: module_cal_save drops the header's calibration fields
    first, writes the blob, records it and checks the CRC read back;
    module_cal_load reads and checks it.
    - adc_cal: a mirror hook. Every save (and clear) also goes to the module;
    a failed module write keeps the pod'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
2026-11-12 stm32h563: floor the DAC divider at 4 for the DAC8554 frame gap (t9) (#134)
    The DAC8554 (analog v3r2 and later) needs >= 130 ns from the 24th SCLK
    falling edge to the next SYNC falling edge (SLAS431B t9). The gateware
    floors the divider at 3, which gives 6 clk48 = 125 ns: enough for the
    DAC8551's 100 ns, 5 ns short for the DAC8554 at the fastest update rate.
    The firmware now sends a divider of at least 4 (7 clk48 = 146 ns) on every
    board and every gateware version, so no new bitstream is needed. The peak
    update rate drops ~2%: 889 -> 873 kS/s from RAM, 873 -> 857 kS/s from PSRAM.
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2026-11-13 release: publish and sign blob-gw2.bin (the sensor emulation image); firmware 3.10.3 (#138)
    3.10.2 listed gw2 in blobs-manifest.json but the release job copied, signed and uploaded only
    gw0, gw1, esp and bridge. A new step fails the release when the manifest names a blob that is
    not there. The build workflow verifies gw2's throwaway signature too.
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2026-11-13 Bus master: I2C master, SPI modes 1/2, pin direction safety, send and capture (gw v55) (#141)
    * ice40: I2C master and SPI modes 1/2 in swd_engine (phase 0 prototype)
    The engine's third job: an open-drain I2C master on the clk/dio slots
    (SCL read back on the CS channel for clock stretching), tokens START,
    STOP, WRITE, READ+ACK, READ+NACK on the existing queue and reply buffer.
    Lost arbitration stops the queue and sets q_flags bit 7. SPI modes 1 and
    2 are modes 0/3 with SCK inverted (SPI_ARM flags bit 1). Half period
    widened to 7 bits for 100 kHz I2C. la_bank: the clk slot's OE comes from
    the engine.
    tb_i2c_master (make i2cmastertest): write, write-read with repeated
    START, NACK, ~1 MHz/~400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
2026-11-14 status fits the cloud channel: a short form, host-tested worst case (firmware 3.10.5) (#143)
    Firmware 3.10.4's status reply reached 1838 bytes with the USB network adapter up and a lease
    held, more than the cloud command channel takes (1791), so connecting over the cloud failed.
    status now has two forms (src/command_handler_status.c, moved out of command_handler_device.c).
    The cloud command channel gets the short form ("short_form":true): it leaves out lan_tls (its own
    command), lease (the server owns it), module, the ADC fit, the fixed feature flags the
    capabilities frame carries, and the diagnostics (stacks, lwIP, malloc failures, console drops,
    strap mV), and cuts last_crash and safe_rea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
